deestroy/snn_parkour_fgpa/experiments/figures/fig_crossover_heatmap.png

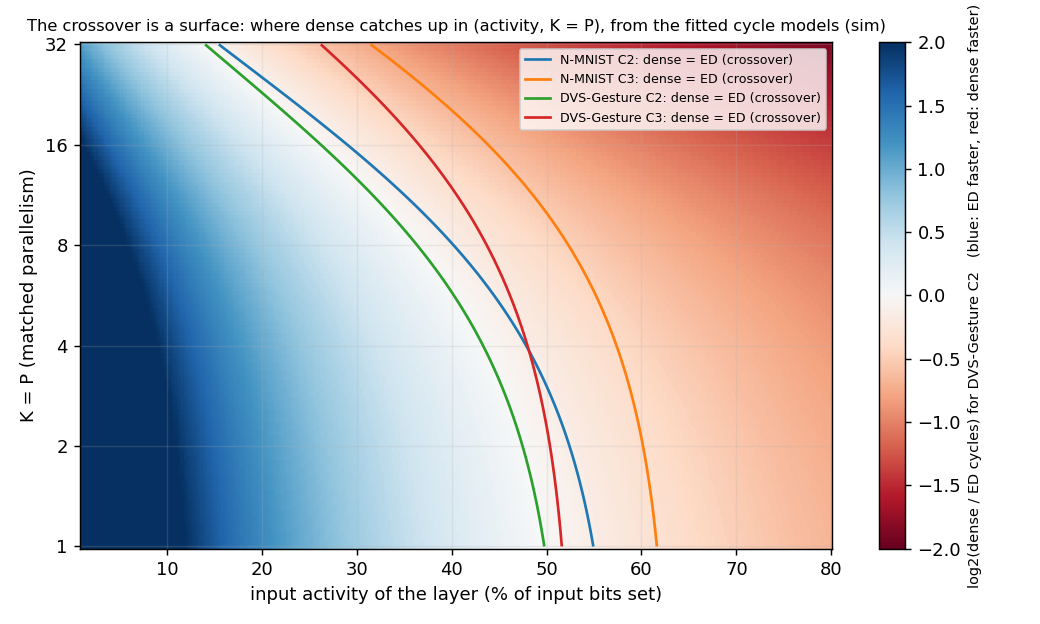
experiments/figures/fig_crossover_heatmap.png
