deestroy/snn_parkour_fgpa/docs/thesis_tables/deadline.md

# Deadline reading: per-sample latency distributions against perception periods

Generated by make_tables.py from the per-sample cycle/board files. 'Max sustainable rate' is the perception rate at which the WORST sample still meets its period (1 / worst latency). The board rows are what host/board/conv_server.c calls engine-only ticks: the ARM global timer bracketing one_pass, i.e. cache flush, both DMA transfers, the busy-poll and the cache invalidate. It excludes UART framing and CRC only, NOT the DMA -- see the +8.3 / +10.9 / +20.0 / +29.4 us decomposition in docs/decisions.md; miss rate at a given rate is the fraction of samples whose latency exceeds that period. The robot's control period is 100 ms (10 Hz), so the budget fraction column is worst latency / 100 ms. Both engines meet every period up to 200 Hz on every set; the difference between them appears only above that, and in the spread.

| sample set | engine | mean (us) | worst (us) | spread max/min | worst as % of 100 ms budget | max sustainable rate | miss rate % at 10 / 20 / 50 / 100 / 200 Hz |
|---|---|---|---|---|---|---|---|
| robot event frames (64, sim) | ED | 1725 | 2748 | 2.01x | 2.7 % | 364 Hz | 0 / 0 / 0 / 0 / 0 |
| robot event frames (64, sim) | dense | 3604 | 3604 | 1.00x | 3.6 % | 277 Hz | 0 / 0 / 0 / 0 / 0 |
| N-MNIST C1 (16 samples, board, K = P = 4) | ED | 688 | 816 | 1.47x | 0.8 % | 1226 Hz | 0 / 0 / 0 / 0 / 0 |
| N-MNIST C1 (16 samples, board, K = P = 4) | dense | 1049 | 1049 | 1.00x | 1.0 % | 953 Hz | 0 / 0 / 0 / 0 / 0 |
| N-MNIST C1 (16 samples, board, K = P = 8) | ED | 576 | 653 | 1.32x | 0.7 % | 1531 Hz | 0 / 0 / 0 / 0 / 0 |
| N-MNIST C1 (16 samples, board, K = P = 8) | dense | 540 | 540 | 1.00x | 0.5 % | 1851 Hz | 0 / 0 / 0 / 0 / 0 |
| DVS-Gesture C1 (8 clips, board, K = P = 4) | ED | 2971 | 4664 | 2.24x | 4.7 % | 214 Hz | 0 / 0 / 0 / 0 / 0 |
| DVS-Gesture C1 (8 clips, board, K = P = 4) | dense | 3706 | 3706 | 1.00x | 3.7 % | 270 Hz | 0 / 0 / 0 / 0 / 0 |
