deestroy/snn_parkour_fgpa/docs/thesis_tables/crossover.md

# Crossover table: every axis, layer and dataset

Generated by make_tables.py (the parallelism rows are recomputed from the cycle files at every run -- C0049: the N-MNIST value was quoted as ~6.6 from an arithmetic slip until 2026-09-20) from experiments/latency_sim, experiments/dvsgesture/latency_sim and the rate-sweep bench files. 'Basis' says whether the number is a simulation fit or a silicon observation; the silicon column states what the board showed at the bracketing points. The operating point is the unregularised (baseline) network's input activity on the check set.

| axis | layer | dataset | at | crossover | basis | operating point / silicon | fit |
|---|---|---|---|---|---|---|---|
| parallelism (K = P) | C1 | N-MNIST | -- | K = P = 7.4 | sim (cycle-model fits: ED over K = 1..16, dense over the P points in the files) | silicon: ED wins at 4, dense at 8 (N-MNIST) | ED = 45172 + 90347/K; dense = 406912/P + 2331 |
| parallelism (K = P) | C1 | DVS-Gesture | -- | K = P = 5.8 | sim (cycle-model fits: ED over K = 1..16, dense over the P points in the files) | silicon: ED wins 6/8 clips at K = P = 4 | ED = 165259 + 490120/K; dense = 1441792/P + -4 |
| activity (per sample) | C1 | DVS-Gesture | K = P = 4 | < ~10,000 input spikes per inference (~30.5 % density) | sim, pre-registered | silicon: ED wins 6/8 clips, loses clips 1 and 5 (36 %, 44 %) | clip densities 9-44 % |
| activity (trained) | C2 | N-MNIST | K = P = 4 | 48 % input activity | sim (6 networks, 16 samples each, fit ED = a + b s) | baseline network at 6.9 %: ED wins | a = 20803, b = 41.0 cycles/spike |
| activity (trained) | C2 | N-MNIST | K = P = 8 | 40 % input activity | sim (6 networks, 16 samples each, fit ED = a + b s) | baseline network at 6.9 %: ED wins | a = 20778, b = 23.0 cycles/spike |
| activity (trained) | C2 | N-MNIST | K = P = 16 | 29 % input activity | sim (6 networks, 16 samples each, fit ED = a + b s) | baseline network at 6.9 %: ED wins | a = 20765, b = 14.0 cycles/spike |
| activity (trained) | C3 | N-MNIST | K = P = 4 | 57 % input activity | sim (6 networks, 16 samples each, fit ED = a + b s) | baseline network at 8.2 %: ED wins | a = 13105, b = 76.4 cycles/spike |
| activity (trained) | C3 | N-MNIST | K = P = 8 | 52 % input activity | sim (6 networks, 16 samples each, fit ED = a + b s) | baseline network at 8.2 %: ED wins | a = 12960, b = 40.7 cycles/spike |
| activity (trained) | C3 | N-MNIST | K = P = 16 | 44 % input activity | sim (6 networks, 16 samples each, fit ED = a + b s) | baseline network at 8.2 %: ED wins | a = 12888, b = 22.8 cycles/spike |
| activity (trained) | C2 | DVS-Gesture | K = P = 4 | 43 % input activity | sim (6 networks, 16 samples each, fit ED = a + b s) | baseline network at 6.8 %: ED wins | a = 64464, b = 40.4 cycles/spike |
| activity (trained) | C2 | DVS-Gesture | K = P = 8 | 36 % input activity | sim (6 networks, 16 samples each, fit ED = a + b s) | baseline network at 6.8 %: ED wins | a = 65008, b = 22.7 cycles/spike |
| activity (trained) | C2 | DVS-Gesture | K = P = 16 | 26 % input activity | sim (6 networks, 16 samples each, fit ED = a + b s) | baseline network at 6.8 %: ED wins | a = 65280, b = 13.9 cycles/spike |
| activity (trained) | C3 | DVS-Gesture | K = P = 4 | 48 % input activity | sim (6 networks, 16 samples each, fit ED = a + b s) | baseline network at 13.4 %: ED wins | a = 32222, b = 74.0 cycles/spike |
| activity (trained) | C3 | DVS-Gesture | K = P = 8 | 44 % input activity | sim (6 networks, 16 samples each, fit ED = a + b s) | baseline network at 13.4 %: ED wins | a = 32503, b = 39.5 cycles/spike |
| activity (trained) | C3 | DVS-Gesture | K = P = 16 | 37 % input activity | sim (6 networks, 16 samples each, fit ED = a + b s) | baseline network at 13.4 %: ED wins | a = 32643, b = 22.2 cycles/spike |
