deestroy/snn_parkour_fgpa/docs/thesis_tables/passes.md

# Silicon passes 3-14 with pre-registration outcome

Generated by make_tables.py from experiments/silicon_ledger.md (which is maintained by the board session). Passes 1-2 (2026-08) were the loopback and first functional engine, superseded. Predicted latencies and their errors per sample are in each record file's own table (board vs sim columns); the 'prereg' column is the pre-registration verdict.

| pass | date (2026) | build | engine | dataset | N_ENGINES | WNS (ns) | bit-identical | engine latency | prereg | record |
|---|---|---|---|---|---|---|---|---|---|---|
| 3 | 09-05 | (GUI, m4_conv) | ED K=4 | N-MNIST | 1 | +0.508 | 16/16 | 688.5 us mean, 554.8-815.8 (1.47x) | none | board_ed_k4_20260905.md |
| 4 | 09-06 | (GUI, m4_conv) | dense P=4 | N-MNIST | 1 | +0.299 | 16/16 | 1,048.9 us flat | held 5/5 | board_dense_p4_20260906.md |
| 5 | 09-17 | ed_k8_20260917_2106 | ED K=8 | N-MNIST | 1 | +0.332 | 16/16 | 575.5 us mean, 494.1-653.1 (1.32x) | held, BRAM pred. failed | board_ed_k8_20260917.md |
| 6 | 09-17 | dense_p8_20260917_2221 | dense P=8 | N-MNIST | 1 | +0.101 | 16/16 | 540.3 us flat | held 6/6 | board_dense_p8_20260917.md |
| 7 | 09-17 | ed_k4_x8_20260917_2251 | ED K=4 | N-MNIST | 8 | +0.430 | 16/16 | = pass 3 to 0.1 us | held | board_ed_k4_x8_20260917.md |
| 8 | 09-17 | dense_p4_x8_20260917_2312 | dense P=4 | N-MNIST | 8 | +0.041 | 16/16 | 1,048.9 us flat | held (resources off) | board_dense_p4_x8_20260917.md |
| 9 | 09-18 | ed_k4_20260918_1300 | ED K=4 (C0044) | N-MNIST | 1 | +0.475 | 16/16 | = pass 3 to 0.1 us | held | board_ed_k4_c0044_20260918.md |
| 10 | 09-19 | ed_k4_dvsg_20260919_1324 | ED K=4 | DVS-Gesture | 1 | +0.190 | 8/8 | 2,970.8 us mean, 2,084.6-4,663.9 (2.24x) | held; offset basis corrected | dvsgesture/board_ed_k4_20260919.md |
| 11 | 09-19 | dense_p4_dvsg_20260919_1447 | dense P=4 (rev 3) | DVS-Gesture | 1 | +1.091 | 8/8 | 3,706.5 us flat | held 5/5 | dvsgesture/board_dense_p4_20260919.md |
| 12 | 09-19 | dense_p4_20260919_2323 | dense P=4 (rev 3) | N-MNIST | 1 | +0.768 | 16/16 | 1,048.9 us flat | (validation) | board_dense_p4_rev3_20260919.md |
| 13 | 09-20 | ed_k4_dvsg_x4_20260920_0010 | ED K=4 | DVS-Gesture | 4 | +0.119 | 8/8 | = pass 10 to 0.1 us | (replication) | dvsgesture/board_ed_k4_x4_20260920.md |
| 14 | 09-20 | dense_p4_dvsg_x2_20260920_1127 | dense P=4 (rev 3) | DVS-Gesture | 2 | +0.842 | 8/8 | 3,706.5 us flat (= pass 11) | (replication; N=4 does not place) | dvsgesture/board_dense_p4_x2_20260920.md |
