deestroy/snn_parkour_fgpa/docs/thesis_tables/utilisation.md

# Utilisation, timing and Vivado power estimate per silicon build

Generated by make_tables.py from experiments/power_estimates/*_power.rpt (post-route, whole design incl. wrapper and DMA; LUTs = logic + LUTRAM + SRL), *_summary.txt (WNS/WHS, parameters) and the README's estimate columns; pass numbers from experiments/silicon_ledger.md. Builds without a pass number were synthesised for the meter (C0019 strategy variants) but not run on the board.

| pass | build tag | configuration | N_ENGINES | WNS (ns) | WHS (ns) | LUTs (of 53,200) | FFs (of 106,400) | BRAM tiles (of 140) | DSP | Vivado est. total (W) | est. fabric (mW) |
|---|---|---|---|---|---|---|---|---|---|---|---|
| 5 | ed_k8_20260917_2106 | ED K=8 N-MNIST (pass 5) | 1 | 0.332 | 0.0249 | 3963 (7.4 %) | 4100 (3.9 %) | 13.5 (9.6 %) | 0 | 1.731 | 54 |
| 6 | dense_p8_20260917_2221 | dense P=8 N-MNIST (pass 6) | 1 | 0.101 | 0.0197 | 5362 (10.1 %) | 8809 (8.3 %) | 8.5 (6.1 %) | 0 | 1.761 | 83 |
| 7 | ed_k4_x8_20260917_2251 | ED K=4 x8 N-MNIST (pass 7) | 8 | 0.430 | 0.0342 | 11733 (22.1 %) | 7539 (7.1 %) | 86.0 (61.4 %) | 0 | 1.933 | 241 |
| 8 | dense_p4_x8_20260917_2312 | dense P=4 x8 N-MNIST (pass 8) | 8 | 0.041 | 0.0335 | 27829 (52.3 %) | 45023 (42.3 %) | 46.0 (32.9 %) | 0 | 2.196 | 501 |
| 9 | ed_k4_20260918_1300 | ED K=4 N-MNIST, C0044, m4_conv2 (pass 9) | 1 | 0.475 | 0.0323 | 3687 (6.9 %) | 3974 (3.7 %) | 12.5 (8.9 %) | 0 | 1.724 | 48 |
| 10 | ed_k4_dvsg_20260919_1324 | ED K=4 DVS-Gesture (pass 10) | 1 | 0.190 | 0.0203 | 4417 (8.3 %) | 3997 (3.8 %) | 23.0 (16.4 %) | 0 | 1.750 | 72 |
| 11 | dense_p4_dvsg_20260919_1447 | dense P=4 DVS-Gesture, rev 3 (pass 11) | 1 | 1.091 | 0.0450 | 9785 (18.4 %) | 20552 (19.3 %) | 11.5 (8.2 %) | 0 | 1.814 | 135 |
| 12 | dense_p4_20260919_2323 | dense P=4 N-MNIST, rev 3, m4_conv2 (pass 12) | 1 | 0.768 | 0.0147 | 5684 (10.7 %) | 8676 (8.2 %) | 7.5 (5.4 %) | 0 | 1.750 | 73 |
| 13 | ed_k4_dvsg_x4_20260920_0010 | ED K=4 DVS-Gesture x4 (pass 13) | 4 | 0.119 | 0.0202 | 10115 (19.0 %) | 5587 (5.3 %) | 86.0 (61.4 %) | 0 | 1.926 | 236 |
| 14 | dense_p4_dvsg_x2_20260920_1127 | dense P=4 DVS-Gesture x2 (pass 14) | 2 | 0.842 | 0.0281 | 17066 (32.1 %) | 37633 (35.4 %) | 21.0 (15.0 %) | 0 | 1.956 | 270 |
| -- | dense_p4_congestion_spreadlogic_high_20260920_0026 | dense P=4 N-MNIST, strategy Congestion_SpreadLogic_high (C0019, not on board) | 1 | 0.354 | 0.0249 | 5686 (10.7 %) | 8676 (8.2 %) | 7.5 (5.4 %) | 0 | 1.753 | 76 |
| -- | dense_p4_performance_explore_20260920_0023 | dense P=4 N-MNIST, strategy Performance_Explore (C0019, not on board) | 1 | 0.388 | 0.0218 | 5684 (10.7 %) | 8676 (8.2 %) | 7.5 (5.4 %) | 0 | 1.750 | 73 |
| -- | ed_k4_congestion_spreadlogic_high_20260920_0021 | ED K=4 N-MNIST, strategy Congestion_SpreadLogic_high (C0019, not on board) | 1 | 0.499 | 0.0108 | 3695 (6.9 %) | 3970 (3.7 %) | 12.5 (8.9 %) | 0 | 1.727 | 50 |
| -- | ed_k4_performance_explore_20260920_0018 | ED K=4 N-MNIST, strategy Performance_Explore (C0019, not on board) | 1 | 0.346 | 0.0222 | 3682 (6.9 %) | 3970 (3.7 %) | 12.5 (8.9 %) | 0 | 1.733 | 57 |
