deestroy/snn_parkour_fgpa/docs/thesis_tables/vector_sets.md

# Test-vector sets and their corner exposure

Generated by make_tables.py from sim/run_ed_tb.sh (geometry, sample counts), sim/vectors/*_thresh.txt and *_exposure.txt (as last exported; the ladder regenerates them). Corner exposure = frames with at least one input spike in the receptive field of each corner output neuron (sim/corner_exposure.py, C0044): a set that is BLIND at a corner cannot catch a neuron-0-class bug there.

| set | layer | geometry (C x H x W in -> out) | samples | weights | inputs | threshold 2^k | corner exposure | coverage |
|---|---|---|---|---|---|---|---|---|
| c1 | N-MNIST C1 | 2x34x34 -> 16x17x17 | 16 | golden/m1_weights_int8.npz | check set, seeded (C0039) | 64 | TL 0 / TR 0 / BL 0 / BR 0 of 64 frames | BLIND at TL,TR,BL,BR |
| c2 | N-MNIST C2 | 16x17x17 -> 32x9x9 | 16 | golden/m1_weights_int8.npz | golden traces of C1 output | 64 | TL 0 / TR 0 / BL 0 / BR 1 of 64 frames | BLIND at TL,TR,BL |
| c3 | N-MNIST C3 | 32x9x9 -> 64x5x5 | 16 | golden/m1_weights_int8.npz | golden traces of C2 output | 64 | TL 0 / TR 10 / BL 6 / BR 1 of 64 frames | BLIND at TL |
| g1 | DVS-Gesture C1 | 2x64x64 -> 16x32x32 | 8 | golden/dvsgesture_weights_int8.npz | 8 test clips | 128 | TL 3 / TR 0 / BL 1 / BR 0 of 32 frames | BLIND at TR,BR |
| g2 | DVS-Gesture C2 | 16x32x32 -> 32x16x16 | 16 | golden/dvsgesture_weights_int8.npz | golden traces of C1 output | 256 | TL 8 / TR 1 / BL 25 / BR 13 of 64 frames | all four corners exercised |
| g3 | DVS-Gesture C3 | 32x16x16 -> 64x8x8 | 16 | golden/dvsgesture_weights_int8.npz | golden traces of C2 output | 256 | TL 22 / TR 3 / BL 57 / BR 57 of 64 frames | all four corners exercised |
| r1 | robot C1 (recreation student) | 2x64x64 -> 16x32x32 | 8 | golden/r1_student_weights_int8.npz | synthetic corner-activity frames (C0044 guard) or real frames with R1_REAL=1 | 16 | TL 13 / TR 13 / BL 22 / BR 25 of 32 frames | all four corners exercised |
| i1 | robot C1 (IsaacGym frames) | 2x64x64 -> 16x32x32 | 8 | robot/artifacts/fpga_student.pt | 64 teacher-driven event frames, repeated over T (direct coding) | 16 | TL 0 / TR 0 / BL 180 / BR 200 of 256 frames | BLIND at TL,TR |
