deestroy/snn_parkour_fgpa/docs/literature_review.md

# Literature review

One row per paper in `~/OneDrive - Carleton University/Research Papers/Similar Papers/`.
Every row was produced by reading the paper, not the abstract. Numbers are the
paper's own; where a paper does not state something the cell says so rather than
estimating. "Future Works" is taken from the paper's own future-work or
conclusion section, and reads NOT STATED when the paper offers none.

**Tags.** `robot`, `snn`, `fpga`, applied only where they genuinely fit. Papers
fitting none carry `other` with a short reason; forcing a tag would make the
column useless. Loihi is neuromorphic silicon, not reconfigurable logic, so
Loihi papers take `snn` and not `fpga`.

Assembled 2026-09-20. See the notes below the table for duplicates, scope
flags, and the energy-provenance summary that matters most to this thesis.

| Paper | Tag | Summary | Key Findings | Future Works | Date of Publish |
|---|---|---|---|---|---|
| M. I. Al Hafiz, N. Ravichandran, A. Lansner, P. Herman, et al., "Embedded FPGA Acceleration of Brain-Like Neural Networks: Online Learning to Scalable Inference," arXiv:2506.18530 (preprint). (`2506.18530v1.pdf`) | snn, fpga | Addresses the lack of edge-deployable BCPNN accelerators, which previously ran only on GPUs or datacentre FPGAs. Builds HLS-synthesised online-learning and inference-only kernels on a Zynq UltraScale+ ZCU104 with variable and mixed precision, evaluated on MNIST, Pneumonia and Breast Cancer against an ARM A53 on the same SoC. | • Inference-only speed-up over ARM A53 rises with model size: 11.12x (MNIST), 16.45x (Pneumonia), 17.56x (Breast); the full online-learning kernel only 2.06-2.63x.<br>• Energy saving up to 94.1 % board / 87.8 % execution; full kernel up to 60.9 %.<br>• **Power MEASURED** with the board's onboard INA226 at 10 ms intervals, >1000 samples each for idle and active, board and execution power reported separately (10.803 W / 0.564 W).<br>• Accuracy preserved vs ARM: 94.6 % MNIST, 86.2 % Pneumonia, 84.0 % Breast.<br>• Full kernel is BRAM-bound at 76.28 % BRAM, 31.37 % DSP. | • Broader application exploration for the FP16 inference-only kernel (stated only in general terms). | June 2025 (arXiv v1, 23 Jun 2025; preprint) |
| I. Chun, S. Lee, M. S. Albergo, S. Xie, et al., "DASIP: Dynamic Test-Time Compute Scaling for Robot Control with Stochastic Interpolant Policies," arXiv:2511.20906 (NeurIPS 2025 camera-ready footer). (`2511.20906v2.pdf`) | robot | Diffusion and flow robot policies spend a fixed inference budget every control step regardless of subtask difficulty. DASIP adds a difficulty classifier choosing solver, step count and ODE/SDE mode per control cycle. Evaluated in simulation on six manipulation tasks. | • 2.6-4.4x reduction in total computation time versus a fixed maximum-compute baseline; up to 4.43x on Transport.<br>• Average success-rate difference from maximum compute only 1.3 % (CNN classifier).<br>• Lightweight CNN classifier accuracy 81.3-94.6 %; best few-shot vision-language model only 45.3 %.<br>• Step budgets by difficulty: 1 step at trajectory ends, 5 near, 10 grasping, 50 with SDE, 100 with Heun for continuous pushing.<br>• Worst regression: the few-shot model loses 18 % success on Transport. | • Apply the adaptive-inference framework to larger robotics foundation models.<br>• Couple it with safety monitors for contact-rich tasks.<br>• Extend from simulation to physical robot deployment. | arXiv v2 June 2026 (first submission Nov 2025) |
| D. Hoeller, N. Rudin, D. Sako, M. Hutter, "ANYmal Parkour: Learning Agile Navigation for Quadrupedal Robots," arXiv:2306.14874 (under review at the time of this copy). (`ANYmal_Parkour.pdf`) | robot | Agile quadruped navigation over parkour obstacles is hard because of dynamic contacts, state-estimation drift and limited field of view. Proposes a three-module learned pipeline: neural terrain reconstruction, five RL locomotion skills, and a high-level navigation policy selecting among them. Trained in simulation, deployed on a real ANYmal D. | • Real-world traversal up to 2 m/s; walking handles 40 degree slopes and 0.25 m steps.<br>• Skill limits: jumps gaps to 1 m, climbs boxes to 1 m, crouches under 0.4 m; all skills succeed up to 90 % of trained difficulty.<br>• Navigation policy beats a hand-coded expert: 98.2 vs 95.3 %, 96.3 vs 60.9 %, 97.6 vs 75.3 % over 1000 roll-outs per terrain.<br>• Navigation at 5 Hz, locomotion at 50 Hz, perception asynchronous on a Jetson Orin.<br>• Eight neural networks in total; **no energy or power figure anywhere**. | • Scale to unstructured scenarios such as collapsed buildings and real parkour courses.<br>• Train the interdependent modules simultaneously rather than separately.<br>• Pre-train navigation from expert demonstrations instead of a hand-built curriculum. | June 2023 (arXiv v1, 26 Jun 2023) |
| E. I. Guerra-Hernandez, A. Espinal, P. Batres-Mendoza, C. H. Garcia-Capulin, et al., "A FPGA-Based Neuromorphic Locomotion System for Multi-Legged Robots," IEEE Access, vol. 5, pp. 8301-8312. DOI 10.1109/ACCESS.2017.2696985. (`A_FPGA-Based_Neuromorphic_Locomotion_System_for_Multi-Legged_Robots.pdf`) | robot, snn, fpga | Builds a reconfigurable FPGA architecture for a spiking central pattern generator producing gaits for legged robots, with parameters found offline by grammatical evolution. Implemented on a Spartan-6 XC6SLX45 and validated on real biped, quadruped and hexapod robots, one neuron per servo. | • Whole system uses about 3 % of the device: 626-988 LUTs of 27,288, 383-496 FFs, and 0 of 58 DSP slices across seven gaits.<br>• Tool-reported power is 1 mW dynamic plus 38 mW quiescent per gait.<br>• **Measured current draw** gives the FPGA 115 mA / 828 mW, the servo controller 180 mW, and the servos 7,200-21,600 mW: actuators dominate by roughly 26x.<br>• Six neurons for the hexapod CPG, one per degree of freedom; three topologies demonstrate reconfigurability.<br>• Grammatical evolution yields CPGs with fewer connections than prior results for the same robots. | • Implement smooth gait transitions rather than resetting the network.<br>• Add cameras and infrared so external stimuli modulate the CPG.<br>• Test the system on platforms other than FPGAs.<br>• Scale to more biologically plausible models using the spare 97 % of the device. | April 2017 |
| S. Li, Z. Zhang, R. Mao, J. Xiao, et al., "A Fast and Energy-Efficient SNN Processor With Adaptive Clock/Event-Driven Computation Scheme and Online Learning," IEEE TCAS-I, vol. 68, no. 4, pp. 1543-1552. DOI 10.1109/TCSI.2021.3052885. (`A_Fast_and_Energy-Efficient_SNN_Processor...pdf`) | snn, fpga | Proposes four techniques for SNN processors: an adaptive clock/event-driven computing scheme, neighbouring processing-element borrowing, compressed spike routing, and a PE reconfigurable between inference and STDP learning. Implemented on a Virtex-7 VC707 at 100 MHz, evaluated on MNIST with a four-layer fully connected network. | • Inference 3.15 ms/image, 5.04 mJ/image, 92.93 % accuracy; the quoted 0.028 uJ/synapse divides by STATIC synapses, not operations.<br>• Online learning 16.30 ms/image, 26.32 mJ/image, 85.28 %.<br>• The adaptive scheme plus PE borrowing cut inference time 40.53 % and energy 39.42 %.<br>• Online learning recovers 63.69 % to 82.52 % in one epoch after noise injection.<br>• **Energy is a Vivado estimate** from post-layout SAIF switching activity, not instrumented. | NOT STATED | April 2021 |
| M. Karamimanesh, E. Abiri, M. Shahsavari, K. Hassanli, et al., "Spiking neural networks on FPGA: A survey of methodologies and recent advancements," Neural Networks, vol. 186, art. 107256. DOI 10.1016/j.neunet.2025.107256. (`A_survey_of_methodologies_and_recent_advancements.pdf`) | snn, fpga | A review of why FPGAs suit SNN acceleration and what the field has built: neuron models, learning rules, encoding, implementation methods and applications, plus a meta-review of ten prior surveys. | • Application split of reviewed FPGA SNN work: robotics 27.3 %, other 27.2 %, healthcare 18.3 %, space 18.1 %, auditory 9.1 %.<br>• Identifies on-chip memory as the primary bottleneck: BRAM limits network scale while off-chip DDR costs power and bandwidth.<br>• Reports application results such as 99.46 % structural-damage classification and 98.22 % on MIT-BIH ECG.<br>• Notes SNN hardware is not fault-immune and that triple-modular redundancy and ECC are generally ineffective for these accelerators.<br>• Flags the tooling gap: mainstream frameworks do not target FPGAs and HLS lacks HDL-level control. | • Brain-inspired multilayer supervised rules with spatial locality for on-chip training.<br>• Better hardware availability and reconfigurable access.<br>• Solve the memory bottleneck through simplification and better off-chip buffering.<br>• Address side-channel security and error tolerance.<br>• Build FPGA compiler frameworks so non-hardware engineers can deploy SNNs.<br>• Exploit adaptive compute acceleration platforms and high-bandwidth memory. | February 2025 |
| A. Lele, Y. Fang, J. Ting, A. Raychowdhury, "An End-to-End Spiking Neural Network Platform for Edge Robotics: From Event-Cameras to Central Pattern Generation," IEEE TCDS, vol. 14, no. 3, pp. 1092-1103. DOI 10.1109/TCDS.2021.3097675. (`An_End-to-End_Spiking_Neural_Network_Platform...pdf`) | robot, snn | Proposes a stochastic supervised weight-update rule programming multiple gaits onto a single six-neuron spiking CPG, coupled to an event-camera SNN vision pipeline for a hexapod prey-tracking task. | • The CPG has six fully connected neurons; programming n gaits requires tuning 15 + 6n weights.<br>• Convergence exceeds 80 % for up to two gaits but falls to about 20 % when three are programmed together.<br>• **Energy is estimated, not measured**, by assuming a Loihi implementation at 1.7 nJ/spike: filtering costs about 2.55 mJ per forward step, gait generation only 11.9 nJ.<br>• Vision processing dominates energy by roughly five orders of magnitude over gait generation.<br>• No FPGA implementation and no measured power at all. | • Extend beyond cuboidal prey to cluttered scenes.<br>• Adopt richer training methods for advanced image processing.<br>• Build the actual low-power hardware, exploiting asynchronous processing and crossbar memory.<br>• Extend to odometry and SLAM. | September 2022 |
| X. Cheng, S. Cao, S. Wang, M. Wang, et al., "An FPGA-Based Event-Driven SNN Accelerator for DVS Applications With Structured Sparsity and Early-Stop," IEEE TCAS-I, vol. 72, no. 7, pp. 3298-3310. DOI 10.1109/TCSI.2025.3560666. (`An_FPGA-Based_Event-Driven_SNN_Accelerator...pdf`) | snn, fpga | An algorithm-hardware co-design classifying event-camera streams directly without frame accumulation, with configurable structured sparsity to balance processing-element workload, event-driven LIF updates, and early-stop inference. Three-layer fully connected network on a ZCU104 at 250 MHz, tested on N-MNIST and DVS128-Gesture. | • 96.0 % on N-MNIST and 79.2 % on DVS128-Gesture at 50 % sparsity with 8-bit weights.<br>• 3.22 GSOP/s measured and 3.99 GSOP/W at 50 % sparsity; throughput 6.59 Meps.<br>• Event-driven multiplication cuts operations 98.8 % on N-MNIST and 91.7 % on DVS128-Gesture versus frame-based.<br>• Early-stop speeds inference 3.87x and cuts operations 60 % for 0.8 % accuracy.<br>• 81,299 LUT, 47,768 FF, 258.5 BRAM; **power 0.808 W from Vivado SAIF estimation**, not measured. No per-inference latency is stated anywhere. | • Design an event-driven convolutional SNN accelerator to escape the fan-in-proportional weight-storage limit.<br>• Solve event-driven dataflow scheduling and feature-map storage for that design.<br>• Add on-chip incremental and transfer learning. | July 2025 |
| M. Horowitz, "1.1 Computing's energy problem (and what we can do about it)," IEEE ISSCC Digest of Technical Papers, pp. 10-14. DOI 10.1109/ISSCC.2014.6757323. (`1.1_Computings_energy_problem...pdf`) | other (general computing energy) | Plenary keynote arguing that power, not transistor count, now limits computing, since supply-voltage scaling stopped and parallelism gives diminishing returns. Quantifies where energy goes in a 45 nm processor and argues that specialisation plus extreme data locality is the only large remaining lever. | • Gate speed improved about 100x since the mid-1980s while uniprocessor performance rose over 3000x, so the gains did not come from technology.<br>• Programmability overhead is about 70 pJ per instruction against a few pJ for the arithmetic itself.<br>• A 45 nm cache fetch costs about 20 pJ; a DRAM access 1-2 nJ, two orders of magnitude above an on-chip operation.<br>• Over 50 % of the die energy of a 40 nm 8-core CPU goes to caches and register files.<br>• Specialised hardware is two to three orders more efficient than a processor. **This is the source of the per-operation pJ constants that several SNN papers use to ESTIMATE energy instead of measuring it.** | • Build specialised compute engines rather than relying on scaling or parallelism.<br>• Create tools so application experts can design their own accelerators.<br>• Revisit cache design to minimise average memory access energy. | February 2014 |
| A. Parashar, M. Rhu, A. Mukkara, A. Puglielli, et al., "SCNN: An Accelerator for Compressed-sparse Convolutional Neural Networks," ISCA-44. arXiv:1708.04485. (`1708.04485v1.pdf`) | other (ASIC dataflow) | Addresses wasted work in dense CNN accelerators where pruned zero weights and ReLU-zeroed activations still consume cycles. Builds a 64-PE ASIC keeping weights and activations compressed, evaluated by cycle-level simulation plus 16 nm synthesis on AlexNet, GoogLeNet and VGGNet. | • 2.7x average speedup and 2.3x energy reduction over an equally provisioned dense accelerator.<br>• **Crossover points, which are the direct analogue of this thesis's question:** beats dense on performance below 85 % weight/activation density, on energy below about 83 %, and below 60 % against a zero-gated dense variant. At 100 % density it reaches only 79 % of dense performance.<br>• At 10 % density the speedup reaches 24x.<br>• Area 7.9 mm2 against 5.9 for the dense design at equal multiplier count; memories are 57 % of PE area, multipliers only 6 %.<br>• Assumes 20-80 % of weights prunable and 50-70 % of activations zeroed. | NOT STATED | June 2017 |
| P. Lopez-Osorio, A. Patino-Saucedo, J. P. Dominguez-Morales, H. Rostro-Gonzalez, et al., "Neuromorphic adaptive spiking CPG towards bio-inspired locomotion of legged robots," arXiv:2101.09709 (preprint). (`2101.09709v1.pdf`) | robot, snn | Closes a sensory feedback loop around a spiking central pattern generator so gait rhythm adapts to terrain, with oscillation frequency driven by the spike rate of a force sensor. Validated in the Brian 2 simulator then deployed on SpiNNaker; no physical robot. | • 40 neurons per population give rate standard deviation below 1.5 Hz; 100 per population is most stable.<br>• Brian 2 and SpiNNaker agree with a Pearson correlation of 0.905 across a 0-180 Hz input sweep.<br>• Operating frequency 9.5-14.9 Hz in simulation and 11.62-26.66 Hz on SpiNNaker for the same sweep.<br>• Under heavy input noise the oscillation saturates at 15 Hz, showing bounded robustness.<br>• Power improvement is claimed but **not stated numerically**. | • Embed the SpiNNaker system in real biped, quadruped and hexapod robots.<br>• Incorporate an event-based sensor so the generator processes spatiotemporal patterns directly. | January 2021 |
| J. Siekmann, K. Green, J. Warila, A. Fern, et al., "Blind Bipedal Stair Traversal via Sim-to-Real Reinforcement Learning," arXiv:2105.08328 (preprint). (`2105.08328v1.pdf`) | robot | Asks whether a human-scale biped can climb stairs on proprioception alone, avoiding fragile vision-based terrain estimation. Trains recurrent and feedforward policies in simulation with only stair-like terrain randomisation and no stair-specific rewards, then transfers to the Cassie robot. | • Outdoor staircase: 80 % success ascending and 100 % descending over ten trials each.<br>• Memory matters: feedforward policies never reach high success while the recurrent one does.<br>• Cost of transport at 1 m/s: 0.38 flat-ground policy against 0.46 stair policy, so robustness costs about 20 % efficiency.<br>• Policy runs at 40 Hz over a 2 kHz control loop; 300 M timesteps per policy.<br>• **Cost of transport is simulated motor energy only and explicitly excludes computation and electronics.** | • Investigate how vision can most effectively be added to an otherwise blind biped.<br>• Explore where the limits of blind locomotion lie. | May 2021 |
| A. D. Hines, M. Milford, T. Fischer, "A compact neuromorphic system for ultra-energy-efficient, on-device robot localization," Science Robotics, 18 June 2025. DOI 10.1126/scirobotics.ads3968. arXiv:2408.16754. (`2408.16754v2.pdf`) | robot, snn | Builds LENS, a fully neuromorphic visual place recognition stack combining a small spiking network, an event sensor and a neuromorphic processor on one SynSense Speck chip, deployed on a hexapod. Evaluated on-robot and on an 8 km event-camera driving dataset against a sum-of-absolute-differences baseline. | • Models under 180 KB with at most 44,000 parameters, about 2.6x smaller than the baseline's stored images.<br>• **Measured** 2.7 mW average, which is 8.8 % of a Jetson Nano and 0.5 % of a desktop CPU running the baseline.<br>• Total energy 327 mJ against 2,968 mJ (Jetson) and 61,427 mJ (CPU) for the same task.<br>• Recall@1 of 0.88 against the baseline's 0.81 on the driving dataset; indoors 0.64 against 0.36.<br>• Neurocore memory caps at 64 KB per core, limiting model size. | • Detect and handle turning motions, including dynamic sensor bias adjustment.<br>• Train directly on event streams rather than binned static representations, enabling online learning.<br>• Add convolutional layers and self-supervised learning.<br>• Integrate with path integration and neuromorphic SLAM. | June 2025 |
| D. Kang, W. Shin, C.-H. Hong, M. Koo, et al., "Real-Time Scheduling Framework for Multi-Object Detection via Spiking Neural Networks," arXiv:2501.18412 (preprint). (`2501.18412v1.pdf`) | snn, robot | Addresses the conflict between timing guarantees and accuracy when spiking object detection runs on energy-constrained mobile agents, since accuracy grows with timestep count and so does execution time. Proposes timestep-level and frame-level execution options with a confidence measure, offline schedulability analysis and a runtime scheduler. | • Confidence-guided scheduling beats fixed-minimum-timestep baselines on detection accuracy across all task sets, 38.4 % against 35.1 % at one deadline setting.<br>• At matched accuracy the baseline needs up to 1.32x the energy; at matched energy it loses large accuracy.<br>• Membrane reuse has an optimum: reusing more or less lowers accuracy.<br>• **Energy is computed analytically from Horowitz's per-operation constants, not measured.**<br>• Directly relevant to this thesis's deadline framing: it treats timestep count as a schedulable resource. | NOT STATED | January 2025 |
| A. Nagy, R. Szabo, L. Toka, "Analyzing Energy Consumption of Loihi 2 Neuromorphic Chip in a Self-driving Use-case," SpliTech 2025. DOI 10.23919/SpliTech65624.2025.11091800. (`Analyzing_Energy_Consumption_of_Loihi_2...pdf`) | snn | Compares a sigma-delta spiking steering-angle regressor on Intel Loihi 2 against three GPUs, on a 327,901-parameter network trained on NVIDIA's PilotNet dataset. Energy on Loihi comes from its own telemetry, GPU metrics from the vendor tool. | • Loihi 2 accuracy R2 0.8912 against the GPUs' 0.9401.<br>• Loihi 2 uses 277 mJ per inference at 3.51 W mean power.<br>• **Loihi is over an order of magnitude slower**: 710 s for 9,000 frames against 26.59 s on an RTX 4090 at batch 1.<br>• At batch 1 Loihi beats two of three GPUs on energy but loses to the RTX 4090.<br>• **Batching destroys the advantage entirely**: the 4090 at batch 32 needs 186 J against Loihi's 2,527 J. This is the paper the thesis cites for power-versus-energy confusion. | NOT STATED | 2025 |
| Q. Chen, C. Gao, Y. Fu, "Cerebron: A Reconfigurable Architecture for Spatiotemporal Sparse Spiking Neural Networks," IEEE TVLSI, vol. 30, no. 10, pp. 1425-1437. DOI 10.1109/TVLSI.2022.3196839. (`Cerebron_A_Reconfigurable_Architecture...pdf`) | snn, fpga | Addresses unpredictable, unbalanced workloads when hardware exploits spiking spatiotemporal sparsity, and the difficulty of mapping standard, depthwise and pointwise spiking convolutions onto one engine. Reconfigurable compute engine with two-step sparsity exploitation and channelwise scheduling, on a Zynq XC7Z100 at 200 MHz. | • At least 17.5x prediction-energy reduction and 20x speedup over prior FPGA SNN accelerators.<br>• Spiking ConvNet on MNIST: 0.026 ms/image, 0.04 mJ/image, 99.40 % accuracy.<br>• Effective throughput 40.1-45.0 GSOP/s against a 50 GOP/s theoretical peak, the **highest per-cycle throughput of any design in this review**.<br>• 85,926 LUT, 70,544 FF, 0 DSP, 283 BRAM; buffers are 43.1 % of on-chip power and static 10.2 %.<br>• **Timestep count is never stated**, which prevents any per-timestep normalisation; absolute watts not given either. | NOT STATED | October 2022 |
| Q. Zhang, J. Cao, J. Sun, Y. Shao, et al., "ES-Parkour: Advanced Robot Parkour with Bio-inspired Event Camera and Spiking Neural Network," IEEE ICME 2025. DOI 10.1109/ICME59968.2025.11209556. (`ES-Parkour...pdf`) | robot, snn | **The workload source for this thesis.** Replaces the depth camera and conventional network of a quadruped parkour policy with a simulated event camera and a spiking network, distilling a privileged teacher into a spiking student entirely in simulation. No physical robot. | • Success rates: hurdle 71 %, step 60 %, gap 45 %, parkour 29 %.<br>• Architecture: spiking ResNet-18 on simulated event frames, a GRU fusing proprioceptive and event latents, a three-layer spiking actor [512, 256, 128], IF neurons, T = 4, events at 10 Hz.<br>• Claims spiking energy is 11.7 % of the conventional network's, an 88.3 % saving on the encoder.<br>• **That energy is theoretical operation counts only**, multiplying operations by Horowitz's 45 nm constants. Nothing was measured and nothing was synthesised.<br>• Joint motor energy is essentially unchanged, so the saving is in compute alone, roughly 0.1 % of the robot's total. | • "Due to the difficulty in obtaining SNN chips, our work has not been tested on actual robots."<br>• Continue refining the system and advance integration of spiking chips with real robots. | 2025 |
| H. Gao, Y. Song, C. Wen, "Event-triggered adaptive neural network controller for uncertain nonlinear system," Information Sciences, vol. 506, pp. 148-160. DOI 10.1016/j.ins.2019.08.015. (`Event_triggered_NN_adaptive_control.pdf`) | other (control theory) | Pure control theory. Designs an event-triggered adaptive controller for uncertain nonlinear systems using a radial-basis network, removing the input-state-stability assumption most prior work requires. Verified only by numerical simulation of a rigid robot arm. | • Proposes static and dynamic event-triggered mechanisms without the usual stability assumption.<br>• Proves closed-loop stability and a positive lower bound on inter-event time, so no Zeno behaviour.<br>• Simulation over 3 s: 136 events (static) and 113 (dynamic) against 3000 for continuous transmission.<br>• **"Event-triggered" here means when to transmit a control signal over a network, not event-driven spiking hardware.** The only link to this thesis is the shared word.<br>• No energy, power, latency or hardware numbers; none are applicable. | NOT STATED | January 2020 |
| I. Aliyev, J. Lopez, T. Adegbija, "Exploring the Sparsity-Quantization Interplay on a Novel Hybrid SNN Event-Driven Architecture," DATE 2025. DOI 10.23919/DATE64628.2025.10992893; arXiv:2411.15409. (`Exploring_the_Sparsity-Quantization_Interplay...pdf`, `2411.15409v1.pdf`) | snn, fpga | **The closest architectural relative to this thesis.** Direct-coded spiking networks mix a dense input layer with sparse later layers, which neither purely event-driven nor systolic designs handle well. Proposes a hybrid: a dense core for the input layer plus event-driven sparse cores for the rest, on a Virtex UltraScale+ at 100 MHz. | • 4-bit quantisation raises spike sparsity by up to 15.2 % with minimal accuracy loss, giving 3.4x energy improvement and 4x latency reduction.<br>• Direct coding at 2 timesteps beats rate coding at 25: 87.01 % against 77.37 % accuracy and 26.4x less energy.<br>• 51x throughput and half the power of prior work on one dataset, at 218 FPS and 2.35 W.<br>• **It never compares the two cores on the same layer.** The dense/sparse assignment comes from a workload model whose goal is "to partition resources to minimize the execution latency difference between the most and least workload-intensive layers" - resource balancing, not a crossover.<br>• Power is a Vivado estimate. **So the field is already making this architectural choice with no measured threshold to justify it.** | • Extend to larger models and datasets exceeding on-chip memory.<br>• Study the impact of external memory access and optimise the memory hierarchy. | November 2024 preprint; DATE, 2025 |
| Y.-H. Chen, J. Emer, V. Sze, "Eyeriss: A Spatial Architecture for Energy-Efficient Dataflow for Convolutional Neural Networks," ISCA 2016, pp. 367-379. DOI 10.1109/ISCA.2016.40. (`Eyeriss_A_Spatial_Architecture...pdf`) | other (ASIC dataflow) | Non-spiking CNN ASIC work. Argues data movement rather than arithmetic dominates energy, and that published accelerators cannot be compared because they differ in technology and resources. Builds an analysis framework pricing data movement per storage level at fixed area, then proposes the row-stationary dataflow. Fabricated in 65 nm. | • Row-stationary is 1.4x to 2.5x more energy efficient than output-stationary, weight-stationary and no-local-reuse dataflows in convolutional layers.<br>• DRAM bandwidth alone does not predict energy efficiency.<br>• **Supplies the standard vocabulary for this thesis's two engines**: its output-stationary dataflow, keeping an output's accumulation stationary while operands stream, is exactly the dense engine here.<br>• Its taxonomy has no input-stationary category, the dual that describes the event-driven engine, because for dense networks that dataflow buys nothing.<br>• Fabricated chip: 168 PEs, 0.5 kB per PE, 108 kB global buffer, 200 MHz, 16-bit fixed point. | NOT STATED | June 2016 |
| T. Li, J. Li, G. Shen, D. Zhao, et al., "FireFly-S: Exploiting Dual-Side Sparsity for Spiking Neural Networks Acceleration With Reconfigurable Spatial Architecture," IEEE TCAS-I, vol. 72, no. 8, pp. 4007-4020. DOI 10.1109/TCSI.2024.3496554. (`FireFly-S...pdf`) | snn, fpga | Most spiking accelerators exploit only spike sparsity; this exploits weight sparsity too, via gradient-rewiring pruning plus quantisation on the software side and a bitmap dual-side sparsity detector on the hardware side. Spiking CNNs on MNIST, DVS-Gesture and CIFAR-10, deployed on a KV260, T = 4. | • 4-bit quantisation with 85-95 % weight sparsity at negligible accuracy cost; measured 93.82 %, 93.26 % and 86.12 % across the three networks.<br>• 10,047 / 3,683 / 2,327 frames per second on the three benchmarks. **Its abstract labels these FPS/W; dividing by its own reported power returns its efficiency column, so the abstract's unit label is wrong. Cite the table, not the abstract.**<br>• DVS-Gesture accuracy rises from 87.12 % to 92.05 % after quantisation and pruning.<br>• Zero DSP slices: inference runs on lookup tables alone.<br>• Compression fits a 9.5 Mb weight set into 53 % of a 5.1 Mb device, fully on-chip. Power is a Vivado estimate; **per-inference latency is never stated**. | • Push toward ultra-high compression rates and address efficiency decline at extreme sparsity in the bitmap representation. | August 2025 |
| T. Li, J. Li, G. Shen, D. Zhao, et al., "FireFly-P: FPGA-Accelerated Spiking Neural Network Plasticity for Robust Adaptive Control," arXiv:2601.21222 (preprint). (`Firefly-P...pdf` and `2601.21222v1.pdf`, byte-identical duplicates) | robot, snn, fpga | Targets robot controllers that cannot adapt after deployment. A four-term parametric plasticity rule tuned offline by an evolutionary strategy, then applied on-chip, with a dual-engine accelerator pipelining inference against weight updates on an Artix-7 at 200 MHz. Validated on simulated continuous-control tasks and MNIST. | • 8 us end-to-end latency covering inference and plasticity update - **this belongs to the 128-hidden-neuron control network, not the MNIST one.**<br>• The MNIST result is 32 frames per second including learning, on a 784-1024-10 network at 97.5 % accuracy.<br>• 0.713 W, 10.9k LUTs (52.8 %), 47 DSPs, all post-implementation Vivado estimates.<br>• Generalises to 72 unseen directions and velocities where directly weight-trained baselines converge to trivial behaviours.<br>• **Internal inconsistency:** the text says 32 FPS while its Table II lists 321 in the same row; the paper does not reconcile them. | NOT STATED | January 2026 |
| F. Paredes-Valles, J. J. Hagenaars, J. D. Dupeyroux, S. Stroobants, et al., "Fully neuromorphic vision and control for autonomous drone flight," Science Robotics; arXiv:2303.08778. (`Fully_neuromorphic_drone.pdf` and `fully_neuro_drone.pdf`, byte-identical duplicates) | robot, snn | An end-to-end event-camera-to-motor spiking pipeline for a freely flying drone: a five-layer, 28.8k-neuron vision network trained self-supervised on real event data, plus an evolved single-layer controller, running on Intel Loihi on board. | • **27 uJ per inference at 200 Hz, from a MEASURED idle-versus-running delta** - the same protocol as this thesis's metering, on neuromorphic silicon rather than an FPGA.<br>• Measured delta power is only 7-12 mW; an empty allocation draws 4 mW, so the baseline subtraction is essential.<br>• A Jetson Nano running the same network needs roughly 3,000x more energy per inference and is far slower.<br>• **Execution frequency rises as event sparsity rises**, 274 to 1637 inferences per second, the event-driven signature this thesis measures in cycles.<br>• 6-bit weight quantisation costs accuracy: the chosen network is 50 % worse on endpoint error than the best conventional one. | • Make the whole drone neuromorphic, from sensors to motors; such hardware does not yet exist.<br>• Improve processor input/output bandwidth and interfacing; spike limits forced a single linear control layer.<br>• Move from digital to analog neuromorphic hardware.<br>• Embed the pipeline on sub-30 g drones. | March 2023 |
| D. Neil, S.-C. Liu, "Minitaur, an Event-Driven FPGA-Based Spiking Network Accelerator," IEEE TVLSI, vol. 22, no. 12, pp. 2621-2628. DOI 10.1109/TVLSI.2013.2294916. (`Minitaur_an_Event-Driven...pdf`) | snn, fpga | The closest architectural relative to this thesis's event-driven engine. Implements a spiking deep belief network of LIF neurons on a Spartan-6 LX150, event-driven throughout, benchmarked on MNIST and a text dataset. | • 18.73 M postsynaptic currents per second at peak, but only **4.88 M sustained on MNIST - 26 % of peak**, because a fan-out of 32 cannot fill 32 cores.<br>• **That underutilisation is exactly this thesis's mechanism**: event-driven efficiency depends on the ratio of fan-out to parallel units.<br>• 1.5 W total, of which 400 mW is off-chip; on-chip is 73.8 % clock, IO and leakage. Method not stated.<br>• 92 % MNIST on a 784-500-500-10 network with 647k synapses at 1000 spikes per image.<br>• 22k logic slices (23 %) and 200 of 268 BRAMs; USB-to-USB latency 236 us. | • Better event-based training for spiking deep belief networks, the main limitation.<br>• Reduced-precision-aware training rather than truncating offline weights.<br>• Exploit progressive refinement and early abort in closed-loop robotics. | December 2014 |
| A. Carpegna, A. Savino, S. Di Carlo, "Spiker+: A Framework for the Generation of Efficient Spiking Neural Networks FPGA Accelerators for Inference at the Edge," IEEE TETC, vol. 13, no. 3, pp. 784-797. DOI 10.1109/TETC.2024.3511676. (`Spiker_A_Framework...pdf`) | snn, fpga | **Runs on the same XC7Z020 fabric at the same 100 MHz as this thesis**, so it is the one like-for-like row. A Python-configurable generator producing multi-layer spiking accelerators with six neuron variants. | • MNIST 784-128-10 over 100 timesteps: 93.85 % accuracy, 780 us per image, 180 mW, 7,612 logic cells (4.8 %) and 18 BRAMs.<br>• **Retires up to 130 synaptic accumulates per cycle against this thesis's 3.6**, because its 128 neurons fit in flip-flops and update together while inputs stream one per cycle.<br>• BRAM, not logic, caps network size: at most 1,220 neurons on this part.<br>• **Its survey finds the most power-efficient accelerators are clock-driven, not event-driven** - a direct challenge to the spiking premise, made on tool estimates.<br>• **Its own power RISES as activity falls**, toward 200 mW at near-zero activity against 180 mW at full activity.<br>• Abstract reports 97 / 75 / 95 % accuracy where the body reports 93.85 / 72.99 / 89.82; quote the body. | • Enlarge the library of neuron models, encoders and architectures.<br>• Accuracy improvements through better training and multi-objective optimisation of the encoding. | December 2024 (issue July-September 2025) |
| P. Harmeling, F. De Geeter, G. Drion, "Energy-efficient implementation of spiking recurrent cells on FPGA," Neuromorphic Computing and Engineering, vol. 6, no. 2, art. 024022. DOI 10.1088/2634-4386/ae759c. (`energy-efficient-implementation.pdf`) | snn, fpga | **The paper that names this thesis's question as open future work.** Argues LIF is too simple and conductance-based models too costly, and implements the intermediate spiking recurrent cell in VHDL on an Artix-7, with piecewise approximations removing transcendental functions and floating point. | • 96.31 % MNIST on FPGA, bit-matching its software reference - the same bit-identity discipline this thesis uses.<br>• 1.7424 ms per digit, 174,240 cycles at 100 MHz, 784 cycles per image per neuron.<br>• **Energy is a Vivado post-implementation estimate**: 1.13 W including an attached display, 0.492 mJ per digit.<br>• One threshold parameter cuts spiking activity about 3x at acceptable accuracy; below 4-bit weights accuracy degrades sharply.<br>• Concludes event-driven execution "could become advantageous when activity is sufficiently sparse" - **it states the crossover question and does not answer it**. | • **"Investigate adaptive event-driven scheduling, and a hybrid design switching between synchronous and event-driven execution based on observed spike density"** - this thesis's question, listed as future work in a 2026 paper.<br>• Complete the joint exploration of trace length and weight quantisation.<br>• Hardware-aware or on-chip training.<br>• Report energy per spike alongside energy per digit so designs of different size can be compared. | June 2026 |
| N. Russo, T. Madsen, K. Nikolic, "An Implementation of Communication, Computing and Control Tasks for Neuromorphic Robotics on Conventional Low-Power CPU Hardware," Electronics, vol. 13, no. 17, art. 3448. DOI 10.3390/electronics13173448. (`electronics-13-03448.pdf`) | robot, snn | Addresses the poor accessibility of neuromorphic hardware by emulating it on a conventional low-power CPU, running spiking models on a Raspberry Pi 5 driving a robotic goalkeeper with an event camera and servo. | • 84 % overall accuracy, against 75 % for the authors' earlier dedicated neuromorphic board.<br>• **Whole-system power about 20 W**, with the spiking model alone about 4.6 W - two orders above the dedicated neuromorphic parts in this review.<br>• Computation latency about 3 ms, but total delay 100-154 ms **dominated by 75 ms of servo positioning**.<br>• Small networks: 8 or 128 input neurons to 8 outputs.<br>• Useful as the counter-example: a CPU emulation is accessible but pays heavily in power. | • Test more complex models with additional layers and learning rules.<br>• A self-learning network using infrared feedback.<br>• Replace the servo, which is the latency bottleneck.<br>• Further reduce power and resource consumption. | August 2024 |
| X. Cheng, K. Shi, A. Agarwal, D. Pathak, "Extreme Parkour with Legged Robots," ICRA 2024; arXiv:2309.14341. (`parkour.pdf`) | robot | **The recipe this thesis's workload is rebuilt on.** Asks whether a low-cost quadruped with a single jittery depth camera can do precise parkour without mapping or planning. Trains one end-to-end policy in simulation with a unified reward, distils it with predicted yaw, deploys on a Unitree A1. | • 20-80 % higher real-world success than baselines on the hardest instance of each terrain.<br>• Jumps obstacles twice robot height and gaps twice robot length; steps to 0.50 m, hurdles to 0.40 m, gaps to 0.8 m, ramps to 37 degrees.<br>• Distillation with predicted yaw nearly matches the privileged oracle, while two ablations collapse - the teacher-student structure this thesis reuses.<br>• Learns handstand walking without exteroception.<br>• Removing the feet-clearance reward makes the robot step near edges to save energy, which destabilises it. | • Extend the approach to mobile manipulators so the robot can manipulate as well as move. | September 2023 preprint; ICRA 2024 |
| Z. Zhuang, Z. Fu, J. Wang, C. Atkeson, et al., "Robot Parkour Learning," CoRL 2023; arXiv:2309.05665. (`robot_parkour learning.pdf`) | robot | A concurrent and distinct work from Extreme Parkour. Proposes two-stage reinforcement learning with soft then hard dynamics constraints to learn climbing, leaping, crawling and squeezing without reference motions, then distils them into one vision-based policy on Unitree A1 and Go1. | • Climbs obstacles 1.53x robot height at 80 % success, leaps gaps 1.5x robot length at 80 %, crawls under barriers at 90 %.<br>• **The blind proprioception-only policy completes zero climbing, leaping or tilting trials**, which is the quantitative case for vision in this task.<br>• The two-stage constraint method reaches about 95 % in simulation where a curiosity baseline fails to learn.<br>• Beats both the stock and teleoperated model-predictive controllers across all skills.<br>• No energy, power or compute-cost figures. | • Build diverse simulation environments automatically from real-world data rather than by hand.<br>• Train agile locomotion directly from colour images, which carry semantic information, rather than depth. | September 2023 |
| L. Hu, D. Wang, G. Wang, J. Qiao, "Self-triggered neural tracking control for discrete-time nonlinear systems via adaptive critic learning," Neural Networks, vol. 186, art. 107280. DOI 10.1016/j.neunet.2025.107280. (`Self_triggered_NN_adaptive_control.pdf`) | other (control theory) | Control theory. Recasts tracking as regulation via an augmented plant, then designs a self-sampling function depending only on the sampled error to predict the next triggering instant, avoiding the continuous condition evaluation event-triggered schemes need. Simulation only. | • Control input updates only 39 times over 200 steps.<br>• Removes the need for continuous evaluation of a triggering condition.<br>• Proves convergence and uniform ultimate boundedness under the stated assumptions.<br>• **The neural networks are function approximators in an adaptive-critic loop, not spiking networks**, and no hardware is involved.<br>• Relevant only to the deadline and computation-budget framing. | NOT STATED | 2025 |
| S. van Leeuwen, I. Kolmanovsky, "Suboptimal Model Predictive Control with a Computation Governor," arXiv:2411.07919 (preprint). (`Suboptimal_MPC_with_computation_governor.pdf`) | other (control theory) | Control theory. Addresses model-predictive control when there is not enough time to solve the optimal control problem exactly, combining a computation governor that modifies the reference with constraint tightening, and proving feasibility and stability. Simulation only. | • Average solver iterations at termination 311 against 550 and 1380 for exact-solve baselines.<br>• Wall times 6.10 s against 7.64 and 19.14 s.<br>• Suboptimal solving costs little closed-loop performance.<br>• Strict guarantees require built-in conservatism.<br>• **Relevant to this thesis only as precedent for treating compute time as a first-class constrained resource**, which is the deadline argument. | • Develop less conservative versions, since strict guarantees currently require conservatism. | November 2024 preprint, v2 September 2025 |

---

## Notes on the corpus

**Duplicates (34 unique papers in 36 files).**
- `Firefly-P_FPGA-Accelerated_Spiking_Neural_Network.pdf` and `2601.21222v1.pdf` are byte-identical.
- `Fully_neuromorphic_drone.pdf` and `fully_neuro_drone.pdf` are byte-identical.
- `parkour.pdf` and `robot_parkour learning.pdf` are **different papers** despite similar names: Extreme Parkour (Cheng et al., ICRA 2024) and Robot Parkour Learning (Zhuang et al., CoRL 2023), concurrent works that cite each other.

**Filename traps.** `Spiker_A_Framework...pdf` is **Spiker+**, not the earlier Spiker paper; the filename drops the plus. `energy-efficient-implementation.pdf` gives no hint of its subject and is Harmeling et al. on spiking recurrent cells. `parkour.pdf` extracts as scrambled text because of a subset font and had to be read as rendered pages; its identifier is not printed in the file.

**How each paper obtains its energy number** - the distinction this thesis exists to make.

| provenance | papers |
|---|---|
| **Measured on real rails or a meter** | Lindqvist (board and fabric rails, 9-21 nJ per synaptic event), the neuromorphic drone (idle-versus-running delta on Loihi, 27 uJ per inference), LENS (2.7 mW with baseline subtracted), Al Hafiz (onboard current monitor, board and execution power separated), Guerra-Hernandez (bench current, 828 mW) |
| **Tool estimate** | Cerebron, Cheng 2025, FireFly-S, FireFly-P, the DATE hybrid, Spiker+, Harmeling, Li 2021, SCNN |
| **Theoretical operation counts** | **ES-Parkour**, RT-SNN, the end-to-end edge robotics platform - all multiplying operation counts by Horowitz's 45 nm constants |

**Three findings that bear directly on the thesis.**

1. **ES-Parkour's 88.3 % energy saving, the number motivating this whole project, was never measured or synthesised.** It comes from multiplying operation counts by published per-operation constants. The paper states it was never run on a robot or on neuromorphic hardware. That is precisely the claim this thesis tests.
2. **Harmeling et al. (2026) list this thesis's question as their future work**: "adaptive event-driven scheduling, and a hybrid design switching between synchronous and event-driven execution based on observed spike density". They also state that event-driven execution "could become advantageous when activity is sufficiently sparse" without determining where.
3. **Two papers argue against the event-driven premise on tool estimates.** Spiker+ finds the most power-efficient accelerators in its survey are clock-driven, and reports its own power *rising* as activity falls. The neuron-level comparative study (Marostica et al., outside this folder) finds the same and attributes it to control-circuit overhead. Both conclusions rest on Vivado, which is the strongest available argument for measuring.

**Scope.** Four papers carry `other`: two control-theory papers whose "event-triggered" and "self-triggered" refer to when to transmit a control signal rather than to spiking hardware, and two non-spiking accelerator papers (SCNN, Eyeriss) that nonetheless supply this thesis's crossover framing and its dataflow vocabulary respectively.

---

## Coverage against `readingList.bib`

The reading list holds 50 entries, 46 unique titles (Extreme Parkour appears
three times, and two other papers twice). **Seven already have a PDF and are
rows in the table above**; 39 do not. Almost all of the missing ones are
neuromorphic robotics, central-pattern-generator and survey papers, which
matter for Chapter 3 (related work on neuromorphic robots) but not for the
datapath comparison in Chapters 2 and 4.

**The nine worth obtaining first, because they touch the architecture
argument rather than the robotics framing:**

| # | paper | why it matters here | link |
|---|---|---|---|
| 1 | Characterization of a Spiking Convolutional Processor for FPGA (2026) | a spiking *convolutional* processor on FPGA, the same layer type as ours | https://doi.org/10.3390/S26061801 |
| 2 | Neuromorphic computing for robotic vision: algorithms to hardware advances (2025) | recent survey; check whether it names the dense-vs-event-driven question | https://doi.org/10.1038/S44172-025-00492-5 |
| 3 | Neuromorphic electronics for robotic perception, navigation and control: A survey (2023) | the other survey that would already cover our gap if anyone had | https://doi.org/10.1016/J.ENGAPPAI.2023.106838 |
| 4 | Advancements in Algorithms and Neuromorphic Hardware for Spiking Neural Networks (2022) | hardware-side survey, useful for the novelty check | https://doi.org/10.1162/NECO_A_01499 |
| 5 | Adaptive Robotic Arm Control with a Spiking Recurrent Neural Network on a Digital Accelerator (2024) | a spiking accelerator driving a real robot; check its power method | https://doi.org/10.1109/ICECS61496.2024.10849226 |
| 6 | Towards neuromorphic FPGA-based infrastructures for a robotic arm (2023) | FPGA spiking hardware in a closed robot loop, i.e. our deadline argument | https://doi.org/10.1007/S10514-023-10111-X |
| 7 | A Configurable CPG Controller using Connectome based SNN on FPGA for Robot Locomotion (2024) | FPGA spiking locomotion controller, closest to the workload | https://doi.org/10.1109/ICRC64395.2024.10937017 |
| 8 | Neuromorphic Robot Controller on FPGA for Supporting SNN-Based Smooth Trajectories (2026) | as above, and recent enough to have measured power | https://doi.org/10.1007/978-3-032-29365-7_21 |
| 9 | ED-Scorbot: A robotic test-bed framework for FPGA-based neuromorphic systems (2016) | an event-driven FPGA robot test-bed; check how it reports energy | https://doi.org/10.1109/BIOROB.2016.7523630 |

The remaining 30 are quadruped-learning papers (Neural Volumetric Memory,
OPT-Mimic, Safe RL for Legged Locomotion, Agile But Safe, the animal-imitation
line, LOVON), neuromorphic robotics platforms and central-pattern-generator
work, plus Attention Spiking Neural Networks. They belong in Chapter 3's
robotics and neuromorphic-robot sections. Full list with links is in the
session notes; ask and I will paste it.
