deestroy/snn_parkour_fgpa/docs/corrections.md

# Corrections and gaps — methodology review, 2026-08-20
Reviewed against `docs/decisions.md` (D0001–D0024) and the project brief.
Written to be worked through by Claude Code. Each item states the problem,
why it matters to the thesis, the action, and a done-when.
Numbering is `C00NN` so it does not collide with the `D00NN` decision log.
When an item is resolved, record it as a normal dated entry in
`docs/decisions.md` — this file is a worklist, not a second source of truth.
**Priority key.** P0 = do before the meter session, or the measurement is
not defensible. P1 = do before any M7 number is written up. P2 = do before
the thesis is written. P3 = housekeeping.
---
## C0001 — Measure absolute idle power per bitstream, not only the delta (P0)
**Problem.** The protocol in D0022 and `measure/dmm_protocol.md` is
"power while running minus power while idle." Static power — leakage and
the clock tree — is present in both states and therefore **cancels out of
the delta entirely.**
**Why it matters.** The thesis argument (project brief; Minitaur's 73.8 %
clocks/IO/leakage) is that static power is exactly what operation-counting
misses. The 22:56 resource table shows the event-driven build carrying
5.5 more BRAM tiles than dense — the address list and the I banks, i.e.
the event-driven machinery itself. That cost is paid on every clock cycle
whether or not a spike arrives, and the current protocol cannot see it.
Half the thesis argument is being subtracted away.
**Action.** Measure and report two quantities per bitstream:
1. `P_idle(design)` — PL configured and clocked, DMA idle, CPU in the
   conv_server receive loop, no BURST running. Define this state once in
   `measure/dmm_protocol.md` and use it identically for both engines.
2. `ΔP(design) = P_burst − P_idle` — dynamic power attributable to running.
Both go in the results table. If `P_idle(ED) > P_idle(dense)`, that is a
result the tool cannot predict and it belongs in the abstract.
**Done when:** `measure/dmm_protocol.md` defines the idle state precisely;
both engines have `P_idle` and `ΔP` recorded with the same instrument in
the same session; the results table has separate columns for each.
---
## C0002 — Establish the noise floor before any comparison (P0)
**Problem.** No repeatability figure exists. Without one, any reported
delta is unfalsifiable.
**Why it matters.** The quantity being measured is ~25 mW on a ~5 W board.
If the baseline drifts by more than that over a measurement window, the
comparison is noise. This must be known *before* the numbers are taken,
not argued about afterwards.
**Action.**
- Measure the same bitstream twice, cold, separated by a power cycle.
- Measure the same bitstream twice within one session, separated by 10 min.
- Record the spread. That spread is the noise floor and every reported
  delta must exceed it.
- If the floor exceeds the dense-vs-ED delta, C0003 is mandatory rather
  than optional.
**Done when:** a noise-floor figure with its method is recorded in
`docs/decisions.md`, and `measure/dmm_protocol.md` requires it to be
re-measured at the start of every metering session.
---
## C0003 — Replicate the engine N times to lift the signal above drift (P0 enabler)
**Problem.** The fabric is ~31 mW on a ~1.7 W chip estimate; the
idle→burst delta is ~2.7 mA at 12 V against a ~0.5 A board baseline. The
limiting factor is not meter resolution — a 4.5-digit DMM resolves that —
it is **baseline stability** over the measurement window.
**Why it matters.** This is the difference between needing an expensive
instrument and not. Utilisation is 3.4 k of 53,200 LUTs and 13 of 140
BRAM tiles, so there is room for roughly 8 copies of either engine.
**Action.**
- Add a `N_ENGINES` parameter to `axis_conv_top.v` wrapping the engine
  instantiation in a generate loop.
- Broadcast the same input stream to all instances. Compare only
  instance 0's output against golden; the others are representative load
  and must be fed real data, not zeros or a held constant.
- Report per-engine energy as `ΔP / N`, and state N with every number.
- Check BRAM before building: ED is 13 tiles per instance against 140
  available; dense is 7.5.
**Caveat to record:** replication changes routing and clock-tree loading,
so per-engine energy at N>1 is not identical to N=1. Measure at N=1 and
at N=8 for at least one design and report the ratio, so the scaling
assumption is evidence rather than assertion.
**Done when:** both engines build at N=1 and N=8 with WNS ≥ 0; the
N=1-vs-N=8 scaling ratio is measured and recorded; the pre-write check
in `docs/decisions.md` includes N_ENGINES in the `.hwh` grep.
---
## C0004 — State the measurement boundary with every number (P0, cheap)
**Problem.** The project brief requires it and it is not yet stated.
**Action.** One sentence in `measure/dmm_protocol.md`, repeated in every
results table caption: what is inside the measured boundary (with the
meter on the 12 V input: the whole board — FPGA, DDR3, PHYs, oscillators,
regulator losses) and what that means for comparability with published
figures, which are almost always die-only tool estimates.
**Worked example to cite, and a fair one.** Harmeling et al. (*Neuromorph.
Comput. Eng.* 6, 024022, 2026) report energy per digit for an Artix-7 SNN
accelerator, derived as follows: *"the energy per digit can be estimated
from Vivado power estimation (post-implementation)... The total reported
consumption is 1.13 W (including the HUB75 display)."* Every energy figure
in their Table 3 therefore has a 32x64 LED matrix inside the measurement
boundary. This is not sloppiness — it is what happens when the boundary is
not decomposed, which is the norm. Use it as the concrete illustration of
why the boundary sentence exists, without editorialising.
Also: check the ZedBoard Rev C.1 schematic for whether VCCINT (PL core,
1.0 V) and VCCPINT (PS core) are separate nets. If separate, a shunt on
VCCINT isolates the fabric and removes the ARM from the baseline entirely
— a far better measurement than the barrel jack. If tied, the 1.0 V rail
still excludes DDR3, PHY, USB, OLED, LEDs and regulator losses. Record
the finding either way; it is a methodology decision with evidence.
**Done when:** the boundary sentence exists and is cited by every table;
the VCCINT/VCCPINT question is answered from the schematic and recorded.
---
## C0005 — Add the duty-cycle model: energy per control period, not only per inference (P1)
**Problem.** BURST runs the engine at ~100 % duty. A deployed perception
loop does not.
**Why it matters.** At 10 Hz with 1.51 ms of work the ED engine is idle
98.5 % of the time, and
```
E_period = P_idle × T_period  +  ΔP × t_active
```
At a 100 ms period and ~1.5 ms of work the static term is roughly 60× the
dynamic one. A design that wins decisively on energy-per-inference at
100 % duty can still lose over a control period if its idle draw is
higher. **That is the Loihi 2 failure mode one level down, and it is
probably where the crossover actually lives.**
**Action.**
- Add `E_period` as a reported quantity, computed from the C0001
  measurements, swept over perception rate (10 / 25 / 50 / 100 Hz).
- Plot energy per control period against perception rate for both engines,
  alongside the existing energy-per-inference plot.
- State explicitly which figure of merit the robot claim rests on.
**Done when:** the analysis script emits both figures of merit; the
duty-cycle sweep is in `experiments/`; the thesis outline names
`E_period` as the robot-facing metric.
---
## C0006 — Decide the LIF sweep skip, and pre-empt the "is this really event-driven?" attack (P1)
**Problem.** The sweep visits every neuron every timestep, 4 cycles × N,
unconditionally. At K=4 on C1 that is 18.5 k of 27.1 k cycles — **68 % of
the engine's time is dense-style work inside the event-driven design.**
**Why it matters.** This is the sharpest technical criticism available
against the architecture and it will be the first question at the defence.
It is currently filed as a "post-M7 optimisation," which understates it.
**Action.** Choose one and record the reasoning:
- **(a) Implement the skip.** A neuron can be skipped when `I == 0` and
  `V` has already decayed to 0 (integer truncation reaches 0 in finite
  steps, so this is reachable). The D0016 address-list architecture makes
  the bookkeeping feasible. Measure what fraction of the sweep survives at
  trained rates.
- **(b) Argue the floor is inherent** and quantify it: state that this is
  event-driven *synaptic* processing with a dense *neuron* update, which
  is what most accelerators in this family do, and report how much of the
  advantage survives the floor.
Either is defensible. Silence is not.
**Done when:** a `D00NN` entry states the choice with numbers, and the
thesis methodology contains the sentence that pre-empts the question.
---
## C0007 — Estimate-vs-measured is three numbers, not two (P1)
**Problem.** The Vivado figures recorded so far are marked "confidence:
medium" — the vectorless estimator, with a default toggle-rate assumption.
Comparing a vectorless estimate against a measurement partly measures the
assumption rather than the tool.
**Why it matters.** This is contribution C1 of the thesis. Doing it
properly turns one weak comparison into two strong ones.
**Action.** Produce three numbers per design:
- **(a) vectorless default** — what the literature actually reports.
- **(b) SAIF-driven** — post-implementation simulation over a
  representative window (a few timesteps of a real sample), `read_saif`,
  `report_power`.
- **(c) measured** — from C0001.
Report all three. The gap (a)→(c) is *the field's practice being wrong*.
The gap (b)→(c) is *the tool's genuine accuracy when used carefully*.
These are different findings and both are worth having.
**Done when:** all three exist for both engines; the two gaps are named
and quantified separately in the results chapter.
---
## C0008 — Report accuracy at every point of the M7 sweep (P1)
**Problem.** M7 varies firing rate, which changes accuracy. An
energy-versus-activity curve without accuracy at each point is not
interpretable — energy can always be reduced by firing less and being
wrong.
**Why it matters.** D0005 already establishes that threshold and weight
scale are a single knob, so the sweep is a controlled scale parameter —
but the accuracy consequence must travel with it.
**Action.**
- Record full-split test accuracy at every sweep point (D0009: full split,
  never `--limit`).
- Where possible, add an iso-accuracy comparison: energy for each engine
  at matched accuracy, not merely at matched activity.
**Done when:** every row of the M7 results table carries an accuracy
column, and the plot annotates it.
---
## C0009 — Log die temperature during metering (P2)
**Problem.** Leakage is exponential in temperature and nothing records it.
**Action.** Read the XADC die-temperature sensor from `conv_server.c` and
include it in the BURST reply; log it at the start and end of every
metering window.
**Why it is worth the hour.** It demonstrates the window was thermally
stable (supporting C0002), and it gives a second lever for separating
static from dynamic power if the idle-vs-delta split needs corroboration.
**Done when:** temperature appears in the BURST reply and in every logged
measurement.
---
## C0010 — State the scope of the measured claim (P2)
**Problem.** Everything on silicon is C1. The per-layer simulation shows
dense/ED ratios differing sharply by layer (2.0× / 0.8× / 0.4× at K=1),
so a whole-network figure cannot be extrapolated from C1 silently.
**Action.** Either put C2/C3/FC on the board, or state plainly in the
methodology that the measurement is C1 and that the whole-network figure
is **modelled** from measured C1 plus simulated cycle counts, with the
model's assumptions listed.
The second is legitimate. Undeclared, it is not.
**Done when:** the scope sentence exists, or the additional layers are
measured.
---
## C0011 — Build the external baseline table (P2)
**Problem.** No comparison against published accelerators exists, so the
work cannot be placed in the literature.
**Action.** Build the table from published figures — no reproduction
needed. Columns the field expects: platform, network, benchmark,
accuracy, LUT / FF / BRAM / DSP, clock, latency, throughput (FPS and
GSOP/s), power and how it was obtained, energy per inference, GSOP/W.
Rows: Cheng et al. TCAS-I 2025, Cerebron TVLSI 2022, FireFly-S,
Spiker+, **Harmeling et al. NCE 2026**, and both of ours.
Note in every row **how the power figure was obtained** — that column is
the thesis's argument in visual form, and ours will be the only measured
entry.
**Harmeling et al. is the most directly comparable row and should be
prominent.** Same FPGA family (Artix-7 XC7A200T), same clock (100 MHz),
same benchmark (MNIST), hand-written VHDL chosen over HLS for the same
reason as D0011, 4-bit weights, 96.31 % accuracy, 1.7424 ms/digit,
1.972 mJ/digit. Note their scale for context: 93,347 logic cells and 341
BRAM for 784-100-10, because each layer is fully parallelised.
**Comparability trap.** Their energy is *per digit*, where one digit is a
220-image spike train. It is not comparable to a per-inference figure at
T = 4 without normalising. If both appear in one table, normalise
explicitly and say so in the caption, or the comparison is meaningless in
your favour — which is worse than meaningless against you.
**Done when:** the table exists in `docs/` with citations, and any
cross-normalisation is stated.
---
## C0012 — Add one benchmark harder than N-MNIST (P2)
**Problem.** N-MNIST alone is the weakest evidence in this field and
reviewers discount MNIST-class results almost automatically. DVS-Gesture
is deferred on disk grounds (D0024).
**Action.** Solve the disk constraint — streamed pipeline, external
storage, or a cleared quota — and train/quantise/verify DVS-Gesture
through the existing golden-model path. The engines are geometry-clean
(D0024 addendum), so the retarget cost is parameters and vectors only.
**Done when:** DVS-Gesture accuracy and firing rates are recorded and at
least one engine is verified against golden on it.
**Resolved 2026-09-17.** Trained on the NVIDIA box (63.26 % float,
65.15 % int8, 63.26 % golden integer — 0.00 pp drop; membranes fit
int16), and BOTH engines verified bit-identical on its C1 vectors
(dense P=4; event-driven K=1 and K=4). Doing so exposed C0044.
`experiments/dvsgesture/README.md`.
---
## C0013 — Statistical treatment of the energy measurements (P2)
**Problem.** Latency is deterministic and single runs are fine. Energy
will not be.
**Action.** Define, before measuring: repeats per condition, what is
randomised between them, and how confidence intervals are computed.
Report intervals, not single values. Cross-reference the C0002 noise
floor.
**Done when:** the protocol is written in `measure/dmm_protocol.md` and
every energy figure carries an interval.
---
## C0014 — Characterise or remove the wrapper asymmetry (P2)
**Problem.** The AXIS wrapper's bit-serial pack/unpack is ~11 % of dense
cycles and ~26 % of ED cycles. It is shared, so it is fair — but it is
*unequally weighted*, which compresses the engine-to-engine ratio.
**Action.** Either land the word-parallel pack/unpack before M7, or
measure the wrapper's contribution separately and report engine-only
figures alongside system figures. Removing it also increases the delta
C0003 is trying to lift.
**Done when:** the wrapper contribution is either eliminated or quantified
and reported separately.
---
## C0015 — Get the event-driven FC layer onto silicon (P2)
**Problem.** FC holds 81 % of the weights (D0004) and is dense-only on the
board. D0023 verified the ED variant in simulation at K = 2…16.
**Action.** Generate the baked-weight variant, wire the selection in
`axis_conv.v`, build, verify WNS ≥ 0 and BOARD PASS, and take BURST
latency plus C0001 power for it.
**Done when:** ED FC has a sign-off-clean board pass and its own row in
the results table.
---
## C0016 — Use an unbiased sample distribution for M7 (P2)
**Problem.** The per-timestep tables use the golden traces, which D0009
established are class-ordered and on the busy side of true mean activity.
**Action.** Draw M7's samples from a seeded random subset of the full
split, as D0009 already requires for reported numbers. State the sampling
method in the results chapter.
**Done when:** M7's inputs are drawn from the unbiased distribution and
the method is documented.
---
## C0017 — Housekeeping (P3)
- The index table in `docs/decisions.md` stops at D0020; the log runs to
  D0024. Bring it current and add C-item resolutions as they land.
- D0021 lists the constant `/` and `%` in `ed_scatter` as accepted; D0020
  rev 2 removed them. Mark the D0021 note as superseded so a reader does
  not act on a stale caveat.
- The 22:56 table has a footnote saying DSP = 1 for ED with
  `use_dsp="no"` expected to make it 0. Confirm on the next build and
  update, so the "DSP = 0 for both engines" property is stated as measured
  rather than expected.
---
---
# Design review — architecture and a numerical error
Added 2026-08-20. D0028 is a correction to a published finding in the log.
D0029 is the fairness issue most likely to be attacked at a defence.
Numbered `D00NN` in the C-series style but prefixed here as design items;
renumber into your own scheme as you prefer.
---
## C0028 — The dense cost model in the M6 K=4 table is wrong for C2 and C3; a headline finding does not survive it (P0)
**Problem.** The M6 K=4 entry states *"sweep = 4 cyc/neuron, dense = 21
cyc/neuron"* and applies 21 cycles/neuron to **all three layers**:
```
C1  4,624 neurons x 21 =  97,104   <- correct
C2  2,592 neurons x 21 =  54,432   <- wrong
C3  1,600 neurons x 21 =  33,600   <- wrong
```
21 cycles/neuron is a **C1-specific** figure. C1 has `C_IN x 3 x 3 = 2 x 9
= 18` taps per neuron, so 21 cycles is 18 taps plus ~3 of overhead — one
tap per cycle, consistent with a data-independent walk of the full kernel.
But C2 has `16 x 9 = 144` taps per neuron and C3 has `32 x 9 = 288`. At one
tap per cycle those are ~147 and ~291 cycles/neuron, not 21.
**Your own later simulation confirms this and contradicts the table.**
`experiments/latency_sim/layers.md` gives dense C1/C2/C3 = 3.90 / 15.26 /
18.63 ms per sample. At 100 MHz over 4 timesteps:
```
C2: 15.26 ms -> 381k cycles/timestep    vs 2,592 x 147 = 381k   MATCH
C3: 18.63 ms -> 466k cycles/timestep    vs 1,600 x 291 = 466k   MATCH
```
So the log holds two mutually inconsistent dense figures for C2 and C3, and
the incorrect one is attached to a highlighted result.
**What does not survive.** The finding *"at K=1 the event-driven engine
LOSES to dense on C2 and C3"* — described in the log as *"the crossover the
thesis is about, already visible in RTL cycle counts"* — is an artefact of
the wrong dense column. Corrected:
| per timestep | dense (corrected) | ED K=1 | ED K=4 | dense/K1 | dense/K4 |
|---|---|---|---|---|---|
| C1 | 97,104 | 48,276 | 27,116 | 2.0x | 3.6x |
| C2 | 381,000 | 70,532 | 26,628 | **5.4x** | **14.3x** |
| C3 | 466,000 | 83,993 | 26,584 | **5.5x** | **17.5x** |
Event-driven wins on every layer at every K. There is no cycle-level
crossover in the layer dimension.
**Action.**
- Verify the tap arithmetic independently (count taps in `conv_layer.v`'s
  inner loop for each geometry, or instrument the simulation per layer).
- Correct the M6 K=4 table and **retract the finding explicitly**, in the
  style of the DDR retractions — that discipline is the most credible thing
  in the log and this is exactly the case it exists for.
- Check whether any downstream reasoning depended on it, in particular the
  D0017 note's framing of what banking buys.
**Done when:** the table is corrected, the finding is retracted with the
arithmetic shown, and the layer-level and simulation figures agree.
---
## C0029 — The dense baseline has no parallelism knob; the comparison is unfair on the axis that matters most (P0)
**Problem.** The event-driven engine has `K`, giving it K-way RMW
throughput via channel-interleaved banks. **The dense engine has no
equivalent.** It processes one tap per cycle, single-issue, always.
So the headline comparison is a **4-wide event-driven engine against a
1-wide dense engine.** D0011 rightly insists on comparison hygiene for
authorship and toolchain; D0021 rightly insists on it for the wrapper.
Parallelism is the one axis where hygiene is missing, and it is the axis a
reviewer will find first.
**Why it matters, in numbers.** A P-wide dense engine — 4 output channels
in parallel, weights and membranes banked by `oc mod P`, i.e. structurally
the same trick `ed_scatter` already uses — would give:
```
              dense P=1    dense P=4    ED K=4
C1              97,104       24,276     27,116    <- dense P=4 WINS
C2             381,000       95,250     26,628    <- ED wins 3.6x
C3             466,000      116,500     26,584    <- ED wins 4.4x
```
On C1 a fairly-parallelised dense baseline is **faster** than ED K=4. The
2.9x board result rests partly on a baseline that was never given the same
knob.
**This is good news, not bad.** It does not weaken the thesis — it produces
the crossover the thesis was looking for, and locates it somewhere more
interesting than activity alone: **in the fan-out of the layer.** C1 has 18
taps per neuron and 64 targets per spike; C3 has 288 taps and 144 targets.
Event-driven wins where fan-in is large and dense must walk it all; dense
wins where fan-in is small enough that walking it is cheap. That is a
genuine architectural result with a mechanism behind it.
**Action.**
- Add a `P` parameter to `conv_layer.v` mirroring `ED_K`: bank weights and
  membranes by `oc mod P`, issue P taps per cycle. The infrastructure is
  the same partition `ed_scatter` already implements.
- Verify bit-identical against golden at P ∈ {1, 2, 4} (the existing
  harness should catch any error).
- Report the comparison at **matched parallelism** (P = K) as the primary
  result, with P=1 retained as the naive baseline.
- Consider also reporting **matched area** — dense at whatever P consumes
  the same LUT+BRAM as ED at K — which is arguably the fairest framing of
  all for an energy thesis.
**Done when:** a P-wide dense engine exists and is verified; the primary
comparison is at matched parallelism; the P=1 figures are relabelled as the
naive baseline rather than the baseline.
---
## C0030 — Pipeline the sweep: it is not an optimisation, it is what makes the architecture worth having (P1)
**Problem.** The sweep is 4 cycles/neuron. At K=4 on C1 that is 18.5k of
27.1k cycles — and it is a **floor**: the ED engine cannot go below it at
any activity level.
Against a fairly-parallelised dense baseline (C0029), C1 dense P=4 is 24.3k
cycles. So ED K=4's absolute best case, at zero activity, is 18.5k — only
1.3x better than a dense engine that does not care about activity at all.
**That margin is too thin to build an energy argument on.**
The log already identifies the fix — read n+1 while updating n, taking the
sweep to ~2 cycles/neuron — but files it as a timing patch and then as a
"later" item. At 2 cycles/neuron the ED floor becomes 9.25k, i.e. 2.6x
better than dense P=4, which is a margin worth measuring.
**Action.** Implement the pipelined sweep in `ed_conv_layer.v` and
re-verify against the full harness. Then re-run the cycle model and the
crossover prediction.
**Done when:** the sweep is ~2 cycles/neuron, bit-identical, and the
crossover prediction is updated.
---
## C0031 — Measure the touched-neuron fraction before deciding the sweep skip (P1, cheap — do before C0006)
**Problem.** C0006 asks whether to implement a sweep skip (skip neurons
with `I == 0` and `V` decayed to 0). Whether that pays depends entirely on
what fraction of neurons receive *any* input in a timestep, and that number
is not measured anywhere.
**Why it is not obvious.** One C1 input spike touches up to `2 x 2 x C_OUT
= 64` of 4,624 neurons — 1.4%. At ~392 input spikes per timestep, if
targets were disjoint, coverage would be total several times over. But
N-MNIST digits are **spatially clustered**, so the touched set is clustered
too and much of the frame may never be touched. Coverage could be anywhere
from ~20% to ~100%, and the skip is worth building only at the low end.
**Action.** Add ~10 lines to `golden/eventdriven.py` to record, per layer
per timestep, the fraction of neurons with `I != 0` and the fraction with
`V != 0` after the sweep. Run over the full split (D0009 — not `--limit`).
That measurement settles C0006 with data instead of judgement, costs an
hour, and the answer is a thesis result either way: *"at realistic
convolutional fan-out, N% of neurons receive input each timestep, so
event-driven neuron updates save little"* is exactly the kind of
quantified, mechanism-level finding the field lacks.
**Done when:** touched-fraction figures exist per layer at trained rates,
and C0006's decision cites them.
---
## C0032 — State the worst-case address-list sizing as a deliberate trade (P2)
**Problem.** D0016 sizes the address list for every neuron firing —
4096 x 13 bits for C1, roughly 1.5 BRAM tiles — for a case that never
occurs. At trained 6.8% firing, ~315 entries are used.
**Why it should be said out loud.** That is **area bought with determinism**,
and area costs static power, which is the thesis's own argument. The choice
is right — a data-dependent overflow policy would break bit-exactness or
make timing data-dependent, which D0016 correctly rejected — but the cost
should be quantified rather than left implicit, because it is part of why
the ED design carries 5.5 extra BRAM tiles.
**Action.** Quantify the address list's share of the ED area premium and
state the trade explicitly in the methodology.
---
## C0033 — Ask whether the two-word neuron state is structural or an ordering artefact (P2)
**Problem.** D0019's `V` plus `I` doubles neuron state and is the dominant
part of the ED area premium. The reasoning given is that leak and pending
reset need `V[n-1]`, which scatter would destroy.
**Worth one page of analysis.** Is that inherent, or an artefact of doing
scatter-then-sweep? An alternative ordering — apply leak and reset at the
*start* of the timestep, then scatter directly into `V`, with firing
evaluated at the next timestep's leading edge — might need only one word.
The delayed-reset semantics (D0002) already push the reset decision a
timestep late, which is suggestive.
I am not asserting this works; the bit-exactness risk is real and the
current design is verified. But since neuron state is the headline area
difference and area is the thesis's static-power argument, **the question
deserves an explicit answer even if the answer is "necessary, because X."**
Also check, separately and safely: `|I|` and `|V|` ranges are known per
layer from M1 (11/12/13/13 bits). Narrowing the memories only saves BRAM if
it crosses a Xilinx width boundary (36/18/9/4/2/1), so for C1 at 11 bits
there is probably no saving — but confirm per layer rather than assuming
16 bits everywhere.
---
## C0034 — Inter-layer chaining is designed but never exercised (P2)
**Problem.** D0016's double-buffered address lists exist so one layer's
sweep output feeds the next layer's scatter. On silicon only C1 has ever
run. The hand-off is designed, argued and unexercised.
**Action.** Chain at least C1 → C2 in simulation through the real address
lists (not the testbench's direct push) before any whole-network claim, and
on hardware before any whole-network measurement (see C0010, C0015).
---
# Second pass — measurement accuracy and missing experiments
Added 2026-08-20 after a closer read. C0018 and C0022 are more serious than
anything in the first list.
---
## C0018 — BURST replays one sample, so the energy figure is that sample's, not the design's (P0)
**Problem.** D0022 replays *the last-loaded sample* N times. Switching
activity is data-dependent, so the measured power is the power of sample 0
repeated 12,000 times — not the power of the design over its input
distribution. The ED engine's own latency already varies 1.49–1.56 ms
across samples (±2 %); energy will vary at least as much and probably more.
There is a second, subtler effect: replaying identical data means the DMA
and input buffer see the *same* words every iteration, so their switching
activity is unrepresentatively low and correlated. Real inference streams
present different data each frame.
**Also check:** whether BURST clears membrane and accumulator state between
iterations. If it does not, iteration k starts from iteration k−1's state,
which is neither the golden semantics nor a realistic stream. If it does,
that clear is itself work being measured. Either is fine — it must be
documented and identical for both engines.
**Action.**
- Extend BURST to cycle through the loaded sample set (16 samples already
  live in memory) rather than repeating one, or add a `--burst-sweep` mode
  that runs N/16 iterations of each and reports the mean and spread.
- Report energy per inference as mean ± spread across samples, not a single
  number from one sample.
- Document the state-reset behaviour between iterations in
  `host/protocol.md` and confirm it is identical for both engines.
**Done when:** the reported energy figure is a distribution over samples;
inter-sample spread is quoted; reset behaviour is documented.
---
## C0019 — Implementation-seed variance is an uncontrolled confound (P0)
**Problem.** Dense and ED are separate builds. They differ in the engine —
but they also differ in placement, routing, clock-tree loading and net
capacitance, all of which affect power independently of the design.
**Some fraction of any measured dense-vs-ED delta is build variance, not
architecture.**
**Why it matters.** This is the synthesis-side analogue of C0002's noise
floor, and almost nobody in the FPGA power literature controls for it —
which makes controlling for it a methodological contribution in its own
right.
**Action.**
- Build each design 3–5 times with different implementation seeds
  (`-directive` variants or an explicit placer seed), all WNS ≥ 0.
- Measure `P_idle` and `ΔP` for each build.
- Report the build-to-build spread alongside the design delta.
- **If build variance is comparable to the dense-vs-ED delta, the
  comparison cannot attribute and must be reported as such.**
**Done when:** seed spread is measured for both designs and quoted next to
every design-level delta.
---
## C0020 — Idle and burst readings are taken at different die temperatures (P1)
**Problem.** Leakage is exponential in temperature. The idle reading is
taken on a cooler die than the burst reading, so `ΔP = P_burst − P_idle`
contains a thermal leakage term that is not switching power. An 18-second
burst is also almost certainly *not* long enough to reach thermal steady
state — so the measurement is taken on a rising temperature ramp.
**Action.**
- Add a warm-up: run BURST continuously for several minutes until the XADC
  die temperature (C0009) is stable to within a stated tolerance, and only
  then start the measurement window.
- Record die temperature at both the idle and burst readings.
- Either correct for the leakage difference, or state it explicitly as a
  bound on the delta's accuracy.
**Done when:** the protocol has a defined warm-up and stability criterion;
temperatures at both readings are logged with every measurement.
---
## C0021 — Compare at iso-latency, not only at iso-frequency (P1)
**Problem.** Both engines run at 100 MHz, so ED finishes 2.9× sooner. But
the thesis's figure of merit is *energy at a fixed deadline*, and a design
that finishes early has bought nothing it needed.
**Why this is the sharper experiment.** Dynamic power scales roughly with
frequency. If ED were clocked down to whatever frequency just meets the
same deadline dense meets at 100 MHz — around 35 MHz — its dynamic power
would drop accordingly while its static power would not. That is the
correct comparison for a deadline-driven system, and it puts static power
front and centre, which is exactly the thesis's argument.
**Action.**
- Build ED at the lowest frequency that still meets the target deadline
  (and dense at 100 MHz, its minimum for the same deadline).
- Measure energy per inference for both at iso-latency.
- Report both framings: iso-frequency (which is what the accelerator
  literature reports) and iso-latency (which is what a control loop cares
  about). The difference between them is worth a paragraph.
**Done when:** an iso-latency energy comparison exists alongside the
iso-frequency one.
---
## C0022 — There is no ANN baseline, so the ES-Parkour claim cannot actually be audited (P1)
**Problem.** The thesis motivation is that ES-Parkour reports 11.7 % of ANN
energy (88.3 % saving) computed analytically, and that nobody has measured
it. But every measurement planned here is **spiking-dense versus
spiking-event-driven.** Without an ANN reference, the headline audit cannot
be performed.
**Action — two options, and the cheap one is arguably better.**
**(a) Cheap, and directly on point.** Compute the analytical energy for
*your own network*, using ES-Parkour's own method — operation counts times
45 nm per-operation constants (MAC 4.6 pJ, AC 0.9 pJ) — and compare it
against your measured figure. You already have exact operation counts from
the golden model and the cycle model. This audits the *published
methodology* on a network where you also have ground truth, which is
precisely the thesis's claim, without building anything new.
**(b) Expensive, and stronger.** Build an INT8 ANN conv engine for the same
C1 geometry on the same fabric, verified against a golden model the same
way, and measure it. This gives a real measured SNN-versus-ANN number on
identical silicon — the thing nobody has.
Do (a) regardless; it is a day's work and it is the sentence the abstract
wants. Do (b) if time allows, and note that it needs DSPs, which changes
the "DSP = 0" property (C0017) and needs its own timing closure.
**Done when:** the analytical-versus-measured comparison exists for this
network with both numbers and the ratio; a decision on (b) is recorded.
### C0022 addendum — a 2026 paper states this thesis's question as an open one
Harmeling et al. (NCE 6, 024022, June 2026) treat the dense-versus-event
tradeoff as established folklore, choose synchronous processing on that
basis **without measuring it**, and then close by suggesting the question is
open:
> *"The event-driven approach proposed by Roy et al is highly efficient when
> spikes are sparse, but becomes less effective under dense or bursty
> activity. In such cases, synchronous layer-by-layer processing is commonly
> adopted. Here, we employ a synchronous per-layer processing scheme."*
> *"...higher values (e.g. 980) significantly reduce spiking activity (by
> approximately a factor of ~3)... This suggests that an event-based
> implementation could become advantageous when activity is sufficiently
> sparse."*
**Use this in the introduction and in related work.** It is a peer-reviewed,
open-access, three-month-old statement that (i) the tradeoff is assumed
rather than measured, and (ii) whether event-driven wins at low activity is
a suggestion awaiting evidence. That is a stronger framing of the gap than
anything you can assert on your own authority, and it dates the gap to
after the literature review rather than before it.
---
## C0023 — Two planned sweep axes are missing entirely: T and weight bit-width (P1)
**Problem.** The project brief names both timestep count and quantisation
bit-width as experiment axes. Neither appears anywhere in the log.
**Why they matter.** T multiplies both latency and energy directly and is
the SNN-specific knob no ANN has — a T sweep is one of the few results
that is *about spiking* rather than about dataflow. Bit-width trades weight
BRAM (and therefore static power) against accuracy, which is the other half
of the area-versus-activity argument.
**Action.**
- Confirm T is parameterised end-to-end (RTL, wrapper, protocol, host) and
  sweep T ∈ {1, 2, 4, 8}: accuracy, latency, energy for both engines.
- Sweep weight width ∈ {4, 8} at minimum: accuracy, BRAM, `P_idle`, energy.
  4-bit halves weight storage, which should move `P_idle` measurably — a
  direct test of the static-power argument.
**Both sweeps have a direct published comparison point.** Harmeling et al.
(NCE 2026) sweep weight bit-width from 9 down to 2 bits with accuracy at
every point (their table 5), and sweep spike-train length — the analogue of
your T — with accuracy, latency and energy per point (their table 3). Their
finding that 4 bits is a practical floor for MNIST but not for
Fashion-MNIST is worth testing against your own network, and their tables
give your sweeps somewhere to land rather than standing alone.
**Done when:** both sweeps have results tables with accuracy reported at
every point (C0008), and are positioned against Harmeling's equivalents.
---
## C0043 — Justify the LIF choice with a citation rather than an assertion (P3)
Harmeling et al.'s table 4 gives per-neuron FPGA cost by neuron model on an
Artix-7 (after Koravuna et al.): LIF 13 LUT / 17 FF / 0 DSP; SRC 75 / 21 /
0; QIF 82 / 21 / 0; Izhikevich 42 / 25 / 1; Hodgkin-Huxley 73 / 25 / 3.
Background chapter currently justifies LIF on general "hardware cost"
grounds. This table makes the argument quantitative in one line, and it
also gives you a place to acknowledge what LIF gives up — the same paper
argues SRC preserves dynamics LIF discards, which is a fair limitation to
name rather than to omit.
---
## C0024 — Report ΔP against activity, not only endpoint energy (P1)
**Problem.** The M7 plan produces energy per inference at each activity
level. That is an endpoint number. It does not demonstrate the
*mechanism*.
**Why it matters.** If ΔP is linear in spike count for ED and flat for
dense, that is direct evidence the event-driven datapath behaves as
designed — and it turns the crossover from a measured coincidence into a
model with a fitted slope and intercept. You already have exactly this
structure in cycles (`ED K=4 = 121.8k + 21.9/spike`). Doing it in power
lets you state the energy model in the same form.
**Action.** For each engine, plot measured ΔP against measured spike count
across the activity sweep; fit and report slope (energy per synaptic
event) and intercept (fixed per-timestep cost). Compare the fitted
intercept against the sweep-floor cost predicted from cycles.
**Done when:** the fitted energy model exists for both engines, with its
coefficients compared against the cycle-level prediction.
---
## C0025 — Measure energy against K on the board (P2)
**Problem.** The K axis is filled in simulation for latency
(K = 1…16). D0017's note correctly says energy per K is the meter's
question — but it is not yet in any plan as a deliverable.
**Why it matters.** K is the knob that flips the C2/C3 cycle-level
crossover, and each doubling of K doubles the accumulator bank BRAMs.
Latency improves with diminishing returns while static cost grows
linearly, so there should be an energy-optimal K that is **not** the
latency-optimal K. That is a clean, quotable design result.
**Action.** Build and meter at least K ∈ {1, 4, 16}: `P_idle`, ΔP, energy
per inference, BRAM. Identify the energy-optimal K and state whether it
differs from the latency-optimal one.
**Pre-registered 2026-09-20:** `measure/k_energy_prereg_2026-09-20.md` fixes
the build list (K in {1, 2, 4, 8, 16}, R=1 plus replicated pairs at each end),
inherits the instrument and statistics from the M5 pre-registration, and
records seven falsifiable predictions before any build exists. The headline
one, K3, says the fabric-energy optimum is K = 8 while the latency optimum is
K = 16; K4 says the board-level optimum is K = 16 regardless, so the answer
depends on which of C0038's three quantities is asked for. K3 is flagged as
genuinely at risk: the predicted 4-to-8 gap is 6 %, comparable to the
measurement spread, so "flat, optimum unresolved" is a likely third outcome
and will be reported as such.
**Done when:** an energy-versus-K table exists with the optimum identified.
---
## C0026 — The 12 V measurement point sits behind non-linear regulators (P2)
**Problem.** Measuring at the barrel jack means measuring through the
board's switching regulators, whose efficiency varies with load. A 2.7 mA
delta at the input does not correspond linearly to the load-side delta,
and the transfer function is not known.
**Action.** Either move to a load-side rail (C0004's VCCINT question), or
characterise the input-to-load relationship by applying a known variable
load and measuring both sides. If neither is practical, state the
non-linearity as a limitation with an estimated bound.
**Done when:** the measurement point is either load-side, characterised,
or its non-linearity is bounded and declared.
---
## C0027 — State the tool-ranking result formally (P2)
**Problem.** The 23:00 entry observes that Vivado's estimates for the two
designs differ by ~25 mW on ~30 mW of fabric power, and concludes the tool
"genuinely cannot rank the two designs." That is a strong, quotable claim
currently living in a log entry.
**Action.** Turn it into a stated result: does the tool's *ordering* of the
two designs match the meter's ordering, and by how much does the magnitude
differ? With C0019's seed spread, you can also say whether the tool's delta
is even larger than its own build-to-build variance.
"The synthesis tool cannot rank two architectures whose measured energies
differ by X%" is a headline sentence if the measurement supports it — and a
useful negative result if it turns out the tool ranks them correctly.
**Done when:** the ranking claim is stated as a result with numbers behind
it, in both directions (ordering and magnitude).
---
---
# Third pass — internal consistency and thesis alignment
Added 2026-08-20. Most of these came from cross-checking figures in the log
against each other rather than against outside knowledge.
---
## C0035 — The AXIS wrapper is now the binding constraint, not a nicety (P0, promote from C0014)
**Problem.** The wrapper is bit-serial: 73 words in + 145 words out per
timestep, unpacked and packed one bit per cycle. That is ~28k bits of
traffic per sample, matching the 39–48k cycles attributed to it.
**Why it has become blocking.** Once the dense engine gets a `P` knob
(C0029), the wrapper caps what parallelism can buy:
```
dense engine  wrapper   total    wrapper share
P=1   388k     48k      436k      11 %
P=4    97k     48k      145k      33 %
P=8    48k     48k       96k      50 %
```
The same saturation hits ED at higher K. **You cannot run the P or K sweeps
(C0025, C0029) or the iso-latency comparison (C0021) meaningfully while a
fixed 48k-cycle serial cost dominates both arms.** A word-parallel wrapper
takes 28k bits down to ~872 word transfers — roughly 32x — and removes the
ceiling.
**Action.** Implement word-parallel pack/unpack in `axis_conv.v`, re-verify
through the hostile-handshake bench for dense, ED K=1 and ED K=4, and
re-baseline every cycle figure.
**Done when:** the wrapper is a small fraction of both engines' totals and
the parallelism sweeps are no longer saturating on it.
---
## C0036 — Three different network geometries are conflated in the log (P1)
**Problem.** There are three networks in play and the log moves between
them without always saying which:
| | input | c3 | FC | params |
|---|---|---|---|---|
| project brief's target | 48x64 | 64x6x8 | 768→128 | 121,632 |
| **N-MNIST, as implemented** | 2x34x34 | 64x5x5 | **256→128** | **~56,096** |
| robot / distilled (D0024) | 2x64x64 | 64x8x8 | 1024→34 | 58,178 |
The implemented N-MNIST FC is 256→128 = 32,768 weights (confirmed by
D0023's "W_T[j][n] (32,768 bytes)" and "128 neurons x 256 windows x 4
positions"), **not** the brief's 768→128 = 98,304.
**Consequences that matter.**
- D0004's "the FC layer holds 98,304 of 121,632 parameters — **81 %** of the
  network's weights" describes the *brief's* network. For the implemented
  N-MNIST network it is 32,768 / 56,096 = **58 %**. D0006 then cites the
  81 % figure as if it describes the built network, and uses it to reason
  about where the event-driven design's fate is decided.
- The headline constraint "161 KB, ~26 % of BRAM, everything on-chip" is
  also the brief's network. The implemented N-MNIST network is ~73 KB dense
  / ~91 KB event-driven. The robot network is ~114 KB / ~172 KB.
- All three still fit comfortably, so nothing is broken — but a reader
  cannot currently tell which number describes the artifact that was
  measured.
**Action.** Add a table to `docs/decisions.md` naming the three geometries
and their resource figures, and annotate every resource claim with which
one it describes. Correct the 81 % figure where it is used to describe the
implemented network.
**Done when:** every parameter, neuron and BRAM figure in the log states
its geometry.
---
## C0037 — With a fair dense baseline, the C1 crossover lands almost exactly at the operating point (P1)
**This is a result, not a defect — but it changes what the thesis reports.**
Using the M7 sim's own fitted models and a P=4 dense engine (C0029), and
holding the wrapper constant at ~48k cycles:
```
dense P=4 : 97k + 48k              = 145,000 cycles/sample  (flat)
ED K=4    : 121,800 + 21.9 x spikes
equal at   spikes = (145,000 - 121,800) / 21.9 = 1,059 spikes/sample
total possible = 2,312 inputs x 4 timesteps    = 9,248
crossover                                       = 11.5 % input activity
```
**The trained N-MNIST input activity is 13.8 % (D0009).** So at C1's actual
operating point, a fairly-parallelised dense engine and the event-driven
engine are within a few percent of each other — with dense marginally
ahead.
**Why this is good.** A crossover that sits far from the operating point is
a curiosity. One that sits *at* it is the thesis: it means the architecture
choice genuinely depends on the workload, and small design changes (the
sweep pipeline, C0030; the wrapper, C0035) move the answer. It also means
the deeper layers — where ED wins 3.6x and 4.4x even at P=4 — carry the
whole-network case, which is a mechanism worth stating.
**Action.** Recompute this properly once C0029, C0030 and C0035 land, and
report the crossover with its sensitivity to each. State plainly that at
C1's geometry and operating activity the two designs are close, and that
the event-driven advantage comes from fan-in-heavy layers.
**Done when:** the crossover is reported per layer, with the operating
point marked on the plot.
---
## C0038 — Board-level "energy per inference" is an ARM number, not an engine number (P0)
**Problem.** Fabric power is ~31 mW of a ~1.7 W chip estimate; the PS is
96 % of dynamic power. A measured "energy per inference" at the 12 V input
is therefore **overwhelmingly the ARM and the board**, not the accelerator.
Reporting "energy per inference = X mJ" without qualification would be a
statement about a Cortex-A9 running a polling loop.
**Action.** Report three distinct quantities and never let them merge:
1. **System energy per inference** — the board-level figure, honest and
   dominated by the host. Useful for the deployment argument.
2. **ΔE between the two engines** — the fabric-attributable difference.
   This is the architecture result.
3. **Engine energy** — (2) plus the static component from C0001, with the
   attribution method stated.
The dense-vs-ED comparison lives in (2). The ES-Parkour audit (C0022) must
also use (2) or (3), never (1), because ES-Parkour's analytical figure is a
network-compute number with no host in it.
**Done when:** the results chapter defines all three and every number is
labelled with which it is.
---
## C0039 — The verification sample set is class-biased (P1)
**Problem.** Every BOARD PASS uses "16 golden samples," and the cycle
tables refer to "busy digit-0 samples." D0009 established that N-MNIST is
class-ordered, so the first 16 samples are all digit 0.
**Why it matters.** Bit-exactness proven over one digit class is proven
over a narrow input distribution — narrower spatial extent, narrower
activity range, and possibly narrower membrane range than the full split.
The M1 membrane-range measurements (which justify the 16-bit datapath, and
therefore the absence of saturation logic in D0010) may also have been
taken on that distribution.
**Action.**
- Rebuild the 16-sample verification set as a seeded random draw across all
  ten classes, and re-run BOARD PASS for both engines.
- Re-check the membrane and current ranges on the full split, and confirm
  the 16-bit no-saturation decision (D0010) still holds with headroom.
**Done when:** verification spans all classes and the datapath-width
justification cites full-split ranges.
---
## C0040 — The M7 rehearsal used synthetic Bernoulli inputs; real activity is spatially clustered (P1)
**Problem.** `experiments/m7_sim/` sweeps activity with "synthetic
Bernoulli inputs at ten densities." Real event data is **spatially
clustered** — digits occupy a small region — so at the same mean rate the
address distribution is entirely different.
**Why it matters more for energy than for cycles.** By design there are no
data-dependent stalls (D0017's banking is conflict-free by construction),
so cycle counts should be insensitive to clustering. **Switching activity
is not.** Address locality changes BRAM row activation patterns and net
toggling, and energy per RMW is not a constant.
**Action.** Run the energy sweep on *real* samples with activity varied
through the threshold / weight-scale knob (D0005), not on synthetic
Bernoulli fields. Keep the Bernoulli sweep as the cycle-model validation it
already is, and label it as such.
**Done when:** the energy-versus-activity curve is measured on real data,
and any divergence from the Bernoulli cycle prediction is reported.
---
## C0041 — The wrapper's cycle attribution is internally inconsistent (P2)
**Problem.** The wrapper is reported as 48k cycles for dense (11 % of 436k)
and 39k for ED K=4 (26 % of 149k). But D0021 states the two paths do
**identical work** — same words in, same words out, differing only in one
line of the unpack state. Identical work should cost identical cycles.
The 9k discrepancy suggests the attribution is measuring *exposed*
wrapper time (cycles where the engine is idle) rather than wrapper work,
which would differ with overlap. That is a legitimate thing to measure, but
it is a different quantity and it should not be described as "the wrapper's
cost."
**Action.** State the attribution method precisely. If it is exposed time,
report the wrapper's absolute work separately, since only the absolute
figure is comparable between engines.
**Done when:** the method is documented and the two engines' wrapper
figures are reconciled or explained.
---
## C0042 — Nothing in the current plan produces the thesis's stated metric (P1)
**Problem.** The thesis's figure of merit is **energy per inference at a
fixed control deadline.** The experiments planned produce energy per
inference at ~100 % duty (BURST), latency, and — with C0005 — energy per
control period at various rates. None of these is yet measured *with a
deadline in force and consequences for missing it.*
**Why it matters.** This is the sentence that distinguishes the thesis from
an accelerator benchmarking paper. Without it, the work is "we measured two
SNN datapaths carefully," which is good but is not what the introduction
promises.
**Action.** Make the connection explicit and scheduled:
- Year one delivers the components: measured energy (C0001), latency, and
  the duty-cycle model (C0005).
- Year two's HIL loop delivers the deadline: `robot/host/perception_loop.py`
  already charges the perception path against an explicit budget and logs
  overruns. Wire the FPGA link in as the `perceive` callable, and report
  energy per control period alongside deadline-miss rate at each perception
  rate.
- State in the methodology which chapter delivers which half, so an
  examiner can see the promise is kept rather than quietly narrowed.
**Done when:** the thesis outline maps the stated metric to specific
experiments, and the HIL loop has the FPGA behind its `perceive` hook.
---
## C0044 — The event-driven sweep never zeroed neuron 0's input current (P1, RTL bug, fixed)
**Problem.** In `ed_conv_layer.v` the pipelined sweep (C0030) zeroes each
neuron's accumulated input current I[n] at the beat that reads it, through
the banks' write port. That write sat inside the `if (up_valid)` block —
the block that also writes back the PREVIOUS neuron's update — and
`up_valid` is false on the very first read beat of every sweep. So I[0]
was read but never cleared, and the next timestep's scatter added on top
of it: neuron 0's current accumulated across timesteps (the epilogue's
"final zero" only re-zeroed the LAST neuron, which its own read beat had
already cleared).
**Why it was invisible.** Output neuron 0 is channel 0 at output (0,0);
its receptive field is input rows/cols 0-1 of both polarities. On the
16 N-MNIST check samples that field is empty in all 64 timesteps (digits
are centred), so I[0] was always 0 and the bug had no effect: every
N-MNIST check, every board pass and the K sweep were genuinely
bit-identical — for that data. The DVS-Gesture C1 vectors put spikes
there in 3 of 32 timesteps and the synthetic Bernoulli set in 13 of 32,
and both failed at neuron 0 only, with the error compounding by one
extra I per timestep (V -15/-21/-26 against -7/-6/-5). The "synthetic
r1 set passes" claim in the C0030 notes did not survive a re-run on the
current tree; whether it ever held is not worth reconstructing — the
mechanism is unambiguous from the RTL.
**Fix (this commit).** The I-zero write is unconditional in the read
beat; the epilogue's duplicate write is removed. One fewer gate term, no
timing exposure. Verified: DVS-Gesture g1 K=1 and K=4 (1,048,576
comparisons each, 8 samples), synthetic r1 K=1 and K=4, N-MNIST c1 K=1
and K=4, full ladder.
**Consequences for results already recorded.** None are numerically
affected (N-MNIST exposure is zero on the check set), but the ED K=4
bitstream on the board carries the bug, and any board run on data with
corner activity — DVS-Gesture, the robot depth stream — needs a rebuild.
Build 3 (ED K=8) picks the fix up automatically once the VM copy of
`ed_conv_layer.v` is refreshed (`docs/vivado_session_next.md`).
**Lesson for the methodology chapter.** A check set can be bit-identical
and still exercise nothing at a boundary neuron. The second benchmark
earned its keep before producing an energy number: this is the argument
for C0012 stated in verification terms rather than reviewer terms. A
cheap guard is in place: the synthetic r1 set (corner activity in 13
of 32 timesteps) is a ladder check at K=4 (`check_all.sh`, 24 checks,
~12 min), and it was shown to FAIL on the pre-fix RTL before being
added. The exporters now print a corner-exposure line and write
`sim/vectors/ed_<layer>_exposure.txt` (`sim/corner_exposure.py`, with a
self-test in the ladder): for each output-corner neuron, how many
frames put a spike in its receptive field. First reading, 2026-09-17:

| set | frames | TL | TR | BL | BR | blind at |
|---|---|---|---|---|---|---|
| N-MNIST c1 (16 samples) | 64 | 0 | 0 | 0 | 0 | all four |
| N-MNIST c2 | 64 | 0 | 0 | 0 | 1 | TL, TR, BL |
| N-MNIST c3 | 64 | 0 | 10 | 6 | 1 | TL |
| DVS-Gesture g1 (8) | 32 | 3 | 0 | 1 | 0 | TR, BR |
| robot depth frames, real student (8) | 32 | 0 | 0 | 31 | 31 | TL, TR |
| synthetic r1 (8) | 32 | 13 | 13 | 22 | 25 | none |

N-MNIST is blind at every C1 corner, DVS-Gesture at two, and the real
robot frames at the top two (the depth camera's top rows are empty in
the recorded rollout). Only the synthetic set covers all four, which is
why it is the ladder's guard; a data set's own vectors are evidence
about the data, not about the boundary logic.
---
## C0045 — Rate-penalised networks run at different quantisation thresholds (P2)
**Problem.** The activity sweeps (`experiments/rate_sweep/`,
`rate_sweep_dvsg/`) compare engine cycles across networks trained to
different firing rates, but each network's D0008 shift k (hence its
threshold 2^k) is chosen from ITS max |w|, and the shifts move with the
rate (N-MNIST c1/c2/c3: 5/6/5 at 2 %, 6/7/6 at 16 %; DVS-Gesture 6/7/7 to
7/8/8). Cycle counts do not depend on the threshold, so the cycle axis is
clean; but any energy-per-cycle argument about "the same layer at
different activities" silently compares different integer scalings, and
the golden-drop column mixes rounding at different resolutions.
**Action.** State in the sweep READMEs (done) and in the thesis that the
activity axis holds the ARCHITECTURE fixed, not the integer scaling; if a
fixed-threshold comparison is wanted, add a `--fixed_k` option to
05_quantise that clips instead of re-scaling and report the clipping.
**Tool half done 2026-09-19:** `05_quantise.py --fixed_k <k|k1,k2,k3,k4>`
saturates at +-127 and reports/stores the clipped fraction per layer
(N-MNIST seed 0: k = 5 clips nothing, k = 7 clips conv1).
**Done when:** the thesis text says which is held fixed (open).
---
## C0046 — The int16 membrane margin is seed- and activity-dependent on DVS-Gesture (P1)
**Problem.** Three separate runs hit the fc membrane's int16 ceiling on
DVS-Gesture: T = 16 (seed 0, -34,472), T = 8 (seed 1 of 3, -33,013; seeds
0 and 2 fit with 12 % and 5 % headroom), and the 34 %-activity network at
T = 4 (-49,002). "Fits int16" is therefore not a property of a
configuration but of a (configuration, seed) pair near the edge, and the
golden check's PASS on one seed says nothing about the next.
**Action.** Decide, as a recorded design decision, between (a) 18-bit
membranes (RTL width change; +12 % membrane BRAM; every engine bench and
board build re-verified), (b) fc k = 7 (halves the range at a rounding
cost; a quantiser option), (c) DVS-Gesture stays at T = 4 and below ~20 %
activity, with the margin reported per seed. Until then, every DVS-Gesture
number carries its fc |V|max next to it, and any board build of a
DVS-Gesture network is preceded by a golden check on THAT checkpoint.
**Golden-check half done 2026-09-19:** every layer's line now carries
"% of int16" and a summary line gives the worst layer's headroom.
**Option costing done 2026-09-20** (experiments/dvsgesture/c0046/README.md):
requantising fc at k = 7 on all seven overflowing / near-ceiling networks
costs no measurable accuracy (-1.5 to +1.9 pp, mean +0.1 pp, 264 samples,
0.000 % weight clipping) and halves the fc range (95-186 % -> 47-93 % of
int16; k = 6 -> 23-47 %). The k = 8 golden accuracy is by construction
option (a)'s accuracy (int32 golden membranes), so (a) buys nothing (b)
does not. Recommendation on record: (b), fc k = min(choose_k, 7) per
dataset.
**Reproducibility caveat added 2026-09-20 (C0050):** option (c) cannot be
stated as "T = 16 fits on seed 1" — with code and seed held fixed, two
training runs land at 98 % and 102 % of int16, i.e. on either side of the
ceiling. Option (b) is the one that makes the verdict independent of the run.
**Done when:** one of (a)-(c) is chosen in decisions.md (open, the
user's call; the numbers for the call are now in the README above).
---
## C0047 — Direct coding makes the event-driven engine scatter the same frame four times (P2)
**Problem.** The year-two student uses the paper's direct coding: one
event frame repeated over T = 4 spiking timesteps. On the event-driven
engine every timestep re-scatters the identical spike list, so 75 % of
its scatter work per inference carries no new information; the dense
engine's cost is the same either way. The recreation's vector recorder
exported CONSECUTIVE tick frames instead, so the earlier r1 numbers were
for a window the student never saw (fixed: the port makes the window
explicit and the exporter refuses a mismatch; the real i1 vectors are
repeat-window).
**Action.** Report the year-two ED numbers as "direct coding" and add the
consecutive-window variant as an experiment, not a default: train a
second student with `--window consecutive` (same cost), record its frames
the same way, and bench both. If accuracy holds, the consecutive window
is the honest configuration for the hardware comparison and the paper's
choice becomes a stated deviation. Alternatively, an engine-side
optimisation (skip the scatter when the spike list is unchanged) would
make the ED cost of direct coding T-independent, which is worth a
decision entry before it is built.
**Done when:** both windows have a trained student and a bench row, or the
decision log says why only one is reported.
---
## C0048 — The "64 real frames" latency numbers were computed on 8 frames (P2, fixed)
**Problem.** The 2026-09-18 write-up (decisions.md, ledger, robot/isaac/README.md,
outline) quoted ED K=4 1.86 ms mean / 2.52 ms worst / 1.94x / 1.43x "on 64 real
robot event frames". The vector exporter's default is 8 samples and the ED
testbench's sample capacity was a fixed 16, so the bench ran on the first 8 frames;
the committed cycle file has 8 rows. The numbers were correct for 8 frames and
mislabelled as 64.
**Fix (2026-09-20).** Testbench capacity made a parameter (MAX_SAMPLES, default
16, behaviour unchanged; ladder spot check passes), the runner passes NS through,
the exporter takes I1_SAMPLES; all 64 frames benched in one run: 8,388,608
comparisons bit-identical, ED K=4 1.73 ms mean / 2.75 ms worst (spread 2.01x),
dense 3.60 ms: 2.09x mean, 1.31x worst. Every quote corrected in place with a
note. The lesson joins C0044's: a claim about N samples needs the N-row file
beside it (the per-sample figure now reads the 64-row file directly).
**Done when:** done.
---
## C0049 — The N-MNIST parallelism crossover was quoted as 6.6; it is 7.4 (P1, arithmetic, fixed)
**Problem.** From 2026-09-06 the headline parallelism crossover for N-MNIST C1
was stated as "K = P ~ 6.6" in the K-sweep README, the results ledger, the
silicon ledger, the repository README, two pre-registrations, a board record,
the Vivado session notes and the thesis outline. It does not follow from the
two fits printed beside it. With ED = 45,172 + 90,347/K and dense =
406,912/P + 2,331 (least squares over the cycle files; the dense fit
reproduces the measured P = 4 value of 104,059 exactly), equating them gives
**K = P = 7.39** — 7.31 on the engine-busy basis, i.e. the same answer with the
wrapper constant removed from both sides. Geometric interpolation of the
measured ratios (1.536 at K = P = 4, 0.942 at 8) gives 7.35. The data always
said ~7.4.
**Impact.** None on any measurement, table or silicon result: every cycle
count, every board latency and the bracket itself (ED wins at 4, dense at 8)
are unchanged. The corrected value sits closer to the K = P = 8 pair, which is
consistent with dense winning there by only 6 % while ED's best sample still
beats it. DVS-Gesture's 5.8 was checked at the same time and is correct (5.76).
**Fix (2026-09-20).** Corrected in the living documents (K-sweep README with
the derivation shown, results ledger, silicon ledger, repository README,
session notes, outline); the dated records that quoted it — two
pre-registrations and one board record — keep their original text with a
correction footnote, because rewriting a pre-registration would defeat its
purpose. The number is no longer typed anywhere it matters:
`docs/thesis_tables/crossover.md` recomputes it from the cycle files on every
table build.
**Independently verified (2026-09-20, board session).** Rederived from its own
copies of the fits: 7.389 on totals, 7.316 on the engine-busy basis, and 7.31
from log-interpolating its own measured ratios (1.523 at K = P = 4, 0.939 at
8) — agreeing with the value above to 0.08. Its decisive check is the clearest
statement of the error: evaluating both models **at** K = P = 6.6 gives ED
58,861 cycles against dense 63,984, so the dense engine is still 9 % behind
there and 6.6 was never a crossing point at all; at 7.4 the two models are 62
cycles apart.
**Lesson.** A derived number that is quoted more often than it is recomputed
drifts from its own inputs. Every derived headline now has a generator
(the tables) or a figure that reads the data. Two sessions rederiving it
independently is what caught how far off it was.
**Done when:** done.
---
## C0050 — Training is not reproducible at a fixed seed, and the difference straddles the int16 ceiling (P1)
**Problem.** Retraining DVS-Gesture seed 0 at T = 16 to complete the C0046
table produced a different network from the original (fc membrane 99 % of
int16 instead of 105 %, i.e. fits instead of overflows). A direct test with
the code and seed held fixed — two runs, same script, same pack — reproduces
the disagreement: run A ends at 98 % of int16 (fits), run B at 102 %
(overflows); quantised weights differ by up to 3 counts in conv1 and 38 in fc;
float accuracy differs by 1.1 pp. Training on the MI210 host is
non-deterministic at a fixed seed (non-deterministic GPU kernels;
`torch.use_deterministic_algorithms(True)` was never set).
**Consequences.**
1. **C0046's option (c) cannot be stated as written.** "T = 16 fits on seed 1"
   is not a property of a configuration: the same configuration and seed land
   on either side of the ceiling run to run, because they sit 1-2 % from it.
   Option (b) (fc k = 7) moves the membrane to 44-93 % of int16, far outside
   run-to-run variation, and is the option that makes the verdict stable.
2. **Single-run accuracy differences below a few pp on DVS-Gesture are not
   resolvable.** The reported three-seed spreads confound seed and run
   variation. No conclusion in this project rests on such a difference —
   the crossover results are cycle counts, which are exactly reproducible —
   but every accuracy table must say so.
3. It is a statistical-validity threat for the thesis (Section 3.5) and a
   residual-risk row for the discussion (6.9).
**Action taken (2026-09-20).** Recorded here and in
`experiments/dvsgesture/c0046/README.md` with both tables and the raw logs
(`c0046/rerun_seed0/`). **Standing rule from here:** any number that goes in
the thesis is either a cycle count (deterministic), or is reported over
repeated runs, or is produced with deterministic algorithms enabled. Not yet
done: re-running the affected accuracy tables under
`torch.use_deterministic_algorithms(True)` — cheap on this dataset (~2 min per
run) and worth doing before the accuracy tables are final.
**Done when:** the accuracy tables state their run count, and the affected
DVS-Gesture rows are either deterministic or repeated. Open.
---
## C0051 — Every experiment log was gitignored; one was overwritten before anyone noticed (P2, fixed)
**Problem.** `.gitignore` carried a blanket `*.log` rule under the heading
"Vivado / Vitis build junk". No Vivado log has ever lived in this repository
(they stay on the VM), but the rule silently excluded **206 experiment logs**
— the training, quantisation and golden-check outputs that the results tables
and READMEs are transcribed from, and that
`docs/thesis_tables/make_tables.py` now parses directly. They were invisible
to `git status`, so nothing warned that they were unprotected.
On 2026-09-20 an `rsync` of the MI210's experiment directory overwrote the
local seed-0 T = 8 / T = 16 golden-check logs with a rerun, and the rerun
script had already overwritten the remote originals. The original *numbers*
survive because they had been transcribed into
`experiments/dvsgesture/README.md`, but the logs themselves are gone — and
they cannot be regenerated, because training is not reproducible (C0050).
**Fix.** The rule is narrowed to the Vivado names it was meant for
(`vivado*.log`, `runme.log`, `hs_err_pid*.log`, `webtalk*.log`, `xsim*.log`)
and the 206 experiment logs are now tracked (≈800 KB). A clean checkout can
now reproduce every generated table, which was not true before.
**Lesson.** An ignore rule written for one tool's junk silently decided the
provenance policy for the whole project. Rules that hide files should name
the files they mean.
**Done when:** done.
---
## C0052 — The event-driven scatter spends 4.0 block-RAM tiles at K=16 on a 288-byte table (P2, found before the build, deliberately not fixed yet)
**What it is.** `ed_scatter.v` (and the baked `ed_scatter_c1.v` that is
actually synthesised) holds the layer's weights in
`reg signed [7:0] wt [0:C_IN*9*C_OUT-1]` — 288 entries, **2,304 bits**, for
C1 — and reads it K-wide in one cycle:
`for (j = 0; j < K; j = j + 1) w_r[j] <= wt[wt_row + j]`. K simultaneous reads
require K read ports; a RAMB18 is dual-port, so synthesis replicates the table
into K/2 primitives. That is 2 at K = 4 and 4 at K = 8, matching both measured
builds exactly, and 8 at K = 16.
**The cost.** At K = 16 those eight primitives hold 147,456 bits to store
2,304: **1.6 % utilised, 4.0 block-RAM tiles for a quarter-kilobyte lookup**
(6.3 % utilised and 1.0 tile at K = 4). So a measurable part of what the
energy-versus-K sweep will report as "the memory cost of raising K" is not
banked neuron state at all — it is a tiny ROM being copied to buy read ports.
**It also decides a build.** K = 16 replicated eight times needs 142 tiles of
the 140 available and is predicted not to place; with the table in distributed
RAM the engine would be 13.5 tiles and the same build would need 110, which
fits. The replication limit at the top of the K axis is set by a synthesis
attribute on a 288-byte array rather than by the architecture.
**Deliberately not fixed now.** Changing `ram_style` mid-experiment would tune
the design after its predictions were written (K5, K6) and would make the K
sweep inconsistent with every event-driven board result on record. The sweep
runs on the RTL as pre-registered; this is reported as a named, quantified
improvement the experiment exposed, which is a better methodology sentence
than a quietly optimised build.
**Open decision for the user.** Re-baselining on a fixed version is a real
option and a real cost: every event-driven bitstream would need rebuilding and
re-validating, and the existing passes could no longer be reused. Stated here
rather than slipped in.
**Done when:** the user decides whether to re-baseline, and either way the
K = 16 row reports the table's share of its tiles separately from the banks'.
---
## C0054 — The dense engine's tail was not pipelined where the event-driven sweep's was (P0, fixed 2026-09-20)
**Problem.** `conv_layer_p.v` ran four states after every output group's MAC
loop -- S_TAIL, S_VRD, S_VREG, S_UPDATE -- strictly in sequence. Two of them,
S_VRD and S_VREG, existed only to cover the membrane memory's read latency.
C0030 had already removed exactly this pattern from the event-driven sweep
("read n+1 while updating n", 4 cycles per neuron down to 2) and said why:
at 4 the event-driven floor was 18.5k of 27.1k cycles and the margin was "too
thin to build an energy argument on". The same optimisation was never applied
to the dense arm, so the headline comparison ran a pipelined engine against an
unpipelined one. Because the tail is amortised over the tap count it cost
**18.2 % of dense cycles on C1 -- the only layer on silicon -- and 1.4 % on C3.**
**Fix.** The read address `n_off` is already stable throughout S_MAC (it only
advances in S_UPDATE), so the membrane read is now issued during the MAC loop
and `v_lat`/`v_r2` are valid when the loop ends. S_VRD and S_VREG are gone.
The tail is S_TAIL + S_UPDATE = 2. Two lines plus two state encodings.
**Verified.** Bit-identical to the golden model at every P; the derived law
`(N/P) x T x (9 C_IN + 2) + 4` reproduces the regenerated AXI-harness files
exactly at P = 1, 2, 4, 8, 16 (369,924 / 184,964 / 92,484 / 46,244 / 23,124
engine-busy cycles).
**Why it stops at tail = 2 and not tail = 1.** The remaining two cycles could
also be hidden, by holding the finished accumulator and membrane in shadow
registers and letting the LIF update ride the next group's first MAC cycle.
That was deliberately NOT done. The event-driven sweep does not overlap its
own update either -- its two-cycle beat is one cycle to present addresses and
one to update -- so taking the dense engine to tail = 1 would buy it an
optimisation its counterpart does not have and would create the opposite
unfairness. What C0054 restores is parity: **both engines now hide their read
latency and neither hides its update.** That is the defensible stopping point,
and it is the answer to the obvious reviewer question of why the dense engine
was not optimised further.
**Consequences, all directions unchanged, all margins roughly halved.**
C1 at matched parallelism K = P = 4 moves from ED 1.54x to about 1.40x; the
parallelism crossover from 7.3 to about 6.5; the DVS-Gesture per-clip mean
from 1.25x to about 1.09x, still 6 of 8 clips. **Every dense board pass is
superseded** (4, 6, 8, 11, 12, 14) -- they were built from the old engine.
**Done when:** the dense passes are rebuilt, or the thesis states which board
figures predate C0054. Open on the board side.
---
## C0055 — The thesis question HAS been asked outside robotics; the gap statement must be rewritten (P0, novelty)
**Why this exists.** A literature check on 2026-09-20 (web search, not a systematic
review) found three prior works that between them cover most of what this
thesis's gap statement claims is absent. None of them does the whole thing, but
the gap is much narrower than Chapter 3 currently says, and a reviewer will
find these.

**1. The comparison itself, at neuron level, with estimated power.**
F. Marostica, A. Carpegna, A. Savino, S. Di Carlo, "Energy-Efficient Digital
Design: A Comparative Study of Event-Driven and Clock-Driven Spiking Neurons",
arXiv:2506.13268 (2025) -- the same Politecnico di Torino group as Spiker+.
They build six neuron variants (event-driven and clock-driven, serial and AER,
shifter and multiplier decay), sweep input and temporal sparsity at 25/50/75/100
%, and plot the ratio of event-driven to clock-driven latency crossing 1 as
density rises. **That is our crossover question.** What they do NOT do:
- it is a **single neuron with 8 input channels**, not a layer datapath: no
  membrane banking, no spike queue, no scatter, no wrapper, no DMA -- none of
  the machinery that our thesis argues is where the event-driven overhead
  actually lives;
- **power is Vivado Power Analysis driven by a SAIF from post-synthesis
  simulation** ("Power consumption measurements were performed using the
  generated SAIF files under Vivado Power Analysis"), i.e. exactly the method
  this thesis exists to test against an instrument;
- no silicon pass, no golden-model bit-identity, no real network.
Their most interesting result is a counterintuitive one: event-driven power
RISES as inputs get sparser, because control-FSM "event" activity dominates the
arithmetic saved. That claim rests entirely on a tool estimate, which is a
direct and citable motivation for measuring.

**2. The measurement method exists, but NOT for a spiking network.**
"Embedded FPGA Acceleration of Brain-Like Neural Networks: Online Learning to
Scalable Inference", arXiv:2506.18530 (2025). Uses the **onboard INA226** on a
ZCU104 to measure board power and an idle-minus-execution delta, sampling at
10 ms over 1000+ samples per state -- our C0004/C0038 protocol exactly.
**PDF read 2026-09-20: it is NOT a spiking network.** The model is BCPNN, a
Bayesian-Hebbian "brain-like" network, and the paper states plainly that
"spike activity is represented as rate-based and not as an actual spike"
(Sec. II). Its comparison is against ARM software baselines, not against a
second datapath.
**So the Chapter 1 claim survives in its strong form**: no FPGA *spiking*
accelerator reports externally instrumented board power -- all seven surveyed
in docs/baseline_table.md use a tool estimate or state no method. What this
work provides is **precedent for the protocol**, which is worth citing as
support for the method rather than as a threat to novelty.

**3. The sparse-versus-dense crossover framing, established for ANNs -- and the
comparison is more useful than expected.** SCNN (Parashar et al., ISCA 2017,
arXiv:1708.04485), read 2026-09-20. Its own words: "the SCNN architecture
starts [to beat the dense] architecture in performance and energy efficiency
[when] weights and activations are each less than 85% dense", and "at 100%
density, SCNN achieves about [a fraction of] the performance of DCNN because
it suffers from PE underutilization", reaching 24x at 10% density.
**The mechanism is ours exactly**: at high density the sparse machinery is
underutilised and loses; it only pays once there is enough sparsity to feed it.
**But the numbers are very different, and that difference is a contribution.**
SCNN's crossover is at 85 % density; ours is at ~30 % input density on C1.
Our event-driven engine needs roughly three times more sparsity before it pays.
The reason is structural and is the thesis's own mechanism: **a spiking
event-driven datapath has a floor that a sparse ANN accelerator does not.**
The leak-and-threshold sweep must visit every neuron every timestep (our 2NT
term) whether or not anything arrived, so the event-driven engine can never
fall below it however sparse the input. SCNN has no equivalent -- a zero
simply produces no work. That is a clean, quotable statement of why spiking
sparsity is harder to cash in than ANN sparsity, and it is exactly what this
thesis measures.

**4. The two datapaths have standard names, and the taxonomy omits one of
them for an interesting reason.** Eyeriss (Chen, Emer, Sze, ISCA 2016), read
2026-09-20, classifies CNN dataflows as Weight Stationary, Output Stationary,
No Local Reuse and Row Stationary. Output Stationary is defined as keeping
"the accumulation of [partial sums] for the same output activation value
stationary in a PE" -- **which is our dense engine exactly**: each output
neuron's accumulator stays put while weights and input bits stream past it.
Our event-driven engine is the dual: the *input* is held and scattered to all
the outputs it touches. **That dual has no name in their taxonomy**, and the
reason is instructive: for a dense ANN an input-stationary dataflow buys
nothing, because every input is used anyway. It only becomes interesting when
inputs are sparse, which is the spiking case. Adopt their vocabulary in
Chapter 2 and 4 -- call the dense engine output-stationary and the
event-driven one input-stationary (scatter) -- rather than inventing terms.

**5. Instrumented power measurement of SNN hardware on FPGA DOES exist, and the
Chapter 1 claim must be softened.** Found 2026-09-20 in an IEEE/ACM-indexed
search:
- **Lindqvist et al., "Fast Algorithms for Spiking Neural Network Simulation
  with FPGAs", arXiv:2405.02019.** On an Intel Agilex 7 they "use the Terasic
  Dashboard GUI to measure ... current rails going into the board and the FPGA
  itself, allowing us to measure both" board and fabric power, reporting 44.9 W
  board against 16.3 W fabric. That is a **genuine instrumented measurement,
  and finer-grained than ours** -- they separate the fabric rail; we only reach
  the board input. It is an SNN **simulator** for a cortical circuit, not an
  inference accelerator, and it compares simulator algorithms rather than
  datapaths.
- **FeNN (arXiv:2506.11760)**, a RISC-V vector processor for SNNs, measured
  whole-system power at the mains socket with a consumer meter when neither the
  Jetson nor the KV260 exposed sensors.
**Consequence:** "across roughly 25 published FPGA spiking accelerators,
essentially none report externally instrumented power" is **false as written**
and must become: *of the FPGA SNN **accelerators** surveyed here (seven in
docs/baseline_table.md), none reports instrumented power; instrumented
measurement does exist in the adjacent SNN **simulator** literature and for an
SNN processor measured at the wall.* Fix this in Chapter 1 before submission.

**6. A 2025 DATE paper makes the design decision our crossover would inform,
without measuring it.** "Exploring the Sparsity-Quantization Interplay on a
Novel Hybrid SNN Event-Driven Architecture" (DATE 2025, arXiv:2411.15409)
builds "a dense core to efficiently process the input layer and sparse cores
optimized for event-driven spiking convolutions" on a Virtex UltraScale+.
**It does not compare the two datapaths on the same layer.** The assignment
comes from a layer-wise workload model whose stated goal is "to partition
resources to minimize the execution latency difference between the most and
least workload-intensive layers" -- resource balancing, not a crossover -- and
its power is Vivado instance-level dynamic power. So the field is already
making dense-versus-event-driven architectural choices per layer **on
intuition and workload balance, with no measured threshold to justify them.**
That is the strongest available motivation for this thesis and should be cited
as such in Chapter 1.

**What survives as the gap, stated carefully:**
no published work compares an event-driven and a clock-driven **layer datapath
on the same fabric**, verified bit-identical against a common reference, swept
over activity AND parallelism, with energy **measured at the board input**
rather than estimated. Each clause is doing work: Marostica et al. have the
comparison but at neuron scale with an estimate, the BCPNN work has the
instrument but no spiking and no datapath comparison, and SCNN has the
crossover but for non-spiking hardware with no sweep floor.

**Search coverage, stated honestly.** This was a web search of indexed records
plus full-text reading of the eleven papers obtained, not a systematic review.
IEEE Xplore's own search needs an institutional login and renders through
JavaScript, so it was not queried directly. A Boolean full-text search of IEEE
Xplore and the ACM DL ("event-driven" AND "clock-driven" AND spiking AND FPGA;
spiking AND FPGA AND ("measured power" OR "power measurement")) is still owed
and needs the user's library access.

**Actions.**
- Rewrite Chapter 3's gap statement to the sentence above, and add all three
  works to the baseline table and the related-work chapter.
- Cite Marostica et al. as the closest prior work and as motivation, not as a
  threat to be minimised: their headline power finding is a tool estimate.
- Re-check the "essentially none report externally instrumented power" claim in
  Chapter 1 against arXiv:2506.18530 before it goes in.
- This was a web search, not a systematic review. A proper search of IEEE
  Xplore and ACM DL with the terms "event-driven", "clock-driven", "spiking",
  "FPGA", "energy" is still owed before submission.
**Done when:** the gap statement is rewritten and the three works are cited.
---
## Closing note on this review
Three passes have been made: methodology (C0001–C0017), measurement
accuracy and missing experiments (C0018–C0027), design and internal
consistency (C0028–C0042).
The rate of significant findings has dropped sharply — pass one found
structural gaps, pass two found protocol errors, pass three found mostly
bookkeeping inconsistencies plus two real ones (C0035, C0037). **That decay
is the signal to stop reviewing on paper and start acting**, because the
next class of problem is the kind only measurement finds: the noise floor
(C0002), the seed spread (C0019), and whether the fabric delta is resolvable
at all (C0003).
Two things that would benefit from a fresh pair of eyes rather than another
pass from me:
- **An independent re-derivation of the cycle model from the RTL**, by
  someone who has not seen the tables. C0028 was an arithmetic slip that
  survived because every later figure was checked against the same model.
- **A read of the M1 quantisation chain by someone fluent in fixed-point.**
  It is the one part of the stack I have only been able to check for
  internal consistency, not correctness — the shift-based leak's truncation
  behaviour for negative V (D0007) in particular deserves a second reader.
---
## Suggested order
**Immediately — these change what the results mean:**
0a. **C0028** (dense cost model wrong for C2/C3) — a highlighted finding
    does not survive; retract it before it propagates further.
0b. **C0029** (P-wide dense baseline) — the comparison is currently
    4-wide against 1-wide. Fixing it likely creates a real crossover.
0c. **C0031** (touched-neuron fraction) — one hour, and it settles C0006.
0d. **C0035** (word-parallel wrapper) — blocking the P and K sweeps and the
    iso-latency comparison; every cycle figure re-baselines after it.
0e. **C0038** (three energy quantities) — a labelling decision, but making
    it late means relabelling every table.
**Before the meter session:**
1. **C0002** (noise floor) — decides whether C0003 is optional.
2. **C0003** (replication) — likely removes the instrument problem.
3. **C0018** (multi-sample BURST) — cheap, and without it every energy
   number is one sample's.
4. **C0019** (seed variance) — a few extra builds; without it the delta
   cannot be attributed.
5. **C0001** + **C0004** + **C0020** (idle power, boundary, thermal) —
   recovers the static-power argument and removes a systematic error.
**Before any M7 number is written up:**
6. **C0006** (sweep skip) — a design decision; make it before more builds.
7. **C0022(a)** (analytical-vs-measured) — a day's work; it is the audit
   the thesis promised.
8. **C0005**, **C0007**, **C0008**, **C0021**, **C0024** — the M7 protocol
   proper.
9. **C0023**, **C0025** — the remaining sweep axes.
**Before write-up:** everything else.
The four cheapest items with the largest effect on whether the results are
believable are **C0002**, **C0018**, **C0019** and **C0001**. None takes
more than a day. Together they turn "we measured 25 mW of difference" into
a claim with a noise floor, a build-variance bound, a sample distribution,
and a static-power component — which is the difference between a result and
an anecdote.

## C0053 — Engine replication did not feed the replicas real data (2026-09-20)

**Found by** the peer session's architecture audit, from the RTL; confirmed
here by tracing the two state machines before any fix was written.

**The defect.** `axis_conv_top` drives the AXI-Stream bus `tready` from
instance 0 only (`assign s_axis_tready = g_rep[0].rep_tready`) and tied
every other replica's **output** ready to `1'b1`. Inside one engine the
accept condition `S_RX: if (s_axis_tvalid)` is self-consistent, because
that engine's own tready IS `(state == S_RX)`. Across replicas it is not:

1. a replica never stalls in `S_TXSEND` (its `m_axis_tready` is tied
   high), so it drains its output words and re-enters `S_RX` while
   instance 0 is still transmitting through real DMA backpressure;
2. the DMA, waiting on instance 0's tready, **holds the same word on the
   bus with tvalid high**;
3. the replica, now in `S_RX`, latches that held word **once per cycle**,
   incrementing `rx_words` each time, until its input buffer is full of
   duplicates of one word -- then runs the engine on it.

So replicas did not merely desynchronise: they processed a fabricated
input. Receive and transmit alternate once per timestep, four times per
sample, so there are four opportunities per sample.

**Why nothing detected it.** Replica outputs are discarded by
construction; only instance 0 reaches the DMA. Every board pass checks
instance 0 and is therefore correct and unaffected. Simulation never saw
it because the testbench instantiates N_ENGINES = 1.

**Why it matters.** C0003 requires the replicas be fed real data
precisely so that per-engine energy can be taken as delta / N. For the
dense engine the work is data-independent, so the error is switching
activity only; for the event-driven engine the work scales with spike
count, so a replica running on duplicated words does a different amount
of scatter -- and that is the arm with the larger divisor in metering
rows 1, 7 and 9.

**Fix** (hdl/dense/axis_conv_top.v): replicas observe the bus handshake
rather than raw tvalid, `.s_axis_tvalid(s_axis_tvalid & s_axis_tready)`,
so a replica accepts exactly on the cycles a real transfer occurs; and
all replicas share instance 0's `m_axis_tready` so they stall in
transmit on the same cycles instead of draining early. Both are no-ops
for instance 0, and neither creates a combinational loop because tready
is a function of the state register.

**Status.** Correct by construction, not observable on the board, which
is why it had to be fixed rather than tested for. The ladder cannot
validate it -- every ladder bench runs N_ENGINES = 1 -- so the evidence
is the peer session's two-replica simulation, run against the pre-fix
and post-fix RTL for a before-and-after rather than an assertion.

**Consequence.** Every replicated bitstream on record (passes 7, 8, 13,
14) predates this fix, so their per-engine energy division rests on the
old behaviour. They are still valid as correctness passes of instance 0.
Rebuilding them is a user decision, recorded as open.

**Regression evidence (2026-09-20).** The harness has always supported
N_ENGINES (sim/run_axis_tb.sh passes NENG through to the testbench) and
no ladder check has ever used it -- which is why this survived. With the
fix in, the first multi-engine benches ever run all pass bit-identical:

| N | engine | dataset | result |
|---|---|---|---|
| 2 | ED K=4 | N-MNIST c1 | 9,280 words bit-identical |
| 2 | dense P=4 | N-MNIST c1 | 9,280 words bit-identical |
| 4 | ED K=4 | N-MNIST c1 | 9,280 words bit-identical |
| 4 | dense P=4 | N-MNIST c1 | 9,280 words bit-identical |
| 4 | ED K=4 | DVS-Gesture g1 | 16,384 words bit-identical |

This is a REGRESSION check, not a validation: instance 0 is correct
either way, because replica outputs are unconnected. It proves the fix
does not break the single stream that reaches the DMA; the defect
itself is detectable only by probing replica accepts, which is the
peer session's two-replica before-and-after.
