deestroy/snn_parkour_fgpa/docs/status_2026-08-19.md

# Project status — 19 August 2026

One page for the supervisor. Detail in `docs/decisions.md` (indexed at the
top) and the per-day logs. Supersedes `status_2026-08-18.md`, whose DDR
paragraph turned out to be wrong (the board's DDR was fine; the block
design had the wrong DDR part — D0015 log).

## Where the project is

| milestone | state |
|---|---|
| M0 train the SNN, measure firing rates | **done** — 97 % on N-MNIST; conv layers fire at 6–11 %, FC 30 % |
| M1 fixed-point golden model | **done** — all-integer, 96.75 % vs 96.60 % float |
| M2 one neuron in HDL | **done** — bit-identical |
| M3 dense conv engine + FC in HDL | **done** — all layers bit-identical (1.15 M checks) |
| M4 on the board | **done** — ZedBoard, bare metal, SD boot; dense C1 engine returns 9,280 words bit-identical to golden over UART/DMA |
| M5 power measurement | rig software desk-tested; **BURST mode built and verified on the board** (engine at ~100 % duty for the meter); **no meter yet** — professor suggests a bench DMM first; procedure written (`measure/dmm_protocol.md`) |
| M6 event-driven design | **done on silicon, timing-clean** — K=4 banked scatter engine, WNS +0.735 ns at 100 MHz, 9,280 words bit-identical, deterministic over 15,000 back-to-back inferences |
| M7 crossover | not started on hardware; **simulated latency-vs-firing-rate curve** for both engines produced overnight (`experiments/m7_sim/`), model verified against the board to 3 % |

## Numbers so far (C1 layer, XC7Z020, 100 MHz)

| | dense | event-driven K=4 |
|---|---|---|
| latency / inference, board (BURST) | — (predicted 4.4 ms) | **1.51 ms** measured, sample-dependent 1.49–1.56 |
| latency / inference, simulation | 4.36 ms, data-independent | 1.49 ms mean |
| LUT / FF / BRAM / DSP (whole design incl. DMA) | ~1,860 / ~2,510 / 3 / 0 (provisional) | 3,383 / 4,036 / 13 / 2 |
| Vivado on-chip power estimate | — | 1.73 W total (mostly ARM PS) |
| energy / inference, **measured** | **not yet — needs the meter** | **not yet** |

At the trained C1 activity the event-driven engine is ~2.9x faster and
uses ~4x the block RAM and ~1.7x the logic. Energy is the open question and
is exactly what the meter answers.

## What it took to get the event-driven engine sign-off clean (thesis material)

Between "bit-identical in simulation" and "timing-clean on the fabric" five
things had to change, none of which the dense engine needed: BRAM port
discipline (a 62k-LUT overrun), no multipliers on address paths, no
dividers on address paths (addresses carried as fields, D0020 rev 2),
re-registered BRAM reads before the LIF arithmetic, and a Vivado refresh
that silently dropped the DMA address map. All logged with the timing
reports. This asymmetry is part of the "event-driven machinery costs
something" argument, with numbers.

## What is needed from outside the project

1. **A current measurement on the 12 V input.** Bench DMM with >= 1 mA
   (ideally 0.1 mA) resolution, or the INA226 breakout (~$15,
   `docs/m5_power_meter_shopping.md`). Everything else for the first
   measured energy number exists and is rehearsed.
2. Nothing else.

## Next steps (also in README)

1. Meter session: idle / BURST / idle, both engines -> uJ per inference
   next to Vivado's estimate (first thesis result).
2. Dense engine rebuilt (ENGINE=0) for its board latency and exact
   utilisation.
Then M7 on hardware.
