deestroy/snn_parkour_fgpa/docs/overnight_2026-08-18.md

# Overnight report — night of 2026-08-17 → 18

Read this first. It covers everything that changed while you slept, every
retraction, and the one architectural consequence. Details and register
evidence are in `docs/decisions.md` (D0015 board-day log, parts 1–5 + DDR
note); this is the digest.

---

## The headline

**`LOOPBACK PASS: 12288 words round-tripped bit-identical`**

Your ZedBoard ran the loopback program, streamed 48 KB out through the
FPGA fabric via DMA and back, and every word matched. Programmed and
observed entirely from the Mac — no Vitis or Windows at run time.
**M4 Stage A's done-when is met.** The full console output:

```
=== snn_parkour_fpga : M4 stage A loopback (bare metal) ===
DMA at 0x40400000  SG=0 mm2s=1 s2mm=1
MM2S_DMASR=0x00000001 S2MM_DMASR=0x00000001
DMA init ok
LOOPBACK PASS: 12288 words round-tripped bit-identical
```

## What was actually wrong (one thing, five disguises)

`reset halt` asserts SRST. On Zynq, SRST leaves the PL's **PROGRAM_B line
held low** (`devcfg.CTRL[PCFG_PROG_B] = 0`) — the fabric is held cleared.
My loader then ran `pld load`, which streamed the bitstream into a fabric
that silently discarded it. Every symptom of the night followed from that:

| what we saw | what it actually was |
|---|---|
| CPU and debugger "see different DMA registers" | both reading an unconfigured PL; stable garbage differing by path |
| first PL write hangs the bus / wedges the DAP | no slave to return the write response |
| console lost every 2nd character | my own "disable the L2 filter" fix, which misrouted peripherals |
| "no UART enabled" → Vivado rebuild | reads through the running program's MMU; all zeros, all junk |
| "BSP outbyte drops bytes" | same L2-filter mistake in a different disguise |

The very first load of the evening had lit the DONE LED because it followed
a plain `halt`, not an SRST. I never registered the difference.

**Fix (in `host/mac/zynq_load.tcl`):** pulse `PCFG_PROG_B` low→high after
`ps7_init`, then `pld load`, then `ps7_post_config` — the xsct/FSBL order.
Verified with a DMA register write completing and reading back changed,
then the program running to PASS. Reproducible from a clean reset.

## Retractions (all recorded in decisions.md)

- **The L2 address filter was innocent.** UG585 confirms its reset value
  (start 0x40000000 enabled, end 0xFFF00000) is correct: DDR → M0,
  everything else → M1. Neither `boot.S`, the FSBL, nor `ps7_init` touch it.
  My "disable it" change broke peripheral routing; reverted.
- **UART was enabled all along.** The Vivado UART1 round trip was
  unnecessary (harmless — the design is certainly correct now).
- **The BSP's `xil_printf` was not dropping bytes.** My paced UART writer
  in `loopback.c` is kept anyway: it gives the program a
  library-independent diagnostics path and is simple.
- **The `bsp.yaml` stdout → `ps7_uart_1` change WAS real and necessary** —
  the ELF really did reference UART0 before it. Keep it.

## Everything that changed in the repo (all committed, nothing pushed)

| file | change |
|---|---|
| `host/mac/zynq_load.tcl` | PROG_B release; Xilinx ordering (init → PROG_B → bitstream → post_config → ELF); L2-filter write removed; `mrd` shim shape fixed |
| `host/board/loopback.c` | own paced UART writer replacing `xil_printf`; prints DMA config + raw status before init; `N_WORDS = 12288` (OCM, see below) |
| `host/mac/uart_capture.py` | new: capture the board's UART to a file for N seconds |
| `host/mac/program.sh` | unchanged in substance |
| `docs/decisions.md` | D0015 board-day log parts 1–5, DDR note; every retraction |
| `docs/m4_vivado_walkthrough.md` | UART-1 verification step in §3 (still worth having) |
| **`golden/eventdriven.py`** | **new — M6 step 1: the event-driven engine in Python (see below)** |
| `sim/export_ed_vectors.py` | new: transposed weights + spike address lists for the future Verilog TB |
| **`host/protocol.md`, `host/snn_link.py`, `host/board/conv_server.c`, `host/uart_client.py`, `host/mock_server.py`** | **new — the whole Stage B host side (see below)** |
| `host/mac/run_fsbl.sh` | new: one-command FSBL test for the DDR question |
| `docs/m4_stage_b_vivado.md` | rewritten for the bare-metal flow |
| `docs/decisions.md` | + D0019, DDR DLL finding |

`git log` shows ~15 commits since you slept.

## Second half of the night (after LOOPBACK PASS)

### M6 step 1 — the event-driven engine in Python: **bit-identical to golden**

`golden/eventdriven.py` is D0016–D0018 written as code: per-layer address
lists, transposed weights, computed targets, channel-interleaved banks,
the shared LIF rule in the sweep. Replaying the golden traces through it:
**c1/c2/c3, K=1 and K=4, 1.13M checks, 0 mismatches.** The bank mapping is
proven bijective and conflict-free for K = 1, 2, 4, 8. The "same arithmetic
in a different order ⇒ same traces" claim is now a measurement.

First hard M6 sizing numbers, at trained rates, per timestep:

| layer | dense mem ops | event-driven RMWs | ratio |
|---|---|---|---|
| C1 | 83k | 14.1k | 5.9× fewer |
| C2 | 373k | 29.3k | 12.7× |
| C3 | 461k | 38.3k | 12.0× |

**Architectural decision made — D0019, flagged for you:** writing the
engine exposed that the leak and pending-reset are functions of V[n-1]
alone, so scatter cannot accumulate into V. **Each neuron needs two words:
membrane V and an input accumulator I.** Cost: membrane BRAM doubles
(42.2 → 84.4 KB on the target network; on-chip total 161 → 203 KB, 33% of
BRAM). It's the honest price of the event-driven design and must appear in
the resource comparison. Nothing else in D0016–D0018 changed. If you'd
rather revisit it, nothing downstream depends on it yet.

### M6 harness — the testbench exists before the RTL (D0020)

The event-driven engine's port contract is fixed (address pushes + start
instead of a bit buffer — the one difference from the dense engine).
`sim/tb_ed_conv.v` drives the golden address lists and compares every
neuron; a shim adapts the verified dense engine to that interface so the
harness could be proven tonight: c1/c2/c3 clean, spike counts matching the
Python engine, one dropped address fails 124 checks. The real RTL will
slot in as `bash sim/run_ed_tb.sh c1 ed_conv_layer` with no harness change.
The M6 RTL itself is deliberately NOT written — that's a session with you.

### Stage B host side — done, verified against a golden-model mock

`host/protocol.md` defines a framed UART protocol (magic, cmd, length,
payload, CRC-32) so a dropped byte can never masquerade as an engine bug.
`snn_link.py` is the single codec both ends use; `uart_client.py` streams
the 16 golden samples and compares every word; `conv_server.c` is the
bare-metal side (untested until the Stage B bitstream exists);
`mock_server.py` speaks the protocol with the golden model as the engine.
`python3 host/mock_server.py --selftest` → **MOCK PASS, 9,280 words
bit-identical.** Fault injection: corrupted byte rejected with the right
error code, short frame rejected, link recovers. The mock caught two real
bugs before any silicon (stale announce frames desyncing the client; the
mock dying on CRC error instead of replying like the C does).

## DDR — not resolved, and it matters (this is the architectural item)

With everything else correct, DDR **still does not retain data**: CPU
writes wedge the core, debugger writes bus-fault, reads return 0 — while
every controller-side status reports healthy (PLLs locked, DDRC in normal
mode with init done, DCI calibrated, PHY trained). That's the signature of
a PHY that cannot talk to the DRAM chips.

Evidence points at **rev-1.0 (2012 engineering-sample-era) XC7Z020
silicon**: DDRC register `0xF8006078` bus-faults on a plain read on fresh
silicon — it exists on rev 2.0/3.0 (whose init tables write it) and not
here — and MCTRL/IDCODE report rev 0. Rev-1.0 has known DDR limitations.
Consistent with a Rev-C ZedBoard from 2012–13.

**Consequence: the design lives in the 192 KB OCM until proven otherwise.**
This is a real architectural constraint, so stating it plainly:
- **Stage B is not blocked.** The C1 conv test needs ~4.6 KB/sample plus
  code — fits comfortably. FC traffic is smaller still.
- **M5/M7 sweeps** must stream samples one at a time from the host —
  which UART throughput forces anyway. No design change.
- **The 100,000-word buffer revert stays deferred**; `N_WORDS = 12288`
  and `loopback.c` says why. Revert instructions unchanged (D0015 note).
- If DDR is ever confirmed dead, the thesis methodology should say the
  board's DRAM was unavailable and all on-chip claims were, if anything,
  *stricter* than planned. Not a weakness — arguably cleaner.

**Two things only you can do to settle it (both in Vitis):**
1. **Build the FSBL** — `File > New Component > Application` → on
   `zed_platform` → template **Zynq FSBL** → Finish → Build (its own
   linker script already targets OCM; don't touch it). Copy
   `zynq_fsbl.elf` to `host/mac/build/fsbl.elf`. Then on the Mac:
   ```bash
   bash host/mac/run_fsbl.sh host/mac/build/fsbl.elf
   ```
   It skips our ps7_init (the FSBL runs its own C version, which carries
   silicon-rev workarounds the .tcl lacks), runs the FSBL, and prints its
   UART output. The FSBL says "DDR init …" and, if it fails, why. If it
   brings DDR up, the FSBL becomes our loader stage. ~10 minutes.
   *(Later finding, 03:30: the DDR PHY's DLLs are locked and trained —
   see decisions.md — so this test is genuinely the last discriminator.)*
2. If the FSBL fails too: DDR is hardware-dead on this board; we proceed
   on OCM with a clear conscience.

## Debugging rules that came out of tonight (in decisions.md)

1. Never trust CPU-side memory reads of a halted target that has run a
   program — its MMU is on. Read peripherals through the AHB-AP `mem_ap`.
2. When a program hangs on I/O, drive the peripheral by hand from the
   debugger first. If that works, the bug is in software addressing.
3. `devcfg.STATUS[PCFG_DONE]` and `MCTRL` read 0 over the debug port on
   this part regardless of truth; don't gate on them.
4. A wedged FTDI JTAG adapter (MPSSE assertion) recovers with a pyusb
   device reset — no replug needed.
5. Vitis 2024.1 BSP stdin/stdout live in the domain's `bsp.yaml`; the GUI
   is unreliable for it.

## What I did NOT do

- No Vivado or Vitis changes (couldn't, and wouldn't unasked).
- No push to GitHub — that's still yours.
- No Verilog for M6 — the Python engine and vector exporter are the
  scaffolding it will be checked against; the RTL waits for a session
  with you, per the one-component-at-a-time rule.

## Also written, late in the night

- `docs/status_2026-08-18.md` — a one-page status for your supervisor,
  honest about the ZedBoard consequence (their call) and clear that the
  power meter is now the critical path.
- `docs/decisions.md` now has an index table at the top; two stale OPEN
  statuses (D0003, D0015) corrected to DECIDED.
- RTL is verilator-lint-clean under `-Wall` (explicit sign-extension of the
  int8 weights, redundant FSM initialisers removed); full regression still
  bit-identical everywhere. README layout/environment/checks refreshed.

## One command to trust the whole repo

```bash
bash check_all.sh
```
Runs all eleven suites (M0 through M6, host mock, M5 mock, RTL lint) in
about three minutes, no board needed. Last run: **11 passed, 0 failed.**

## Suggested first hour today

1. Read this. Skim decisions.md D0015 parts 4–5 and D0019 if you want the
   register trail and the one architectural call.
2. Vitis: build the FSBL (steps above), copy the `.elf`,
   `bash host/mac/run_fsbl.sh host/mac/build/fsbl.elf`. We learn DDR's fate.
3. Stage B: swap the FIFO for the C1 engine in Vivado
   (`docs/m4_stage_b_vivado.md`, rewritten), build `conv_server` in Vitis,
   copy `.bit` + `.xsa` + `conv_server.elf`. Then
   `bash host/mac/program.sh …conv_server.elf` and
   `python3 host/uart_client.py`. That run is M4's done-when.

### M5 software — written and desk-tested against a mock meter

`measure/`: `ina226.py` (real chip over smbus2, calibrated for the 0.02 Ω
shunt on 12 V; plus `MockINA226`), `protocol.py` (idle → run → idle with
both baselines, SEM propagation, drift flag), `report.py` (every the project brief
metric together, measured beside the Vivado estimate). Mock check: a
synthetic 0.85 W load recovered as 0.849 W ± 0.4%; a drifting supply trips
the flag. Waiting only on the INA226 order and a Stage B engine to drive.
`python3 measure/protocol.py --mock` shows the whole thing.

## Final state (~01:30 local — the "0x:xx" timestamps in decisions.md ran ~2h fast; sequence is right, hours are not)

Full regression, every suite in the repo, all green: M2 neuron (4,060),
M3 dense c1/c2/c3 (1.13M), FC (16,384), AXIS wrapper (9,280 words), M6
harness (591,872), M6 Python K=4 (591,872), host mock (9,280 words),
golden model. `conv_server.c` and `loopback.c` syntax-check clean against
stubbed BSP headers, and the C server's CRC matches Python's on a real
frame — the classes of bug that cost round trips yesterday are ruled out.

Board is powered, JTAG-reachable, sitting in a clean halted state.

Not a bad night: from "does any of this work" to a passing loopback with a
root cause; the event-driven design proven in software and its testbench
proven in simulation; the whole Stage B host side verified against a mock;
and one precise, 10-minute question (the FSBL) left over instead of a fog.
