deestroy/snn_parkour_fgpa/docs/status_2026-08-18.md

# Project status — 18 August 2026

One page for the supervisor. Detail lives in `docs/decisions.md` (indexed
at the top) and the per-day logs.

## Where the project is

| milestone | state |
|---|---|
| M0 train the SNN, measure firing rates | **done** — 97% on N-MNIST; conv layers fire at 6–11%, FC at 30% |
| M1 fixed-point golden model | **done** — all-integer network, 96.75% vs 96.60% float; membranes fit 16 bits |
| M2 one neuron in HDL | **done** — bit-identical to the golden model in simulation |
| M3 dense conv engine in HDL | **done** — all three conv layers + FC, bit-identical (1.15M checks) |
| M4 on the board | **Stage A done** (DMA loopback passes on the ZedBoard); Stage B (conv engine on silicon) is today's run — everything for it is built and desk-verified |
| M5 power measurement | software written and desk-tested against a mock meter; **INA226 not yet ordered** — this is the item that gates the first thesis result |
| M6 event-driven design | architecture decided (three recorded decisions); engine written and verified **in Python** — same traces as the dense design; RTL testbench built and proven; **RTL itself not started** (next joint session) |
| M7 crossover experiment | not started; the software sizing already says event-driven does 6–13× less memory work than dense at trained rates, so the crossover will sit at rates above the trained network's — the interesting question is where |

## The ZedBoard decision, honestly

Using the ZedBoard instead of the planned PYNQ-Z2 has worked, at a cost:

- **No PYNQ/Linux image exists for it**, so the board runs bare-metal C and
  is programmed over JTAG from the Mac with open-source tools. That flow now
  works end-to-end and is scripted, but it took one long night to get there.
- **The board's DDR memory does not work** so far — every controller status
  says healthy but data does not retain. The evidence points at this being
  a 2012-era rev-1.0 Zynq (engineering-sample silicon on a Rev-C board),
  which had known DDR limitations. One test remains (running Xilinx's own
  boot loader, ~10 minutes); if it also fails, DDR is unusable on this board.
- **Consequence if DDR stays dead:** the design runs from the chip's 192 KB
  on-chip memory. This does not block M4–M7 — the network's whole state
  budget was always on-chip by design (that constraint is *stricter* than
  planned, not looser) — but it does mean samples stream one at a time from
  the host, which the UART link forces anyway. The methodology chapter would
  say so plainly.

If a PYNQ-Z2 becomes available later, everything built transfers unchanged;
the ZedBoard would become the secondary/portability board the proposal
already envisaged.

## What is needed from outside the project

1. **Order the power meter** (INA226 breakout + 0.02 Ω shunt, ~$15; list in
   `docs/m5_power_meter_shopping.md`). Nothing else gates M5.
2. Nothing else. Vivado/Vitis access is in place; the board is on the desk.

## Confidence

Every hardware module is bit-identical to a Python reference model that is
itself checked against snnTorch — the project's central engineering rule —
and every claim in the table above is backed by a runnable check listed in
the README. The one number that matters most, measured energy per
inference, does not exist yet because the meter does not: that is the
critical path.
