deestroy/snn_parkour_fgpa/docs/thesis_tables/tsweep.md

# Timesteps T vs accuracy and the int16 membrane ceiling

Generated by make_tables.py from the golden-check logs per (dataset, T, seed). Accuracy mean +- sd over seeds (sample sd); fc membrane use = peak |V| as a fraction of int16 over the golden run; a network 'overflows' when that exceeds 100 %% (the hardware membrane is int16, the golden model's is int32 -- see C0046). N-MNIST T=4 has no golden log with a membrane line in the repository; its float accuracy comes from the M0 CSV.

| dataset | T | seeds | float acc (%) | golden integer acc (%) | fc membrane (% of int16, min-max) | overflowing seeds |
|---|---|---|---|---|---|---|
| N-MNIST | 4 | 1 | 96.81 | -- | -- | -- |
| N-MNIST | 8 | 3 | 97.60 +- 0.09 | 97.66 +- 0.16 | 11-12 % | 0 of 3 |
| N-MNIST | 16 | 3 | 98.02 +- 0.16 | 98.02 +- 0.14 | 11-25 % | 0 of 3 |
| DVS-Gesture | 4 | 3 | 65.03 +- 3.06 | 65.28 +- 1.79 | 60-65 % | 0 of 3 |
| DVS-Gesture | 8 | 2 | 65.91 +- 1.07 | 64.58 +- 0.27 | 95-101 % | 1 of 2 |
| DVS-Gesture | 16 | 2 | 69.51 +- 0.81 | 69.88 +- 0.80 | 98-121 % | 1 of 2 |

**Why DVS-Gesture at T = 8 and T = 16 shows two seeds and not three.** Three
seeds were run for each. Seed 0's original golden-check logs were overwritten
on 2026-09-20 before anyone could see that they were not tracked (C0051), so
this generator can no longer read them. Their numbers survive, transcribed at
the time, in `experiments/dvsgesture/README.md`: T = 8 seed 0 fc -28,768 ..
22,533 (88 % of int16, fits); T = 16 seed 0 fc -34,472 .. 28,983 (105 %,
overflows), float 68.94 %, golden 70.83 %. Including them, T = 16 overflows on
two seeds of three and T = 8 on one of three, which is what the READMEs and the
ledger state. A retrain of seed 0 is in `experiments/dvsgesture/c0046/
rerun_seed0/` but is deliberately NOT counted here: it is a different network,
because training does not reproduce at a fixed seed (C0050).
