deestroy/snn_parkour_fgpa/docs/thesis_tables/ladder.md

# The verification ladder (check_all.sh)

Generated by make_tables.py from check_all.sh. Every check prints PASS or fails; the ladder is one command with one verdict (last full run: 33/33). Comparison counts per check are printed by the checks themselves (e.g. 591,872 comparisons for ED c1 K=4; 1,048,576 for DVS-Gesture g1 through the AXIS wrapper) and belong in the caption, not here.

| # | check | class | command |
|---|---|---|---|
| 1 | M0 LIF demo (golden vs snnTorch) | model check | `python3 train/00_lif_demo.py` |
| 2 | M0 model check (shapes/budget/reset) | model check | `python3 train/02_model_check.py` |
| 3 | M2 LIF neuron HDL | golden-model bit-identity | `bash sim/run_lif_tb.sh` |
| 4 | M3 dense conv c1/c2/c3 | golden-model bit-identity | `bash sim/run_conv_tb.sh c1 c2 c3` |
| 5 | M3 dense FC | golden-model bit-identity | `bash sim/run_fc_tb.sh` |
| 6 | M4 AXIS wrapper, dense P=1 (hostile handshake) | golden-model bit-identity | `bash sim/run_axis_tb.sh c1` |
| 7 | C0029/C0035 AXIS dense P=4 (BAKED, synth path) | golden-model bit-identity | `env BW=1 DP=4 bash sim/run_axis_tb.sh c1` |
| 8 | C0029 P-wide dense engine, P=4 (fair baseline) | golden-model bit-identity | `env P=4 bash sim/run_conv_p_tb.sh c1` |
| 9 | M6 AXIS wrapper, ED K=4 (BAKED, synth path) | golden-model bit-identity | `env BW=1 ENGINE=1 K=4 bash sim/run_axis_tb.sh c1` |
| 10 | C0012 AXIS DVS-Gesture, ED K=4 (BAKED, DATASET=1) | golden-model bit-identity | `env BW=1 ENGINE=1 K=4 bash sim/run_axis_tb.sh g1` |
| 11 | C0012 AXIS DVS-Gesture, dense P=4 (BAKED, DATASET=1) | golden-model bit-identity | `env BW=1 DP=4 bash sim/run_axis_tb.sh g1` |
| 12 | C0012 ED engine, DVS-Gesture C2 (g2) vs golden, K=4 | golden-model bit-identity | `env K=4 bash sim/run_ed_tb.sh g2 ed_conv_layer` |
| 13 | C0012 ED engine, DVS-Gesture C3 (g3) vs golden, K=4 | golden-model bit-identity | `env K=4 bash sim/run_ed_tb.sh g3 ed_conv_layer` |
| 14 | M6 event-driven engine vs golden, K=1 | golden-model bit-identity | `bash sim/run_ed_tb.sh c1 ed_conv_layer` |
| 15 | M6 event-driven engine vs golden, K=4 | golden-model bit-identity | `env K=4 bash sim/run_ed_tb.sh c1 ed_conv_layer` |
| 16 | C0044 ED engine, r1 corner-activity set, K=4 | golden-model bit-identity | `env K=4 bash sim/run_ed_tb.sh r1 ed_conv_layer` |
| 17 | M6 event-driven FC vs golden (D0023) | golden-model bit-identity | `bash sim/run_ed_fc_tb.sh` |
| 18 | M6 scatter unit vs Python I-dump, K=1 | golden-model bit-identity | `bash sim/run_ed_scatter_tb.sh c1` |
| 19 | M6 scatter unit vs Python I-dump, K=4 | golden-model bit-identity | `env K=4 bash sim/run_ed_scatter_tb.sh c1` |
| 20 | M6 python engine K=1/K=4 | golden-model bit-identity | `python3 -c (inline; see check_all.sh)` |
| 21 | Stage B host side vs golden mock | golden-model bit-identity | `python3 host/mock_server.py --selftest` |
| 22 | M5 protocol vs mock meter | self-test (host, protocol, meter, robot loop) | `python3 measure/protocol.py --mock` |
| 23 | M5 DMM manual-entry arithmetic | model check | `python3 measure/manual_meter.py --selftest` |
| 24 | Y2 per-cycle log (ring, flush, stats) | self-test (host, protocol, meter, robot loop) | `python3 robot/host/test_cycle_log.py` |
| 25 | Y2 perception loop (stale latent, misses) | self-test (host, protocol, meter, robot loop) | `python3 robot/host/test_perception_loop.py` |
| 26 | Y2 IsaacGym port (event sim == numpy, encoder verbatim, backbone) | self-test (host, protocol, meter, robot loop) | `python3 robot/isaac/test_port.py` |
| 27 | Baked weight tables == tracked golden npz | model check | `python3 sim/check_baked_weights.py` |
| 28 | Synth-safety lint (no two-stage init) | lint / synthesis safety | `bash sim/lint_synth_safety.sh` |
| 29 | C0044 corner-exposure helper selftest | golden-model bit-identity | `python3 sim/corner_exposure.py --selftest` |
| 30 | RTL lint, dense top (verilator -Wall) | lint / synthesis safety | `verilator --lint-only (see check_all.sh)` |
| 31 | RTL lint, event-driven top (ENGINE=1 K=4) | lint / synthesis safety | `verilator --lint-only (see check_all.sh)` |
| 32 | RTL lint, DVS-Gesture top, ED (DATASET=1 K=4) | lint / synthesis safety | `verilator --lint-only (see check_all.sh)` |
| 33 | RTL lint, DVS-Gesture top, dense (DATASET=1 P=4) | lint / synthesis safety | `verilator --lint-only (see check_all.sh)` |
