deestroy/snn_parkour_fgpa/docs/baseline_table.md

# External baseline table (C0011) — FPGA SNN accelerators, published figures

Skeleton with the rows the review names. RULE: numbers are transcribed
from the papers, never recalled from memory — rows marked [fill] await
transcription with the paper in hand. The "power obtained by" column is
the thesis's argument in visual form; ours will be the only measured
entries.

| work | platform | network | benchmark | acc | LUT/FF/BRAM/DSP | clk | latency | power obtained by | energy/inference |
|---|---|---|---|---|---|---|---|---|---|
| Harmeling et al., NCE 6 024022 (2026) | Artix-7 XC7A200T | 784-100-10, fully parallel per layer, 4-bit weights | MNIST | 96.31 % | 93,347 logic cells / — / 341 BRAM / — | 100 MHz | 1.7424 ms/digit | Vivado post-impl estimate, 1.13 W incl. HUB75 LED matrix | 1.972 mJ/digit (see note) |
| Cheng et al., TCAS-I 72(7) 2025 (Fudan) | Xilinx ZCU104 | 3-layer FC 1024-960-10 (N-MNIST) / 1024-512-11 (DVS128-Gesture), event-driven LIF, 8-bit fixed, up to 1M synapses, structured sparsity 50 % | N-MNIST (32x32 crop); DVS128-Gesture | 96.0 % N-MNIST; 79.2 % DVS128-Gesture (Sec. IV-C; abstract says 79.0 %) | 81,299 / 47,768 / 258.5 / — (Table III has no DSP column) | 250 MHz | per-inference time not given; early-stop cuts mean inference time 74 % (Fig. 16); 6.59 Meps throughput | **tool estimate**: Vivado 2020.2 with a SAIF from ~1 ms of post-implementation simulation (Sec. IV-E) | not per inference; 0.808 W dynamic at 16 PEs, 3.99 GSOP/W (Table V) |
| Cerebron (Chen, Gao, Fu), TVLSI 30(10) 2022 | Xilinx XC7Z100 | reconfigurable CE 8x8x4, IF neurons, reset-by-subtraction; spiking ConvNet / MobileNet / SegNet | MNIST / CIFAR-10 / MLND-Capstone | 99.40 / 91.90 / 97.30 % | 85,926 / 70,544 / 283 / 0 (Table III) | 200 MHz | 0.026 / 10.63 / 0.80 ms per image (Table II) | **tool estimate**: "on-chip power" 1.4 W with a breakdown incl. 10.2 % static (Fig. 15); "without considering off-chip data access" (Sec. V-D) | 0.04 / 14.88 / 1.12 mJ per frame (Table II) |
| Li et al., TCAS-I 68(4) 2021 (UESTC) | Xilinx VC707 (Virtex-7) | 784-200-100-10 FC, LIF, 16-bit floating, adaptive clock / event-driven, STDP online learning | MNIST (Poisson-coded) | 92.93 % (inference); 85.28 % online learning | [fill: Sec. IV, not on the pages transcribed] | 100 MHz | 3.15 ms per image (Fig. 10, Table II) | **tool estimate**: Vivado power estimation tool fed a SAIF from post-P&R simulation (Sec. IV-A) | 5.04 mJ per image; 0.028 uJ per synapse per image (Table II) |
| Minitaur (Neil & Liu), TVLSI 22(12) 2014 | [fill: FPGA part in Sec. IV; Li 2021's Table II lists it as Spartan-6] | event-driven spiking DBN, LIF, 16-bit fixed (5.11), up to 65,536 neurons / 16.78 M synapses, 32 cores | MNIST; 20 Newsgroups | 92.00 % MNIST; 71.07 % newsgroups | [fill: Sec. IV] | 75 MHz | 236 us USB-to-USB (10,000 trials); 18.73 M PSC/s peak, 4.88 M PSC/s on MNIST | "1.1 W (idle) - 1.5 W (peak)" (Table II); idle/peak wording reads as a **system measurement** but the method is not stated on the pages transcribed (pp. 2, 6-7) -- verify Sec. V before citing it as measured | not given per inference |
| FireFly-P (Li et al., arXiv 2601.21222, 2026) | Xilinx Cmod A7-35T (Artix-7) | 784-1024-10 FC with on-chip plasticity (dual engine, FP16, 16 PEs); control tasks + MNIST | ant / half-cheetah / ur5e (Brax); MNIST | 97.5 % MNIST (Table II) | 10.9k LUT (52.8 %) / 16.6k reg / 20.5 BRAM / 47 DSP (Table I) | 200 MHz | 8 us inference + learning; 32 FPS end-to-end | **tool estimate**: "all power and resource utilization metrics were derived from the post-implementation reports generated by the Vivado Design Suite" (Sec. IV-A) | not given; 0.713 W |
| FireFly-S (Tang et al.), TCAS-I 72(8) 2025, 10.1109/TCSI.2024.3496554 | Xilinx KV260 (XCZU5EV) | sparse spiking CNNs, dual-side sparsity | MNIST / DVS-Gesture / CIFAR-10 | 98.03 / 92.05 / 87.00 % | [fill from Table] | 333 MHz | [fill] | **tool estimate**: power 'derived from the reports generated by the Vivado Design Suite' | 1.301 / 1.821 / 3.799 W reported as power; energy [fill] |
| Spiker+ (Carpegna et al.), TETC 13(3) 2025, 10.1109/TETC.2024.3511676 | Xilinx XC7Z020 (the ZedBoard's fabric) | generated FC SNN accelerators (framework), LIF | MNIST / SHD | 93.85 / 72.99 % | 7,612 logic cells / 18 BRAM (MNIST) | 100 MHz | 780 us (MNIST), 540 us (SHD) | table headed 'Synthesis' -- tool-derived, method not stated in the pages read [confirm in the TETC version] | 180 mW x 780 us = ~140 uJ (MNIST); 430 mW x 540 us = ~232 uJ (SHD) -- power figures as reported |
| **ours, dense P=1 (naive)** [SUPERSEDED, see note] | Zynq XC7Z020 (PL) | conv 2-16-32-64 + FC 256-128, int8 pow2 | N-MNIST | 96.75 % (quantised) | 3,167 / 4,059 / 7.5 / 0 | 100 MHz | 4.409 ms/inference (measured) | **board-rail meter (pending session)** | [meter] |
| **ours, event-driven K=4** [SUPERSEDED, see note] | Zynq XC7Z020 (PL) | same network | N-MNIST | 96.75 % | 3,383 / 4,036 / 13 / 0* | 100 MHz | 1.51 ms/inference (measured) | **board-rail meter (pending session)** | [meter] |

\* ED DSP=0 by construction (use_dsp), to be confirmed measured on the
next build. Matched-parallelism rows (dense P=4) join after the C0035
re-baseline.

Transcribed 2026-09-19 from the PDFs in OneDrive "Research Papers/Similar
Papers" (page references per cell). Of the five accelerator rows now
filled, **seven of the eight state a synthesis-tool power estimate as their
method** (the eighth, Minitaur, gives idle/peak watts without stating one)

> **Our own two rows above are SUPERSEDED and must not be cited.** Their
> latencies (1.51 ms event-driven, 4.409 ms dense P=1) come from board passes
> 1-2 of 2026-08, before C0030 pipelined the event-driven sweep and C0035
> rebuilt the wrapper. The current measured figures are **688.5 us** for
> ED K=4 and **1,048.9 us** for dense P=4 at matched parallelism
> (docs/results_ledger.md section 1, fourteen board passes). Replace both
> rows with the matched-parallelism pair before this table goes in the
> thesis. Flagged 2026-09-20.

Old tally, retained for the record: (with FireFly-S and Spiker+ added 2026-09-20 from docs/references_verified.md: six of seven, the seventh unstated)
(Vivado report, with or without a simulation SAIF); the fifth (Minitaur)
gives idle/peak watts without stating the method on the pages read.
None reports energy measured at a board input. That is the column the
thesis's rows fill.

**The measured counterexample, not an FPGA row:** Nagy, Szabo, Toka,
"Analyzing Energy Consumption of Loihi 2 Neuromorphic Chip in a
Self-driving Use-case": Loihi 2 vs RTX 2080 Ti / 4090 / V100 on a
steering-prediction CNN-as-SNN via Lava; Loihi 2 reaches R^2 0.89 vs the
GPU's 0.94 at 3-3.5 W vs > 50 W (abstract). Power, not energy per
inference, and no FPGA -- cite for "measured on hardware" framing only.

## Comparability note (the trap, stated)

Harmeling's energy is **per digit**, where one digit is a 220-image spike
train — not comparable to a per-inference figure at T=4 without explicit
normalisation. Any cross-row comparison in a results chapter states its
normalisation in the caption or does not happen. Boundaries also differ
per row (die-only estimates vs whole-board measurement, C0004); the
"power obtained by" column is the honest axis.

## The gap, in the field's own words (C0022 addendum)

Harmeling et al. adopt synchronous processing on the strength of the
assumed tradeoff and close by leaving it open: "The event-driven approach
... is highly efficient when spikes are sparse, but becomes less
effective under dense or bursty activity. In such cases, synchronous
layer-by-layer processing is commonly adopted." and "...this suggests
that an event-based implementation could become advantageous when
activity is sufficiently sparse." A 2026 peer-reviewed statement that the
tradeoff this thesis measures is assumed, not measured — use it in the
introduction and related work.

## Neuron-model cost anchor (C0043)

Harmeling et al. Table 4 (after Koravuna et al.), per-neuron Artix-7
cost: LIF 13 LUT / 17 FF / 0 DSP; SRC 75/21/0; QIF 82/21/0; Izhikevich
42/25/1; Hodgkin-Huxley 73/25/3. Quantitative justification for the LIF
choice — and the balancing acknowledgement that SRC preserves dynamics
LIF discards.

---

## Throughput per synapse: how our engines compare with the published designs

Added 2026-09-20. **Why this section exists:** every latency in the table above
belongs to a different network on a different fabric at a different clock, so
the raw milliseconds cannot be compared. The fabric-independent measure is the
**synaptic operation** -- one weight accumulated into one neuron -- and the
question is how many of those a design retires per clock cycle. That number
says how much parallelism the design extracts, independently of how big its
chip is or how fast its clock runs.

### Ours, computed exactly

C1 on N-MNIST: 4,624 output neurons, 18 taps each (a 3x3 kernel over 2 input
channels), T = 4 timesteps. The dense engine evaluates **332,928** accumulates
per inference, whether or not the input spiked. The event-driven engine
evaluates only what fired: 1,256 spikes x a 2x2 output block x 16 channels =
**80,384**, which is 24 % of the dense work for the same output.

| engine | cycles per inference | synaptic ops per cycle | at 100 MHz |
|---|---|---|---|
| dense P = 1 | 369,924 | 0.90 | 0.09 GSOP/s |
| dense P = 4 | 92,484 | **3.60** | 0.36 GSOP/s |
| dense P = 16 | 23,124 | 14.40 | 1.44 GSOP/s |
| event-driven K = 4 | 67,756 | 1.19 useful (4.91 dense-equivalent) | 0.12 GSOP/s useful |
| event-driven K = 16 | 50,822 | 1.58 useful (6.55 dense-equivalent) | 0.16 GSOP/s useful |

Dense cycle counts are post-C0054 (`(N/P) x T x (9 C_IN + 2) + 4`, derived and
verified exact at every P). "Dense-equivalent" counts the accumulates the
event-driven engine *avoided*: it is the fair number when comparing against a
design that evaluates everything, and the reason the two columns differ by 4x
is the 24 % activity of this data.

### The published designs, read from the papers (2026-09-20)

All seven papers were read. "SOP/cycle" is synaptic operations per clock cycle,
computed from each paper's own reported figure where one exists.

| work | fabric / clock | SOP per cycle | how obtained |
|---|---|---|---|
| **Cerebron** (TVLSI 2022) | XC7Z100, 200 MHz | **200.5** | its own 40.1 GSOP/s (Sec. V-D). **Caveat: the paper never states T**, so this cannot be normalised per timestep |
| **Spiker+** (TETC 2025) | **XC7Z020, 100 MHz -- our fabric and clock** | **130** dense-equivalent | derived: 784-128-10 = 101,632 synapses x 100 timesteps / 78,000 cycles (Table I p.9, Sec. VI-A) |
| **Cheng et al.** (TCAS-I 2025) | ZCU104, 250 MHz | **12.9** | its own 3.22 GSOP/s measured (Table IV). No per-inference latency is stated anywhere in the paper |
| **ours, dense P = 16** | XC7Z020, 100 MHz | 14.4 | derived and verified |
| **ours, event-driven K = 4** | XC7Z020, 100 MHz | **4.91** dense-equivalent (1.19 useful) | derived and verified |
| **ours, dense P = 4** | XC7Z020, 100 MHz | **3.60** | derived and verified |
| **Minitaur** (TVLSI 2014) | Spartan-6 LX150, 75 MHz | **0.065** sustained, 0.25 peak | its own 4.88 M and 18.73 M post-synaptic updates/s (Table II). Sustained is 26 % of peak: fan-out of 32 cannot fill 32 cores |
| FireFly-S (TCAS-I 2025) | KV260, 333 MHz | not stated | throughput only (10,047 FPS MNIST); inter-layer pipelined, so 1/FPS is an issue interval, not a latency |
| FireFly-P (arXiv 2026) | Cmod A7-35T, 200 MHz | not stated | frames per second only |
| Li et al. (TCAS-I 2021) | VC707, 100 MHz | not computable | no spike-train length, no spike count, no SOP figure |

### Three things the papers corrected in our own table

1. **Our FireFly-P row conflated two separate experiments.** The 8 us
   end-to-end latency belongs to a *continuous-control* network of 128 hidden
   neurons on Brax tasks (Sec. IV-A/B); the 784-1024-10 MNIST network is a
   different experiment whose result is **32 FPS = 31.25 ms per image,
   including learning** (Table II). The impossible 508 accumulates per cycle
   that this section previously flagged was our error, not the paper's.
2. **FireFly-S's abstract misstates its own units.** It reports "10,047 FPS/W
   on MNIST, 3,683 FPS/W on DVS-Gesture, 2,327 FPS/W on CIFAR-10". Dividing
   each by the power in its Table VI gives 7,722.5, 2,022.5 and 612.5, which
   are the table's FPS/W column -- so the abstract's numbers are FPS and the
   label is wrong. Cite the table, not the abstract.
3. **Li et al.'s "0.028 uJ/synapse/image" is energy per *static* synapse**,
   5.04 mJ over the 177,800 weights of 784-200-100-10, not energy per synaptic
   operation. It cannot be inverted to recover a throughput.

### The reporting finding, now with all seven papers read

Of the seven published designs, **three report enough to compute throughput
per synapse** (Cerebron, Cheng, Minitaur) and a fourth is derivable because it
states its topology and timestep count (Spiker+). Three do not: FireFly-P and
FireFly-S give frames per second for pipelined architectures where that is an
issue interval rather than a latency, and Li et al. omit the spike-train
length entirely.

And **every one of the seven power figures is a tool estimate or has no stated
provenance**: FireFly-P, FireFly-S, Cheng and Li name Vivado (the last two
with a SAIF from post-layout simulation); Cerebron and Minitaur state a
wattage with no method given anywhere in the paper. Not one is externally
instrumented. That is the same gap in the throughput column as in the power
column, and it is the gap this thesis exists to close.

### What this comparison does and does not say

- Our dense engine at P = 4 retires 3.6 accumulates per cycle, against 130 for
  Spiker+ on **the same XC7Z020 at the same 100 MHz**. That is a factor of 36,
  and it is not a claim of competitive throughput -- it is a measurement of a
  deliberate design choice.
  The engine does one tap per cycle per lane with no multipliers at all (DSP =
  0 by construction, because a spike is one bit and a synapse is an add), on
  the smallest Zynq part, at 100 MHz.
- The thesis claim is a controlled comparison between two datapaths on one
  fabric, not a fast accelerator. The right reading of the table above is that
  both of our engines sit in the same order of magnitude as Minitaur, the one
  comparable event-driven FPGA design, and one to two orders below the
  large-fabric accelerators -- which is what a 53k-LUT part at 100 MHz with no
  DSPs should do.
- **Why Spiker+ extracts 36x more per cycle, from its own architecture
  section.** It states that it "exploits only one dimension to obtain
  parallelism, concurrently updating all neurons within a layer while
  sequentially providing inputs to each neuron", and that it "expects all
  neurons to access their respective weights in parallel ... therefore it
  strongly relies on the high parallelism provided by on-board BRAMs". Three
  things follow, and only the first is a free choice:
  1. **Its neuron state fits in flip-flops.** 128 hidden neurons; the design
     reports 3,298 registers, and 138 neurons x 16 bits is about 2,200 of
     them. Registers are all writable in the same cycle. Our C1 has 4,624
     neurons = 74 kbit of membrane state, which must live in block RAM, and a
     block RAM has one write port. **Our entire K/P banking scheme exists to
     buy write ports**: each bank is one more port. Their parallelism is free;
     ours is purchased a bank at a time.
  2. **Fully connected versus convolutional.** In an FC layer every input
     reaches every neuron, so "one input per cycle, all neurons in parallel"
     leaves nothing idle. In a stride-2 3x3 convolution an input reaches a 2x2
     block across the output channels -- 64 of our 4,624 neurons -- so that
     schedule does not transfer. Their strategy is the right one for their
     layer and is not available for ours.
  3. **Our P = 4 is a comparison choice, not a hardware limit.** It matches
     the event-driven bank count K so that the two engines get the same
     parallel hardware. At P = 16 we retire 14.4 per cycle. A more parallel
     dense engine would move the crossover further left, in the same direction
     the C0054 tail fix already moved it.
- Both designs avoid multipliers for the same reason: a binary spike times a
  weight is a select, which Spiker+ describes as "a bitwise AND between the
  weight and the spike". Both report DSP = 0.
- Their reported accuracy needs care: the hardware figure is 93.85 % against a
  96.83 % software model (Table I, p. 9), a 3 pp implementation drop the
  headline does not foreground.
- Comparing across rows is unsound for a second reason beyond throughput:
  precision differs (1-bit activations here, 4- to 16-bit elsewhere), the
  networks differ (one conv layer here, fully-connected elsewhere), and
  event-driven designs' work is data-dependent while clock-driven work is not.

On method: analytical cycle models of this kind are standard practice for
FPGA neural-network accelerators rather than something invented here; the
canonical reference is Zhang et al., FPGA 2015,
https://doi.org/10.1145/2684746.2689060, which introduced the roofline-based
analytical model for this purpose. Our model is far simpler because our engine
is far simpler.
