deestroy/snn_parkour_fgpa/docs/thesis_tables/rtl_inventory.md

# RTL inventory

Generated by make_tables.py (line counts from hdl/; roles hand-maintained in the script). Generated baked variants come from sim/gen_weight_vh.py and are checked against the tracked npz by sim/check_baked_weights.py.

| file | lines | group | role | on silicon |
|---|---|---|---|---|
| hdl/common/lif_neuron.v | 50 | common | M2 single-neuron wrapper around lif_update for the neuron testbench | no (sim only) |
| hdl/common/lif_update.v | 39 | common | the shared combinational LIF core (leak shift, pending subtract, compare) | yes (in every engine) |
| hdl/dense/axis_conv.v | 286 | wrapper | AXI-Stream wrapper: framing, ENGINE select, tick counter, replication | yes |
| hdl/dense/axis_conv_top.v | 99 | wrapper | top: DATASET -> geometry/threshold localparams, engine instance | yes |
| hdl/dense/conv_layer.v | 236 | dense | M3 dense layer, P = 1 (superseded by conv_layer_p for silicon) | pass 1-2 only |
| hdl/dense/conv_layer_c1.v | 529 | dense | P = 1 baked variant (historical) | no |
| hdl/dense/conv_layer_p.v | 304 | dense | dense engine, P lanes, weight ROM, membrane and output-word banks | yes |
| hdl/dense/conv_layer_p_c1.v | 594 | dense | conv_layer_p with the N-MNIST C1 weights baked in (generated) | yes |
| hdl/dense/conv_layer_p_g1.v | 594 | dense | conv_layer_p with the DVS-Gesture C1 weights baked in (generated) | yes |
| hdl/dense/conv_layer_p_r1.v | 594 | dense | conv_layer_p with the robot C1 weights baked in (generated) | no (sim) |
| hdl/dense/conv_layer_r1.v | 526 | dense | P = 1 baked variant, robot (historical) | no |
| hdl/dense/fc_layer.v | 164 | dense | dense FC layer (simulation, C0015) | no (sim) |
| hdl/eventdriven/ed_conv_layer.v | 268 | event-driven | ED engine: address list, scatter control, two-beat sweep pipeline, output words | yes |
| hdl/eventdriven/ed_fc_layer.v | 212 | event-driven | event-driven FC layer (D0023; simulation, C0015) | no (sim) |
| hdl/eventdriven/ed_iface_shim.v | 119 | event-driven | testbench shim presenting the scatter unit as a layer | no (sim only) |
| hdl/eventdriven/ed_scatter.v | 243 | event-driven | scatter unit: spike decode, weight-column fetch, K bank adders | yes |
| hdl/eventdriven/ed_scatter_c1.v | 539 | event-driven | ed_scatter with the N-MNIST C1 weights baked in (generated) | yes |
| hdl/eventdriven/ed_scatter_g1.v | 533 | event-driven | ed_scatter with the DVS-Gesture C1 weights baked in (generated) | yes |
| hdl/eventdriven/ed_scatter_r1.v | 533 | event-driven | ed_scatter with the robot C1 weights baked in (generated) | no (sim) |

Total: 6462 lines.
