deestroy/snn_parkour_fgpa/experiments/figures/diagrams/README.md

# Block diagrams

Schematics for Chapters 1, 2, 4 and 5, generated by
`python3 experiments/figures/make_diagrams.py`. Each one is written as
`.svg` (edit this, in Inkscape or Illustrator) and `.png` (for quick
viewing and for pasting into notes).

These carry **no measured data**, unlike `../make_figures.py`: nothing here
needs regenerating when a result changes. Numbers that do appear are labels,
and each says where it comes from. To change a drawing, edit the code, not
the file.

| file | what it shows | outline section |
|---|---|---|
| fig_system.svg | host, framed UART link, PS with the bare-metal server, DMA, AXIS wrapper, and the one engine the build selects | 4.1, 4.7 |
| fig_toolflow.svg | train to quantise to golden model to vectors to testbench to baked RTL to synthesis to board, with the check on every arrow | 4.1, 4.8, 5.6 |
| fig_paradigms.svg | clock-driven vs event-driven side by side, with where each one's cost comes from | 2.2 |
| fig_dense_datapath.svg | P lanes, weight ROM, shared LIF core, per-lane membrane and output banks | 4.4 |
| fig_ed_datapath.svg | address list, scatter unit, K banks, two-beat sweep, word-parallel output, and the three cost terms | 4.5 |
| fig_bank_interleave.svg | why channel interleaving is conflict-free for a stride-2 3x3 fan-out | 4.6 |
| fig_lif_core.svg | the shared LIF core and the three details that are load-bearing for bit-exactness | 4.2, 5.2 |
| fig_measurement_boundary.svg | the 12 V input, the shunt, the regulators, and the gap between what the meter sees and what the tool estimates | 1.1, 4.9, 6.5 |
| fig_verification_flow.svg | one golden reference, four consumers, and the baked-weight provenance check | 4.8, 5.6 |
| fig_perception_loop.svg | the 10 Hz control period, the encoder's share of it, and what a missed deadline does | 4.10, 6.8 |

Still to draw (in the outline's figure plan): the Zynq-7020 block diagram
from the vendor reference, the network diagram with per-layer shapes, the
wrapper's internals, the link frame format and command sequence, the
event-simulation pipeline on one real frame, and the event-driven timeline
at two activities (which needs per-phase counters the testbench does not
emit yet). The metering section also wants a photograph of the bench and a
timing diagram of the idle / BURST / idle windows.
