deestroy/snn_parkour_fgpa/measure/metering_prereg_2026-09-19.md

# Pre-registration: the M5 metering session (written 2026-09-19, before any instrument is connected)

Written so the energy result cannot be shaped after the fact (CLAUDE.md
M7: "Do not tune the experiment to produce a preferred answer"; C0001-
C0004, C0013, C0018, C0038). Everything below is fixed now; deviations
during the session are recorded as deviations. Procedure details live in
`measure/dmm_protocol.md`; arithmetic and flags in `measure/manual_meter.py`
(`--selftest`), `measure/protocol.py` (`--mock`).

## 1. Instrument and wiring (decided)

- **Primary:** 0.1 ohm shunt in the +12 V lead via a barrel-jack breakout,
  meter in DC-mV mode across the shunt (200 mV range). At ~0.6 A the
  drop is ~60 mV; a 4.5-digit meter resolves 0.01 mV = 0.1 mA. Nothing
  in the supply path depends on the meter's range switch.
- **Fallback:** meter in series on its fused 10 A jack, only if it is a
  bench unit with <= 0.1 mA resolution on that range; handheld 10 mA
  resolution CANNOT resolve a single engine (see 4) and is recorded as
  such, which is the case for the INA226 (C0002).
- Supply voltage read at the barrel with the meter in V mode, once per
  session, before wiring the shunt; P = V_barrel x I; shunt loss
  (I^2 x 0.1 ohm, ~36 mW at 0.6 A) noted, not subtracted from the delta
  (it cancels in idle-minus-run to first order).
- Board thermal settling: 60 s after boot before the first idle reading;
  die temperature from the server's PING/BURST reply logged with every run.

## 2. Bitstreams and samples (the experiment matrix, in this order)

| # | bitstream | archive tag | why |
|---|---|---|---|
| 1 | ED K=4, N_ENGINES=8, N-MNIST | ed_k4_x8_20260917_2251 | the resolvable delta (C0003) |
| 2 | dense P=4, N_ENGINES=8, N-MNIST | dense_p4_x8_20260917_2312 | its dense pair |
| 3 | ED K=4, N=1, N-MNIST (C0044 build) | ed_k4 (2026-09-18) | the per-engine number, if resolvable |
| 4 | dense P=4, N=1, N-MNIST | dense_p4_20260906 | its pair |
| 5 | ED K=4, DATASET=1 (DVS-Gesture) | ed_k4_dvsg_20260919_1324 | the per-clip activity crossover in ENERGY |
| 6 | dense P=4, DATASET=1 | (rebuilding 2026-09-19) | its pair |
| 7-8 | ED K=8 / dense P=8, N-MNIST | ed_k8_20260917_2106 / dense_p8_20260917_2221 | the parallelism crossover in energy, if time |
| 9 | ED K=4, DATASET=1, **N_ENGINES=4** (x8 does not fit: g1 ED engine 21 BRAM tiles) | ed_k4_dvsg_x4_20260920_0010 (pass 13, 8/8) | resolvable DVS-Gesture ED delta; per-engine = delta / 4 |
| 10 | dense P=4, DATASET=1, **N_ENGINES=2** (N=4 does not place: 65k decoded-enable output flops, addendum 7c) | dense_p4_dvsg_x2_20260920_1127 (pass 14, 8/8, per-clip latency = N=1) | its pair; per-engine = delta / 2 |

Samples: the 16 N-MNIST check samples (BURST sweep over all 16 = the
mean over the set) and the 8 DVS-Gesture clips. For #5-6 each clip is
ALSO metered alone (single-sample BURST, C0018), so energy per inference
is a per-clip number and the ~30 % crossover can be tested in energy.
BURST length N sized to 15-30 s per window (N-MNIST ED K=4 ~12,000 x 688.5
us = 8.3 s -> use N = 24,000; dense P=4 N = 16,000; DVS-Gesture ED N =
6,000, dense N = 5,000; x8 builds same per-engine latency, same N).

## 3. Repeats and statistics (C0013)

- Per (bitstream, sample set): **3 runs**, each idle-before (5 readings, 5 s
  apart) -> BURST window (5 readings spread over it) -> idle-after (5).
- Energy per inference = V x (I_run - I_idle) x elapsed / N with the SEM
  from the readings; a run is flagged if |idle_after - idle_before| exceeds
  the delta (drift) or if the delta is < 3 SEM (unresolvable). Flagged runs
  are reported, not dropped.
- Report mean +- SEM over the 3 runs; intervals on every energy figure.
- Order randomised within the session (coin flip per pair which engine
  goes first) so thermal history is not confounded with the engine.

## 4. Predictions (from the cycle model x the tool's power estimate)

Tool estimate for ED K=4 (design_1_wrapper_power_routed.rpt, 2026-09-06):
fabric dynamic ~49 mW (clocks 16 / logic 7 / signals 10 / BRAM 16),
static 144 mW, PS7 1.533 W, total 1.727 W. Dense P=4 has no saved
report yet (requested from the board session 2026-09-19); its fabric
estimate is expected in the same tens-of-mW band.

- **P1 (resolvability).** Single engine: 49 mW fabric = 49 mW x 688.5 us
  = **34 uJ/inference** predicted from the tool; at 12 V and ~85 %
  regulator efficiency that is a **~4.8 mA** input delta -- resolvable
  with the shunt + mV method (0.1 mA), NOT with a handheld ammeter.
  x8 builds: ~390 mW, ~38 mA -- resolvable either way.
- **P2 (the sign of the crossover in energy at K=P=4, N-MNIST).** If
  energy per cycle is the same for both engines, ED wins by the latency
  ratio 1.52x. The event-driven engine has more state switching per
  cycle (K banks, FIFO, word file), so I predict the measured energy
  ratio is BELOW 1.52x: **ED wins, but by 1.1-1.4x**, not 1.52x. A ratio
  above 1.52x or below 1.0x falsifies this.
- **P3 (the estimate-measurement gap).** The tool's fabric number will
  be within a factor of 2 of the measured delta per engine
  (0.5x-2x). Outside that band is itself the C0001 result.
- **P4 (DVS-Gesture per clip).** The energy crossover sits at the same
  clips as the latency one (clips 1 and 5 lose to dense) if P2's
  energy-per-cycle penalty is under ~25 %; if the penalty is larger, one
  more clip (4, at 20.8 % density, 1.25x latency) flips to dense.
- **P5 (x8 vs x1).** Per-engine energy from the x8 build equals the x1
  number within the x1 interval (replication does not change the
  engine's cost; C0003's premise). If x8 per-engine is > 20 % below x1,
  the x1 delta was dominated by something other than the engine.
- **P6 (idle).** Idle board current 0.4-0.6 A at 12 V (PS7 + DDR +
  regulators), the same to within 2 % across bitstreams; if idle differs
  between ED and dense bitstreams by more than the engine delta, static/
  clock-tree differences are real and must be reported separately (C0038
  quantity 2 vs 3).

## 5. What is reported (C0038: never merge the three quantities)

1. System energy per inference (12 V input delta x time / N) -- the
   deployment number.
2. Engine (fabric) delta: the same measurement minus nothing else --
   stated as the delta it is; per-engine = x8 delta / 8.
3. The tool's estimate beside each, and measured/estimate as its own
   column.
Plus, per the brief's metrics rule on every table: latency, mean power,
LUT/FF/BRAM/DSP, firing rate per layer, accuracy, sim-or-board.

## 6. Session log template

Date/time, meter make/model/range, shunt value, V_barrel, room and die
temperature, bitstream tag and PING build/dataset, N, elapsed, the 15
readings per run, flags. One `measure/runs/<timestamp>_<label>.json` per
run from `manual_meter.py`; the session summary table goes in
`experiments/metering_<date>.md` next to this pre-registration.

## 7. Revision 2026-09-19 15:00 -- the tool estimates arrived (before any measurement)

The board session committed routed power reports for seven builds
(experiments/power_estimates/README.md, commit 732905e; report_power,
default vectorless, same setting for all). Fabric = clocks + logic +
signals + BRAM (DSP 0); PS7 1.533 W in every build:

| build | fabric mW | total W | tool energy per inference (fabric x engine latency) |
|---|---|---|---|
| ED K=4 N=1 (C0044) | 48 | 1.724 | 33.0 uJ |
| ED K=4 x8 | 241 (30.1 per engine) | 1.933 | 20.7 uJ per engine |
| dense P=4 x8 | 501 (62.6 per engine) | 2.196 | 65.7 uJ per engine |
| ED K=8 | 54 | 1.731 | 31.1 uJ |
| dense P=8 | 83 | 1.761 | 44.8 uJ |
| ED K=4 DVS-Gesture | 72 | 1.750 | 214 uJ |
| dense P=4 DVS-Gesture | 135 | 1.814 | ~499 uJ (latency predicted 3,697 us) |
| dense P=4 N=1 N-MNIST (rev 3, 2026-09-19 23:23, commit 48b2d62) | 73 (clocks 21 / logic 13 / signals 26 / BRAM 13) | 1.750 | 76.6 uJ |

What this changes and what it does not:
- **P1 revised numerically, not in kind:** single ED engine ~48 mW ->
  ~4.7 mA at 12 V / 0.85; ED x8 ~24 mA; dense x8 ~49 mA. Shunt + mV
  still required for N=1; both x8 builds resolvable by any bench meter.
- **P2 stands as MY prediction, and the tool disagrees with it.** The
  tool says the dense engine burns ~2.1x the ED engine's fabric power
  (62.6 vs 30.1 mW per engine) on top of being 1.52x slower, i.e. a
  tool-predicted energy ratio of **3.2x** in ED's favour at K=P=4. My
  P2 (1.1-1.4x) assumed the opposite sign of the per-cycle difference.
  Both are now on record before the meter; the meter adjudicates. If
  the measured ratio is >= 2x, the tool's ranking is right and my
  physical intuition about the ED engine's state switching was wrong;
  if it is 1.0-1.5x, the tool over-estimates dense switching (its
  vectorless activity cannot see that the dense datapath's inputs are
  mostly zeros).
- **New P7 (parallelism crossover in energy):** the tool predicts ED
  STILL wins energy at K=P=8 (31.1 vs 44.8 uJ, 1.44x) although it loses
  latency there (0.939x). So the tool places the energy crossover
  beyond K=P=8, the latency crossover between 4 and 8. Measuring
  builds 7-8 tests this directly; if the measured K=P=8 energy ratio is
  below 1.0x, the crossovers coincide.
- **New P8 (DVS-Gesture):** tool ratio 2.3x in ED's favour on the mean;
  per clip, the two densest clips lose to dense in latency by 1.27x /
  1.11x, so under the tool's 2.1x per-cycle advantage ED would still
  win ENERGY on every clip. My P4 (energy crossover at the same clips
  as latency) therefore contradicts the tool as well; recorded as such.
- P3, P5, P6 unchanged. The x8 fabric numbers also give the fixed
  wrapper/DMA share: 48 - 30 = ~18 mW of the N=1 ED estimate is not the
  engine; this is why per-engine energy is quoted from the x8 delta.

### 7a. Addendum 2026-09-19 23:30 -- the single-engine dense estimate

dense P=4 N=1: fabric 73 mW -> 73 x 1,048.9 us = **76.6 uJ**; against ED
K=4 N=1's 33.0 uJ the tool's single-engine ratio is **2.3x** (the x8-derived
per-engine ratio is 3.2x; the difference is the fixed wrapper/DMA share,
~10 mW on the dense build and ~18 mW on the ED build, which dilutes the
N=1 ratio). P1 for the dense single engine: ~7.2 mA at 12 V / 0.85.
Nothing else in section 7 changes: the tool still predicts ED wins energy
at K=P=4 by 2.3x (N=1) to 3.2x (per engine from x8); my P2 (1.1-1.4x)
stands as the contrary prediction.

### 7b. Addendum 2026-09-20 00:05 -- offsets decomposed; DVS-Gesture replication at N = 4

- The board-minus-sim "offsets" quoted in sections 4 and 7 (92.9 us ED,
  102.0 us dense on DVS-Gesture) were a comparison-basis artefact: the
  per-engine sim column excluded 6.3k-8.2k wrapper cycles. Against the
  wrapper-inclusive harness totals (experiments/dvsgesture/latency_sim/
  axis_total/, b85ec60) the board sits at ED +29.4 us and dense +20.0 us,
  constant. From now on board latencies are compared to wrapper-inclusive
  totals; the energy predictions above used measured board latencies, so
  they are unaffected.
- The DVS-Gesture replicated builds are N_ENGINES = 4, not 8 (matrix rows
  9-10 added); per-engine energy from them is delta / 4. Predicted input
  delta at 12 V / 0.85: ED ~4 x 72 mW -> ~28 mA (upper bound; the N=1
  figure includes the fixed wrapper share), dense ~4 x 135 mW -> ~53 mA.

### 7c. Addendum 2026-09-20 11:40 -- row 9 on silicon; row 10 drops to N = 2

- Row 9 (ED K=4 DVS-Gesture, N_ENGINES = 4) is on silicon: pass 13, 8/8
  clips, every per-clip latency equal to the N = 1 pass to 0.1 us, 86 BRAM
  tiles, WNS +0.119 ns, Vivado estimate 1.926 W total (record:
  experiments/dvsgesture/board_ed_k4_x4_20260920.md). The equal per-clip
  latency is what the matrix assumed (same BURST N as row 5).
- Dense P=4 DVS-Gesture at N = 4 does NOT place ("Placer could not place
  all instances": ~65k decoded-enable output flops), so row 10 is built at
  **N_ENGINES = 2**. Consequences, fixed before the meter:
  - per-engine dense energy = delta / 2, and the predicted input delta
    halves: ~2 x 135 mW -> ~26 mA at 12 V / 0.85, i.e. about the same size
    as the ED x4 delta (~28 mA). Both sit well above the 0.1 mA resolution,
    so the DVS-Gesture pair is still resolvable; what is lost is the
    4x-vs-4x symmetry, not the measurement.
  - P8 (DVS-Gesture tool ratio 2.3x in ED's favour) is unchanged: it is a
    per-engine ratio, and the fixed wrapper share is removed by the
    N = 1 subtraction in both cases (section 7a).
  - The dense engine's inability to replicate is itself a resource fact
    for the thesis (the dense g1 layer at 7.3k LUT / 17k FF per engine does
    not fit four times on the XC7Z020 beside the ED engine's memory need),
    to be quoted next to the fabric-fit rows of docs/results_ledger.md.
- Not yet on silicon: row 10 (N = 2 build in progress on the VM). Its
  numbers will be added here when the peer session reports them.

### 7d. Addendum 2026-09-20 12:10 -- row 10 built; DVS-Gesture per-engine tool numbers; strategy spread

Row 10 (6e55859, experiments/power_estimates/): dense_p4_dvsg_x2_20260920_1127,
N_ENGINES = 2, WNS +0.842 / WHS +0.028, 21 BRAM tiles, estimate 1.956 W
total, fabric 270 mW. On silicon 2026-09-20 (pass 14, 37ecf79): 8/8 bit-identical,
3,706.4-3,706.5 us on every clip and the sweep, equal to N = 1. All ten
matrix rows now have a bitstream on silicon.

**Per-engine tool estimates by replication subtraction (section 7a
method, fabric mW), written down before the meter:**

| build | N=1 fabric | replicated fabric | per engine | x board latency (mean) | tool energy per inference |
|---|---|---|---|---|---|
| ED K=4 DVS-Gesture | 72 | 236 (x4) | (236-72)/3 = 54.7 mW | 2,970.8 us | 162 uJ |
| dense P=4 DVS-Gesture | 135 | 270 (x2) | (270-135)/1 = 135.0 mW | 3,706.5 us | 500 uJ |

- The dense x2 subtraction says the whole 135 mW N=1 figure is engine, i.e.
  the tool assigns the wrapper ~0 mW on the dense build, while the ED x4
  subtraction assigns the wrapper 72 - 54.7 = 17.3 mW. That
  asymmetry is a tool artefact (vectorless activity on a two-point fit),
  and one of the things the meter tests directly: the measured wrapper
  share should be the same number for both.
- **P8 restated per engine:** tool ratio dense/ED = 3.08x in
  ED's favour at the mean clip (was 2.3x on the N=1 figures). My contrary
  prediction P2 (1.1-1.4x measured) is unchanged.
- **Strategy spread (C0019 variants, same RTL, N-MNIST N=1):** ED K=4
  fabric 48 / 57 / 50 mW (default / Performance_Explore /
  Congestion_SpreadLogic_high), dense P=4 73 / 73 / 76 mW. The estimate
  moves ~9 mW (19 %) on ED and ~3 mW (4 %) on dense from placement alone.
  **P9 (new, pre-registered):** the measured fabric delta across the three
  ED bitstreams differs by less than the measured-vs-estimated gap of any
  one of them; if it does not, the "tool gap" is partly a placement effect
  and the thesis must say so. Optional rows 11-13 (the three ED variants,
  x8 not needed if the N=1 delta resolves) -- run only after rows 1-10.

### 7e. Notation note added 2026-09-20 (no change to anything pre-registered)

This file uses `N` for two different things, both of which the thesis renames
so that `N` can mean the cycle model's output-neuron count and nothing else:

| here | thesis | meaning |
|---|---|---|
| `N_ENGINES`, and "N = 4 / 8" in prose | **R** | engine copies per bitstream (the Verilog parameter keeps the name `N_ENGINES`) |
| "BURST length N", e.g. N = 24,000 | **B** | how many times one sample is replayed inside a measurement window |

Nothing in sections 1-7d changes; this is a reading key. See docs/notation.md.
