deestroy/snn_parkour_fgpa/docs/references_verified.md

# Verified references for thesis Chapters 2-3

Generated 2026-09-20 by checking every work named informally in the
Chapter 2, Chapter 3 and "References" entries of `docs/thesis_outline_build.py`
against publisher pages, Crossref/DataCite records, arXiv and the papers
themselves. Rules used:

- **VERIFIED** — a real work exists and the informal name (author / venue / year) matches it.
- **CORRECTED** — a real work exists but the informal name has a wrong author, venue or year; the correction is given.
- **NOT FOUND** — no matching work could be located (none in this pass).
- DOIs are given only where a Crossref/DataCite record or the publisher page confirmed them. Blank means unconfirmed, not absent.
- Author lists are truncated to the first author plus up to three more, then "et al.".
- Nothing here was recalled from memory alone: every row was checked against at least one online record during this session.

Companion file: `docs/references.bib` (one BibTeX entry per VERIFIED or CORRECTED row, key = firstauthorYEARkeyword).

## Table 1 — works named in the outline (Chapters 2, 3 and References)

| informal name as used in the outline | status | full citation | DOI / URL | note |
|---|---|---|---|---|
| Roy, Jaiswal and Raghunathan, Nature 2019 | CORRECTED | K. Roy, A. Jaiswal, P. Panda, "Towards spike-based machine intelligence with neuromorphic computing," *Nature*, vol. 575, no. 7784, pp. 607-617, 2019. | 10.1038/s41586-019-1677-2 | Third author is **Panda**, not Raghunathan. |
| Tavanaei et al. 2019 | VERIFIED | A. Tavanaei, M. Ghodrati, S. R. Kheradpisheh, T. Masquelier, A. Maida, "Deep learning in spiking neural networks," *Neural Networks*, vol. 111, pp. 47-63, 2019. | 10.1016/j.neunet.2018.12.002 | |
| Eshraghian et al., Proc. IEEE 2023 (also "snnTorch") | VERIFIED | J. K. Eshraghian, M. Ward, E. O. Neftci, X. Wang, et al., "Training spiking neural networks using lessons from deep learning," *Proc. IEEE*, vol. 111, no. 9, pp. 1016-1054, 2023. | 10.1109/JPROC.2023.3308088 | This is the snnTorch paper; cite it for both. |
| Rueckauer et al. 2017 | VERIFIED | B. Rueckauer, I.-A. Lungu, Y. Hu, M. Pfeiffer, S.-C. Liu, "Conversion of continuous-valued deep networks to efficient event-driven networks for image classification," *Front. Neurosci.*, vol. 11, art. 682, 2017. | 10.3389/fnins.2017.00682 | |
| Han et al. 2020 'RMP-SNN' | VERIFIED | B. Han, G. Srinivasan, K. Roy, "RMP-SNN: Residual membrane potential neuron for enabling deeper high-accuracy and low-latency spiking neural network," in *Proc. IEEE/CVF CVPR*, 2020, pp. 13555-13564. | 10.1109/CVPR42600.2020.01357 | |
| Norse | VERIFIED | C. Pehle, J. E. Pedersen, "Norse - A deep learning library for spiking neural networks," Zenodo, Jan. 2021. | 10.5281/zenodo.4422025 | Software citation (Zenodo), no paper. |
| SpikingJelly | VERIFIED | W. Fang, Y. Chen, J. Ding, Z. Yu, et al., "SpikingJelly: An open-source machine learning infrastructure platform for spike-based intelligence," *Science Advances*, vol. 9, no. 40, eadi1480, 2023. | 10.1126/sciadv.adi1480 | |
| Mahowald 1992 (AER) | VERIFIED | M. Mahowald, "VLSI analogs of neuronal visual processing: a synthesis of form and function," Ph.D. dissertation, California Institute of Technology, 1992. | 10.7907/4bdw-fg34 | DOI confirmed via DataCite. Thesis (chapter on the address-event "silicon optic nerve"). |
| Boahen 2000 | VERIFIED | K. A. Boahen, "Point-to-point connectivity between neuromorphic chips using address events," *IEEE Trans. Circuits Syst. II*, vol. 47, no. 5, pp. 416-434, 2000. | 10.1109/82.842110 | |
| TrueNorth, Merolla et al. Science 2014 | VERIFIED | P. A. Merolla, J. V. Arthur, R. Alvarez-Icaza, A. S. Cassidy, et al., "A million spiking-neuron integrated circuit with a scalable communication network and interface," *Science*, vol. 345, no. 6197, pp. 668-673, 2014. | 10.1126/science.1254642 | |
| Loihi, Davies et al. IEEE Micro 2018 | VERIFIED | M. Davies, N. Srinivasa, T.-H. Lin, G. Chinya, et al., "Loihi: A neuromorphic manycore processor with on-chip learning," *IEEE Micro*, vol. 38, no. 1, pp. 82-99, 2018. | 10.1109/MM.2018.112130359 | |
| SpiNNaker, Furber et al. 2014 | VERIFIED | S. B. Furber, F. Galluppi, S. Temple, L. A. Plana, "The SpiNNaker project," *Proc. IEEE*, vol. 102, no. 5, pp. 652-665, 2014. | 10.1109/JPROC.2014.2304638 | |
| Cerebron TVLSI 2022 | VERIFIED | Q. Chen, C. Gao, Y. Fu, "Cerebron: A reconfigurable architecture for spatiotemporal sparse spiking neural networks," *IEEE Trans. VLSI Syst.*, vol. 30, no. 10, pp. 1425-1437, 2022. | 10.1109/TVLSI.2022.3196839 | |
| FireFly (in 2.2 list) | VERIFIED | J. Li, G. Shen, D. Zhao, Q. Zhang, Y. Zeng, "FireFly: A high-throughput hardware accelerator for spiking neural networks with efficient DSP and memory optimization," *IEEE Trans. VLSI Syst.*, vol. 31, no. 8, pp. 1178-1191, 2023. | 10.1109/TVLSI.2023.3279349 | |
| Li TCAS-I 2021 (UESTC) | VERIFIED | S. Li, Z. Zhang, R. Mao, J. Xiao, L. Chang, J. Zhou, "A fast and energy-efficient SNN processor with adaptive clock/event-driven computation scheme and online learning," *IEEE Trans. Circuits Syst. I*, vol. 68, no. 4, pp. 1543-1552, 2021. | 10.1109/TCSI.2021.3052885 | |
| Sorbaro et al. 2020 | VERIFIED | M. Sorbaro, Q. Liu, M. Bortone, S. Sheik, "Optimizing the energy consumption of spiking neural networks for neuromorphic applications," *Front. Neurosci.*, vol. 14, art. 662, 2020. | 10.3389/fnins.2020.00662 | Also the "rate regularisation" cite in 2.6. |
| Davidson and Furber, Frontiers 2021 | VERIFIED | S. Davidson, S. B. Furber, "Comparison of artificial and spiking neural networks on digital hardware," *Front. Neurosci.*, vol. 15, art. 651141, 2021. | 10.3389/fnins.2021.651141 | |
| Yik et al. 2025 NeuroBench | VERIFIED | J. Yik, K. Van den Berghe, D. den Blanken, Y. Bouhadjar, et al., "The neurobench framework for benchmarking neuromorphic computing algorithms and systems," *Nature Communications*, vol. 16, art. 1545, 2025. | 10.1038/s41467-025-56739-4 | Title is lower-case "neurobench" in the journal. |
| Minitaur, Neil and Liu TVLSI 2014 | VERIFIED | D. Neil, S.-C. Liu, "Minitaur, an event-driven FPGA-based spiking network accelerator," *IEEE Trans. VLSI Syst.*, vol. 22, no. 12, pp. 2621-2628, 2014. | 10.1109/TVLSI.2013.2294916 | |
| Cheng TCAS-I 2025 (Fudan) | VERIFIED | X. Cheng, S. Cao, S. Wang, M. Wang, W. Li, X. Zeng, "An FPGA-based event-driven SNN accelerator for DVS applications with structured sparsity and early-stop," *IEEE Trans. Circuits Syst. I*, vol. 72, no. 7, pp. 3298-3310, 2025. | 10.1109/TCSI.2025.3560666 | Conference precursor: ISCAS 2024, 10.1109/ISCAS58744.2024.10558416. |
| Lichtsteiner, Posch and Delbruck 2008 | VERIFIED | P. Lichtsteiner, C. Posch, T. Delbruck, "A 128x128 120 dB 15 us latency asynchronous temporal contrast vision sensor," *IEEE J. Solid-State Circuits*, vol. 43, no. 2, pp. 566-576, 2008. | 10.1109/JSSC.2007.914337 | |
| Gallego et al. (TPAMI 2022) | VERIFIED | G. Gallego, T. Delbruck, G. Orchard, C. Bartolozzi, et al., "Event-based vision: A survey," *IEEE Trans. Pattern Anal. Mach. Intell.*, vol. 44, no. 1, pp. 154-180, 2022. | 10.1109/TPAMI.2020.3008413 | Online 2020, print issue Jan 2022; either year is defensible, print is 2022. |
| Lagorce et al. 2017 HOTS | VERIFIED | X. Lagorce, G. Orchard, F. Galluppi, B. E. Shi, R. Benosman, "HOTS: A hierarchy of event-based time-surfaces for pattern recognition," *IEEE Trans. Pattern Anal. Mach. Intell.*, vol. 39, no. 7, pp. 1346-1359, 2017. | 10.1109/TPAMI.2016.2574707 | |
| Zhu et al. 2019 (voxel grids) | VERIFIED | A. Z. Zhu, L. Yuan, K. Chaney, K. Daniilidis, "Unsupervised event-based learning of optical flow, depth, and egomotion," in *Proc. IEEE/CVF CVPR*, 2019, pp. 989-997. | 10.1109/CVPR.2019.00108 | The event voxel-grid representation is introduced here. |
| Guo et al. 2021 on coding schemes | VERIFIED | W. Guo, M. E. Fouda, A. M. Eltawil, K. N. Salama, "Neural coding in spiking neural networks: A comparative study for robust neuromorphic systems," *Front. Neurosci.*, vol. 15, art. 638474, 2021. | 10.3389/fnins.2021.638474 | Compares rate, TTFS, phase and burst coding; direct coding is in Kim 2022, not here. |
| Kim et al. 2022 rate vs direct coding | VERIFIED | Y. Kim, H. Park, A. Moitra, A. Bhattacharjee, Y. Venkatesha, P. Panda, "Rate coding or direct coding: Which one is better for accurate, robust, and energy-efficient spiking neural networks?," in *Proc. IEEE ICASSP*, 2022, pp. 71-75. | 10.1109/ICASSP43922.2022.9747906 | |
| Rebecq et al. 2018 ESIM | VERIFIED | H. Rebecq, D. Gehrig, D. Scaramuzza, "ESIM: an open event camera simulator," in *Proc. 2nd Conf. Robot Learning (CoRL)*, PMLR vol. 87, 2018, pp. 969-982. | https://proceedings.mlr.press/v87/rebecq18a.html | PMLR gives no DOI. |
| Hu et al. 2021 v2e | VERIFIED | Y. Hu, S.-C. Liu, T. Delbruck, "v2e: From video frames to realistic DVS events," in *Proc. IEEE/CVF CVPR Workshops*, 2021, pp. 1312-1321. | 10.1109/CVPRW53098.2021.00144 | |
| Orchard et al. 2015 (N-MNIST) | VERIFIED | G. Orchard, A. Jayawant, G. K. Cohen, N. Thakor, "Converting static image datasets to spiking neuromorphic datasets using saccades," *Front. Neurosci.*, vol. 9, art. 437, 2015. | 10.3389/fnins.2015.00437 | |
| Amir et al. CVPR 2017 (DVS-Gesture) | VERIFIED | A. Amir, B. Taba, D. Berg, T. Melano, et al., "A low power, fully event-based gesture recognition system," in *Proc. IEEE CVPR*, 2017, pp. 7243-7252. | 10.1109/CVPR.2017.781 | |
| Xilinx UG474 | VERIFIED | Xilinx, "7 Series FPGAs Configurable Logic Block User Guide (UG474)," v1.8, Sep. 2016. | https://docs.amd.com/v/u/en-US/ug474_7Series_CLB | Vendor document. |
| Xilinx UG473 | VERIFIED | Xilinx, "7 Series FPGAs Memory Resources User Guide (UG473)," v1.14, Jul. 2019. | https://docs.amd.com/v/u/en-US/ug473_7Series_Memory_Resources | Vendor document. |
| Xilinx UG907 | VERIFIED | Xilinx/AMD, "Vivado Design Suite User Guide: Power Analysis and Optimization (UG907)," (cite the version matching the Vivado release used, e.g. 2020.2, Nov. 2020). | https://docs.amd.com/r/en-US/ug907-vivado-power-analysis-optimization | Vendor document; state the version in the thesis. |
| Horowitz ISSCC 2014 | VERIFIED | M. Horowitz, "1.1 Computing's energy problem (and what we can do about it)," in *IEEE ISSCC Dig. Tech. Papers*, 2014, pp. 10-14. | 10.1109/ISSCC.2014.6757323 | Source of the DRAM-vs-MAC energy ratio. |
| Lee et al. Science Robotics 2020 | VERIFIED | J. Lee, J. Hwangbo, L. Wellhausen, V. Koltun, M. Hutter, "Learning quadrupedal locomotion over challenging terrain," *Science Robotics*, vol. 5, no. 47, eabc5986, 2020. | 10.1126/scirobotics.abc5986 | |
| Rudin et al. CoRL 2022 | CORRECTED | N. Rudin, D. Hoeller, P. Reist, M. Hutter, "Learning to walk in minutes using massively parallel deep reinforcement learning," in *Proc. 5th Conf. Robot Learning (CoRL 2021)*, PMLR vol. 164, 2022, pp. 91-100. | https://proceedings.mlr.press/v164/rudin22a.html | The conference is **CoRL 2021** (5th CoRL, London, Nov. 2021); the PMLR proceedings volume carries year 2022. Cite as CoRL 2021 / PMLR 164 (2022). |
| Cheng et al. 2023 (extreme parkour) | CORRECTED | X. Cheng, K. Shi, A. Agarwal, D. Pathak, "Extreme parkour with legged robots," in *Proc. IEEE ICRA*, 2024, pp. 11443-11450. | 10.1109/ICRA57147.2024.10610200 | Peer-reviewed venue is **ICRA 2024**; 2023 is the arXiv preprint (2309.14341). Cite the ICRA version. |
| Zhuang et al. 2023 (robot parkour learning) | VERIFIED | Z. Zhuang, Z. Fu, J. Wang, C. Atkeson, et al., "Robot parkour learning," in *Proc. 7th Conf. Robot Learning (CoRL)*, PMLR vol. 229, 2023, pp. 73-92. | https://proceedings.mlr.press/v229/zhuang23a.html | |
| ES-Parkour (Zhang et al., ICME 2025) | VERIFIED | Q. Zhang, J. Cao, J. Sun, Y. Shao, et al., "ES-Parkour: Advanced robot parkour with bio-inspired event camera and spiking neural network," in *Proc. IEEE Int. Conf. Multimedia and Expo (ICME)*, 2025, pp. 1-6. | 10.1109/ICME59968.2025.11209556 | DOI in the outline resolves in Crossref to this paper. arXiv 2503.09985. |
| Guerra-Hernandez et al. 2017 | VERIFIED | E. I. Guerra-Hernandez, A. Espinal, P. Batres-Mendoza, C. H. Garcia-Capulin, et al., "A FPGA-based neuromorphic locomotion system for multi-legged robots," *IEEE Access*, vol. 5, pp. 8301-8312, 2017. | 10.1109/ACCESS.2017.2696985 | Spartan-6; biped, quadruped and hexapod CPGs. |
| Sengupta 2019 | VERIFIED | A. Sengupta, Y. Ye, R. Wang, C. Liu, K. Roy, "Going deeper in spiking neural networks: VGG and residual architectures," *Front. Neurosci.*, vol. 13, art. 95, 2019. | 10.3389/fnins.2019.00095 | |
| Neftci, Mostafa and Zenke 2019 | VERIFIED | E. O. Neftci, H. Mostafa, F. Zenke, "Surrogate gradient learning in spiking neural networks: Bringing the power of gradient-based optimization to spiking neural networks," *IEEE Signal Process. Mag.*, vol. 36, no. 6, pp. 51-63, 2019. | 10.1109/MSP.2019.2932551 | |
| Wu et al. 2018 STBP | VERIFIED | Y. Wu, L. Deng, G. Li, J. Zhu, L. Shi, "Spatio-temporal backpropagation for training high-performance spiking neural networks," *Front. Neurosci.*, vol. 12, art. 331, 2018. | 10.3389/fnins.2018.00331 | |
| Jacob et al. 2018 | VERIFIED | B. Jacob, S. Kligys, B. Chen, M. Zhu, et al., "Quantization and training of neural networks for efficient integer-arithmetic-only inference," in *Proc. IEEE/CVF CVPR*, 2018, pp. 2704-2713. | 10.1109/CVPR.2018.00286 | |
| Putra and Shafique 2021 'Q-SpiNN' | VERIFIED | R. V. W. Putra, M. Shafique, "Q-SpiNN: A framework for quantizing spiking neural networks," in *Proc. Int. Joint Conf. Neural Networks (IJCNN)*, 2021. | 10.1109/IJCNN52387.2021.9534087 | |
| Brevitas | VERIFIED | A. Pappalardo, G. Franco, N. J. Fraser, et al., "Xilinx/brevitas," Zenodo. | 10.5281/zenodo.3333552 | Software citation (Zenodo concept DOI); cite the version used. |
| Pellegrini et al. 2021 (low-activity SNNs) | VERIFIED | T. Pellegrini, R. Zimmer, T. Masquelier, "Low-activity supervised convolutional spiking neural networks applied to speech commands recognition," in *Proc. IEEE Spoken Language Technology Workshop (SLT)*, 2021, pp. 97-103. | 10.1109/SLT48900.2021.9383587 | |
| Harmeling NCE 2026 | VERIFIED | P. Harmeling, F. De Geeter, G. Drion, "Energy-efficient implementation of spiking recurrent cells on FPGA," *Neuromorphic Computing and Engineering*, vol. 6, no. 2, art. 024022, 2026. | 10.1088/2634-4386/ae759c | Artix-7 XC7A200T, 100 MHz, MNIST 96.31 %, Vivado post-implementation power 1.13 W incl. HUB75 display -- matches the baseline-table row. |
| FireFly-P 2026 | VERIFIED | T. Li, J. Li, G. Shen, D. Zhao, Q. Zhang, Y. Zeng, "FireFly-P: FPGA-accelerated spiking neural network plasticity for robust adaptive control," arXiv:2601.21222, Jan. 2026 (accepted, IEEE ISCAS 2026). | https://arxiv.org/abs/2601.21222 | No DOI yet; update to the ISCAS record when it appears. |
| Nagy et al. (Loihi 2 vs GPU) | VERIFIED | A. Nagy, R. Szabo, L. Toka, "Analyzing energy consumption of Loihi 2 neuromorphic chip in a self-driving use-case," in *Proc. 10th Int. Conf. Smart and Sustainable Technologies (SpliTech)*, 2025, pp. 1-6. | 10.23919/SpliTech65624.2025.11091800 | Also Zenodo record 16737401. |
| IsaacGym | VERIFIED | V. Makoviychuk, L. Wawrzyniak, Y. Guo, M. Lu, et al., "Isaac Gym: High performance GPU-based physics simulation for robot learning," in *NeurIPS Datasets and Benchmarks Track*, 2021. arXiv:2108.10470. | https://arxiv.org/abs/2108.10470 | |
| Koravuna et al. (source of Harmeling's Table 4 neuron-cost figures) | CORRECTED | Sanaullah, S. Koravuna, U. Rueckert, T. Jungeblut, "Exploring spiking neural networks: a comprehensive analysis of mathematical models and applications," *Front. Comput. Neurosci.*, vol. 17, art. 1215824, 2023. | 10.3389/fncom.2023.1215824 | First author is **Sanaullah** (single name); Koravuna is second. Confirm against Harmeling's reference list that this is the work Table 4 credits before citing it as the neuron-cost source. |

Counts: 53 rows; 49 VERIFIED, 4 CORRECTED, 0 NOT FOUND.

Unnamed items in the outline that still need a citation and were **not** searched here: "works on action/observation delay in RL locomotion" (2.5) and "papers that rarely state which reset they built" (2.1, a claim rather than a cite).

## Table 2 — the three TODO searches, plus the FireFly-S and Spiker+ rows

All rows are proposals; status says how far each was checked. "Verified" = bibliographic record confirmed (Crossref/publisher/arXiv) and the method claim read in the paper or its abstract.

### TODO (1) — assessments of Vivado / XPE power-estimate accuracy against board measurement (2.4)

| proposed work | status | full citation | DOI / URL | what it gives the thesis |
|---|---|---|---|---|
| Lin et al., PowerGear, DATE 2022 | verified (paper read) | Z. Lin, Z. Yuan, J. Zhao, W. Zhang, H. Wang, Y. Tian, "PowerGear: Early-stage power estimation in FPGA HLS via heterogeneous edge-centric GNNs," in *Proc. DATE*, 2022, pp. 1341-1346. | 10.23919/DATE54114.2022.9774682 (arXiv 2201.10114) | Table I: Vivado power estimator (post-implementation netlist + SAIF from vector-based simulation) vs on-board measurement on a **ZCU102** via the Zynq UltraScale+ Power Advantage Tool, nine PolyBench HLS designs at 100 MHz: **average total-power error 21.82 %** (range 11.0-28.3 %), always over-estimating relative to measurement; states Vivado "neglects the impact of power gating on unused hard blocks." The sign-and-magnitude figure 2.4 asks for. |
| Lin et al., HL-Pow, ASP-DAC 2020 | verified (abstract) | Z. Lin, J. Zhao, S. Sinha, W. Zhang, "HL-Pow: A learning-based power modeling framework for high-level synthesis," in *Proc. ASP-DAC*, 2020. | 10.1109/ASP-DAC47756.2020.9045442 (arXiv 2009.00871) | Ground truth is on-board measurement; the learned model is "only 4.67 % (24.02 mW) away from onboard power measurement." Board not named in the abstract; same group as PowerGear. Cite as the precursor. |
| Lin, Sinha, Zhang, TCAD 2018 | verified (abstract) -- weaker fit | Z. Lin, S. Sinha, W. Zhang, "An ensemble learning approach for in-situ monitoring of FPGA dynamic power," *IEEE Trans. CAD*, 2018. | 10.1109/TCAD.2018.2859248 (arXiv 2009.01432) | Compares against a commercial gate-level power tool, **not** a meter; useful only for the point that even model-vs-tool error is several percent. Do not cite as meter evidence. |
| (not suitable) Tripathi and Rajawat 2018; FPEV_Tool 2018 | checked, rejected | A. N. Tripathi, A. Rajawat, *Microprocessors and Microsystems*, vol. 59, pp. 37-45, 2018; "FPEV_Tool," *Wireless Personal Communications*, 2018. | 10.1007/s11277-018-5938-4 (FPEV) | Both validate against Vivado / XPower, not against measurement. Listed so the search is not repeated. |

### TODO (2) — event-camera perception on legged robots or drones, 2022-2026 (2.5, 3.3)

| proposed work | status | full citation | DOI / URL | what it gives the thesis |
|---|---|---|---|---|
| Paredes-Valles et al., Science Robotics 2024 | verified (record + abstract) | F. Paredes-Valles, J. J. Hagenaars, J. Dupeyroux, S. Stroobants, Y. Xu, G. C. H. E. de Croon, "Fully neuromorphic vision and control for autonomous drone flight," *Science Robotics*, vol. 9, no. 90, eadi0591, 2024. | 10.1126/scirobotics.adi0591 | Event camera + SNN on Loihi on board a quadrotor; abstract reports Loihi at 200 Hz, 0.94 W idle plus 7-12 mW for the network -- one of the few robot works that reports a chip-level power number (check the methods for how it was obtained before calling it measured). Erratum: 10.1126/scirobotics.adr0223. |
| Zhu, Xiong, Kim, RA-L 2024 (CEAR) | verified (record + abstract) | S. Zhu, Z. Xiong, D. Kim, "CEAR: Comprehensive event camera dataset for rapid perception of agile quadruped robots," *IEEE Robot. Autom. Lett.*, 2024. | 10.1109/LRA.2024.3426373 (arXiv 2404.04698) | Mini Cheetah quadruped with event cameras, RGB-D, IMU, LiDAR; 100+ sequences. Evidence of the trend toward event vision on legged robots; no energy claim. |
| Bhattacharya et al., CoRL 2024 | verified (arXiv) | A. Bhattacharya, M. Cannici, N. Rao, Y. Tao, V. Kumar, N. Matni, D. Scaramuzza, "Monocular event-based vision for obstacle avoidance with a quadrotor," in *Proc. Conf. Robot Learning (CoRL)*, 2024. arXiv:2411.03303. | https://arxiv.org/abs/2411.03303 | Learned event-based avoidance on a quadrotor, sim-to-real; no power reported -- supports "energy is not measured" pattern. PMLR volume/pages not confirmed. |
| Jiang et al. 2024 (Loihi dodging) | verified (arXiv) | J. Jiang, D. Kong, C. Hu, Z. Fang, "Fully asynchronous neuromorphic perception for mobile robot dodging with Loihi chips," arXiv:2410.10601, 2024. | https://arxiv.org/abs/2410.10601 | Event camera + Loihi on a mobile (wheeled) robot; reports energy relative to a Jetson Orin NX. Wheeled, not legged -- use only if a third robot example is needed. |
| Lopez-Osorio et al., Adv. Intell. Syst. 2024 | verified (record) | P. Lopez-Osorio, J. P. Dominguez-Morales, F. Perez-Pena, "A neuromorphic vision and feedback sensor fusion based on spiking neural networks for real-time robot adaption," *Advanced Intelligent Systems*, vol. 6, no. 5, 2024. | 10.1002/aisy.202300646 | Hexapod robot, neuromorphic retina inputs, SNN on SpiNNaker adapting gait speed/orientation. Legged + event sensor. Full text not read (paywall); confirm the power statement before citing it for energy. |
| Bian et al. 2023 (ColibriUAV) | verified (arXiv) | S. Bian, L. Schulthess, G. Rutishauser, A. Di Mauro, L. Benini, M. Magno, "ColibriUAV: An ultra-fast, energy-efficient neuromorphic edge processing UAV-platform with event-based and frame-based cameras," arXiv:2305.18371, 2023. | https://arxiv.org/abs/2305.18371 | Nano-drone with DVS + RISC-V "Kraken" SoC; reports measured 10.7 mW for the event interface. Venue of record not confirmed. |

### TODO (3) — FPGA accelerator papers (any domain) that report board- or rail-measured power alongside a tool estimate (2.4, 3.4)

| proposed work | status | full citation | DOI / URL | what it gives the thesis |
|---|---|---|---|---|
| Umuroglu et al., FINN, FPGA 2017 | verified (paper read) | Y. Umuroglu, N. J. Fraser, G. Gambardella, M. Blott, P. Leong, M. Jahre, K. Vissers, "FINN: A framework for fast, scalable binarized neural network inference," in *Proc. ACM/SIGDA Int. Symp. FPGA*, 2017, pp. 65-74. | 10.1145/3020078.3021744 | Sec. 5.1: two measurements per prototype on a **ZC706** -- P_chip "using the PMBus interface to monitor the FPGA power supply rails" and P_wall "using a wall power meter," averaged over 10 s; Table 3 lists both (e.g. SFC-max 7.3 W chip / 21.2 W wall); notes ~7 W board idle. **No Vivado estimate is reported** -- cite as "measurement is cheap and standard," not as an estimate-vs-meter comparison. |
| Le et al., PACOX, 2026 (arXiv) | verified (HTML read) | T. X. H. Le, T. H. Vu, V. T. D. Le, H. L. Pham, Y. Nakashima, "PACOX: A FPGA-based Pauli composer accelerator for Pauli string computation," arXiv:2601.04827, 2026 (submitted to COOL Chips 29). | https://arxiv.org/abs/2601.04827 | Reports **both**: Vivado post-implementation estimate 0.33 W (Sec. IV-A) and INA226 on-board measurement on a **ZCU102** (Sec. IV-B: system max 2.58 W, dynamic 0.24 W, effective 0.96 W). Not neural-network; not yet peer-reviewed. Closest match to the TODO's wording. |
| Al Hafiz et al. 2025 (arXiv) | verified (HTML read) | M. I. Al Hafiz, N. Ravichandran, A. Lansner, P. Herman, A. Podobas, "Embedded FPGA acceleration of brain-like neural networks: Online learning to scalable inference," arXiv:2506.18530, 2025. | https://arxiv.org/abs/2506.18530 | Neural-network accelerator on a **ZCU104** measured with the on-board INA226 at 10 ms intervals; defines "board power" vs "execution power" (active minus idle) and says the true accelerator power lies between -- the same boundary argument as C0004/C0038. No tool estimate reported. |
| Qasaimeh et al., ICESS 2019 | verified (record) -- method to confirm | M. Qasaimeh, K. Denolf, J. Lo, K. Vissers, J. Zambreno, P. H. Jones, "Comparing energy efficiency of CPU, GPU and FPGA implementations for vision kernels," in *Proc. IEEE ICESS*, 2019, pp. 1-8. | 10.1109/ICESS.2019.8782524 (arXiv 1906.11879) | ZCU102 vs ARM vs Jetson TX2 for OpenCV kernels; search summary says on-board power IC per rail. Read the paper before citing the method. |
| Lin et al., PowerGear, DATE 2022 (again) | verified (paper read) | see TODO (1) | 10.23919/DATE54114.2022.9774682 | Doubles as TODO (3) evidence: the same paper holds a Vivado estimate and a ZCU102 rail measurement side by side for nine designs. |

### Baseline-table rows: FireFly-S and Spiker+ (3.1, docs/baseline_table.md)

| work | citation | DOI | platform | network / dataset | accuracy | clock | latency / throughput | resources | power, and how obtained |
|---|---|---|---|---|---|---|---|---|---|
| FireFly-S | T. Li, J. Li, G. Shen, D. Zhao, Q. Zhang, Y. Zeng, "FireFly-S: Exploiting dual-side sparsity for spiking neural networks acceleration with reconfigurable spatial architecture," *IEEE Trans. Circuits Syst. I*, vol. 72, no. 8, pp. 4007-4020, 2025. | 10.1109/TCSI.2024.3496554 (arXiv 2408.15578) | Xilinx Zynq UltraScale+ XCZU5EV on the KV260 Vision AI Starter Kit | 4-bit weights, >= 85 % weight sparsity; SCNN5 / SCNN7 / SCNN9 on MNIST / DVS-Gesture / CIFAR-10 | 98.03 % / 92.05 % / 87.00 % (per arXiv v3 HTML) | 333 MHz | 10,047 / 3,683 / 2,327 FPS (arXiv HTML); the abstract phrases the same numbers as FPS/W -- **transcribe from the paper's results table with the PDF in hand** | [fill from Table in paper] | 1.301 / 1.821 / 3.799 W; **tool estimate**: "the power consumption estimates are derived from the reports generated by the Vivado Design Suite" (arXiv v3). |
| Spiker+ | A. Carpegna, A. Savino, S. Di Carlo, "Spiker+: A framework for the generation of efficient spiking neural networks FPGA accelerators for inference at the edge," *IEEE Trans. Emerging Topics in Computing*, vol. 13, no. 3, pp. 784-798, 2025. | 10.1109/TETC.2024.3511676 (arXiv 2401.01141) | Xilinx XC7Z020 (Zynq-7020, same fabric as the ZedBoard) | 784-128-10 FF-FC, I-order LIF, subtractive reset, 6-bit membrane / 4-bit weights, T = 100, rate coding -- MNIST; 700-200-20 FC-R, II-order LIF -- SHD | 93.85 % MNIST (hardware; 96.83 % software); 72.99 % SHD | 100 MHz (capped by BRAM access time) | 780 us/image MNIST; 540 us SHD | MNIST: 7,612 logic cells (4,314 LUT + 3,298 FF), 18 BRAM, 0 DSP; SHD: 18,268 cells, 51 BRAM | 180 mW MNIST, 430 mW SHD; **method not stated on the pages read** (arXiv v1 Sec. 6); Table 4 is headed "Synthesis of maximum size accelerator" with a power column, so the figures appear tool-derived -- confirm in the TETC version before entering "tool estimate" in the table. |

Note for 3.1/3.2: Spiker+ Sec. 6.1 makes the observation that in its own comparison table "the top power-efficient accelerators employ a clock-driven update policy," which it calls counterintuitive against the literature's preference for event-driven -- a second 2024-25 peer-reviewed statement (beside Harmeling's) that the dense-vs-event trade-off is asserted rather than measured.
