deestroy/snn_parkour_fgpa/experiments/board_ed_k4_c0044_20260918.md

# Board pass: ED K=4 N=1 with C0044, first bitstream from the fresh m4_conv2 project (2026-09-18)

Build: ENGINE=1, ED_K=4, N_ENGINES=1, DATASET=0, BAKED_WEIGHTS=1,
m4_conv2/builds/ed_k4_20260918_1300 (bitstream 2026-09-18 13:03:08,
WNS +0.475 / WHS +0.032). Project: the clean m4_conv2, HDL referenced
from the git clone in place (docs/vivado_new_project.md), global
synthesis, ZedBoard preset verified by the script before building.
BOOT.bin made by the script's bootgen. Pre-registered:
experiments/ed_k4_c0044_prereg_20260918.md (commit e4511a6).

Mac-side: .hwh parameters correct, three MEMRANGEs, full diff of 901
PS/DMA parameters against the validated archive: one cosmetic difference
(FCLK0 "100" vs "100.000000"). FSBL and app partitions byte-identical
to the Vitis-built images; bitstream partition equal to the .xsa's.

**Rejected delivery on record.** The first m4_conv2 build (11:16) had
DDR part MT41J128M8 JP-15E, 8-bit, MIO tree unassigned, bank-1 voltage
3.3 V: block automation had not applied the ZedBoard preset. The diff
caught it before the card; the script now refuses to build in that
state.

## Correctness

PING build 4. 16/16 bit-identical, 200-iteration bursts on all 16
samples (3,200 inferences) and a 1,600-inference sweep: zero CRC
mismatches. First silicon pass of the C0044 sweep-zeroing fix (invisible
on N-MNIST by construction; the DVS-Gesture pair is what exercises it).

## Latency (engine-only, build-4 words 8..9; 200 iterations/sample)

Every sample equal to the 2026-09-05 build-4 record to 0.1 us:
711.2, 762.7, 746.5, 707.5, 653.7, 554.8, 724.9, 652.2, 690.0, 674.9,
662.5, 604.2, 643.8, 652.0, 815.8, 758.5 us; mean 688.5, sweep 688.5.
Server overhead 117.5 us. So: (a) the C0044 fix changes no cycle count,
(b) the new project reproduces the old one's engine exactly,
(c) the scripted bootgen image boots and serves like the Vitis one.

**Die temperature, correcting yesterday's note.** This single-engine
pass ran at 39.1-40.7 degC — the same band as yesterday's x8 passes
(39.6-42.2) and above yesterday's single-engine passes (34-38). Board
and room thermal history dominate the XADC reading; the "x8 runs
hotter" observation in board_ed_k4_x8_20260917.md and
board_dense_p4_x8_20260917.md is withdrawn as even suggestive. The
meter is the only instrument for that question.

## What this bitstream is for

- The ED K=4 N=1 operating-point bitstream from here on (the
  2026-09-05 one predates C0044; its N-MNIST numbers stand).
- The N=1 side of the C0003 scaling measurement, paired with
  ed_k4_x8_20260917_2251.
- Archived: host/mac/build/archive/ed_k4_20260918_1300/ (Mac, local)
  and m4_conv2/builds/ed_k4_20260918_1300/ (VM).

## Raw client lines

```
[board] PING ok: build 4, cap 65535 words, dataset N-MNIST C1 (build <5)
  sample  0 (digit 0): ok
  sample  1 (digit 0): ok
  sample  2 (digit 0): ok
  sample  3 (digit 0): ok
  sample  4 (digit 0): ok
  sample  5 (digit 1): ok
  sample  6 (digit 2): ok
  sample  7 (digit 3): ok
  sample  8 (digit 3): ok
  sample  9 (digit 3): ok
  sample 10 (digit 6): ok
  sample 11 (digit 7): ok
  sample 12 (digit 7): ok
  sample 13 (digit 7): ok
  sample 14 (digit 8): ok
  sample 15 (digit 8): ok

BOARD PASS: 16 samples, 9280 words, bit-identical to the golden model (4.90 s, 306 ms/sample incl. UART)
M4's done-when is met: correct results back from real hardware.
[board] BURST sample 0: 200 iterations in 0.166 s -> 828.7 us/inference (1207 inf/s), 0 mismatches, crc 8c0547d6  [engine 711.2 us + server 117.5 us]  die 39.1->39.2 degC
[board]   wall-clock 0.172 s vs board 0.166 s (tick-rate cross-check; wall includes UART overhead)
[board] BURST sample 1: 200 iterations in 0.176 s -> 880.2 us/inference (1136 inf/s), 0 mismatches, crc 64496222  [engine 762.7 us + server 117.5 us]  die 39.5->39.8 degC
[board] BURST sample 2: 200 iterations in 0.173 s -> 864.0 us/inference (1157 inf/s), 0 mismatches, crc eb268d5e  [engine 746.5 us + server 117.5 us]  die 39.8->39.9 degC
[board] BURST sample 3: 200 iterations in 0.165 s -> 825.0 us/inference (1212 inf/s), 0 mismatches, crc 59cf14da  [engine 707.5 us + server 117.5 us]  die 39.7->39.8 degC
[board] BURST sample 4: 200 iterations in 0.154 s -> 771.3 us/inference (1297 inf/s), 0 mismatches, crc fed59c62  [engine 653.7 us + server 117.5 us]  die 39.9->39.5 degC
[board] BURST sample 5: 200 iterations in 0.134 s -> 672.4 us/inference (1487 inf/s), 0 mismatches, crc 27180e7b  [engine 554.8 us + server 117.6 us]  die 39.9->40.1 degC
[board] BURST sample 6: 200 iterations in 0.168 s -> 842.4 us/inference (1187 inf/s), 0 mismatches, crc 7d47a3f4  [engine 724.9 us + server 117.5 us]  die 39.8->40.0 degC
[board] BURST sample 7: 200 iterations in 0.154 s -> 769.8 us/inference (1299 inf/s), 0 mismatches, crc 9e652337  [engine 652.2 us + server 117.6 us]  die 40.0->40.1 degC
[board] BURST sample 8: 200 iterations in 0.162 s -> 807.6 us/inference (1238 inf/s), 0 mismatches, crc a7fa0875  [engine 690.0 us + server 117.6 us]  die 39.9->39.8 degC
[board] BURST sample 9: 200 iterations in 0.158 s -> 792.5 us/inference (1262 inf/s), 0 mismatches, crc dd2a4b20  [engine 674.9 us + server 117.6 us]  die 40.0->40.0 degC
[board] BURST sample 10: 200 iterations in 0.156 s -> 780.0 us/inference (1282 inf/s), 0 mismatches, crc 583bccab  [engine 662.5 us + server 117.5 us]  die 39.9->40.1 degC
[board] BURST sample 11: 200 iterations in 0.144 s -> 721.7 us/inference (1386 inf/s), 0 mismatches, crc a59c6c4c  [engine 604.2 us + server 117.5 us]  die 40.1->40.2 degC
[board] BURST sample 12: 200 iterations in 0.152 s -> 761.4 us/inference (1313 inf/s), 0 mismatches, crc 89f456f7  [engine 643.8 us + server 117.6 us]  die 39.9->40.2 degC
[board] BURST sample 13: 200 iterations in 0.154 s -> 769.6 us/inference (1299 inf/s), 0 mismatches, crc 04e329e3  [engine 652.0 us + server 117.5 us]  die 40.2->40.0 degC
[board] BURST sample 14: 200 iterations in 0.187 s -> 933.4 us/inference (1071 inf/s), 0 mismatches, crc 4aa3061e  [engine 815.8 us + server 117.5 us]  die 40.3->40.2 degC
[board] BURST sample 15: 200 iterations in 0.175 s -> 876.0 us/inference (1142 inf/s), 0 mismatches, crc 89e867eb  [engine 758.5 us + server 117.5 us]  die 40.3->40.3 degC
[board] BURST sample 0: 1600 iterations in 1.290 s -> 806.0 us/inference (1241 inf/s), 0 mismatches, crc 89e867eb  [engine 688.5 us + server 117.6 us]  die 40.5->40.7 degC
```
