deestroy/snn_parkour_fgpa/experiments/ed_k4_c0044_prereg_20260918.md

# Pre-registration: ED K=4 N=1 rebuilt with C0044, from the fresh m4_conv2 project (2026-09-18, 14:36, before power-on)

Purpose: (a) the first ED K=4 single-engine bitstream that carries the
C0044 fix (the 2026-09-05 one on record does not); (b) the first
bitstream from the clean Vivado project (docs/vivado_new_project.md),
which references the git clone in place — so this pass also validates
that project against the old one.

Build: ENGINE=1, ED_K=4, N_ENGINES=1, DATASET=0, BAKED_WEIGHTS=1,
builds/ed_k4_20260918_1300 (bitstream 13:03:08, WNS +0.475 / WHS
+0.032), BOOT.bin made by the script's bootgen (FSBL and app partitions
byte-identical to the Vitis-built images). Mac-side: .hwh parameters
correct, three MEMRANGEs, and a full diff of 901 PS/DMA parameters
against the validated archive with one cosmetic difference
(FCLK0 "100" vs "100.000000"). The first attempt from the new project
(11:16) FAILED this diff — DDR part MT41J128M8, MIO tree unassigned:
block automation had not applied the ZedBoard preset — and was not
written; the script now checks the preset before building.

## Predictions

1. 16/16 bit-identical (C0044 is invisible on N-MNIST by construction).
2. Per-sample engine latencies **equal to the 2026-09-05 build-4 table
   to 0.1 us** (mean 688.5, 554.8-815.8): the fix removes a gate term
   in the sweep's zeroing path and changes no cycle count.
3. Server overhead 117.5 us. PING build 4.
4. WNS +0.475 vs +0.508 on 2026-09-05: different project, global
   synthesis, same design — within normal placement variation.

## What would falsify

- Any latency difference: the C0044 change altered the sweep's timing
  (it must not), or the new project's block design differs from the old
  one in a way the .hwh diff cannot see.
- A CRC mismatch: same.

## Outcome

(2026-09-18, 14:40; experiments/board_ed_k4_c0044_20260918.md)

1. **16/16 bit-identical**, 4,800 further inferences clean — held.
2. **Every per-sample latency equal to the 2026-09-05 table to 0.1 us** (mean 688.5) — held.
3. Server 117.5 us, PING build 4 — held.
4. WNS +0.475 — as expected.
Nothing falsified. The new project and the scripted boot image are validated against the old flow.
