deestroy/snn_parkour_fgpa/experiments/board_ed_k4_x8_20260917.md

# Board pass: ED K=4 with N_ENGINES=8 (C0003 replication) on silicon (2026-09-17)

Build: ENGINE=1, ED_K=4, N_ENGINES=8, BAKED_WEIGHTS=1, built by
host/vivado/build_engine.tcl (builds/ed_k4_x8_20260917_2251; bitstream
2026-09-17 22:55:51; WNS +0.430 / WHS +0.034). The first ED K=4
bitstream WITH the C0044 fix in the project. Server build 4.
Pre-registered: experiments/ed_k4_x8_prereg_20260917.md (commit
009dae8) — every prediction held.

## Correctness

PING build 4 (the first PING after power-on timed out once — boot not
finished — and succeeded on the immediate retry; no data was lost).
16/16 N-MNIST check samples bit-identical to the golden model, then
200-iteration bursts on every sample (3,200 inferences) and a
1,600-inference sweep: zero CRC mismatches. Instance 0 drives the DMA;
the seven replicas run the same stream in lockstep and their outputs
are consumed unconditionally (DONT_TOUCH held: eight near-identical
cores in the utilization report).

## Latency (engine-only, build-4 words 8..9; 200 iterations/sample)

| sample | digit | N=8 engine us | N=1 engine us (2026-09-05) | delta |
|---|---|---|---|---|
| 0 | 0 | 711.2 | 711.2 | +0.0 |
| 1 | 0 | 762.7 | 762.7 | +0.0 |
| 2 | 0 | 746.5 | 746.5 | +0.0 |
| 3 | 0 | 707.5 | 707.5 | +0.0 |
| 4 | 0 | 653.7 | 653.7 | +0.0 |
| 5 | 1 | 554.8 | 554.8 | +0.0 |
| 6 | 2 | 724.9 | 724.9 | +0.0 |
| 7 | 3 | 652.2 | 652.2 | +0.0 |
| 8 | 3 | 690.0 | 690.0 | +0.0 |
| 9 | 3 | 674.9 | 674.9 | +0.0 |
| 10 | 6 | 662.5 | 662.5 | +0.0 |
| 11 | 7 | 604.2 | 604.2 | +0.0 |
| 12 | 7 | 643.8 | 643.8 | +0.0 |
| 13 | 7 | 652.0 | 652.0 | +0.0 |
| 14 | 8 | 815.8 | 815.8 | +0.0 |
| 15 | 8 | 758.5 | 758.5 | +0.0 |

Mean 688.5 us (sweep: 688.5), min 554.8, max 815.8 — **identical to the
N=1 record on every sample to the timer's 0.1 us**. The replicas do not
stall instance 0; per-engine latency is unchanged by replication, as
the wiring intends. Server overhead 117.5 us.

Die temperature: 39.6 -> 41.3 degC over the pass, against 34.3-36.0
(ED K=8, N=1) and 36.5-38.0 (dense P=8, N=1) earlier tonight, each
starting seconds after power-on. Suggestive of eight engines' dynamic
power; NOT a measurement (no baseline control, thermal history
uncontrolled). The meter decides.

## Resources (utilization_hier.rpt, routed) — the deliverable

| | N=8 whole design | per engine (g_rep[i].core) | N=1 K=4 whole design (2026-09-05) |
|---|---|---|---|
| LUTs | 11,733 (8,348 logic + 3,184 LUTRAM + 201 SRL) | 1,151-1,154 (755-758 logic + 396 LUTRAM) | 3,855 |
| Registers | 7,539 | 499-511 | 4,111 |
| Block RAM tiles | 74 RAMB36 + 24 RAMB18 = **86 of 140 (61 %)** | 9 + 3/2 = 10.5 | 12.5 |
| DSP | 0 | 0 | 0 |
| WNS / WHS | +0.430 / +0.034 | | +0.508 / n.r. |

Eight copies at ~1,152 LUT / ~510 FF / 10.5 tiles each; the remaining
~2,500 LUTs and 2 tiles are the DMA and interconnect. The engine under
test is now 61 % of the chip's block RAM and ~79 % of the design's
LUTs, against ~3 % of the tool's power estimate at N=1 — the point of
C0003.

## C0003 status after this pass

- Both ED K=4 builds (N=1, N=8) close timing: done.
- Dense P=4 at N=8: not yet built (one Tcl line; ~22k LUT / ~40 tiles
  expected from the P=8 numbers).
- The N=1-vs-N=8 per-engine scaling ratio: needs the meter.
- Bitstreams kept for the meter session: host/mac/build/archive/<tag>/
  on the Mac (BOOT.bin, .bit, .hwh; local, git-ignored) and
  m4_conv/builds/<tag>/ on the VM.

## Raw client lines

```
[board] PING ok: build 4, cap 65535 words
  sample  0 (digit 0): ok
  sample  1 (digit 0): ok
  sample  2 (digit 0): ok
  sample  3 (digit 0): ok
  sample  4 (digit 0): ok
  sample  5 (digit 1): ok
  sample  6 (digit 2): ok
  sample  7 (digit 3): ok
  sample  8 (digit 3): ok
  sample  9 (digit 3): ok
  sample 10 (digit 6): ok
  sample 11 (digit 7): ok
  sample 12 (digit 7): ok
  sample 13 (digit 7): ok
  sample 14 (digit 8): ok
  sample 15 (digit 8): ok

BOARD PASS: 16 samples, 9280 words, bit-identical to the golden model (4.90 s, 306 ms/sample incl. UART)
M4's done-when is met: correct results back from real hardware.
[board] BURST sample 0: 200 iterations in 0.166 s -> 828.7 us/inference (1207 inf/s), 0 mismatches, crc 8c0547d6  [engine 711.2 us + server 117.5 us]  die 39.6->39.5 degC
[board]   wall-clock 0.172 s vs board 0.166 s (tick-rate cross-check; wall includes UART overhead)
[board] BURST sample 1: 200 iterations in 0.176 s -> 880.2 us/inference (1136 inf/s), 0 mismatches, crc 64496222  [engine 762.7 us + server 117.5 us]  die 40.0->40.3 degC
[board] BURST sample 2: 200 iterations in 0.173 s -> 864.0 us/inference (1157 inf/s), 0 mismatches, crc eb268d5e  [engine 746.5 us + server 117.5 us]  die 40.4->40.2 degC
[board] BURST sample 3: 200 iterations in 0.165 s -> 825.0 us/inference (1212 inf/s), 0 mismatches, crc 59cf14da  [engine 707.5 us + server 117.5 us]  die 40.4->40.4 degC
[board] BURST sample 4: 200 iterations in 0.154 s -> 771.2 us/inference (1297 inf/s), 0 mismatches, crc fed59c62  [engine 653.7 us + server 117.5 us]  die 40.4->40.5 degC
[board] BURST sample 5: 200 iterations in 0.134 s -> 672.4 us/inference (1487 inf/s), 0 mismatches, crc 27180e7b  [engine 554.8 us + server 117.6 us]  die 40.4->40.3 degC
[board] BURST sample 6: 200 iterations in 0.168 s -> 842.4 us/inference (1187 inf/s), 0 mismatches, crc 7d47a3f4  [engine 724.9 us + server 117.5 us]  die 40.5->40.5 degC
[board] BURST sample 7: 200 iterations in 0.154 s -> 769.8 us/inference (1299 inf/s), 0 mismatches, crc 9e652337  [engine 652.2 us + server 117.6 us]  die 40.6->40.6 degC
[board] BURST sample 8: 200 iterations in 0.162 s -> 807.6 us/inference (1238 inf/s), 0 mismatches, crc a7fa0875  [engine 690.0 us + server 117.6 us]  die 40.6->40.6 degC
[board] BURST sample 9: 200 iterations in 0.158 s -> 792.5 us/inference (1262 inf/s), 0 mismatches, crc dd2a4b20  [engine 674.9 us + server 117.6 us]  die 40.5->40.5 degC
[board] BURST sample 10: 200 iterations in 0.156 s -> 780.0 us/inference (1282 inf/s), 0 mismatches, crc 583bccab  [engine 662.5 us + server 117.5 us]  die 40.6->40.7 degC
[board] BURST sample 11: 200 iterations in 0.144 s -> 721.7 us/inference (1386 inf/s), 0 mismatches, crc a59c6c4c  [engine 604.2 us + server 117.5 us]  die 40.6->40.6 degC
[board] BURST sample 12: 200 iterations in 0.152 s -> 761.4 us/inference (1313 inf/s), 0 mismatches, crc 89f456f7  [engine 643.8 us + server 117.6 us]  die 40.7->40.6 degC
[board] BURST sample 13: 200 iterations in 0.154 s -> 769.6 us/inference (1299 inf/s), 0 mismatches, crc 04e329e3  [engine 652.0 us + server 117.5 us]  die 40.6->40.7 degC
[board] BURST sample 14: 200 iterations in 0.187 s -> 933.4 us/inference (1071 inf/s), 0 mismatches, crc 4aa3061e  [engine 815.8 us + server 117.5 us]  die 40.7->40.9 degC
[board] BURST sample 15: 200 iterations in 0.175 s -> 876.0 us/inference (1142 inf/s), 0 mismatches, crc 89e867eb  [engine 758.5 us + server 117.5 us]  die 40.7->40.8 degC
[board] BURST sample 0: 1600 iterations in 1.290 s -> 806.0 us/inference (1241 inf/s), 0 mismatches, crc 89e867eb  [engine 688.5 us + server 117.6 us]  die 40.8->41.3 degC
```
