deestroy/snn_parkour_fgpa/experiments/board_ed_k8_20260917.md

# Board pass: ED K=8 on silicon (2026-09-17) — the ED half of the K = P = 8 pair

Build: ENGINE=1, ED_K=8, BAKED_WEIGHTS=1, N_ENGINES=1, built by
host/vivado/build_engine.tcl (builds/ed_k8_20260917_2106; bitstream
2026-09-17 20:57:21; WNS +0.332 / WHS +0.025; Vivado's out-of-date flag
clear at export). Server build 4. Pre-registered:
experiments/ed_k8_prereg_20260917.md (commit 416944a, before power-on).

**C0044: this bitstream does NOT have the fix (confirmed 22:14).** The
VM project's ed_conv_layer.v (m4_loopback copy) had no `(C0044)` marker
when checked after the pass; the fix was committed on the Mac at 22:00
(573e831), after this build. So the K=8 bitstream carries the same
latent bug as the K=4 one: the sweep never zeroes neuron 0's input
current. The N-MNIST numbers below are unaffected by construction
(neuron 0's receptive field is empty on all 16 check samples,
decisions.md 2026-09-17). Do not use this bitstream for DVS-Gesture or
robot data; the next ED build (after the VM file was updated) is the
first clean one.

## Correctness

PING build 4. 16/16 N-MNIST check samples bit-identical to the golden
model (9,280 words). Then 200-iteration bursts on every sample (3,200
inferences) and a 1,600-inference sweep across all 16: zero CRC
mismatches. First silicon pass of the K=8 configuration.

## Latency (engine-only, build-4 words 8..9; 200 iterations/sample)

| sample | digit | K=8 engine us | sim us | board/sim | K=4 engine us | K=4/K=8 |
|---|---|---|---|---|---|---|
| 0 | 0 | 589.4 | 578.5 | +1.9 % | 711.2 | 1.21x |
| 1 | 0 | 620.5 | 609.7 | +1.8 % | 762.7 | 1.23x |
| 2 | 0 | 610.7 | 599.7 | +1.8 % | 746.5 | 1.22x |
| 3 | 0 | 586.9 | 576.0 | +1.9 % | 707.5 | 1.21x |
| 4 | 0 | 554.2 | 543.3 | +2.0 % | 653.7 | 1.18x |
| 5 | 1 | 494.1 | 483.2 | +2.3 % | 554.8 | 1.12x |
| 6 | 2 | 597.6 | 586.6 | +1.9 % | 724.9 | 1.21x |
| 7 | 3 | 553.5 | 542.6 | +2.0 % | 652.2 | 1.18x |
| 8 | 3 | 576.4 | 565.4 | +1.9 % | 690.0 | 1.20x |
| 9 | 3 | 567.4 | 556.6 | +1.9 % | 674.9 | 1.19x |
| 10 | 6 | 560.0 | 549.0 | +2.0 % | 662.5 | 1.18x |
| 11 | 7 | 524.5 | 513.6 | +2.1 % | 604.2 | 1.15x |
| 12 | 7 | 548.7 | 538.0 | +2.0 % | 643.8 | 1.17x |
| 13 | 7 | 553.1 | 542.3 | +2.0 % | 652.0 | 1.18x |
| 14 | 8 | 653.1 | 642.2 | +1.7 % | 815.8 | 1.25x |
| 15 | 8 | 618.4 | 607.6 | +1.8 % | 758.5 | 1.23x |

Mean **575.5 us**, min 494.1 (digit 1), max 653.1 (digit 8), spread
1.32x. Sweep across all 16: 575.6 us (mean reproduced). Server overhead
117.5 us/pass, unchanged. Die 34.3-36.0 degC.

## Against the pre-registration

| prediction | predicted | measured | held |
|---|---|---|---|
| correctness | 16/16 | 16/16 | yes |
| engine mean | ~573 us (sim 564.6 x 1.015) | 575.5 us (+0.4 %) | yes |
| range | 483-642 us, digit 1 / digit 8 | 494-653 us, digit 1 / digit 8 | yes |
| spread | ~1.33x, below K=4's 1.47x | 1.32x | yes |
| vs ED K=4 silicon | 1.20x faster | 1.196x (per sample 1.12-1.25x) | yes |
| server overhead | ~117.5 us | 117.5 us | yes |
| BRAM | ~2x K=4's 12.5 tiles | **13.5 tiles (+1)** | **no** — see below |
| mean above dense P=8 prediction (532 us) | yes, else retract | 575.5; only samples 5 and 11 below 532 | model stands |

Board-over-simulation is +1.7 to +2.3 % on every sample — an almost
constant **~10.9 us (~1,090 cycles) per inference**, the same absolute
offset K=4 showed (688.5 - 678 = 10.5 us). It is a fixed per-pass cost
(DMA setup/teardown around the fabric, not in the harness model), not a
percentage: predictions from here on add ~11 us (dense P=8: ~543 us).

## Resources (utilization_hier.rpt, Date Thu Sep 17 21:06:57 2026, routed)

| | K=8 (this build) | K=4 (2026-09-05) |
|---|---|---|
| LUT as logic, whole design | 3,349 | 3,241 |
| LUT as distributed RAM / SRL | 414 / 200 | 414 / 200 |
| Registers | 4,100 | 4,111 |
| Block RAM tiles (RAMB36 + RAMB18/2) | 7 + 13/2 = **13.5** | 12.5 |
| DSP | 0 | 0 |
| of which axis_conv_top_0 | 1,262 LUT (866 logic + 396 LUTRAM), 500 FF, 5 RAMB36 + 13 RAMB18 = 11.5 tiles | (not broken out) |
| ed_conv_layer (sweep, membranes, queues) | 657 LUT, 178 FF, 5 RAMB36 + 1 RAMB18 | |
| ed_scatter_c1 (baked weights, 8 banks) | 461 LUT, 191 FF, 12 RAMB18 | |
| lif_update | 47 LUT, 8 FF | |

The BRAM prediction was wrong, and wrong in the direction that helps
the event-driven design: doubling K from 4 to 8 cost **one** tile and
~108 logic LUTs, not a doubling. Banking splits the same bits across
more, shallower banks; each bank still rounds up to whole RAMB18s, and
at these sizes the rounding is what sets the count. (The "2x" guess
treated banks as additive instead of a partition of the same memory —
a reasoning error, now on record.) Two thirds of the fabric is the DMA
and interconnect (2,700 LUTs); the engine itself is 1,262 LUTs.

## What this settles and what it does not

- The K axis of the cycle model, 45.2k + 90.3k/K, has two silicon
  points (K=4, K=8), both within 2 % after the constant offset; the
  K-independent floor is real on hardware.
- The matched-parallelism verdict at K = P = 8 still needs Build 4
  (dense P=8, expected ~543 us flat). ED K=8 at 575.5 us would then
  lose by ~6 % at the mean and still win on its two fastest samples —
  the prediction on record.
- K=8 is nearly free in BRAM. The energy cost of 8 banks switching per
  spike is the open question (C0025, gated on the meter).

## Raw client lines

```
[board] PING ok: build 4, cap 65535 words
  sample  0 (digit 0): ok
  sample  1 (digit 0): ok
  sample  2 (digit 0): ok
  sample  3 (digit 0): ok
  sample  4 (digit 0): ok
  sample  5 (digit 1): ok
  sample  6 (digit 2): ok
  sample  7 (digit 3): ok
  sample  8 (digit 3): ok
  sample  9 (digit 3): ok
  sample 10 (digit 6): ok
  sample 11 (digit 7): ok
  sample 12 (digit 7): ok
  sample 13 (digit 7): ok
  sample 14 (digit 8): ok
  sample 15 (digit 8): ok

BOARD PASS: 16 samples, 9280 words, bit-identical to the golden model (4.89 s, 306 ms/sample incl. UART)
M4's done-when is met: correct results back from real hardware.
[board] BURST sample 0: 200 iterations in 0.141 s -> 706.9 us/inference (1415 inf/s), 0 mismatches, crc 8c0547d6  [engine 589.4 us + server 117.5 us]  die 34.6->34.3 degC
[board]   wall-clock 0.148 s vs board 0.141 s (tick-rate cross-check; wall includes UART overhead)
[board] BURST sample 1: 200 iterations in 0.148 s -> 738.0 us/inference (1355 inf/s), 0 mismatches, crc 64496222  [engine 620.5 us + server 117.5 us]  die 34.9->35.1 degC
[board] BURST sample 2: 200 iterations in 0.146 s -> 728.1 us/inference (1373 inf/s), 0 mismatches, crc eb268d5e  [engine 610.7 us + server 117.5 us]  die 35.1->35.2 degC
[board] BURST sample 3: 200 iterations in 0.141 s -> 704.4 us/inference (1420 inf/s), 0 mismatches, crc 59cf14da  [engine 586.9 us + server 117.5 us]  die 35.1->35.1 degC
[board] BURST sample 4: 200 iterations in 0.134 s -> 671.6 us/inference (1489 inf/s), 0 mismatches, crc fed59c62  [engine 554.2 us + server 117.5 us]  die 35.3->35.2 degC
[board] BURST sample 5: 200 iterations in 0.122 s -> 611.6 us/inference (1635 inf/s), 0 mismatches, crc 27180e7b  [engine 494.1 us + server 117.5 us]  die 35.1->35.1 degC
[board] BURST sample 6: 200 iterations in 0.143 s -> 715.2 us/inference (1398 inf/s), 0 mismatches, crc 7d47a3f4  [engine 597.6 us + server 117.6 us]  die 35.0->35.2 degC
[board] BURST sample 7: 200 iterations in 0.134 s -> 671.0 us/inference (1490 inf/s), 0 mismatches, crc 9e652337  [engine 553.5 us + server 117.5 us]  die 35.3->35.2 degC
[board] BURST sample 8: 200 iterations in 0.139 s -> 694.0 us/inference (1441 inf/s), 0 mismatches, crc a7fa0875  [engine 576.4 us + server 117.6 us]  die 35.3->35.3 degC
[board] BURST sample 9: 200 iterations in 0.137 s -> 685.0 us/inference (1460 inf/s), 0 mismatches, crc dd2a4b20  [engine 567.4 us + server 117.6 us]  die 35.3->35.2 degC
[board] BURST sample 10: 200 iterations in 0.136 s -> 677.5 us/inference (1476 inf/s), 0 mismatches, crc 583bccab  [engine 560.0 us + server 117.5 us]  die 35.4->35.5 degC
[board] BURST sample 11: 200 iterations in 0.128 s -> 642.0 us/inference (1558 inf/s), 0 mismatches, crc a59c6c4c  [engine 524.5 us + server 117.6 us]  die 35.5->35.0 degC
[board] BURST sample 12: 200 iterations in 0.133 s -> 666.2 us/inference (1501 inf/s), 0 mismatches, crc 89f456f7  [engine 548.7 us + server 117.5 us]  die 35.4->35.2 degC
[board] BURST sample 13: 200 iterations in 0.134 s -> 670.8 us/inference (1491 inf/s), 0 mismatches, crc 04e329e3  [engine 553.1 us + server 117.6 us]  die 35.6->35.4 degC
[board] BURST sample 14: 200 iterations in 0.154 s -> 770.6 us/inference (1298 inf/s), 0 mismatches, crc 4aa3061e  [engine 653.1 us + server 117.6 us]  die 35.4->35.3 degC
[board] BURST sample 15: 200 iterations in 0.147 s -> 736.0 us/inference (1359 inf/s), 0 mismatches, crc 89e867eb  [engine 618.4 us + server 117.5 us]  die 35.4->35.6 degC
[board] BURST sample 0: 1600 iterations in 1.109 s -> 693.1 us/inference (1443 inf/s), 0 mismatches, crc 89e867eb  [engine 575.6 us + server 117.5 us]  die 35.8->36.0 degC
```
