deestroy/snn_parkour_fgpa/experiments/board_ed_k4_20260905.md

# Board pass: ED K=4 with pipelined sweep + word-parallel wrapper (2026-09-05)

Build: ENGINE=1, ED_K=4, BAKED_WEIGHTS=1, N_ENGINES=1, WNS +0.508, 100 MHz.
Server: build 2 (build 3 ELF not yet in BOOT.bin — sweep/XADC pending).
Pre-write checks all green (.hwh params, MT41J128M16, HP0, 3 MEMRANGEs
incl. both DMA data ranges, BOOT.bin PL partition byte-equal to .xsa).

## Correctness

16/16 N-MNIST check samples bit-identical to the golden model (9,280
output words). First silicon run of the C0030 pipelined sweep, the C0035
word-parallel wrapper, and the baked ed_scatter_c1 — all validated.

## Latency (BURST, 200 iterations/sample, board global timer)

| sample | digit | us/inf | | sample | digit | us/inf |
|---|---|---|---|---|---|---|
| 0 | 0 | 746.2 | | 8  | 3 | 725.0 |
| 1 | 0 | 797.8 | | 9  | 3 | 709.9 |
| 2 | 0 | 781.5 | | 10 | 6 | 697.5 |
| 3 | 0 | 742.5 | | 11 | 7 | 639.2 |
| 4 | 0 | 688.7 | | 12 | 7 | 678.9 |
| 5 | 1 | 589.8 | | 13 | 7 | 687.0 |
| 6 | 2 | 759.9 | | 14 | 8 | 850.8 |
| 7 | 3 | 687.3 | | 15 | 8 | 793.5 |

Mean **723.5 us**, min 589.8 (digit 1), max 850.8 (digit 8) — a 1.44x
spread that is the event-driven design's data-dependent timing, visible
on silicon (the dense engine is data-independent by construction).
Zero CRC mismatches across all 3,200 burst inferences. Sample 0 at
1000 iterations reproduced 746.3 us (stable), wall-clock cross-check ok.

## Against prediction and prior baselines

- Simulation predicted ~678 us (67,756 cycles) on the seeded trace set.
  Board mean is 723.5 us on the N-MNIST check set: +6.7%, consistent
  with per-pass DMA/driver overhead plus the different sample set.
  Sample 12 happens to sit exactly at 678.9 us.
- Old ED build (bit-serial wrapper, unpipelined sweep): 1.51 ms
  -> **2.1x faster** from C0030 + C0035 combined, on silicon.
- Dense P=1 board (functional-only pass): 4.409 ms -> 6.1x vs mean.
  The matched-parallelism comparison needs Build 2 (dense P=4,
  predicted ~1.04 ms); until then 1.54x remains a simulation number.

## Build 4 (same evening): engine-only timing — the honest numbers

Build 3's per-pass CRC bookkeeping (at -O0) sat inside the timed loop and
inflated every latency above by ~80-117 us. Build 4 times one_pass (DMA +
fabric) separately. These supersede the table above as the thesis numbers:

| sample | digit | engine us | | sample | digit | engine us |
|---|---|---|---|---|---|---|
| 0 | 0 | 711.2 | | 8  | 3 | 690.0 |
| 1 | 0 | 762.7 | | 9  | 3 | 674.9 |
| 2 | 0 | 746.5 | | 10 | 6 | 662.5 |
| 3 | 0 | 707.5 | | 11 | 7 | 604.2 |
| 4 | 0 | 653.7 | | 12 | 7 | 643.8 |
| 5 | 1 | 554.8 | | 13 | 7 | 652.0 |
| 6 | 2 | 724.9 | | 14 | 8 | 815.8 |
| 7 | 3 | 652.2 | | 15 | 8 | 758.5 |

Mean **688.5 us**, range 554.8-815.8
(1.47x data-dependent spread). Server overhead constant at 117.5-117.6 us
per pass, reported separately. Internal consistency: the 16-sample sweep's
engine mean (688.5) equals the mean of the 16 single-sample runs (688.45).

- **vs sim prediction 678 us: +1.5 %** — the earlier "+6.7 % DMA overhead"
  was mostly the server's CRC loop; the true engine+DMA cost is within
  measurement noise of the cycle model.
- vs old ED build 1.51 ms: **2.2x** (engine-only).

Also verified on silicon (build 4): BURST sweep mode across all 16 loaded
samples (C0018) with per-sample determinism CRCs; XADC die temperatures in
the reply (C0009), 35.0-39.6 degC across the session; and the sweep's
ring-rotation fix (a lone extra load between invocations rotated slot
order away from load order — build 3 failed the client CRC check exactly
then; build 4 sweeps from the oldest slot and passed with the ring
deliberately offset by one).

## Still open from this session

- Build 2 (dense P=4) per docs/vivado_session_next.md — the 1.54x
  matched-parallelism verdict is still simulation-only.
- ~~Utilization/power screenshots for the ED power breakdown~~ — done,
  next section.

## Vivado routed power/utilization, ED K=4 build (2026-09-06 report)

The TOOL-ESTIMATE side of M5's measured-vs-estimated comparison
(design_1_wrapper_power_routed.rpt, same parameters as the validated
build; transcribed from the report, never recalled):

| quantity | value |
|---|---|
| Total on-chip power | 1.727 W |
| PS7 (ARM subsystem) | 1.533 W |
| Static | 0.144 W |
| Fabric dynamic (clocks+logic+signals+BRAM) | ~0.049 W |
| clocks / slice logic / signals / BRAM | 0.016 / 0.007 / 0.010 / 0.016 W |
| LUT as logic | 3,241 (6.09 %) |
| LUT as distributed RAM / SRL | 414 / 200 |
| Registers | 4,111 (3.86 %) |
| CARRY4 | 220 |
| Block RAM | 12.5 (8.93 %) |
| DSP | 0 (no DSP48 row in the report — use_dsp="no" held) |
| WNS | +0.508 |

Note the shape of the estimate: the fabric — the entire research object —
is ~3 % of the tool's total; PS7 + static are 97 %. Whether that ratio
survives the meter is precisely the M5 question.
