deestroy/snn_parkour_fgpa/experiments/dvsgesture/board_ed_k4_x4_20260920.md

# Board pass: DVS-Gesture C1, ED K=4 replicated x4 (C0003) on silicon (2026-09-20, 11:21)

Build: ENGINE=1, ED_K=4, DATASET=1, N_ENGINES=4, m4_conv2/builds/
ed_k4_dvsg_x4_20260920_0010 (bitstream 2026-09-20 00:13:11, WNS +0.119 /
WHS +0.020; built unattended by host/vivado/build_queue.tcl). N=8 does
not fit: the g1 ED engine is 21 BRAM tiles (19 RAMB36 + 4 RAMB18), so
x4 = 84 + 2 = 86 of 140 tiles (61 %). Server build 5 DATASET=1.
Vivado estimate 1.926 W total (BRAM 128 mW, PS7 1.533).

## Result

PING build 5, DVS-Gesture C1. **8/8 bit-identical**, 700 burst
inferences and an 800-inference sweep with zero mismatches. Per-clip
engine latency **equal to the N=1 pass (2026-09-19) to 0.1 us**:
2,084.6 / 4,663.9 / 2,553.1 / 2,515.8 / 2,965.9 / 4,096.2 / 2,383.4 /
2,503.4 us; sweep 2,970.8 us (= the N=1 mean). The three replicas run
in lockstep and do not stall instance 0, as on N-MNIST. Server 414.5 us.
Die 33.2-35.9 degC.

## Resources (utilization_hier.rpt)

| | whole design | per core (x4) |
|---|---|---|
| LUTs | 10,115 | 1,900-1,902 |
| Registers | 5,587 | 525-537 |
| BRAM tiles | 78 + 16/2 = 86 | 19 + 4/2 = 21 |

The DVS-Gesture ED engine is BRAM-bound at four copies where the
N-MNIST one took eight; this is the replicated ED bitstream for the
meter session on the second dataset. Its dense partner (dense P=4
DATASET=1 x4) failed inside the Vivado runs in the same queue; cause
being read (2026-09-20).

## Raw client lines

```
[board] PING ok: build 5, cap 65535 words, dataset DVS-Gesture C1
  sample  0 (digit 0): ok
  sample  1 (digit 6): ok
  sample  2 (digit 1): ok
  sample  3 (digit 7): ok
  sample  4 (digit 10): ok
  sample  5 (digit 9): ok
  sample  6 (digit 8): ok
  sample  7 (digit 2): ok

BOARD PASS: 8 samples, 16384 words, bit-identical to the golden model (8.57 s, 1072 ms/sample incl. UART)
M4's done-when is met: correct results back from real hardware.
[board] BURST sample 0: 100 iterations in 0.250 s -> 2499.2 us/inference (400 inf/s), 0 mismatches, crc 67bd453a  [engine 2084.6 us + server 414.5 us]  die 33.2->33.4 degC
[board]   wall-clock 0.257 s vs board 0.250 s (tick-rate cross-check; wall includes UART overhead)
[board] BURST sample 1: 100 iterations in 0.508 s -> 5078.4 us/inference (197 inf/s), 0 mismatches, crc e57194f7  [engine 4663.9 us + server 414.5 us]  die 34.3->34.4 degC
[board] BURST sample 2: 100 iterations in 0.297 s -> 2967.7 us/inference (337 inf/s), 0 mismatches, crc b01c1c9f  [engine 2553.1 us + server 414.5 us]  die 34.3->34.5 degC
[board] BURST sample 3: 100 iterations in 0.293 s -> 2930.3 us/inference (341 inf/s), 0 mismatches, crc de0a1f48  [engine 2515.8 us + server 414.5 us]  die 34.2->34.4 degC
[board] BURST sample 4: 100 iterations in 0.338 s -> 3380.4 us/inference (296 inf/s), 0 mismatches, crc a1c621d0  [engine 2965.9 us + server 414.5 us]  die 34.4->34.6 degC
[board] BURST sample 5: 100 iterations in 0.451 s -> 4510.7 us/inference (222 inf/s), 0 mismatches, crc 18947469  [engine 4096.2 us + server 414.5 us]  die 34.3->34.7 degC
[board] BURST sample 6: 100 iterations in 0.280 s -> 2798.0 us/inference (357 inf/s), 0 mismatches, crc 069987e3  [engine 2383.4 us + server 414.5 us]  die 34.7->34.4 degC
[board] BURST sample 7: 100 iterations in 0.292 s -> 2917.9 us/inference (343 inf/s), 0 mismatches, crc 14bf7591  [engine 2503.4 us + server 414.5 us]  die 34.6->34.8 degC
[board] BURST sample 0: 800 iterations in 2.708 s -> 3385.3 us/inference (295 inf/s), 0 mismatches, crc 14bf7591  [engine 2970.8 us + server 414.6 us]  die 35.6->35.9 degC
```
