deestroy/snn_parkour_fgpa/experiments/dvsgesture/board_ed_k4_20260919.md

# Board pass: DVS-Gesture C1, ED K=4 (DATASET=1) on silicon (2026-09-19)

Build: ENGINE=1, ED_K=4, DATASET=1, N_ENGINES=1, BAKED_WEIGHTS=1,
m4_conv2/builds/ed_k4_dvsg_20260919_1324 (bitstream 2026-09-19
13:27:27, WNS +0.190 / WHS +0.020). Server build 5, DATASET=1, from the
conv_server_g1 Vitis component (389,976 bytes). Pre-registered:
experiments/dvsgesture/silicon_prereg_20260919.md (commit dcf7ce8).

**Rejected image on record.** The first BOOT.bin for this build carried
a DATASET=0 server (a renamed copy of the N-MNIST ELF; the Vitis
Symbols setting had not reached that build). The client's PING check
refused it ("server is a DATASET=0 build ... nothing sent") -- the
failure that check was written for, one day after it was written. The
server now lives in its own component with DATASET pinned in code.

## Correctness

PING: build 5, DVS-Gesture C1. **8/8 clips bit-identical** to the
golden model (16,384 words), then 100-iteration bursts on every clip
(800 inferences) and an 800-inference sweep: zero CRC mismatches. First
silicon pass of the DATASET=1 geometry (2x64x64 -> 16x32x32, threshold
128) and of the C0044-fixed sweep on data that exercises it.

## Latency (engine-only, build-5 words 8..9; 100 iterations/clip)

| clip | gesture | board us | sim us | board - sim | faster than dense (sim 3,604 + offset) |
|---|---|---|---|---|---|
| 0 | 0 | 2084.6 | 1990.8 | +93.8 | ED |
| 1 | 6 | 4663.9 | 4571.4 | +92.5 | dense |
| 2 | 1 | 2553.1 | 2460.1 | +93.0 | ED |
| 3 | 7 | 2515.7 | 2422.9 | +92.8 | ED |
| 4 | 10 | 2965.9 | 2872.9 | +93.0 | ED |
| 5 | 9 | 4096.2 | 4003.5 | +92.7 | dense |
| 6 | 8 | 2383.4 | 2291.2 | +92.2 | ED |
| 7 | 2 | 2503.4 | 2410.4 | +93.0 | ED |

Mean **2,970.8 us** (sim 2,877.9), min 2,084.6 (clip 0), max 4,663.9
(clip 1), **spread 2.24x** (sim 2.30x). Sweep over all 8: 2,970.8 us
(mean reproduced). Server overhead 414.5 us (the -O0 CRC loop over
2,048 words; 117.5 us on 580). Die 39.5-41.0 degC.

## Against the pre-registration

| prediction | predicted | measured | held |
|---|---|---|---|
| correctness | 8/8 | 8/8 | yes |
| per-clip ordering | clip 0 fastest, clip 1 slowest | same | yes |
| spread | 2.30x | 2.24x | yes |
| board = sim + offset | offset ~38 us if DMA streaming, ~10 us if fixed | **+92.9 us, constant to +-0.8 us on every clip** | **neither** |
| ED wins | 6 of 8 | 6 of 8 (clips 1 and 5 above dense) | yes, pending dense P=4 silicon |

Fit across the 8 clips: board = 0.9998 x sim + 93.5 us, residual within
0.8 us. So the cycle model transfers to the second dataset exactly, up
to a per-pass constant -- but the constant is 92.9 us, not the 30-38 us
the streaming hypothesis gave, nor the ~10 us of a fixed cost. Two
things are known to differ from the N-MNIST comparison and must be
separated before the offset is interpreted: (a) the g1 sim column is
"first spike push -> done" per timestep, which EXCLUDES the wrapper's
input-word streaming, whereas the N-MNIST ksweep "total" column
included the wrapper (~1.9k cycles); (b) the frames are 3.5x larger
(1,024 in / 2,048 out words), so DMA streaming, the server's cache
maintenance on the buffers, and the wrapper's word unpacking all grow.
The dense P=4 pass gives a second offset on the same frames; the
harness can produce a wrapper-inclusive cycle count. Until then the
offset is recorded as measured, not explained.

## What this settles

- ED at K=4 on DVS-Gesture: bit-identical on silicon; per-clip latency
  is the simulated cycle count plus one constant.
- The activity crossover INSIDE a dataset, predicted by the sims (the
  two densest clips lose to dense P=4), is visible on the ED side:
  clips 1 and 5 sit above the dense prediction. The verdict needs the
  dense build on the same board (Build B).

## Offset resolved (2026-09-19, 23:55): the comparison basis, not the hardware

The g1 per-engine sim column ("first spike push -> done") excludes the
AXIS wrapper's word streaming. Re-run through the baked AXIS harness
with its wrapper-inclusive "total" column (NOGAP=1 CYCLES=..., the
basis the N-MNIST ksweep used; files in latency_sim/axis_total/):

| engine | wrapper cycles / inference | board - wrapper-inclusive sim |
|---|---|---|
| ED K=4 | 6,248-6,516 (per clip) | **29.4 us, constant to +-0.7 us** (28.7-30.1) |
| dense P=4 | 8,195 | **20.0 us** |

So ~63 us (ED) and ~82 us (dense) of the apparent 92.9 / 102.0 us were
wrapper streaming that the simulation column simply did not count. The
remaining per-pass offsets, with N-MNIST's on the same basis
(872 words: ED 10.7, dense 8.3), fit a fixed ~3.5 us plus ~8.5 ns/word
(ED) or ~5.3 ns/word (dense): DMA and cache maintenance scaling with
the frame, plus a fixed setup -- the streaming hypothesis in kind. The
2026-09-19 "neither hypothesis held" lines above stand as written (they
were written against the wrong basis); this section supersedes them.

## Raw client lines

```
[board] PING ok: build 5, cap 65535 words, dataset DVS-Gesture C1
  sample  0 (digit 0): ok
  sample  1 (digit 6): ok
  sample  2 (digit 1): ok
  sample  3 (digit 7): ok
  sample  4 (digit 10): ok
  sample  5 (digit 9): ok
  sample  6 (digit 8): ok
  sample  7 (digit 2): ok

BOARD PASS: 8 samples, 16384 words, bit-identical to the golden model (8.57 s, 1072 ms/sample incl. UART)
M4's done-when is met: correct results back from real hardware.
[board] BURST sample 0: 100 iterations in 0.250 s -> 2499.2 us/inference (400 inf/s), 0 mismatches, crc 67bd453a  [engine 2084.6 us + server 414.5 us]  die 39.7->39.5 degC
[board]   wall-clock 0.257 s vs board 0.250 s (tick-rate cross-check; wall includes UART overhead)
[board] BURST sample 1: 100 iterations in 0.508 s -> 5078.4 us/inference (197 inf/s), 0 mismatches, crc e57194f7  [engine 4663.9 us + server 414.5 us]  die 40.2->40.2 degC
[board] BURST sample 2: 100 iterations in 0.297 s -> 2967.7 us/inference (337 inf/s), 0 mismatches, crc b01c1c9f  [engine 2553.1 us + server 414.5 us]  die 40.3->40.2 degC
[board] BURST sample 3: 100 iterations in 0.293 s -> 2930.3 us/inference (341 inf/s), 0 mismatches, crc de0a1f48  [engine 2515.7 us + server 414.5 us]  die 40.2->40.0 degC
[board] BURST sample 4: 100 iterations in 0.338 s -> 3380.4 us/inference (296 inf/s), 0 mismatches, crc a1c621d0  [engine 2965.9 us + server 414.5 us]  die 40.4->40.5 degC
[board] BURST sample 5: 100 iterations in 0.451 s -> 4510.7 us/inference (222 inf/s), 0 mismatches, crc 18947469  [engine 4096.2 us + server 414.5 us]  die 40.5->40.3 degC
[board] BURST sample 6: 100 iterations in 0.280 s -> 2798.0 us/inference (357 inf/s), 0 mismatches, crc 069987e3  [engine 2383.4 us + server 414.5 us]  die 40.2->40.4 degC
[board] BURST sample 7: 100 iterations in 0.292 s -> 2917.9 us/inference (343 inf/s), 0 mismatches, crc 14bf7591  [engine 2503.4 us + server 414.5 us]  die 40.6->40.6 degC
[board] BURST sample 0: 800 iterations in 2.708 s -> 3385.3 us/inference (295 inf/s), 0 mismatches, crc 14bf7591  [engine 2970.8 us + server 414.6 us]  die 41.0->41.0 degC
```
