deestroy/snn_parkour_fgpa/experiments/axis_stress/README.md

# AXIS wrapper stress, 2026-09-19 23:56 to 2026-09-20 03:13 (bash experiments/axis_stress/run_stress.sh 1 60)
# 60 seeds x {c1, g1} x {ED K=4, dense P=4}, baked variants, hostile handshake: 240 PASS, 0 FAIL, zero word mismatches.
# Per-run lines are in the .log (tracked since 2026-09-20; the blanket *.log ignore rule was removed, C0051); this summary is the committed record.
# pass lines: 240
# finished Sun Sep 20 03:12:56 EDT 2026: 240 pass, 0 fail
