deestroy/snn_parkour_fgpa/experiments/ed_k8_prereg_20260917.md

# Pre-registration: ED K=8 first silicon pass (written 2026-09-17, before the measurement)

Written BEFORE the board is powered on the K=8 image, so the comparison
cannot be tuned after the fact (CLAUDE.md M7). Same discipline as
dense_p4_prereg_20260906.md, every prediction of which held.

Build under test: ENGINE=1, ED_K=8, BAKED_WEIGHTS=1, N_ENGINES=1, built
by host/vivado/build_engine.tcl (builds/ed_k8_20260917_2106, bitstream
2026-09-17 20:57:21, WNS +0.332 / WHS +0.025 from the run whose
out-of-date flag Vivado reported clear). Server build 4 (unchanged
ELF). Pre-write checks: .hwh ENGINE=1 ED_K=8 DENSE_P=4 BAKED=1
N_ENGINES=1, MT41J128M16, HP0=1, three MEMRANGEs, BOOT.bin PL partition
byte-equal to the .xsa bitstream, bitstream differs from every earlier
build. Card md5 788d422b... verified after write.

Source of the predictions: experiments/latency_sim/ksweep_c0035/ed_k8.txt,
the same 16 check samples the board runs, engine_busy cycles at 100 MHz.
K=4 on silicon came in +1.5 % above its simulation (688.5 vs 678 us),
so the "expected" column applies that same factor.

## Predictions

1. Correctness: 16/16 bit-identical (the K=8 configuration was
   bit-identical in the baked AXIS harness with the hostile handshake
   on 2026-09-06; K is a parameter of the same silicon-proven RTL).
2. Engine-only latency, mean over the 16 samples: **564.6 us** from
   the cycle model, **~573 us** expected with the K=4 silicon
   factor. Range 483.2 to 642.2 us (sample 5, digit 1, fastest;
   sample 14, digit 8, slowest -- same ordering as K=4).
3. Spread: about 1.33x (max/min), narrower than K=4's 1.47x, because the
   data-dependent scatter term shrinks with K while the 45.2k-cycle
   sweep floor does not.
4. Against ED K=4 on silicon (688.5 us): **1.2x faster** (sim 67,756 ->
   56,464 cycles = 1.20x). Against dense P=4 (1048.9 us): 1.84x.
5. Server overhead ~117.5 us per pass, unchanged (same ELF).
6. Resources: BRAM tiles roughly double K=4's 12.5 (per-bank membrane and
   weight banks, eight of each); DSP 0; LUT/FF above K=4's.

| sample | digit | sim cycles | sim us | expected us (x1.015) |
|---|---|---|---|---|
| 0 | 0 | 57849 | 578.5 | 587.2 |
| 1 | 0 | 60974 | 609.7 | 618.9 |
| 2 | 0 | 59972 | 599.7 | 608.7 |
| 3 | 0 | 57596 | 576.0 | 584.6 |
| 4 | 0 | 54330 | 543.3 | 551.4 |
| 5 | 1 | 48317 | 483.2 | 490.4 |
| 6 | 2 | 58665 | 586.6 | 595.4 |
| 7 | 3 | 54256 | 542.6 | 550.7 |
| 8 | 3 | 56538 | 565.4 | 573.9 |
| 9 | 3 | 55661 | 556.6 | 565.0 |
| 10 | 6 | 54895 | 549.0 | 557.2 |
| 11 | 7 | 51357 | 513.6 | 521.3 |
| 12 | 7 | 53798 | 538.0 | 546.0 |
| 13 | 7 | 54231 | 542.3 | 550.4 |
| 14 | 8 | 64225 | 642.2 | 651.9 |
| 15 | 8 | 60760 | 607.6 | 616.7 |

## What would falsify

- Any CRC mismatch: a K=8-specific silicon bug simulation did not see.
- Mean more than ~3 % off the expected value: the K-split of the cycle
  model (45.2k floor + 90.3k/K scatter) is wrong at K=8.
- Mean at or below the dense P=8 prediction (532 us) would mean the
  floor term is wrong and the K = P ~ 6.6 crossover analysis is
  retracted (this needs dense P=8 on silicon to settle, Build 4).
- Spread wider than K=4's: something other than scatter is data-dependent.

## Outcome

(2026-09-17, 21:56, same evening; experiments/board_ed_k8_20260917.md)

1. Correctness: **16/16 bit-identical**, 4,800 further inferences with zero CRC mismatches — held.
2. Engine mean: **575.5 us** vs ~573 expected (+0.4 %; +1.9 % over raw sim) — held.
3. Spread: **1.32x** (494.1-653.1 us, digit 1 fastest, digit 8 slowest) — held.
4. vs K=4: **1.196x** faster at the mean, faster on every sample — held.
5. Server overhead: **117.5 us** — held.
6. Resources: **NOT held** — 13.5 BRAM tiles vs 12.5 at K=4 (+1), not ~2x;
   LUT +108, FF -11, DSP 0. The doubling guess treated the banks as
   additive rather than as a partition of the same memory.
Mean is above the dense P=8 prediction; the floor term stands.
Latency predictions all held; the resource prediction was wrong (favourably).
Note: this bitstream predates the C0044 fix (confirmed absent in the VM copy, 22:14); N-MNIST results unaffected, not for other datasets.

> **Footnote added 2026-09-20 (C0049).** Where this file says the
> "K = P ~ 6.6 crossover analysis", read 7.4: the number was recomputed
> from the cycle files on 2026-09-20 and the original was an arithmetic
> slip. The pre-registered predictions and their outcomes are unchanged.
