deestroy/snn_parkour_fgpa/experiments/power_estimates/dense_p4_congestion_spreadlogic_high_20260920_0026_summary.txt

tag        dense_p4_congestion_spreadlogic_high_20260920_0026
params     ENGINE=0 ED_K=4 DENSE_P=4 BAKED=1 N_ENGINES=1
timing     WNS=0.353809 TNS=0.000000 WHS=0.024940
bitstream  C:/Users/dhritiaravind/m4_conv2/m4_conv2.runs/impl_1/design_1_wrapper.bit
xsa        C:/Users/dhritiaravind/m4_conv2/builds/dense_p4_congestion_spreadlogic_high_20260920_0026/design_1_wrapper.xsa
built      Sun Sep 20 00:29:58 -0400 2026
