deestroy/snn_parkour_fgpa/experiments/power_estimates/dense_p4_dvsg_x2_20260920_1127_summary.txt

tag        dense_p4_dvsg_x2_20260920_1127
params     ENGINE=0 ED_K=4 DENSE_P=4 BAKED=1 N_ENGINES=2
timing     WNS=0.842248 TNS=0.000000 WHS=0.028128
bitstream  C:/Users/dhritiaravind/m4_conv2/m4_conv2.runs/impl_1/design_1_wrapper.bit
xsa        C:/Users/dhritiaravind/m4_conv2/builds/dense_p4_dvsg_x2_20260920_1127/design_1_wrapper.xsa
built      Sun Sep 20 11:33:41 -0400 2026
