deestroy/snn_parkour_fgpa/experiments/dvsgesture/seed1_m0_firing_rates_binarised.csv

epoch | split | loss | accuracy | c1 | c2 | c3 | fc
1 | train | 1.9739 | 0.3213 | 0.12412 | 0.07903 | 0.09041 | 0.13837
1 | test | 1.3413 | 0.5303 | 0.15927 | 0.10692 | 0.13100 | 0.23494
2 | train | 1.1913 | 0.5693 | 0.12538 | 0.08906 | 0.11981 | 0.26007
2 | test | 1.0214 | 0.5985 | 0.16040 | 0.11616 | 0.16394 | 0.34653
3 | train | 0.9431 | 0.6123 | 0.12666 | 0.09366 | 0.13721 | 0.32906
3 | test | 0.9134 | 0.6061 | 0.16317 | 0.11660 | 0.17014 | 0.36171
4 | train | 0.7696 | 0.6719 | 0.12772 | 0.09262 | 0.14025 | 0.33845
4 | test | 0.8650 | 0.6136 | 0.16110 | 0.11165 | 0.16822 | 0.35825
5 | train | 0.6698 | 0.7158 | 0.12819 | 0.09072 | 0.13988 | 0.34083
5 | test | 0.8666 | 0.6136 | 0.16411 | 0.11139 | 0.17118 | 0.36697
6 | train | 0.5872 | 0.7568 | 0.12946 | 0.09170 | 0.14406 | 0.35745
6 | test | 0.8491 | 0.6174 | 0.16437 | 0.11527 | 0.17703 | 0.38444
7 | train | 0.5260 | 0.7715 | 0.12882 | 0.09424 | 0.14684 | 0.36369
7 | test | 0.8947 | 0.6023 | 0.16270 | 0.11850 | 0.18067 | 0.38484
8 | train | 0.4612 | 0.8174 | 0.12808 | 0.09630 | 0.14867 | 0.36284
8 | test | 0.8610 | 0.6364 | 0.16302 | 0.11897 | 0.18173 | 0.38092
9 | train | 0.4138 | 0.8428 | 0.12950 | 0.09698 | 0.15057 | 0.36447
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
