deestroy/snn_parkour_fgpa/experiments/dvsgesture/seed2_m0_firing_rates_binarised.csv

epoch | split | loss | accuracy | c1 | c2 | c3 | fc
1 | train | 2.0119 | 0.3232 | 0.06578 | 0.06817 | 0.08510 | 0.13041
1 | test | 1.5050 | 0.4508 | 0.08284 | 0.08658 | 0.12804 | 0.20793
2 | train | 1.3310 | 0.5342 | 0.06503 | 0.06899 | 0.11066 | 0.21726
2 | test | 1.1187 | 0.5530 | 0.08183 | 0.08741 | 0.15198 | 0.28949
3 | train | 1.0159 | 0.5908 | 0.06501 | 0.07009 | 0.12505 | 0.27344
3 | test | 0.9489 | 0.5795 | 0.08098 | 0.08740 | 0.15993 | 0.31455
4 | train | 0.8495 | 0.6357 | 0.06464 | 0.07100 | 0.13143 | 0.29690
4 | test | 0.9243 | 0.5833 | 0.08065 | 0.08821 | 0.16263 | 0.32544
5 | train | 0.7524 | 0.6680 | 0.06390 | 0.07144 | 0.13281 | 0.30404
5 | test | 0.8924 | 0.6023 | 0.08043 | 0.08911 | 0.16545 | 0.33108
6 | train | 0.6791 | 0.7227 | 0.06369 | 0.07233 | 0.13529 | 0.31586
6 | test | 0.8759 | 0.5947 | 0.07784 | 0.09155 | 0.16806 | 0.34402
7 | train | 0.6274 | 0.7217 | 0.06219 | 0.07217 | 0.13322 | 0.31532
7 | test | 0.9553 | 0.6061 | 0.08040 | 0.08766 | 0.16285 | 0.32983
8 | train | 0.5846 | 0.7354 | 0.06360 | 0.07128 | 0.13022 | 0.30242
8 | test | 0.8294 | 0.6288 | 0.07811 | 0.09335 | 0.16194 | 0.33237
9 | train | 0.4963 | 0.7969 | 0.06211 | 0.07583 | 0.13280 | 0.31528
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
