deestroy/snn_parkour_fgpa/experiments/dvsgesture/m0_firing_rates_binarised.csv

epoch | split | loss | accuracy | c1 | c2 | c3 | fc
1 | train | 2.1071 | 0.2490 | 0.05457 | 0.07468 | 0.07860 | 0.09505
1 | test | 1.5656 | 0.4129 | 0.06533 | 0.09622 | 0.10757 | 0.16984
2 | train | 1.3032 | 0.5371 | 0.05351 | 0.08011 | 0.10326 | 0.20954
2 | test | 1.0818 | 0.5606 | 0.06635 | 0.10918 | 0.14972 | 0.29757
3 | train | 0.9921 | 0.6270 | 0.05422 | 0.08724 | 0.12217 | 0.27451
3 | test | 0.9791 | 0.5833 | 0.06721 | 0.11122 | 0.15113 | 0.30151
4 | train | 0.8307 | 0.6572 | 0.05460 | 0.08875 | 0.12408 | 0.28742
4 | test | 0.8560 | 0.6288 | 0.06749 | 0.11404 | 0.15482 | 0.31587
5 | train | 0.7030 | 0.6846 | 0.05500 | 0.09119 | 0.12520 | 0.29465
5 | test | 0.8998 | 0.6326 | 0.06794 | 0.11804 | 0.15717 | 0.31576
6 | train | 0.6415 | 0.7109 | 0.05556 | 0.09504 | 0.12921 | 0.30626
6 | test | 0.8682 | 0.6061 | 0.06815 | 0.12142 | 0.15954 | 0.32328
7 | train | 0.5635 | 0.7461 | 0.05569 | 0.09685 | 0.13113 | 0.31120
7 | test | 0.8528 | 0.6288 | 0.06870 | 0.12404 | 0.16309 | 0.32471
8 | train | 0.5189 | 0.7744 | 0.05612 | 0.09985 | 0.13441 | 0.31131
8 | test | 0.8744 | 0.6364 | 0.06915 | 0.12772 | 0.16670 | 0.32384
9 | train | 0.4620 | 0.8066 | 0.05787 | 0.10311 | 0.13698 | 0.31135
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
