deestroy/snn_parkour_fgpa/experiments/m7_sim/sweep.csv

density | input_rate | spikes_per_sample | c1_output_rate | engine | cycles_total_mean | cycles_engine_mean | check
0.005 | 0.0044 | 41.0 | 0.0021 | dense | 436247.0 | 388420.0 | PASS
0.005 | 0.0044 | 41.0 | 0.0021 | ed_k1 | 121880.3125 | 77096.375 | PASS
0.005 | 0.0044 | 41.0 | 0.0021 | ed_k4 | 121819.0 | 74915.375 | PASS
0.01 | 0.009 | 83.0 | 0.0057 | dense | 436247.0 | 388420.0 | PASS
0.01 | 0.009 | 83.0 | 0.0057 | ed_k1 | 122057.25 | 80335.625 | PASS
0.01 | 0.009 | 83.0 | 0.0057 | ed_k4 | 121819.0 | 75883.625 | PASS
0.02 | 0.0177 | 164.0 | 0.0149 | dense | 436247.0 | 388420.0 | PASS
0.02 | 0.0177 | 164.0 | 0.0149 | ed_k1 | 125560.125 | 86654.0 | PASS
0.02 | 0.0177 | 164.0 | 0.0149 | ed_k4 | 121820.5 | 77766.5 | PASS
0.05 | 0.0442 | 409.0 | 0.0478 | dense | 436247.0 | 388420.0 | PASS
0.05 | 0.0442 | 409.0 | 0.0478 | ed_k1 | 144167.5 | 105626.8125 | PASS
0.05 | 0.0442 | 409.0 | 0.0478 | ed_k4 | 122542.8125 | 83426.8125 | PASS
0.1 | 0.0882 | 816.0 | 0.093 | dense | 436247.0 | 388420.0 | PASS
0.1 | 0.0882 | 816.0 | 0.093 | ed_k1 | 175436.75 | 136956.0 | PASS
0.1 | 0.0882 | 816.0 | 0.093 | ed_k4 | 131275.9375 | 92787.0 | PASS
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
