deestroy/snn_parkour_fgpa/experiments/dvsgesture/t16/seed1_m0_firing_rates_binarised.csv

epoch | split | loss | accuracy | c1 | c2 | c3 | fc
1 | train | 2.5689 | 0.2666 | 0.08697 | 0.05457 | 0.06098 | 0.08759
1 | test | 1.5700 | 0.4091 | 0.10307 | 0.05720 | 0.05581 | 0.07367
2 | train | 1.2761 | 0.5439 | 0.08484 | 0.04782 | 0.04853 | 0.06821
2 | test | 1.0934 | 0.5606 | 0.10252 | 0.05770 | 0.06043 | 0.09562
3 | train | 0.9236 | 0.6182 | 0.08443 | 0.04943 | 0.05606 | 0.10139
3 | test | 1.0017 | 0.6098 | 0.10298 | 0.06008 | 0.06876 | 0.12572
4 | train | 0.7205 | 0.6943 | 0.08617 | 0.05185 | 0.06122 | 0.12043
4 | test | 0.9601 | 0.6439 | 0.10388 | 0.06212 | 0.07162 | 0.13527
5 | train | 0.5997 | 0.7451 | 0.08631 | 0.05336 | 0.06357 | 0.12724
5 | test | 0.9115 | 0.6288 | 0.10445 | 0.06383 | 0.07362 | 0.13835
6 | train | 0.5091 | 0.7891 | 0.08675 | 0.05518 | 0.06635 | 0.13326
6 | test | 0.9177 | 0.6477 | 0.10491 | 0.06653 | 0.07779 | 0.14637
7 | train | 0.4273 | 0.8271 | 0.08717 | 0.05738 | 0.06933 | 0.14118
7 | test | 0.8829 | 0.6705 | 0.10517 | 0.06929 | 0.08201 | 0.15860
8 | train | 0.3429 | 0.8730 | 0.08687 | 0.05891 | 0.07336 | 0.15292
8 | test | 0.9142 | 0.6629 | 0.10521 | 0.07063 | 0.08668 | 0.16790
9 | train | 0.2850 | 0.9014 | 0.08760 | 0.06036 | 0.07715 | 0.16248
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
