deestroy/snn_parkour_fgpa/experiments/dvsgesture/t16/seed2_m0_firing_rates_binarised.csv

epoch | split | loss | accuracy | c1 | c2 | c3 | fc
1 | train | 2.6826 | 0.2793 | 0.04596 | 0.05337 | 0.06702 | 0.11299
1 | test | 1.6104 | 0.4508 | 0.05511 | 0.05894 | 0.06902 | 0.11403
2 | train | 1.2932 | 0.5195 | 0.04503 | 0.04608 | 0.05346 | 0.09181
2 | test | 1.0590 | 0.5606 | 0.05392 | 0.05505 | 0.06464 | 0.11021
3 | train | 0.9559 | 0.5977 | 0.04504 | 0.04542 | 0.05624 | 0.10694
3 | test | 0.9671 | 0.6098 | 0.05358 | 0.05516 | 0.07092 | 0.13244
4 | train | 0.7757 | 0.6777 | 0.04475 | 0.04640 | 0.06102 | 0.12481
4 | test | 0.9215 | 0.6061 | 0.05290 | 0.05677 | 0.07522 | 0.14293
5 | train | 0.6572 | 0.7178 | 0.04384 | 0.04719 | 0.06354 | 0.13292
5 | test | 0.8905 | 0.6288 | 0.05264 | 0.05799 | 0.07664 | 0.14750
6 | train | 0.5794 | 0.7510 | 0.04386 | 0.04835 | 0.06510 | 0.13629
6 | test | 0.9480 | 0.6023 | 0.05251 | 0.05918 | 0.07848 | 0.14993
7 | train | 0.5480 | 0.7568 | 0.04373 | 0.04896 | 0.06561 | 0.13716
7 | test | 1.0838 | 0.6023 | 0.05256 | 0.05894 | 0.07631 | 0.14493
8 | train | 0.5087 | 0.7578 | 0.04402 | 0.04935 | 0.06534 | 0.13516
8 | test | 0.9353 | 0.6212 | 0.05293 | 0.05986 | 0.07718 | 0.14460
9 | train | 0.4121 | 0.8232 | 0.04405 | 0.04963 | 0.06599 | 0.13622
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
