deestroy/snn_parkour_fgpa/experiments/dvsgesture/t8/seed1_m0_firing_rates_binarised.csv

epoch | split | loss | accuracy | c1 | c2 | c3 | fc
1 | train | 2.0309 | 0.2861 | 0.10743 | 0.06616 | 0.07789 | 0.11880
1 | test | 1.2706 | 0.4848 | 0.13373 | 0.08068 | 0.09827 | 0.16726
2 | train | 1.1091 | 0.5889 | 0.10655 | 0.06838 | 0.09159 | 0.18422
2 | test | 1.0122 | 0.5720 | 0.13467 | 0.08647 | 0.12135 | 0.25238
3 | train | 0.8937 | 0.6416 | 0.10652 | 0.07044 | 0.10314 | 0.23729
3 | test | 0.9020 | 0.6061 | 0.13522 | 0.08721 | 0.12572 | 0.26473
4 | train | 0.7116 | 0.6807 | 0.10840 | 0.07112 | 0.10468 | 0.24421
4 | test | 0.8455 | 0.6061 | 0.13543 | 0.08592 | 0.12363 | 0.26046
5 | train | 0.6082 | 0.7412 | 0.10820 | 0.07077 | 0.10434 | 0.24068
5 | test | 0.8421 | 0.6591 | 0.13640 | 0.08709 | 0.12590 | 0.26565
6 | train | 0.5264 | 0.7812 | 0.10878 | 0.07267 | 0.10810 | 0.25296
6 | test | 0.8771 | 0.6250 | 0.13726 | 0.09090 | 0.13292 | 0.28580
7 | train | 0.4803 | 0.7949 | 0.10975 | 0.07441 | 0.11111 | 0.26838
7 | test | 0.9334 | 0.6364 | 0.13795 | 0.09138 | 0.13260 | 0.29287
8 | train | 0.4248 | 0.8174 | 0.10922 | 0.07489 | 0.11053 | 0.26601
8 | test | 0.8603 | 0.6477 | 0.13731 | 0.09312 | 0.13396 | 0.28581
9 | train | 0.3542 | 0.8496 | 0.10974 | 0.07736 | 0.11369 | 0.26879
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
