deestroy/snn_parkour_fgpa/experiments/dvsgesture/t8/seed2_m0_firing_rates_binarised.csv

epoch | split | loss | accuracy | c1 | c2 | c3 | fc
1 | train | 2.1270 | 0.2939 | 0.05690 | 0.06130 | 0.07717 | 0.12615
1 | test | 1.4159 | 0.4621 | 0.07172 | 0.07186 | 0.09466 | 0.16326
2 | train | 1.2302 | 0.5176 | 0.05677 | 0.05620 | 0.08004 | 0.15591
2 | test | 1.0028 | 0.5492 | 0.07153 | 0.07045 | 0.10853 | 0.20489
3 | train | 0.9547 | 0.6006 | 0.05730 | 0.05679 | 0.09043 | 0.19323
3 | test | 0.9605 | 0.5795 | 0.07105 | 0.06988 | 0.11326 | 0.22275
4 | train | 0.7894 | 0.6641 | 0.05682 | 0.05700 | 0.09353 | 0.20327
4 | test | 0.8963 | 0.5947 | 0.06980 | 0.07080 | 0.11480 | 0.22168
5 | train | 0.6810 | 0.7021 | 0.05555 | 0.05780 | 0.09465 | 0.20430
5 | test | 0.8752 | 0.6061 | 0.06944 | 0.07290 | 0.11688 | 0.22476
6 | train | 0.6130 | 0.7354 | 0.05561 | 0.05968 | 0.09810 | 0.21008
6 | test | 0.9171 | 0.6174 | 0.06915 | 0.07555 | 0.12147 | 0.23123
7 | train | 0.5734 | 0.7480 | 0.05511 | 0.06092 | 0.10004 | 0.21399
7 | test | 0.9663 | 0.6250 | 0.06920 | 0.07627 | 0.12170 | 0.23300
8 | train | 0.5077 | 0.7676 | 0.05520 | 0.06187 | 0.09988 | 0.21497
8 | test | 0.8399 | 0.6288 | 0.06926 | 0.07886 | 0.12310 | 0.23381
9 | train | 0.4439 | 0.8125 | 0.05515 | 0.06361 | 0.10217 | 0.22023
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
