deestroy/snn_parkour_fgpa/experiments/dvsgesture/t16/m0_firing_rates_binarised.csv

epoch | split | loss | accuracy | c1 | c2 | c3 | fc
1 | train | 2.2291 | 0.3213 | 0.03445 | 0.05035 | 0.05855 | 0.07274
1 | test | 1.4309 | 0.4697 | 0.03773 | 0.05077 | 0.05201 | 0.05835
2 | train | 1.1941 | 0.5664 | 0.03301 | 0.04455 | 0.04805 | 0.06648
2 | test | 1.0511 | 0.5720 | 0.03797 | 0.05240 | 0.05798 | 0.09014
3 | train | 0.8621 | 0.6396 | 0.03320 | 0.04750 | 0.05538 | 0.10064
3 | test | 0.9903 | 0.6098 | 0.03856 | 0.05649 | 0.06691 | 0.12066
4 | train | 0.7066 | 0.6904 | 0.03372 | 0.05020 | 0.06033 | 0.12083
4 | test | 0.8932 | 0.6136 | 0.03918 | 0.05875 | 0.06972 | 0.13172
5 | train | 0.5960 | 0.7461 | 0.03410 | 0.05161 | 0.06141 | 0.12581
5 | test | 0.8816 | 0.6402 | 0.03928 | 0.05966 | 0.06917 | 0.12833
6 | train | 0.5170 | 0.7852 | 0.03438 | 0.05284 | 0.06173 | 0.12498
6 | test | 0.8907 | 0.6477 | 0.03972 | 0.06152 | 0.07001 | 0.13125
7 | train | 0.4349 | 0.8125 | 0.03455 | 0.05426 | 0.06387 | 0.13242
7 | test | 0.8466 | 0.6439 | 0.03982 | 0.06339 | 0.07403 | 0.14023
8 | train | 0.3936 | 0.8311 | 0.03486 | 0.05629 | 0.06757 | 0.14269
8 | test | 0.8973 | 0.6402 | 0.04027 | 0.06591 | 0.07900 | 0.15519
9 | train | 0.3460 | 0.8525 | 0.03509 | 0.05810 | 0.07079 | 0.15294
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
