deestroy/snn_parkour_fgpa/experiments/dvsgesture/t8/m0_firing_rates_binarised.csv

epoch | split | loss | accuracy | c1 | c2 | c3 | fc
1 | train | 2.0643 | 0.3125 | 0.04576 | 0.06578 | 0.07515 | 0.09697
1 | test | 1.3856 | 0.5076 | 0.05245 | 0.07495 | 0.08656 | 0.12672
2 | train | 1.1945 | 0.5674 | 0.04440 | 0.06531 | 0.08019 | 0.14451
2 | test | 1.0655 | 0.5417 | 0.05408 | 0.08292 | 0.10439 | 0.18853
3 | train | 0.9057 | 0.6211 | 0.04555 | 0.07087 | 0.09106 | 0.19019
3 | test | 0.9440 | 0.6174 | 0.05530 | 0.08917 | 0.11149 | 0.21643
4 | train | 0.7363 | 0.6836 | 0.04602 | 0.07385 | 0.09251 | 0.20413
4 | test | 0.8299 | 0.6477 | 0.05582 | 0.09070 | 0.10961 | 0.21942
5 | train | 0.6180 | 0.7217 | 0.04640 | 0.07477 | 0.09138 | 0.20577
5 | test | 0.9020 | 0.6061 | 0.05614 | 0.09179 | 0.10976 | 0.22116
6 | train | 0.5425 | 0.7822 | 0.04695 | 0.07685 | 0.09314 | 0.21137
6 | test | 0.8762 | 0.6250 | 0.05706 | 0.09584 | 0.11281 | 0.22876
7 | train | 0.4732 | 0.8047 | 0.04727 | 0.07948 | 0.09620 | 0.21835
7 | test | 0.8342 | 0.6515 | 0.05724 | 0.09908 | 0.11724 | 0.23258
8 | train | 0.4290 | 0.8311 | 0.04791 | 0.08274 | 0.10152 | 0.22689
8 | test | 0.8768 | 0.6515 | 0.05791 | 0.10207 | 0.12368 | 0.23888
9 | train | 0.3776 | 0.8438 | 0.04840 | 0.08471 | 0.10494 | 0.23114
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
