deestroy/snn_parkour_fgpa/experiments/dvsgesture/c0046/rerun_seed0/t16_seed0_firing_rates.csv

epoch | split | loss | accuracy | c1 | c2 | c3 | fc
1 | train | 2.2357 | 0.3281 | 0.03446 | 0.05039 | 0.05863 | 0.07301
1 | test | 1.4299 | 0.4659 | 0.03777 | 0.05084 | 0.05200 | 0.05844
2 | train | 1.2032 | 0.5537 | 0.03301 | 0.04448 | 0.04786 | 0.06626
2 | test | 1.0770 | 0.5455 | 0.03792 | 0.05211 | 0.05735 | 0.08899
3 | train | 0.8711 | 0.6426 | 0.03320 | 0.04734 | 0.05502 | 0.09972
3 | test | 1.0165 | 0.6136 | 0.03861 | 0.05642 | 0.06668 | 0.12046
4 | train | 0.7193 | 0.6982 | 0.03376 | 0.05010 | 0.05999 | 0.11993
4 | test | 0.8710 | 0.6174 | 0.03923 | 0.05854 | 0.06892 | 0.12962
5 | train | 0.6071 | 0.7334 | 0.03417 | 0.05141 | 0.06055 | 0.12292
5 | test | 0.8781 | 0.6439 | 0.03935 | 0.05951 | 0.06836 | 0.12513
6 | train | 0.5122 | 0.7793 | 0.03444 | 0.05279 | 0.06144 | 0.12346
6 | test | 0.8555 | 0.6477 | 0.03974 | 0.06155 | 0.07070 | 0.13175
7 | train | 0.4320 | 0.8154 | 0.03461 | 0.05439 | 0.06461 | 0.13374
7 | test | 0.8592 | 0.6515 | 0.03999 | 0.06378 | 0.07520 | 0.14145
8 | train | 0.3852 | 0.8398 | 0.03501 | 0.05671 | 0.06852 | 0.14414
8 | test | 0.9020 | 0.6515 | 0.04052 | 0.06661 | 0.08008 | 0.15636
9 | train | 0.3481 | 0.8584 | 0.03528 | 0.05852 | 0.07151 | 0.15492
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
