deestroy/snn_parkour_fgpa/experiments/dvsgesture/c0046/rerun_seed0/t8_seed0_firing_rates.csv

epoch | split | loss | accuracy | c1 | c2 | c3 | fc
1 | train | 2.0644 | 0.3125 | 0.04576 | 0.06578 | 0.07515 | 0.09698
1 | test | 1.3951 | 0.4924 | 0.05244 | 0.07493 | 0.08659 | 0.12654
2 | train | 1.2027 | 0.5566 | 0.04438 | 0.06533 | 0.08021 | 0.14480
2 | test | 1.0648 | 0.5455 | 0.05377 | 0.08293 | 0.10422 | 0.18739
3 | train | 0.8925 | 0.6328 | 0.04528 | 0.07093 | 0.09079 | 0.18982
3 | test | 0.9443 | 0.6098 | 0.05521 | 0.08915 | 0.11123 | 0.21519
4 | train | 0.7320 | 0.6758 | 0.04597 | 0.07412 | 0.09326 | 0.20546
4 | test | 0.8441 | 0.6591 | 0.05577 | 0.09138 | 0.11115 | 0.22255
5 | train | 0.6140 | 0.7373 | 0.04642 | 0.07527 | 0.09239 | 0.20791
5 | test | 0.8909 | 0.6136 | 0.05622 | 0.09237 | 0.11041 | 0.22180
6 | train | 0.5435 | 0.7715 | 0.04699 | 0.07721 | 0.09390 | 0.21272
6 | test | 0.8843 | 0.6098 | 0.05706 | 0.09606 | 0.11305 | 0.22979
7 | train | 0.4742 | 0.8076 | 0.04754 | 0.08005 | 0.09666 | 0.21912
7 | test | 0.8404 | 0.6326 | 0.05767 | 0.10059 | 0.11845 | 0.23474
8 | train | 0.4399 | 0.8115 | 0.04827 | 0.08431 | 0.10250 | 0.23122
8 | test | 0.8801 | 0.6402 | 0.05847 | 0.10412 | 0.12347 | 0.24224
9 | train | 0.3848 | 0.8330 | 0.04861 | 0.08577 | 0.10381 | 0.23246
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
