deestroy/snn_parkour_fgpa/experiments/figures/diagrams/fig_bank_interleave.png

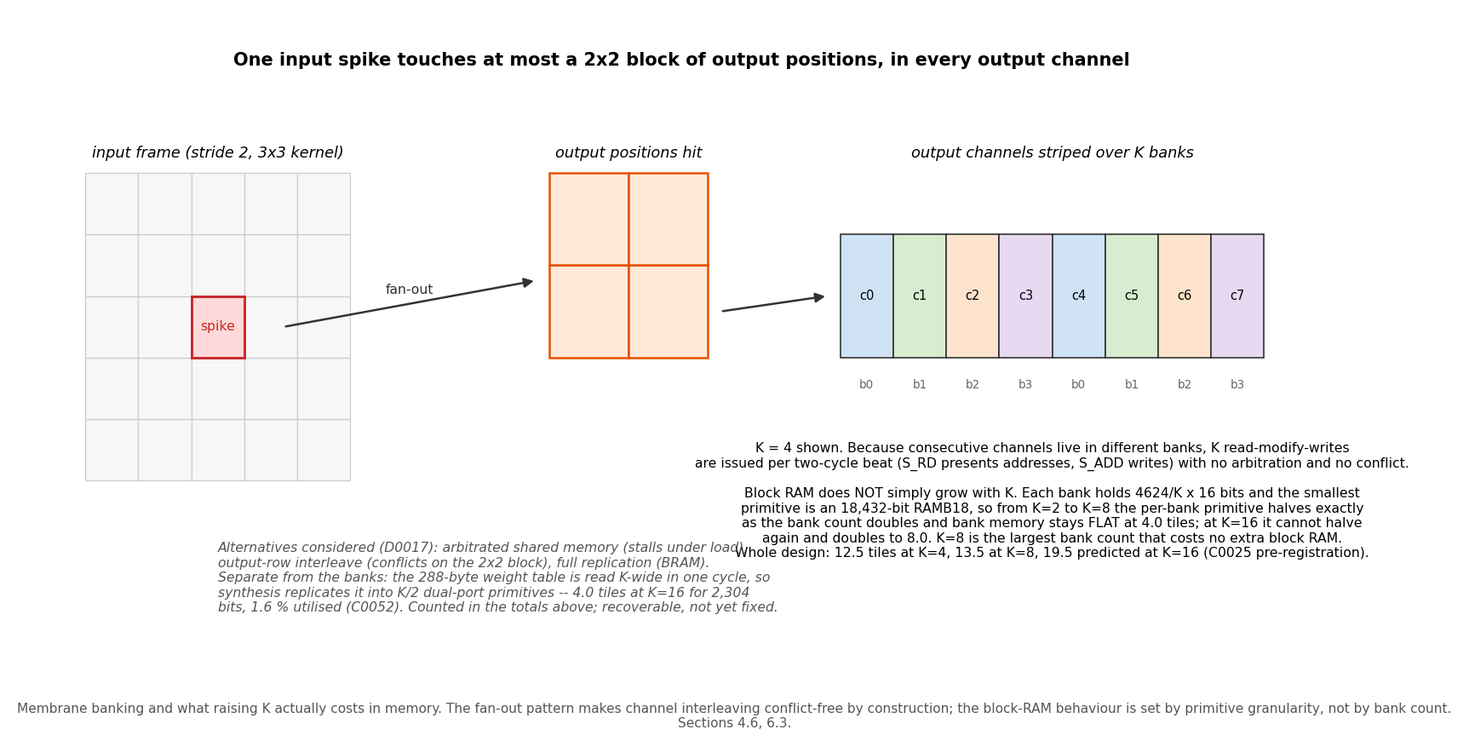
experiments/figures/diagrams/fig_bank_interleave.png
