deestroy/snn_parkour_fgpa/experiments/figures/diagrams/fig_dense_datapath.png

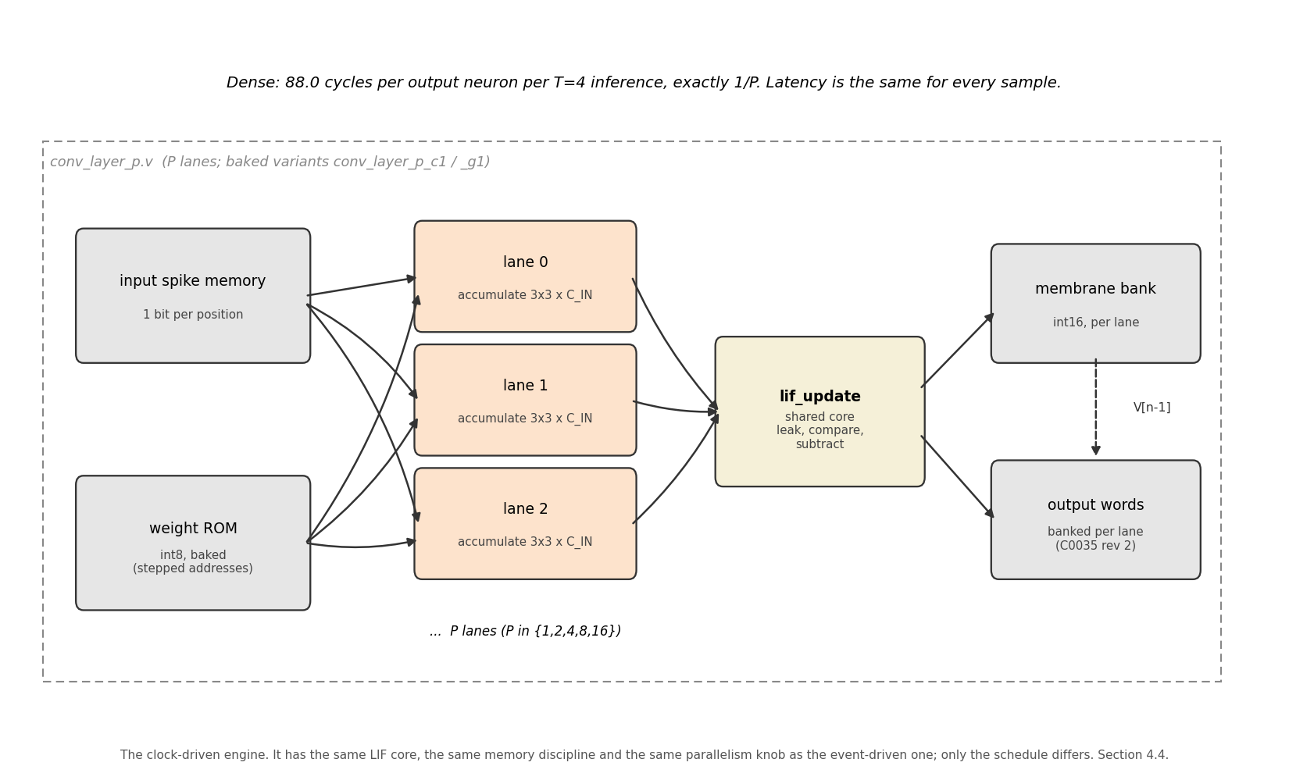
experiments/figures/diagrams/fig_dense_datapath.png
