deestroy/snn_parkour_fgpa/experiments/figures/diagrams/fig_ed_datapath.png

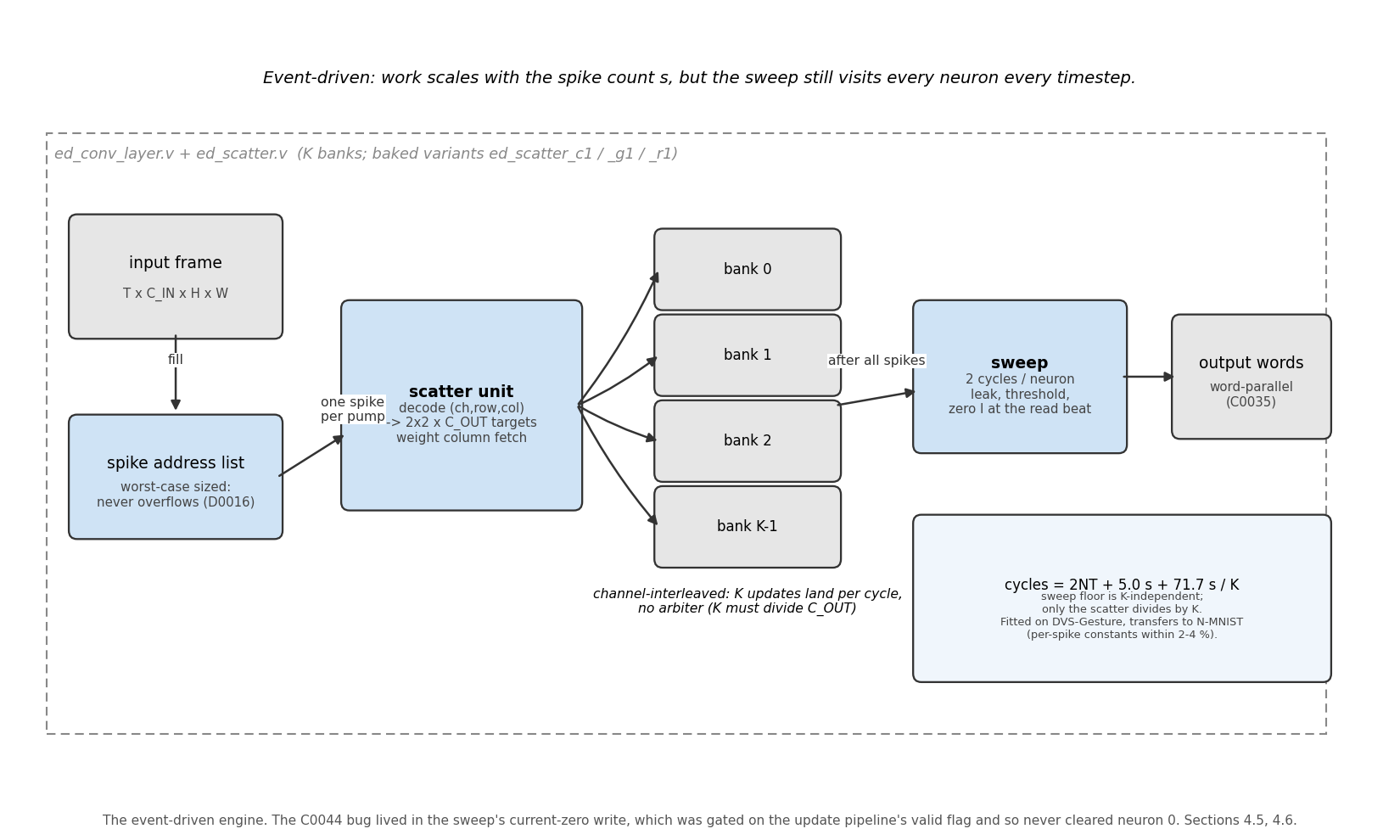
experiments/figures/diagrams/fig_ed_datapath.png
