deestroy/snn_parkour_fgpa/experiments/figures/diagrams/fig_fsm_engines.png

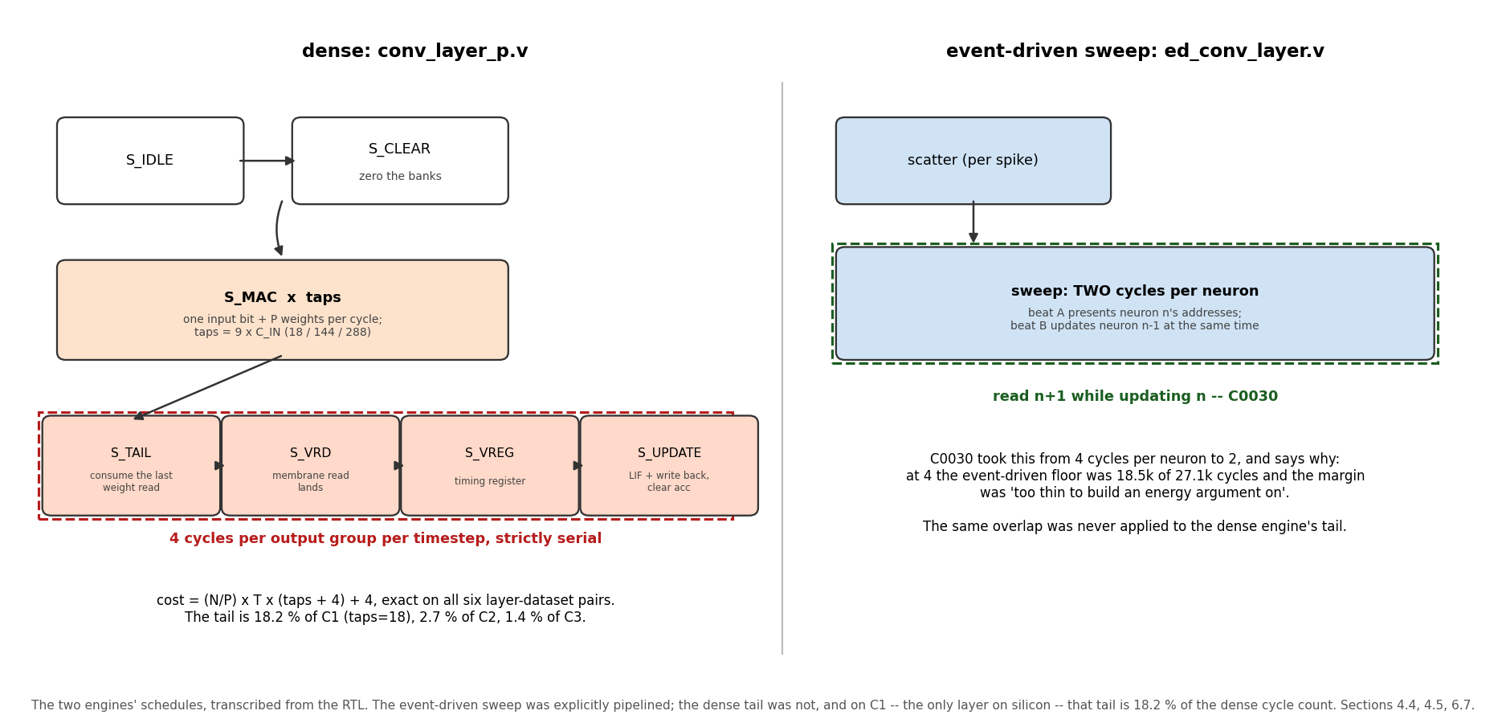
experiments/figures/diagrams/fig_fsm_engines.png
