deestroy/snn_parkour_fgpa/experiments/figures/diagrams/fig_fsm_wrapper.png

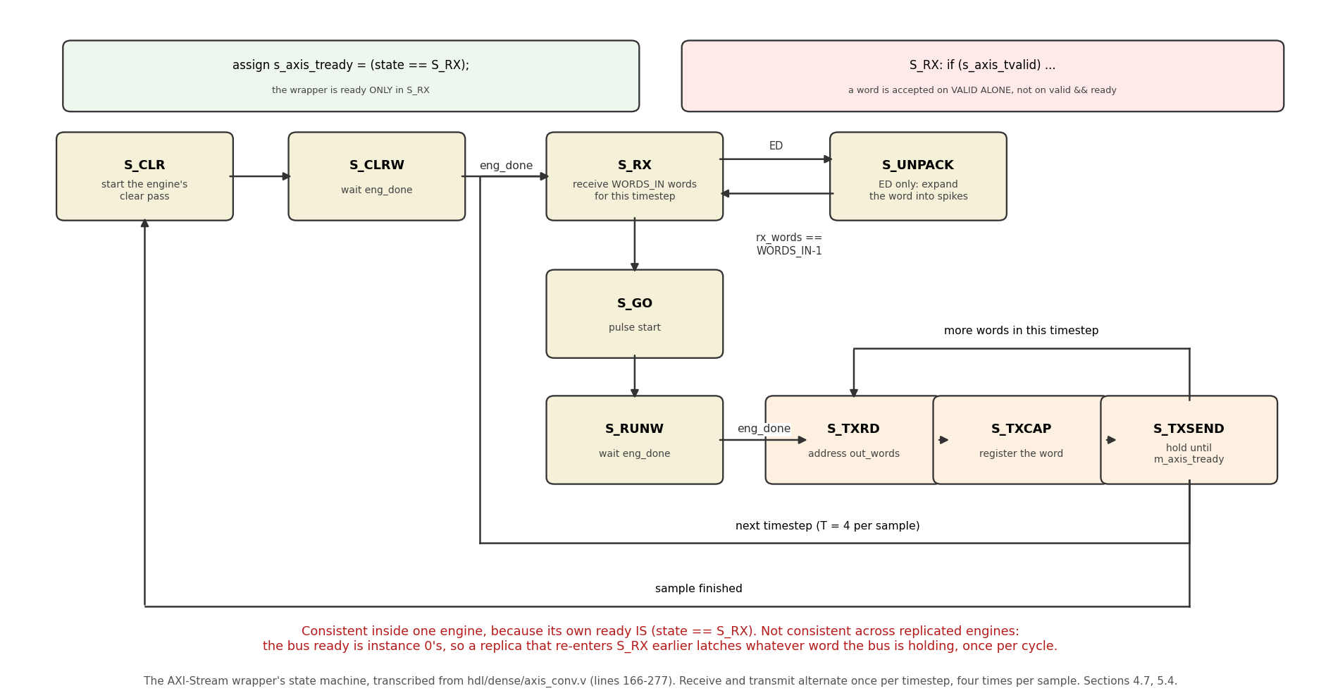
experiments/figures/diagrams/fig_fsm_wrapper.png
