deestroy/snn_parkour_fgpa/experiments/figures/diagrams/fig_lif_core.png

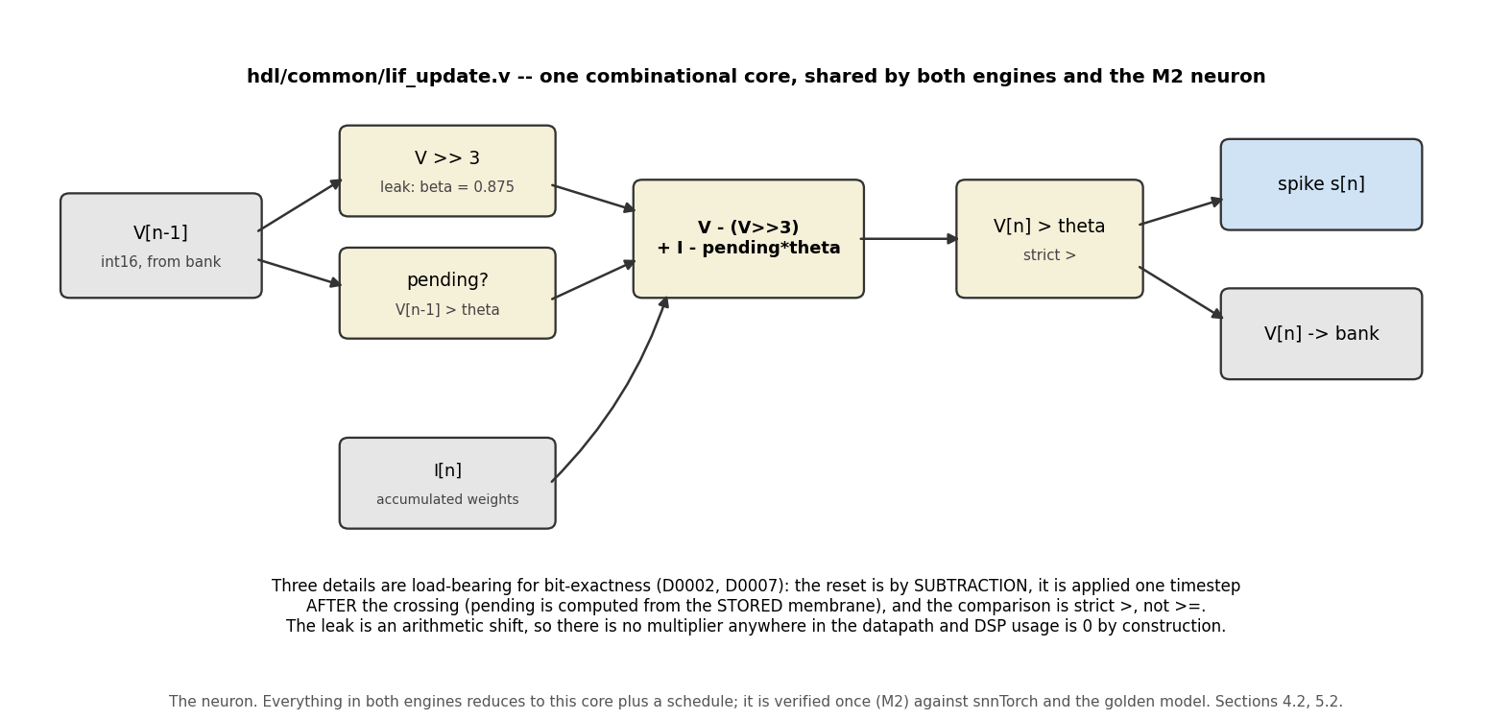
experiments/figures/diagrams/fig_lif_core.png
