deestroy/snn_parkour_fgpa/experiments/figures/diagrams/fig_measurement_boundary.png

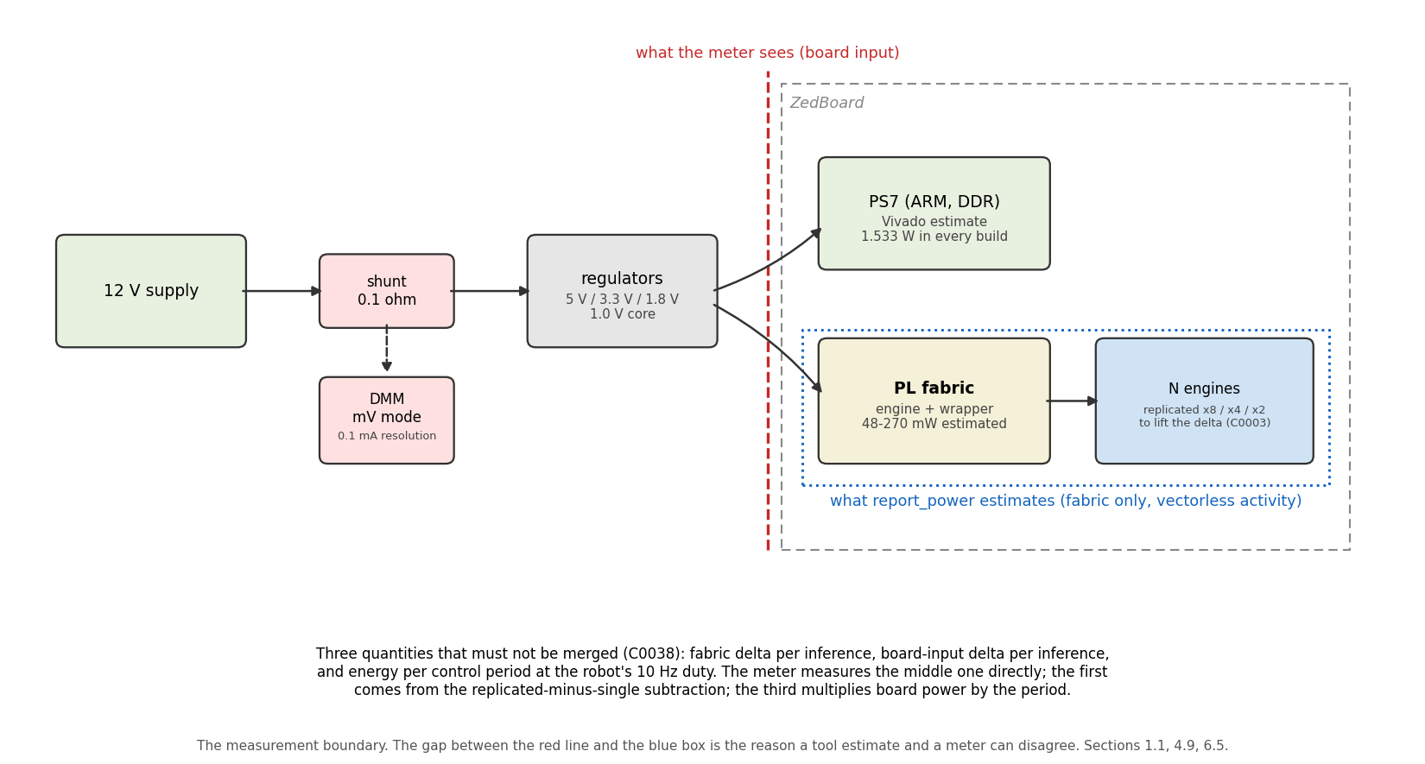
experiments/figures/diagrams/fig_measurement_boundary.png
