deestroy/snn_parkour_fgpa/experiments/figures/diagrams/fig_paradigms.png

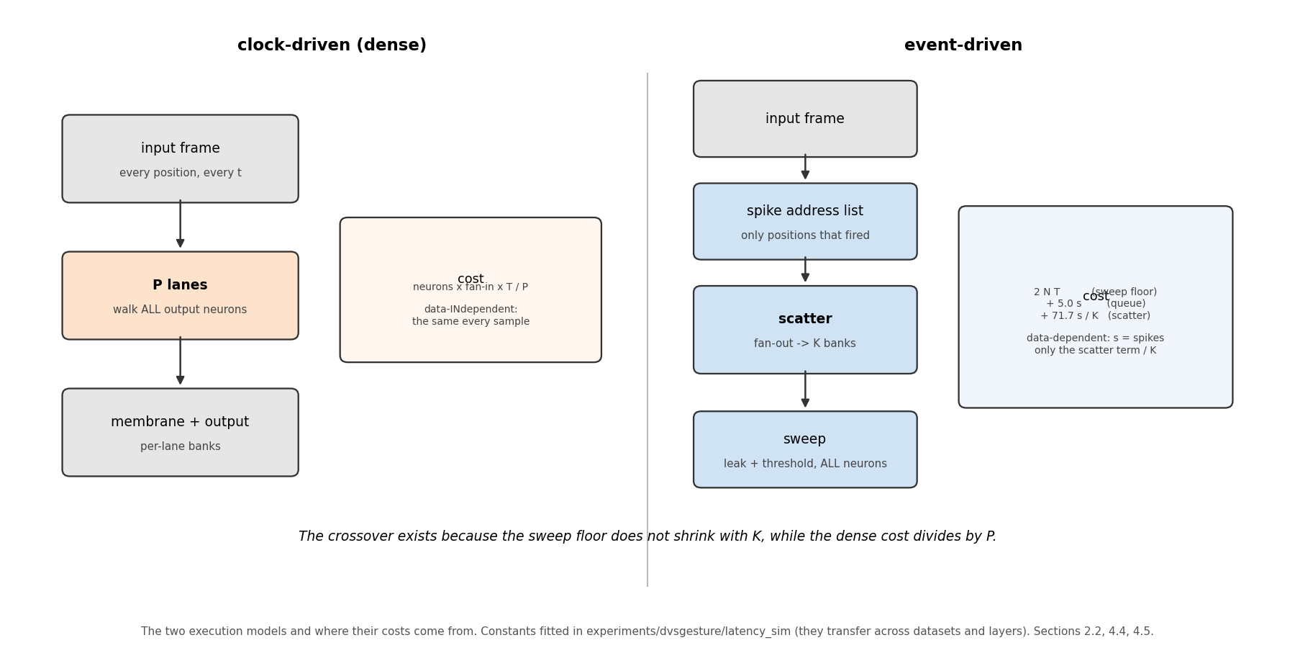
experiments/figures/diagrams/fig_paradigms.png
