deestroy/snn_parkour_fgpa/experiments/figures/diagrams/fig_perception_loop.png

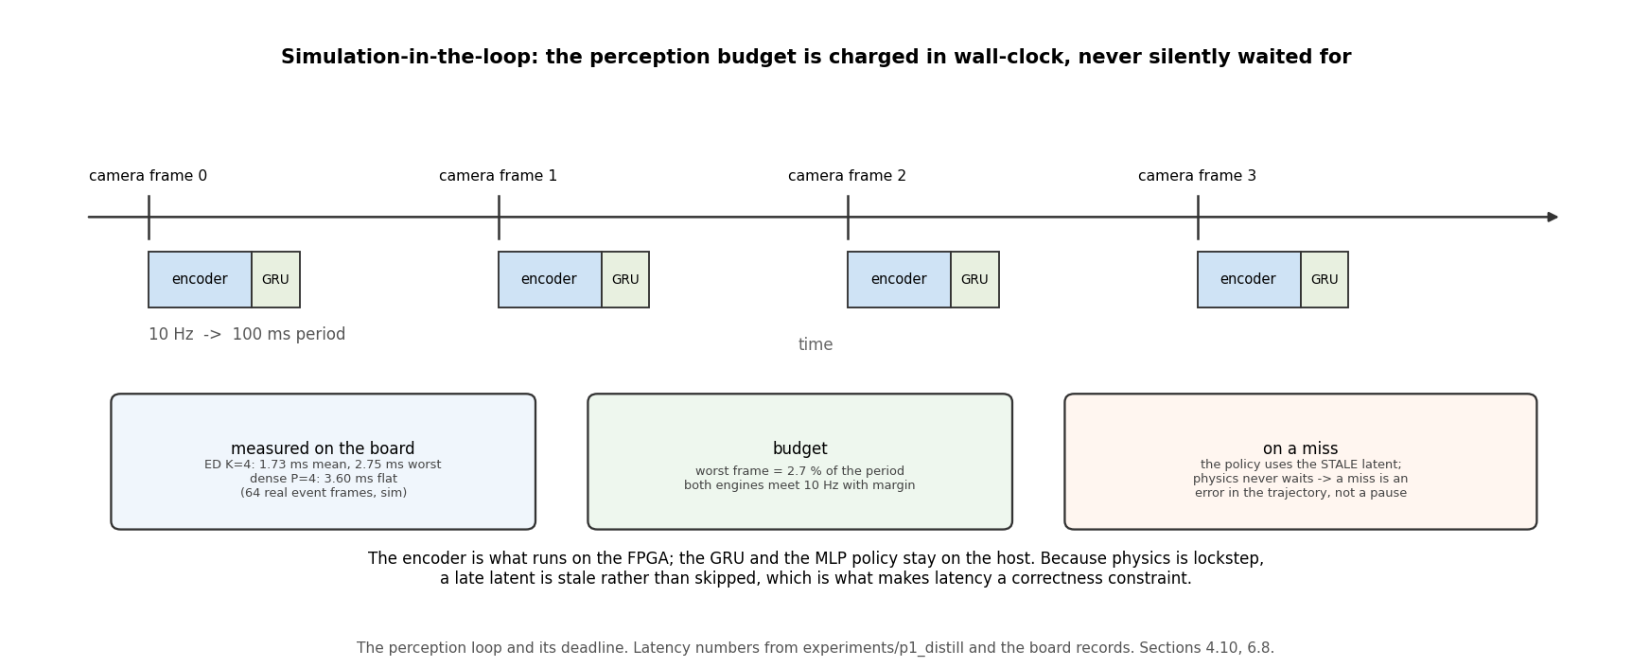
experiments/figures/diagrams/fig_perception_loop.png
