deestroy/snn_parkour_fgpa/experiments/figures/diagrams/fig_system.png

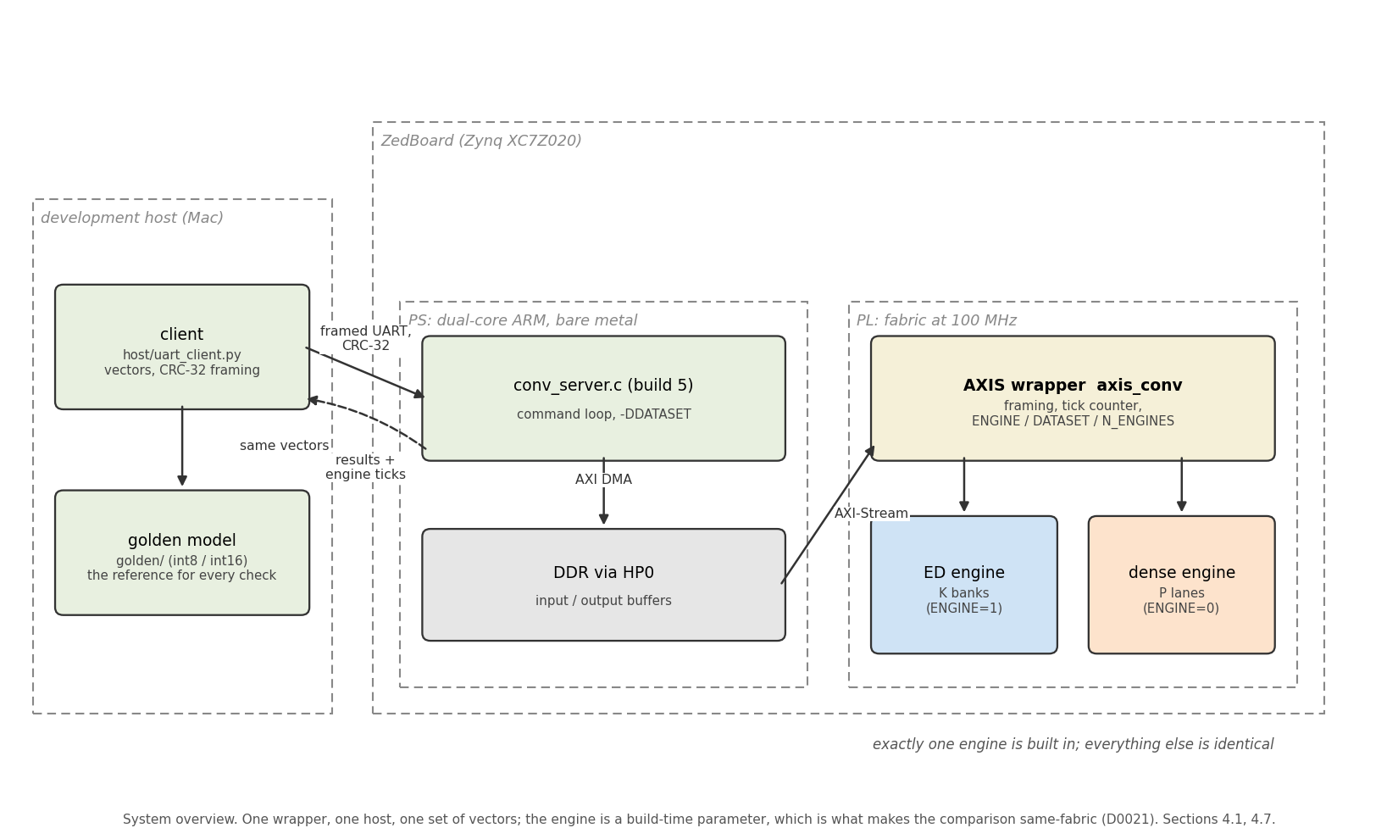
experiments/figures/diagrams/fig_system.png
