deestroy/snn_parkour_fgpa/experiments/figures/diagrams/fig_toolflow.png

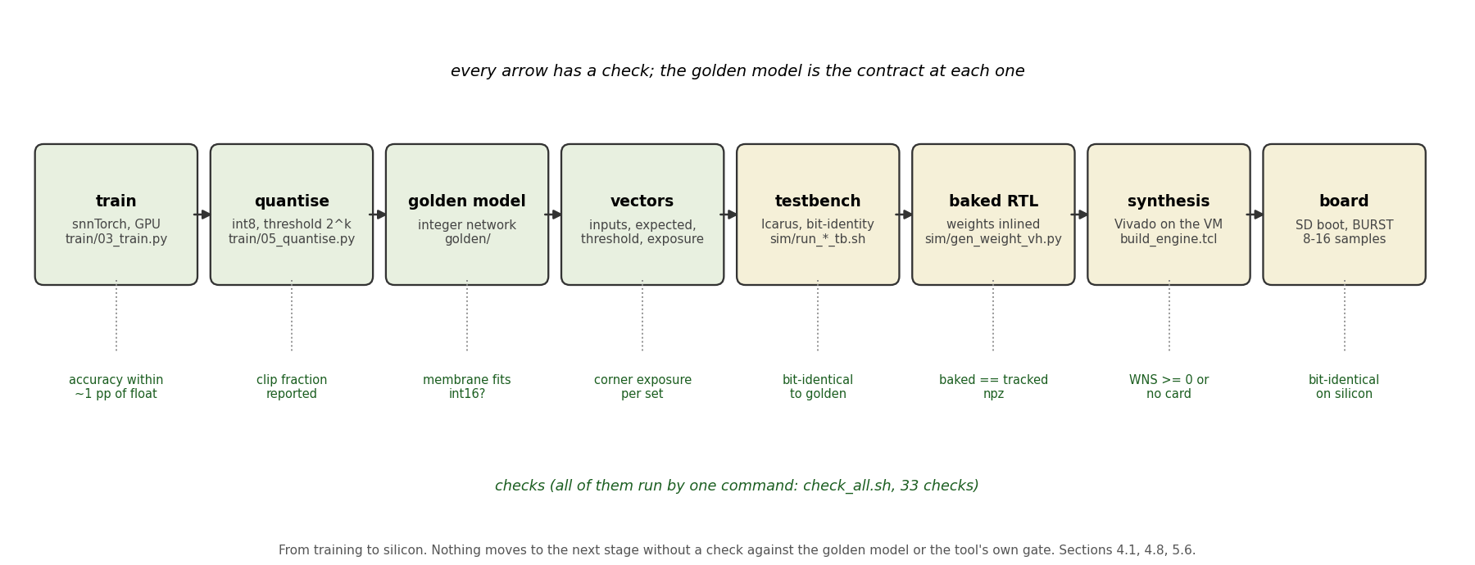
experiments/figures/diagrams/fig_toolflow.png
