deestroy/snn_parkour_fgpa/experiments/figures/diagrams/fig_verification_flow.png

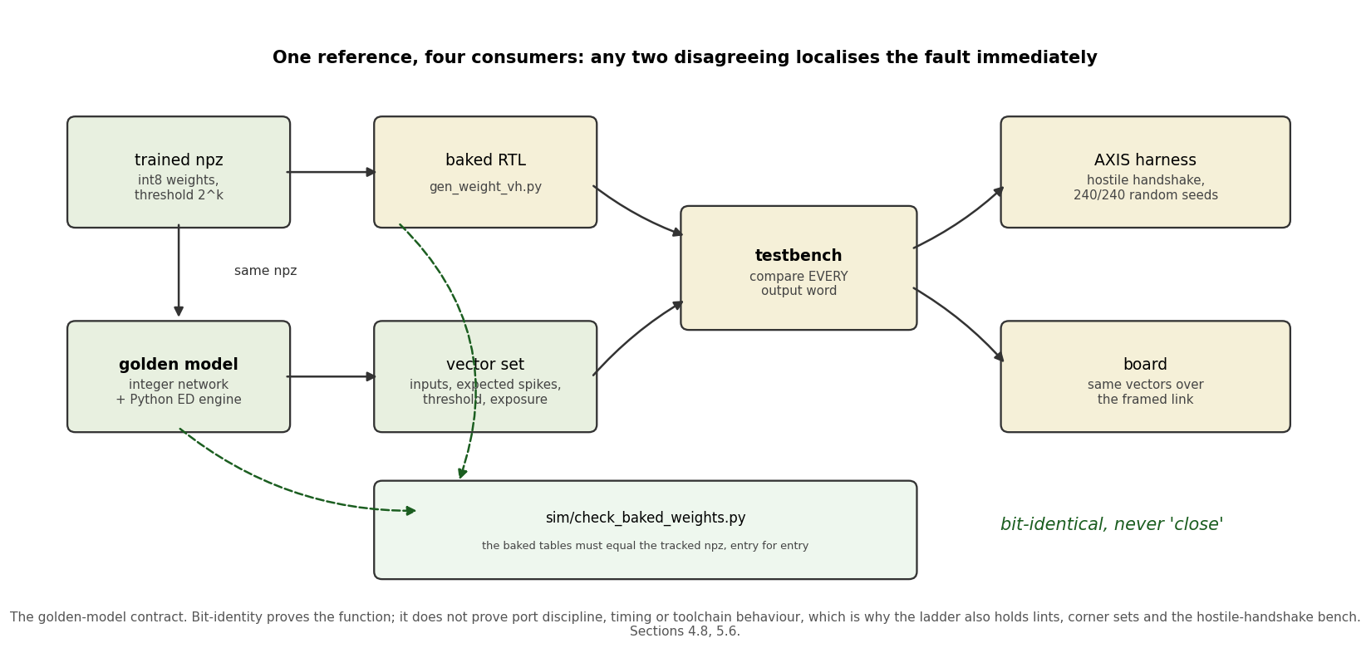
experiments/figures/diagrams/fig_verification_flow.png
