deestroy/snn_parkour_fgpa/experiments/figures/fig_accuracy_vs_activity.png

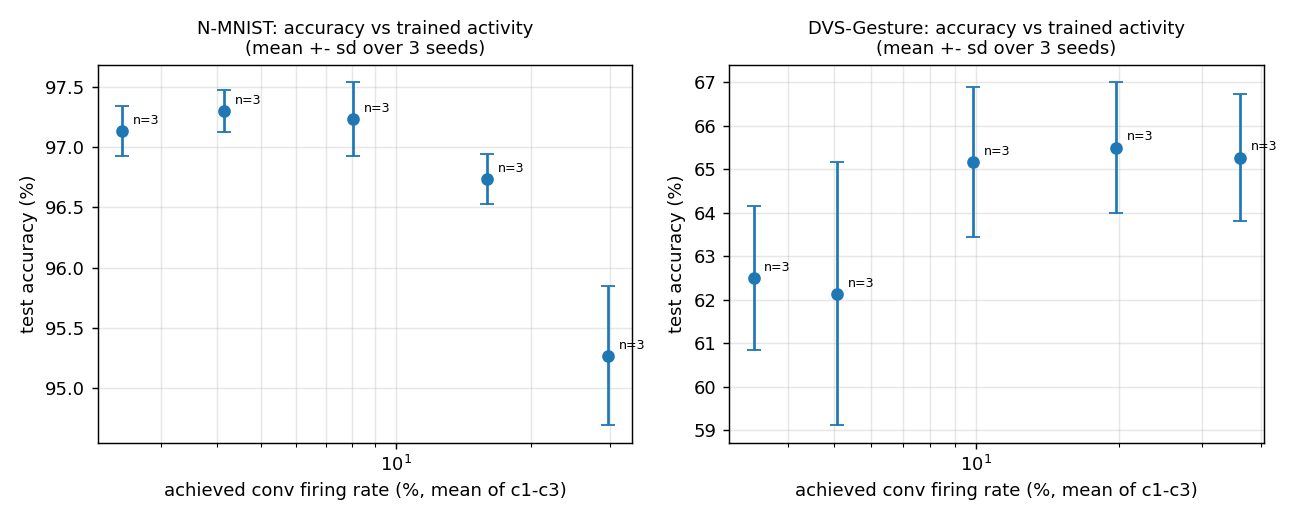
experiments/figures/fig_accuracy_vs_activity.png
