deestroy/snn_parkour_fgpa/experiments/figures/fig_activity_c2c3.png

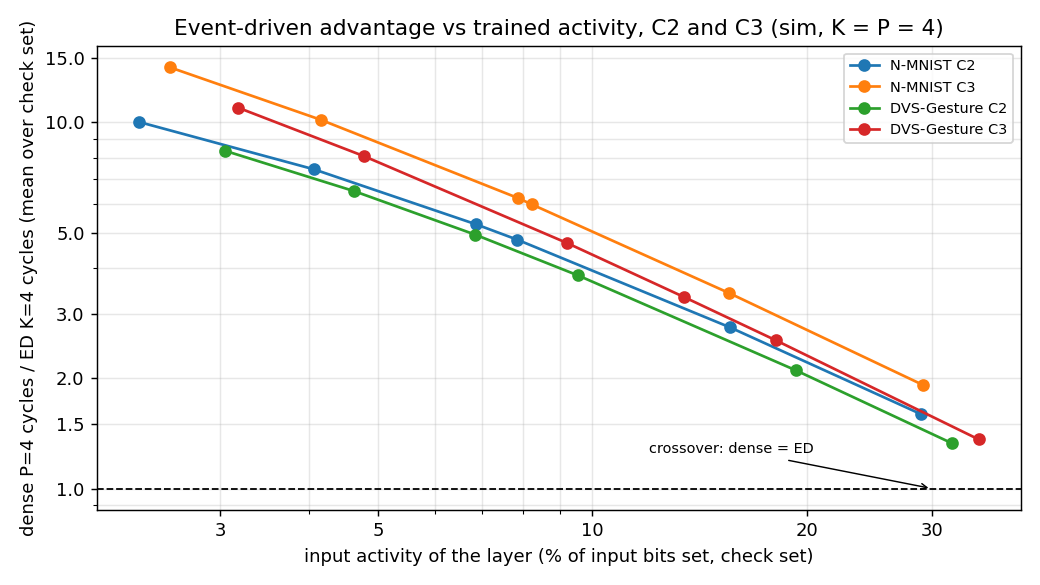
experiments/figures/fig_activity_c2c3.png
