deestroy/snn_parkour_fgpa/experiments/figures/fig_crossover_vs_kp.png

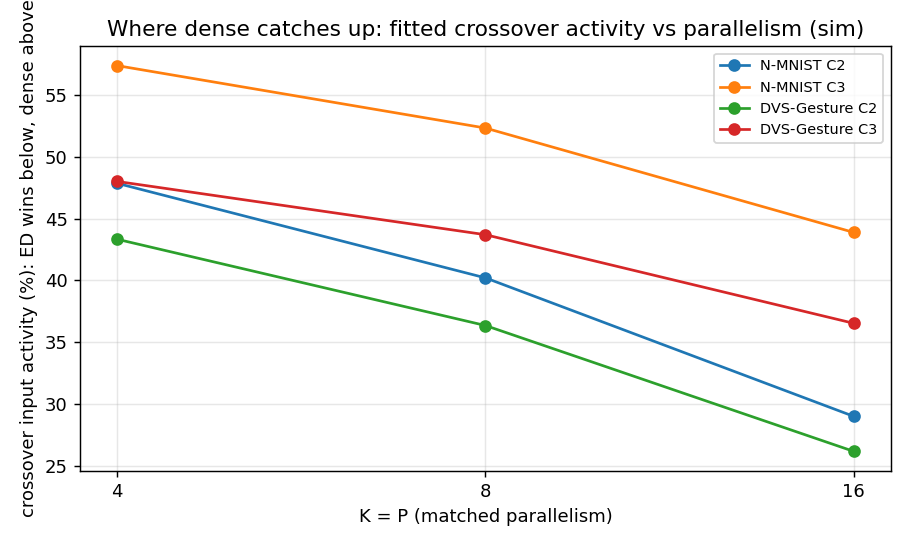
experiments/figures/fig_crossover_vs_kp.png
