deestroy/snn_parkour_fgpa/experiments/figures/fig_dvsg_perclip.png

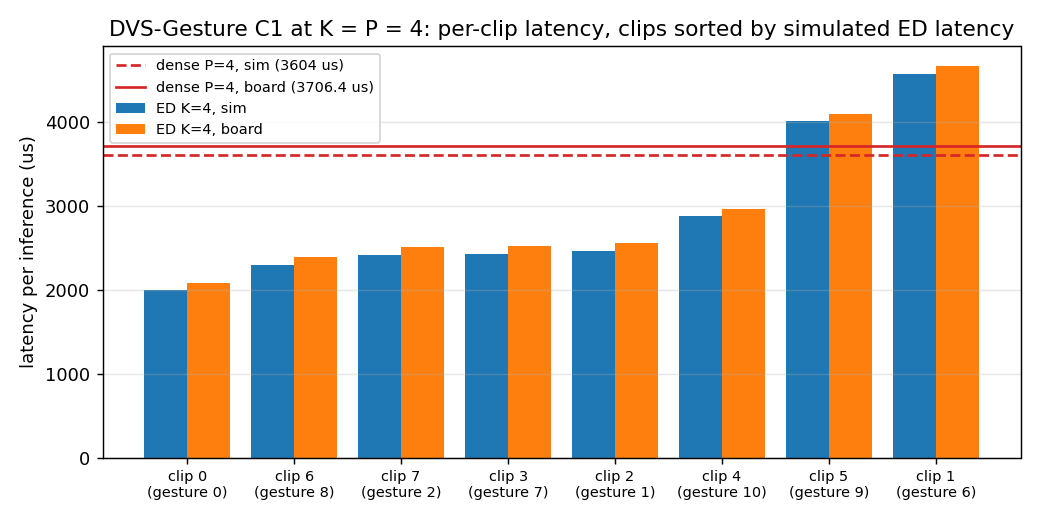
experiments/figures/fig_dvsg_perclip.png
