deestroy/snn_parkour_fgpa/experiments/figures/fig_inputs.png

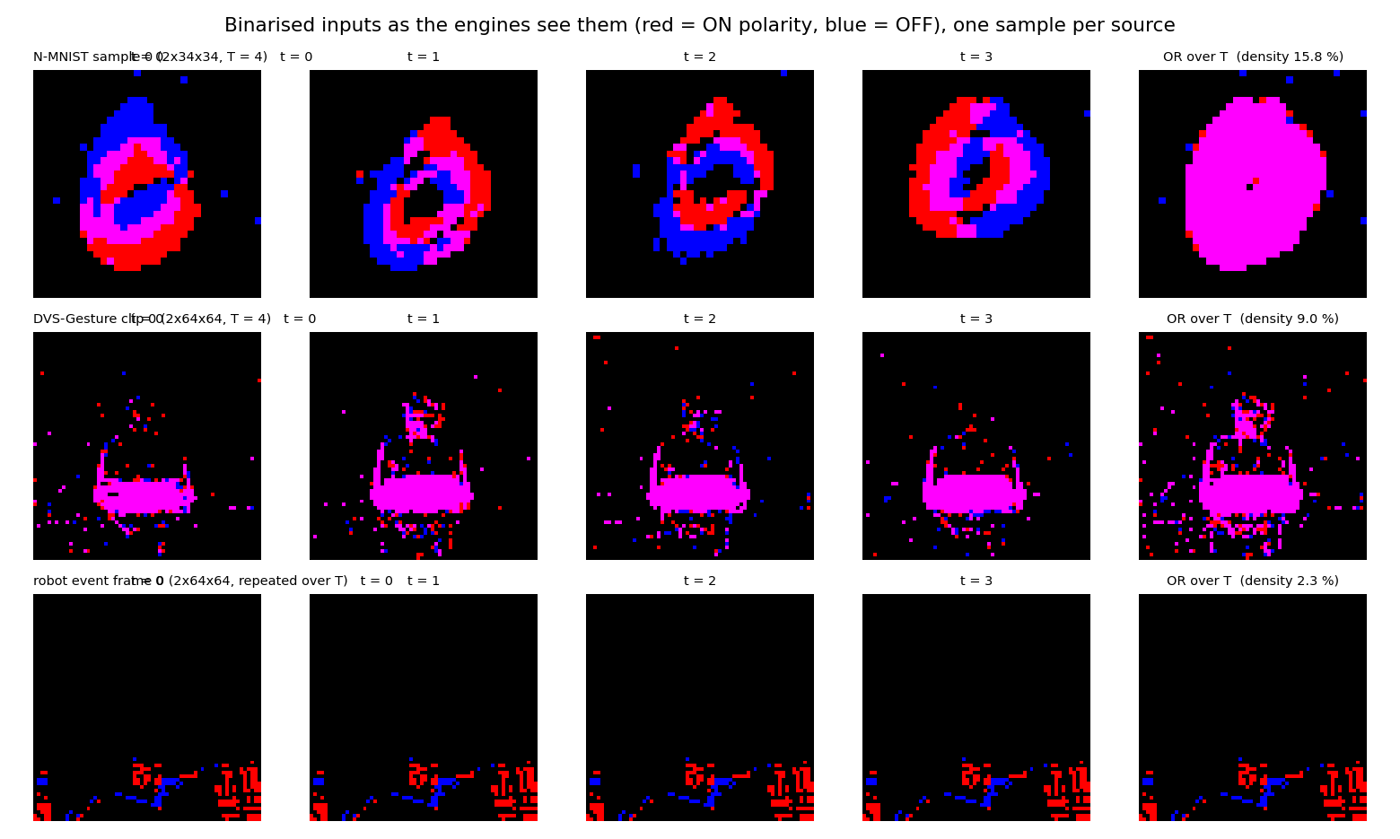
experiments/figures/fig_inputs.png
