deestroy/snn_parkour_fgpa/experiments/figures/fig_kp_sweep.png

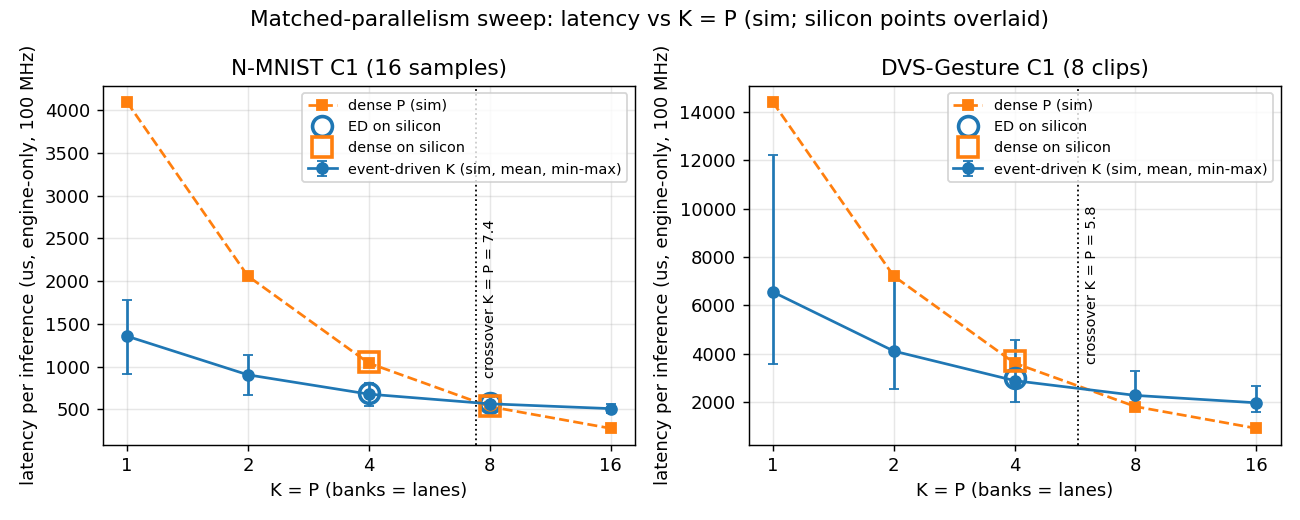
experiments/figures/fig_kp_sweep.png
