deestroy/snn_parkour_fgpa/experiments/figures/fig_per_sample.png

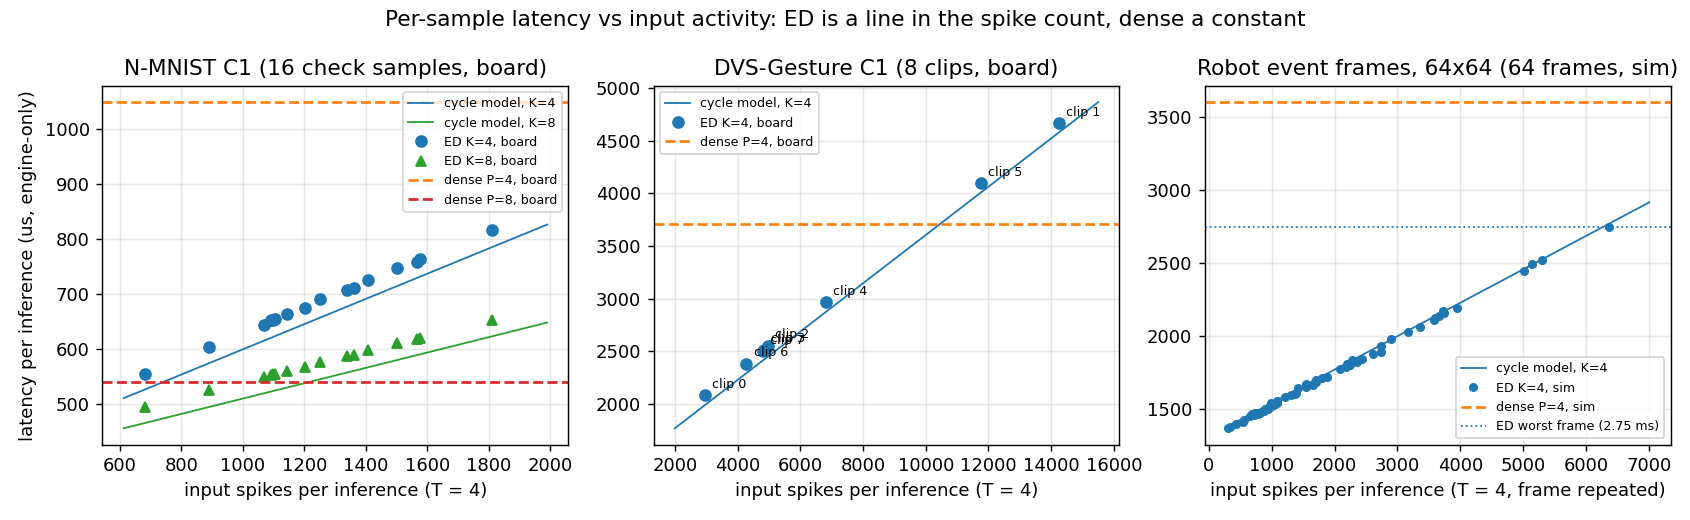
experiments/figures/fig_per_sample.png
