deestroy/snn_parkour_fgpa/experiments/figures/fig_resources.png

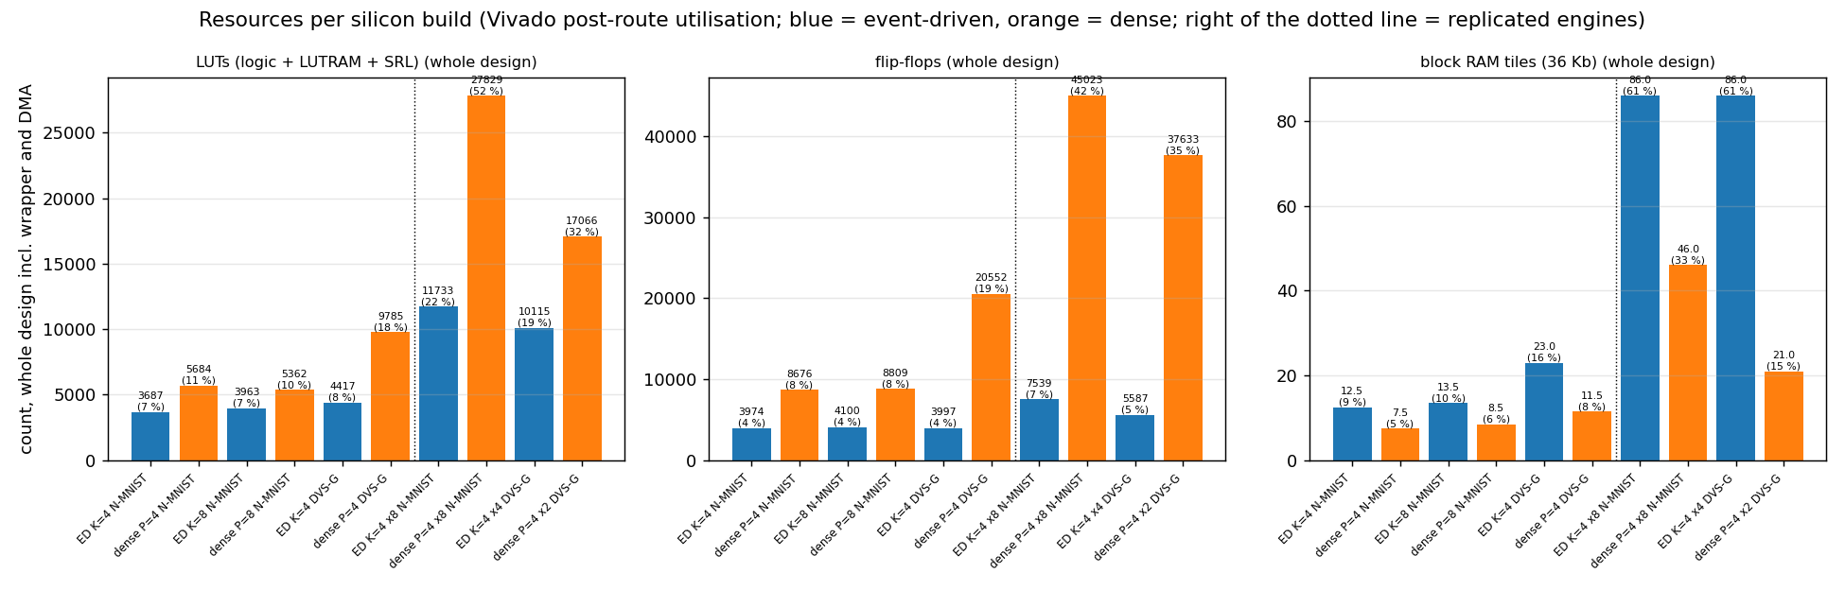
experiments/figures/fig_resources.png
