deestroy/snn_parkour_fgpa/experiments/figures/fig_tsweep_int16.png

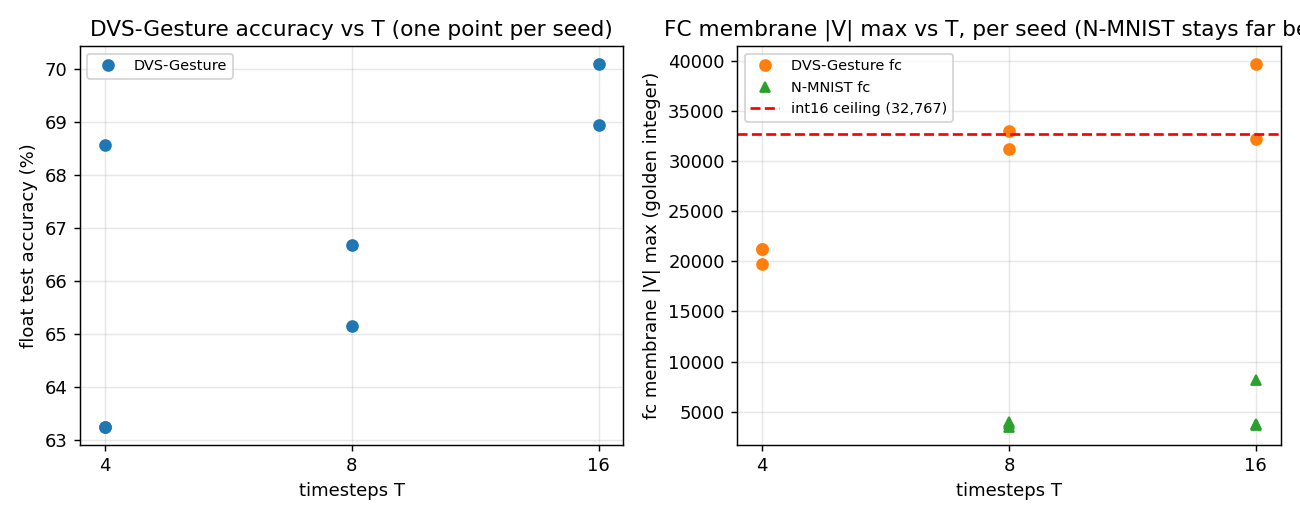
experiments/figures/fig_tsweep_int16.png
