deestroy/snn_parkour_fgpa/experiments/m0_firing_rates_binarised.png

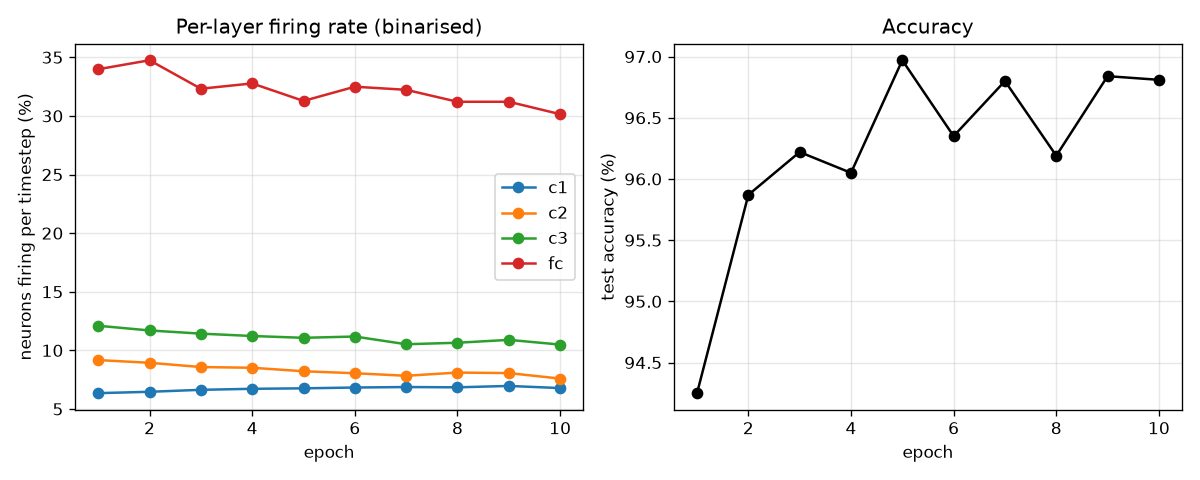
experiments/m0_firing_rates_binarised.png
