deestroy/snn_parkour_fgpa/experiments/m0_lif_demo.png

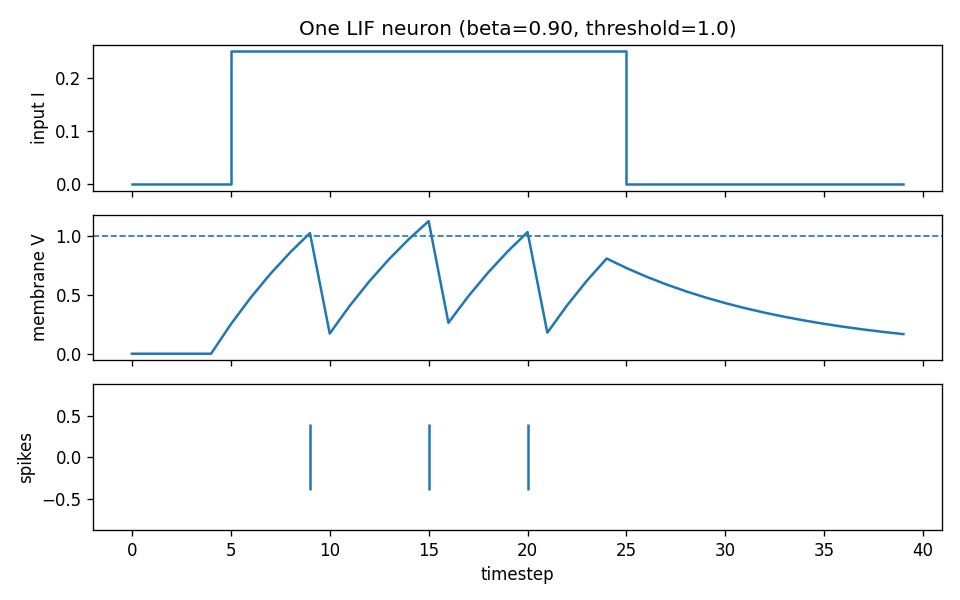
experiments/m0_lif_demo.png
