deestroy/snn_parkour_fgpa/experiments/m0_nmnist_sample.png

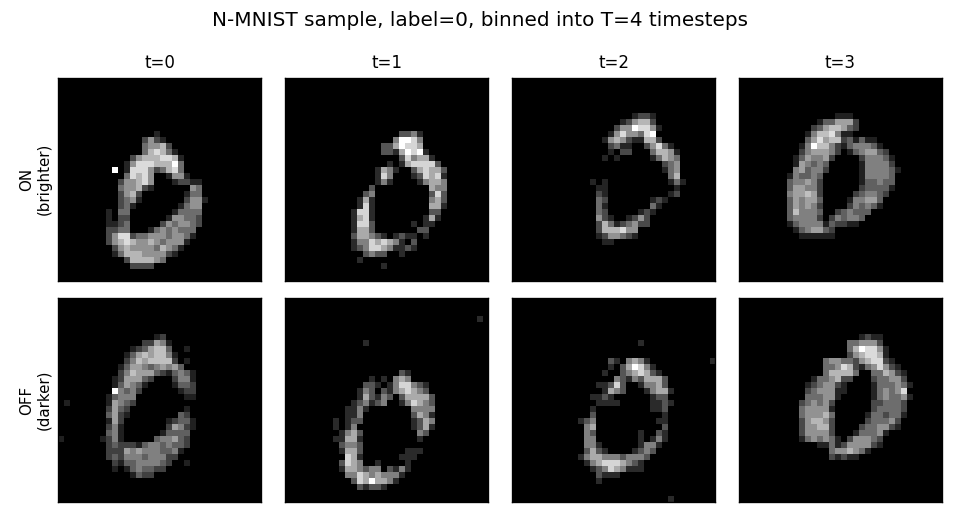
experiments/m0_nmnist_sample.png
