deestroy/snn_parkour_fgpa/experiments/m7_sim/m7_sim_crossover.png

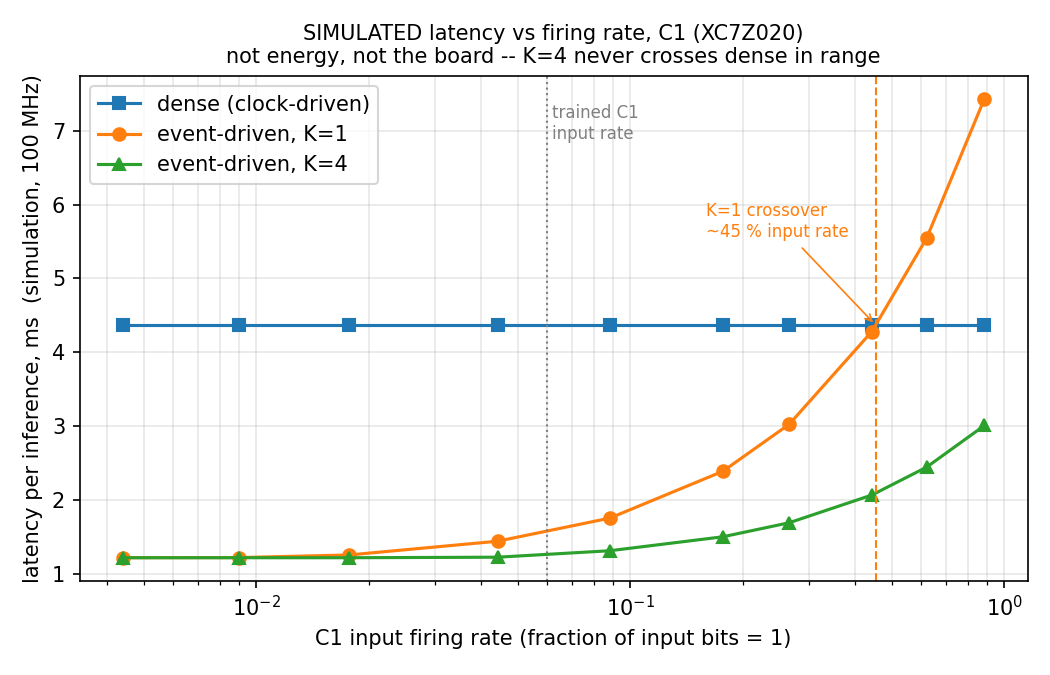
experiments/m7_sim/m7_sim_crossover.png
