deestroy/snn_parkour_fgpa/docs/thesis_tables/lessons.md

# Lessons from sign-off: what bit-identical simulation could not see (hand-maintained)

Each row: the symptom, why simulation passed anyway, the root cause, the fix, and the standing check that now catches it.

| # | symptom | where seen | why simulation passed | root cause | fix | standing guard | reference |
|---|---|---|---|---|---|---|---|
| 1 | ~62k LUTs for a 3k-LUT engine | synthesis | logic size is invisible to a functional testbench | multi-ported accumulator banks cannot map to BRAM and become distributed logic | one write + one read port per bank | sign-off rule in 5.3; utilisation gate in the build script | decisions.md 2026-08-18 |
| 2 | WNS -4.5 ns | timing | simulation has no delay | multipliers on address paths (bank offset, weight row) | stepped addresses, no multiplier on any address path | RTL lint targets in the ladder; WNS gate before any card | decisions.md 2026-08-18 |
| 3 | WNS -3.5 ns, 17 logic levels | timing | same | dividers in the spike decode | D0020 rev 2: addresses as packed fields | same | D0020 |
| 4 | WNS -0.42 ns on one endpoint | timing | same | LIF chain fed straight from BRAM output latches | re-registered BRAM outputs | same | decisions.md 2026-08-19 |
| 5 | board returns all-zero spikes on a timing-clean bitstream | silicon | $readmemh / two-stage init behaves in the simulator | two-stage weight-ROM initialisation silently zeroed by synthesis | single-stage init; weights baked into generated Verilog | sim/lint_synth_safety.sh (ladder); check_baked_weights.py | decisions.md 2026-09-05 |
| 6 | DMA unreachable from the CPU after a clean build | silicon | the PS configuration is outside the RTL | .xsa lost the DMA address map; board preset not applied | board preset + address map as load-bearing build inputs | build script parameter read-back; PING build check | D0014, D0015 |
| 7 | dense P=4 at the 64-geometry fails timing after passing at the 34-geometry | timing | geometry is a parameter; the 34-geometry closed | LIF update -> output-bit write in one cycle at the larger bank | rev 3 registered write | WNS gate; both geometries in the lint targets | decisions.md 2026-09-19 |
| 8 | ED engine bit-identical on N-MNIST for weeks, wrong on DVS-Gesture | second dataset | no N-MNIST check sample ever fires a corner output neuron (zero corner exposure) | current-zero write gated on the update pipeline's valid flag: neuron 0 never cleared (C0044) | unconditional zero at the read beat | corner-exposure report per vector set; synthetic all-corner set in the ladder (proved to fail on pre-fix RTL) | C0044 |
| 9 | a card written from the wrong bitstream (twice) | silicon | -- | stale Design Runs table / auto-incremental checkpoint | pre-card-write checklist: parameter read-back, bitstream timestamp, PING build and dataset | checklist in docs/vivado_session_next.md; PING rejects a mis-built image | decisions.md 2026-09-19 |
| 10 | baked r1 weight tables silently regenerated from synthetic hex | repo | tables compiled and simulated fine | generator sourced from an untracked hex file | generator reads tracked npz only | sim/check_baked_weights.py in the ladder | decisions.md 2026-09-19 |
| 11 | DVS-Gesture board latency 92.9 / 102.0 us above simulation | silicon vs sim | -- | comparison basis: engine-only sim column vs wrapper-inclusive board timer | compare to wrapper-inclusive harness totals (+29.4 / +20.0 us, constant) | axis_total/ harness column recorded with every latency prediction | decisions.md 2026-09-19 (late) |
| 12 | dense P=4 x4 at the 64-geometry does not place | placement | replication is a wrapper parameter simulation never exercises | ~65k decoded-enable output flops | N_ENGINES=2 for that dataset | recorded as a fabric-fit result (6.3) | decisions.md 2026-09-20 |
