deestroy/snn_parkour_fgpa/host/board/conv_server.c

/*
 * M4 Stage B: bare-metal server for the C1 conv engine on the ZedBoard.
 *
 * Loop forever: read a frame from the UART (see host/protocol.md), if it is
 * RUN_CONV push the payload through AXI DMA -> axis_conv_top -> AXI DMA and
 * return the result frame; if PING, answer with capacity. All I/O paced and
 * checksummed; a bad frame gets an error frame, never silence.
 *
 * Runs from DDR with the DEFAULT Vitis linker script (no OCM edit): DDR
 * works once the block design carries the ZedBoard preset (D0015). Linking
 * at DDR 0x100000 also keeps the FSBL's handoff happy (exec address 0 is
 * its "no app" sentinel).
 *
 * Built like loopback.c: paste over the app's source. Same #ifdef SDT DMA
 * lookup, same paced UART.
 *
 * UNTESTED on hardware until the Stage B bitstream exists. The Mac client
 * has been exercised against a Python mock of this server (see
 * host/mock_server.py) so the protocol and packing are known-good; what
 * remains untested is this C and the engine on silicon.
 */

#include <stdint.h>
#include "xparameters.h"
#include "xaxidma.h"
#include "xil_cache.h"
#include "xstatus.h"
#include "xadcps.h"                  /* PS XADC: die temperature (C0009) */

/* ---------------------------------------------------------------- config */
#define BUILD_ID       0x00000005u              /* 5: PING word 2 = DATASET; -DDATASET=1 word counts (2026-09-18) */
#define CAP_WORDS      65535u                   /* per direction; DDR-resident. 65535 = max the 16-bit n_words field can carry */
#define TIMEOUT_LOOP   (50000000u)

#ifdef SDT
#  define DMA_DEV_ID  XPAR_XAXIDMA_0_BASEADDR
#  define XADC_DEV_ID XPAR_XXADCPS_0_BASEADDR  /* SDT lookups take a base address;
                                                  double X is real: XPAR_X + driver
                                                  name "xadcps" (2024.1 SDT) */
#else
#  define DMA_DEV_ID  XPAR_AXIDMA_0_DEVICE_ID
#  define XADC_DEV_ID XPAR_XADCPS_0_DEVICE_ID
#endif

#define MAGIC          0x5A4E4E53u
#define CMD_RUN_CONV   0x01
#define CMD_PING       0x02
#define CMD_BURST      0x03                     /* run the loaded sample N times, timed (protocol.md) */
#define RSP_OK_BIT     0x80
#define RSP_ERR        0xFF
#define ERR_MAGIC 1
#define ERR_CRC   2
#define ERR_NWORDS 3
#define ERR_DMA_TIMEOUT 4
#define ERR_DMA_SETUP 5
#define ERR_NO_SAMPLE 6

/* C1 geometry -- must match axis_conv_top's parameters */
#define T_STEPS        4u
/* DATASET must match the bitstream's axis_conv_top DATASET (C0012):
 *   0 = N-MNIST C1     2x34x34 -> 16x17x17   73 / 145 words per timestep
 *   1 = DVS-Gesture C1 2x64x64 -> 16x32x32  256 / 512 words per timestep
 * Build with -DDATASET=1 for the DVS-Gesture bitstreams; PING reports it. */
#ifndef DATASET
#define DATASET 0
#endif
#if DATASET == 1
#define WORDS_IN_TS    256u                     /* 2*64*64 / 32           */
#define WORDS_OUT_TS   512u                     /* 16*32*32 / 32          */
#else
#define WORDS_IN_TS    73u                      /* ceil(2*34*34 / 32)     */
#define WORDS_OUT_TS   145u                     /* ceil(16*17*17 / 32)    */
#endif
#define REQ_WORDS      (T_STEPS * WORDS_IN_TS)  /* 292 / 1024             */
#define RSP_WORDS      (T_STEPS * WORDS_OUT_TS) /* 580 / 2048             */

/* --------------------------------------------- Cortex-A9 global timer */
/* 64-bit free-running counter at CPU_3x2x = CPU clock / 2 (ZedBoard preset:
 * 666.67 MHz CPU -> 333.33 MHz). Read directly (the SDT BSP has no
 * xtime_l.h). The client cross-checks TICKS_PER_S against wall-clock. */
#define GT_BASE      0xF8F00200u
#define GT_LO        (*(volatile uint32_t *)(GT_BASE + 0x0))
#define GT_HI        (*(volatile uint32_t *)(GT_BASE + 0x4))
#define GT_CTRL      (*(volatile uint32_t *)(GT_BASE + 0x8))
#define TICKS_PER_S  333333333u
static uint64_t gt_read(void) {
    uint32_t hi, lo, hi2;
    do { hi = GT_HI; lo = GT_LO; hi2 = GT_HI; } while (hi != hi2);
    return ((uint64_t)hi << 32) | lo;
}
static void gt_enable(void) { GT_CTRL |= 1u; }

/* ---------------------------------------------------------- paced UART */
#define UART1_BASE   0xE0001000u
#define UART_SR      (*(volatile uint32_t *)(UART1_BASE + 0x2C))
#define UART_FIFO    (*(volatile uint32_t *)(UART1_BASE + 0x30))
#define SR_TXEMPTY   (1u << 3)
#define SR_RXEMPTY   (1u << 1)

static void putc_safe(uint8_t c) {
    while (!(UART_SR & SR_TXEMPTY)) { }
    UART_FIFO = c;
    while (!(UART_SR & SR_TXEMPTY)) { }
}
static uint8_t getc_block(void) {
    while (UART_SR & SR_RXEMPTY) { }
    return (uint8_t)(UART_FIFO & 0xFF);
}
static void put_u32(uint32_t v) {
    putc_safe(v & 0xFF); putc_safe((v >> 8) & 0xFF);
    putc_safe((v >> 16) & 0xFF); putc_safe((v >> 24) & 0xFF);
}
static uint32_t get_u32(void) {
    uint32_t v = getc_block();
    v |= (uint32_t)getc_block() << 8;
    v |= (uint32_t)getc_block() << 16;
    v |= (uint32_t)getc_block() << 24;
    return v;
}

/* --------------------------------------------------------------- CRC32 */
static uint32_t crc_table[256];
static void crc_init(void) {
    for (uint32_t i = 0; i < 256; i++) {
        uint32_t c = i;
        for (int k = 0; k < 8; k++) c = (c & 1) ? 0xEDB88320u ^ (c >> 1) : c >> 1;
        crc_table[i] = c;
    }
}
static uint32_t crc_update(uint32_t crc, const uint8_t *p, uint32_t n) {
    crc = ~crc;
    while (n--) crc = crc_table[(crc ^ *p++) & 0xFF] ^ (crc >> 8);
    return ~crc;
}
static uint32_t crc_word(uint32_t crc, uint32_t w) {
    uint8_t b[4] = { w & 0xFF, (w >> 8) & 0xFF, (w >> 16) & 0xFF, (w >> 24) & 0xFF };
    return crc_update(crc, b, 4);
}

/* ---------------------------------------------------------------- frames */
static uint32_t rx_words[CAP_WORDS] __attribute__((aligned(64)));
static uint32_t tx_words[CAP_WORDS] __attribute__((aligned(64)));
/* BURST replays loaded samples. Every request's payload lands in rx_words,
 * so samples live in their own store, appended at RUN_CONV (up to 16; a
 * 17th RUN_CONV wraps to slot 0). C0018: sweep mode cycles the whole set
 * so the measured power is the input distribution's, not one sample's. */
#define MAX_SAMPLES 16u
static uint32_t sample_words[MAX_SAMPLES][REQ_WORDS] __attribute__((aligned(64)));
static uint32_t n_samples = 0;   /* how many slots hold data */
static uint32_t s_next = 0;      /* next slot to fill */
static uint32_t ref_words[RSP_WORDS];
static int      have_sample = 0;
static XAxiDma dma;
static XAdcPs xadc;
static int xadc_ok = 0;

/* die temperature in milli-degC, 0 if the XADC is unavailable */
static int32_t die_temp_mc(void) {
    if (!xadc_ok) return 0;
    u16 raw = XAdcPs_GetAdcData(&xadc, XADCPS_CH_TEMP);
    float c = XAdcPs_RawToTemperature(raw);
    return (int32_t)(c * 1000.0f);
}

static void send_frame(uint8_t cmd, const uint32_t *payload, uint32_t n) {
    uint8_t hdr[8] = { 0x53, 0x4E, 0x4E, 0x5A, cmd, 0, n & 0xFF, (n >> 8) & 0xFF };
    uint32_t crc = crc_update(0, hdr, 8);
    for (int i = 0; i < 8; i++) putc_safe(hdr[i]);
    for (uint32_t i = 0; i < n; i++) { put_u32(payload[i]); crc = crc_word(crc, payload[i]); }
    put_u32(crc);
}
static void send_error(uint32_t code) {
    send_frame(RSP_ERR, &code, 1);
}

/* Read one frame into rx_words. Returns cmd, or 0 on transport error
 * (after sending the error frame). Resyncs on magic byte by byte. */
static uint8_t recv_frame(uint32_t *n_out) {
    /* hunt for magic */
    uint32_t win = 0;
    for (;;) {
        win = (win >> 8) | ((uint32_t)getc_block() << 24);
        if (win == MAGIC) break;
    }
    uint8_t cmd = getc_block();
    uint8_t flags = getc_block();
    uint32_t n = getc_block();
    n |= (uint32_t)getc_block() << 8;
    uint8_t hdr[8] = { 0x53, 0x4E, 0x4E, 0x5A, cmd, flags, n & 0xFF, (n >> 8) & 0xFF };
    uint32_t crc = crc_update(0, hdr, 8);
    if (n > CAP_WORDS) {
        /* drain and reject */
        for (uint32_t i = 0; i < n * 4 + 4; i++) getc_block();
        send_error(ERR_NWORDS); return 0;
    }
    for (uint32_t i = 0; i < n; i++) { rx_words[i] = get_u32(); crc = crc_word(crc, rx_words[i]); }
    uint32_t got = get_u32();
    if (got != crc) { send_error(ERR_CRC); return 0; }
    *n_out = n;
    return cmd;
}

/* ------------------------------------------------------------------ DMA */
static int wait_idle(int dir) {
    uint32_t n = 0;
    while (XAxiDma_Busy(&dma, dir)) if (++n > TIMEOUT_LOOP) return XST_FAILURE;
    return XST_SUCCESS;
}

/* One DMA round trip: src (REQ_WORDS, already flushed) -> engine -> tx_words.
 * Returns 0 or an ERR_ code. Shared by RUN_CONV and BURST. */
static int one_pass(const uint32_t *src) {
    Xil_DCacheFlushRange((UINTPTR)tx_words, RSP_WORDS * 4);
    if (XAxiDma_SimpleTransfer(&dma, (UINTPTR)tx_words, RSP_WORDS * 4,
                               XAXIDMA_DEVICE_TO_DMA) != XST_SUCCESS ||
        XAxiDma_SimpleTransfer(&dma, (UINTPTR)src, REQ_WORDS * 4,
                               XAXIDMA_DMA_TO_DEVICE) != XST_SUCCESS) return ERR_DMA_SETUP;
    if (wait_idle(XAXIDMA_DMA_TO_DEVICE) != XST_SUCCESS ||
        wait_idle(XAXIDMA_DEVICE_TO_DMA) != XST_SUCCESS) return ERR_DMA_TIMEOUT;
    Xil_DCacheInvalidateRange((UINTPTR)tx_words, RSP_WORDS * 4);
    return 0;
}

static int run_conv(uint32_t n_in) {
    if (n_in != REQ_WORDS) { send_error(ERR_NWORDS); return -1; }
    uint32_t slot = s_next;
    for (uint32_t k = 0; k < REQ_WORDS; k++) sample_words[slot][k] = rx_words[k];
    Xil_DCacheFlushRange((UINTPTR)sample_words[slot], REQ_WORDS * 4);
    s_next = (s_next + 1) % MAX_SAMPLES;
    if (n_samples < MAX_SAMPLES) n_samples++;
    int e = one_pass(sample_words[slot]);
    if (e) { send_error((uint32_t)e); return -1; }
    send_frame(CMD_RUN_CONV | RSP_OK_BIT, tx_words, RSP_WORDS);
    have_sample = 1;
    return 0;
}

/* BURST: the M5/M7 measurement mode (protocol.md). Drive the engine at
 * ~100 % duty for N iterations of the loaded sample, time the loop with
 * the global timer, check every iteration reproduces iteration 1's output
 * words, and report N, ticks, tick rate, mismatches, CRC of the last output. */
static int run_burst(uint32_t n_in) {
    /* payload: [N] = classic single-sample replay of the LAST sample;
     * [N, 1] = SWEEP mode (C0018): cycle through all loaded samples,
     * i -> sample i mod n_samples. mism then counts iterations whose
     * output differed from the FIRST iteration of the SAME sample. */
    if (n_in != 1 && n_in != 2) { send_error(ERR_NWORDS); return -1; }
    if (!have_sample) { send_error(ERR_NO_SAMPLE); return -1; }
    uint32_t iters = rx_words[0];
    uint32_t sweep = (n_in == 2) ? rx_words[1] : 0;
    uint32_t nset = sweep ? n_samples : 1;
    uint32_t last = (s_next + MAX_SAMPLES - 1) % MAX_SAMPLES;
    if (iters == 0) { send_error(ERR_NWORDS); return -1; }
    static uint32_t ref_crc[MAX_SAMPLES];
    uint8_t have_ref[MAX_SAMPLES] = {0};
    uint32_t mism = 0, done = 0;
    uint64_t eng = 0;                /* ticks spent inside one_pass only */
    int32_t t_mc0 = die_temp_mc();
    uint64_t t0 = gt_read(), t1;
    for (uint32_t i = 0; i < iters; i++) {
        /* sweep indexes from the OLDEST slot so pass i is always the i-th
         * LOADED sample, whatever the ring position: a lone RUN_CONV
         * between client invocations rotates s_next, and slot order then
         * diverges from load order (bit us on silicon; the mock, which
         * keeps a load-order list, could not see it). When the store has
         * not wrapped, s_next == n_samples and this reduces to i % nset. */
        uint32_t si = sweep ? ((s_next + i) % nset) : last;
        uint64_t t_a = gt_read();
        int e = one_pass(sample_words[si]);
        eng += gt_read() - t_a;
        if (e) { send_error((uint32_t)e); return -1; }
        done++;
        uint32_t c = 0;
        for (uint32_t k = 0; k < RSP_WORDS; k++) c = crc_word(c, tx_words[k]);
        if (!have_ref[si]) { ref_crc[si] = c; have_ref[si] = 1; }
        else if (c != ref_crc[si]) mism++;
        (void)ref_words;
    }
    t1 = gt_read();
    uint64_t ticks = t1 - t0;
    uint32_t c = 0;                              /* crc_update folds init/final */
    for (uint32_t k = 0; k < RSP_WORDS; k++) c = crc_word(c, tx_words[k]);
    /* words 6..7: die temperature (milli-degC) at burst start/end (C0009/
     * C0020). words 8..9: engine-only ticks (one_pass = DMA + fabric),
     * excluding the per-pass CRC bookkeeping, which at -O0 costs ~80 us
     * a pass and was inflating the latency number. Older clients read
     * only words 0..5 and are unaffected. */
    uint32_t rep[10] = { done, (uint32_t)ticks, (uint32_t)(ticks >> 32),
                         TICKS_PER_S, mism, c,
                         (uint32_t)t_mc0, (uint32_t)die_temp_mc(),
                         (uint32_t)eng, (uint32_t)(eng >> 32) };
    send_frame(CMD_BURST | RSP_OK_BIT, rep, 10);
    return 0;
}

int main(void) {
    crc_init();
    gt_enable();
    {   /* XADC init is best-effort: metering wants it, nothing depends on it */
        XAdcPs_Config *xc = XAdcPs_LookupConfig(XADC_DEV_ID);
        if (xc && XAdcPs_CfgInitialize(&xadc, xc, xc->BaseAddress) == XST_SUCCESS)
            xadc_ok = 1;
    }
    XAxiDma_Config *cfg = XAxiDma_LookupConfig(DMA_DEV_ID);
    if (!cfg || XAxiDma_CfgInitialize(&dma, cfg) != XST_SUCCESS || XAxiDma_HasSg(&dma)) {
        for (;;) send_error(ERR_DMA_SETUP);   /* loud, forever */
    }
    XAxiDma_IntrDisable(&dma, XAXIDMA_IRQ_ALL_MASK, XAXIDMA_DEVICE_TO_DMA);
    XAxiDma_IntrDisable(&dma, XAXIDMA_IRQ_ALL_MASK, XAXIDMA_DMA_TO_DEVICE);

    /* announce: an unsolicited PING response so the host sees us come up */
    { uint32_t info[3] = { BUILD_ID, CAP_WORDS, DATASET }; send_frame(CMD_PING | RSP_OK_BIT, info, 3); }

    for (;;) {
        uint32_t n = 0;
        uint8_t cmd = recv_frame(&n);
        if (cmd == CMD_PING) {
            uint32_t info[3] = { BUILD_ID, CAP_WORDS, DATASET };   /* word 2: DATASET (C0012), build 5+ */
            send_frame(CMD_PING | RSP_OK_BIT, info, 3);
        } else if (cmd == CMD_RUN_CONV) {
            run_conv(n);
        } else if (cmd == CMD_BURST) {
            run_burst(n);
        } else if (cmd != 0) {
            send_error(ERR_MAGIC);
        }
    }
}
