deestroy/snn_parkour_fgpa/sim/export_ed_vectors.py

"""Export transposed weights and spike address lists for the event-driven
conv testbench (M6). Imports the mapping functions from golden/eventdriven.py
so exporter, Python engine and (later) Verilog testbench agree by construction.

Run:  python3 sim/export_ed_vectors.py [--layer c1] [--k 1]

Writes sim/vectors/:
    ed_<L>_wt.hex     transposed weights W_T[ic,ky,kx,oc], int8 per line,
                      address = ((ic*3+ky)*3+kx)*C_OUT + oc  (D0018 layout).
                      At K>1 the SAME file is read by K bank ROMs, each taking
                      every K-th entry (oc mod K == bank) -- the split is by
                      address, no separate files needed.
    ed_<L>_spk.txt    per (sample, timestep): one line "count" then that many
                      lines of flat input addresses -- the D0016 address list.
    ed_<L>_s.bin      expected output spikes, flat golden order, per timestep
    ed_<L>_v.hex      expected membranes, int16 hex, same order
    ed_<L>_i.hex      expected ACCUMULATOR I after scatter, before sweep, per
                      timestep, flat golden order, int16 hex -- the scatter
                      unit's own checkpoint (tighter than the golden traces,
                      which only see V and spikes after the sweep). Produced by
                      running golden/eventdriven.py's engine, so scatter RTL
                      is checked against the Python scatter directly.
"""

import argparse
import os
import sys

import numpy as np

REPO = os.path.dirname(os.path.dirname(os.path.abspath(__file__)))
sys.path.insert(0, REPO)
from golden.eventdriven import GEOM, transpose_weights, EventDrivenConv, flat_neuron  # noqa: E402
from sim.corner_exposure import report  # noqa: E402

OUT = os.path.join(REPO, "sim", "vectors")


def main() -> int:
    ap = argparse.ArgumentParser()
    ap.add_argument("--layer", default="c1", choices=sorted(GEOM))
    ap.add_argument("--k", type=int, default=1)
    ap.add_argument("--weights", default=os.path.join(REPO, "golden", "m1_weights_int8.npz"),
                    help="quantised weights npz (default: the M1 N-MNIST network)")
    ap.add_argument("--traces", default=os.path.join(REPO, "golden", "traces_m1.npz"),
                    help="golden traces npz produced from the same network")
    args = ap.parse_args()
    c_in, h_in, w_in, c_out, h_out, w_out, thr, wkey = GEOM[args.layer]
    assert c_out % args.k == 0

    zw = np.load(args.weights)
    w = zw[wkey]
    if wkey + "_k" in zw.files:                       # the layer's threshold is 2^k for THIS network
        thr = 2 ** int(zw[wkey + "_k"])
    z = np.load(args.traces)
    src = {"c1": "in", "c2": "c1_S", "c3": "c2_S", "g1": "in", "g2": "c1_S", "g3": "c2_S"}[args.layer]
    tl = {"g1": "c1", "g2": "c2", "g3": "c3"}.get(args.layer, args.layer)   # trace keys carry the network's layer names
    spikes_in = (z[src] != 0)
    exp_s = (z[tl + "_S"] != 0)
    exp_v = z[tl + "_V"]
    b, t = spikes_in.shape[:2]

    os.makedirs(OUT, exist_ok=True)
    p = lambda n: os.path.join(OUT, "ed_%s_%s" % (args.layer, n))

    wt = transpose_weights(w)  # (C_IN, 3, 3, C_OUT)
    with open(p("wt.hex"), "w") as fh:
        for v in wt.ravel():
            fh.write("%02x\n" % (int(v) & 0xFF))

    n_spk = 0
    with open(p("spk.txt"), "w") as fh:
        for s in range(b):
            for ts in range(t):
                addrs = np.flatnonzero(spikes_in[s, ts].ravel())
                fh.write("%d\n" % len(addrs))
                for a in addrs:
                    fh.write("%d\n" % a)
                n_spk += len(addrs)

    with open(p("s.bin"), "w") as fh:
        for bit in exp_s.astype(np.uint8).ravel():
            fh.write("%d\n" % bit)
    with open(p("v.hex"), "w") as fh:
        for v in exp_v.astype(np.int64).ravel():
            assert -32768 <= v <= 32767
            fh.write("%04x\n" % (int(v) & 0xFFFF))

    # I after scatter, before sweep: replay through the Python engine
    eng = EventDrivenConv(args.layer, w, k=1)
    with open(p("i.hex"), "w") as fh:
        for s_ in range(b):
            eng.clear()
            for ts in range(t):
                eng.scatter(np.flatnonzero(spikes_in[s_, ts].ravel()))
                # flatten bank-local I back to golden order
                flat_i = np.zeros(c_out * h_out * w_out, np.int64)
                for oc in range(c_out):
                    for oy in range(h_out):
                        for ox in range(w_out):
                            from golden.eventdriven import bank_of, offset_of
                            flat_i[flat_neuron(oc, oy, ox, h_out, w_out)] = \
                                eng.i[bank_of(oc, 1), offset_of(oc, oy, ox, 1, h_out, w_out)]
                for v in flat_i:
                    assert -32768 <= v <= 32767
                    fh.write("%04x\n" % (int(v) & 0xFFFF))
                eng.sweep()   # advances V, zeroes I, exactly as the RTL sweep will

    report(args.layer, spikes_in.astype(np.uint8), OUT)   # C0044 guard: corner blind spots
    with open(p("thresh.txt"), "w") as fh:
        fh.write("%d\n" % thr)                         # bench runners read this when VEC_WEIGHTS is set
    print("%s: %d samples x %d ts, %d input spikes total (%.1f/ts), W_T %s, I dump written"
          % (args.layer, b, t, n_spk, n_spk / (b * t), wt.shape))
    return 0


if __name__ == "__main__":
    raise SystemExit(main())
