deestroy/snn_parkour_fgpa/(commit log)

2026-08-16 Training loop with per-layer firing rate logging
    train/data.py handles the loaders. N-MNIST is 60k raw event files and
    decoding them costs more than the forward pass, so DiskCachedDataset
    writes the binned frames out once and later epochs read those. The cache
    stores raw counts; binarisation happens on the tensor at train time, so
    one cache serves both arms of D0003.
    train/03_train.py trains and logs per-layer firing rate to CSV every
    epoch. Accuracy is only a sanity check here - N-MNIST is easy. The
    firing rates are the actual output, since that's the independent
    variable everything downstream depends on.
    The counts arm divides by the mean non-zero count so both arms start at
    the same inp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
2026-08-16 Split tonic-facing code out so training doesn't need it
    The GPU box already has a working ROCm torch in an existing venv, and
    installing tonic there would have downgraded numpy under that project.
    So tonic now lives behind two seams:
    - train/nmnist_raw.py: the dataset + transform, importable without torch
    - train/04_pack_dataset.py: one-time conversion to flat .npy pairs
    (uint8 is lossless, counts max out at 10)
    data.py prefers the packed arrays when they exist and falls back to
    tonic otherwise, so the same training command works on both machines.
    Also gave 03_train.py a --device flag.
2026-08-16 M0 training results: both D0003 arms, 4 seeds each, on the MI210
    Trained over ssh on the borrowed AMD box - 6s/epoch, so the whole
    experiment including seed repeats took minutes. Results:
    - binarised 96.93% mean, counts 97.58% mean. The 0.65pp gap is
    consistent across all seeds, so it's real. D0003 verdict pending.
    - Trained firing rates: conv layers 6-11%, FC 30%. The FC layer is
    both the densest layer and the one holding 81% of the weights,
    which is exactly the wrong combination for the event-driven design.
    Recorded as D0006 - this needs to be on the table for M6.
    Packed .npy dataset pulled back so the Mac trains from the same bits.
    [m0_firing_rates_binarised.csv, m0_firing_rates_counts.csv]
2026-08-16 Quantise weights to int8, power-of-two scales
    All four hardware layers land on k=6 (scale 2^-6), which makes the
    integer firing threshold 64 everywhere, and 256 for FC once the pool's
    divide-by-4 folds into the shift. Accuracy with rounded weights over
    the full test set: 96.69% vs 96.60% float, so rounding is free and the
    whole M1 budget is available for the fixed-point membrane.
    The int8 arrays live in golden/m1_weights_int8.npz next to the model
    that will consume them.
2026-08-16 M2: one LIF neuron in Verilog, bit-identical to the golden model
    hdl/common/lif_neuron.v - membrane register, shift leak, delayed
    reset via a comparator on the stored V, no multiplier anywhere. The
    16-bit width comes from measuring the M1 traces (|V| <= 2245), not
    from guessing.
    sim/ has the vector exporter, testbench and runner. 4060 timestep
    checks over all four layers, zero mismatches, === comparison.
    The testbench earned some trust the hard way: fault injection via
    iverilog -P on a nested parameter silently did nothing and "passed".
    Injecting the bug in the source properly fails 537/1020 checks. Worth
    remembering that -P only reaches top-level parameters.
    Simulation only. Nothing here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
    [export_lif_vectors.py, lif_neuron.v, tb_lif_neuron.v]
2026-08-16 M3 prep: extract lif_update as a shared combinational core
    The dense engine keeps membranes in RAM, so the update rule can't own a
    register. lif_update.v is now pure combinational logic - stored V and
    current in, next V and spike out - and lif_neuron is that plus one
    register. Dense (M3) and event-driven (M6) will instantiate the same
    module, so the update rule only ever has to be proven correct once.
    M2 regression after the refactor: 4060/4060 checks still bit-identical.
    Also: dense baseline will be hand-written Verilog, not HLS as the project brief
    originally planned. Vitis HLS doesn't run on this Mac, which would
    break the local verify loop, and same-toolchain dense vs event-driven
    is a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
    [lif_neuron.v, lif_update.v]
2026-08-16 M3: dense conv engine, bit-identical on all three conv layers
    hdl/dense/conv_layer.v walks every output neuron with nested FSM
    counters, accumulates spike-gated weights (no multiplier - spikes are
    0/1), and runs the shared lif_update against a membrane word in RAM.
    One parameterised engine covers c1/c2/c3.
    Against golden traces, all neurons all timesteps compared: c1 591872,
    c2 331776, c3 204800 checks, zero mismatches. Fault-injecting one
    weight bit fails 5148 checks, so the testbench sees what it claims to.
    Memories are combinational-read for now; the registered-read pass that
    BRAM inference wants is deferred to M4 and recorded as D0012. Runner
    rewritten for macOS bash 3.2, which has no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
    [conv_layer.v, export_conv_vectors.py, tb_conv_layer.v]
2026-08-16 M4 stage A: Vivado walkthrough and board-side loopback test
    First hardware milestone, staged on purpose: before our engine goes
    anywhere near silicon, a zero-custom-RTL loopback overlay (DMA -> FIFO
    -> DMA) proves the toolchain, board files, SD image, network and DMA
    plumbing. Any failure after that is the engine's fault by elimination.
    docs/m4_vivado_walkthrough.md is the click-by-click map for the Windows
    VM and the board, with a checkpoint after every section and a table of
    the four classic first-overlay failures.
    host/loopback_test.py runs on the board's Jupyter. Written blind by
    necessity - it can only execute on real hardware - and says so in its
    docstring.
2026-08-16 D0012: registered memory reads in the dense engine
    BRAM is synchronous - address one edge, data the next - so the
    combinational reads had to go before synthesis. Kernel walk is now
    read/add state pairs, the membrane read has its own state, and the
    external readback ports are registered too, with the testbench adjusted
    to match.
    Same 1.13M golden comparisons pass on all three conv layers, M2 suite
    unaffected. Costs about 2x the cycles per timestep; a prefetch pipeline
    should reclaim that before M5 measures latency, noted in the decision
    log so it doesn't get forgotten.
    [conv_layer.v, tb_conv_layer.v]
2026-08-16 M4 stage B: AXI-Stream wrapper for the dense engine
    axis_conv.v translates between the DMA's world (32-bit words,
    tvalid/tready, tlast) and the engine's (bit writes, clear/start/done).
    Per timestep: 73 words unpacked, engine run, 145 words packed back.
    Streaming every timestep's spike map keeps hardware verification at the
    same granularity as the golden model, which will matter during board
    bring-up far more than the smaller transfer would.
    The testbench feeds golden word streams through a hostile handshake -
    random gaps and backpressure - and demands word-exact output plus
    correctly placed tlast. Three seeds, 9280 words each, all clean.
    Cost of admission: the first bench sampled handshake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
    [axis_conv.v, export_axis_vectors.py, tb_axis_conv.v]
2026-08-16 M5 shopping list for the power meter
    INA226 breakout plus a 0.02R shunt swap (the stock R100 shunt clips at
    our current), or an INA260 if soldering is unwelcome. Read over I2C
    from the board's own PMODA - self-metering is fine for idle-vs-running
    deltas and the methodology will say so. Joulescope skipped: money and
    lead time for bandwidth the steady-state measurement doesn't need.
2026-08-16 FC engine with the pool folded away
    The 2x2 sum-pool never materialises: W[n,j] * pooled[j] is just W[n,j]
    added once per spike in window j, so the FC engine walks the raw c3
    spike map with four positions sharing each weight. Datapath stays
    multiplier-free end to end, which is now a clean thesis claim.
    16384 golden comparisons pass; a single flipped weight bit fails 61.
    This also settles an M6 question early: event-driven FC scatters c3
    spike addresses straight into weight lookups, fan-out 128 per spike.
    The dense encoder is now complete in verified HDL: c1/c2/c3 + fc.
    [export_fc_vectors.py, fc_layer.v, tb_fc_layer.v]
2026-08-16 Board-day readiness kit
    Everything hardware day needs, prepared while the board ships:
    - axis_conv_top.v, the synthesis top: inverts Xilinx's active-low
    aresetn once (a naive hookup would hold the engine in permanent
    reset - miserable to debug on silicon) and carries the interface
    attributes Vivado reads. The axis testbench now instantiates this
    top, so what gets synthesised is what got tested. Still passes.
    - host/conv_test.py + conv_test_data.npz: streams 16 golden samples
    through the fabric and compares every word. The npz is generated by
    make_conv_test_data.py using the same packer as the sim exporter,
    and cross-checked word-identical against the vectors the passing
    sim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
    [axis_conv_top.v, conv_test.py, make_conv_test_data.py, tb_axis_conv.v]
2026-08-16 Pipeline the MAC loops in both dense engines
    Issue the read for position k while accumulating position k-1, one
    prologue cycle per neuron and a tail to drain the pipe. Conv drops
    from 38 to ~21 cycles per neuron, FC from 2050 to ~1027, and the
    latency the M5 measurements will record is no longer carrying an
    artificial 2x handicap.
    Full regression after: conv 1.13M checks, fc 16384, axis wrapper 9280
    words under hostile handshake, M2 neuron suite - all still
    bit-identical to the golden model.
    [conv_layer.v, fc_layer.v]
2026-08-17 The board is a ZedBoard, not a PYNQ-Z2
    Same Zynq-7020 fabric, so nothing in hdl/, golden/, sim/ or the
    resource budget changes. Board-level plumbing does: ZedBoard board
    file ships with Vivado (fresh project needed for the PS preset), the
    PYNQ image is the ZedBoard build, SD boot is JP7-JP11 = 0 0 1 1 0,
    power is the 12 V barrel, and the M5 shunt moves to that 12 V input.
    Stage A walkthrough revised with every difference marked [ZedBoard];
    Stage B and the meter shopping list updated to match. D0014 records it
    and the project brief's board table now says ZedBoard.
2026-08-17 Meter shopping list: barrel pigtail instead of a USB cable for the ZedBoard
2026-08-18 D0015 resolved: bare-metal Vitis on the ZedBoard, Mac host over UART
2026-08-18 Stage A goes bare metal: loopback.c and the Vitis walkthrough
    No PYNQ for the ZedBoard, so the board runs a C program instead of
    Jupyter. host/board/loopback.c does the DMA round trip with XAxiDma in
    polled simple mode and reports over UART; the two cache calls are the
    part most likely to bite and are commented as such.
    Walkthrough sections 5-8 rewritten: JTAG boot jumpers, two USB cables,
    Vitis platform + application from the exported .xsa, Run on Hardware,
    serial terminal, and a failure table for the bare-metal flavour of the
    same classic failures. Sections 1-4 (Vivado) unchanged apart from the
    Export Hardware step.
    loopback_test.py (PYNQ) removed. The C is written without a compiler
    to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
    [loopback.c]
2026-08-18 Program the ZedBoard from the Mac with OpenOCD
    The Windows machine is reached over Remote Desktop, so it can never see
    USB. New split: Windows builds (Vivado .bit, Vitis .elf), the Mac
    programs and listens.
    host/mac/program.sh + zynq_load.tcl drive the board's Digilent JTAG
    via OpenOCD's stock digilent_zedboard.cfg: halt, pld load bitstream,
    run ps7_init from the .xsa (xsct memory commands shimmed onto mww/mdw),
    load ELF, resume at the entry point pulled from the ELF header.
    Verified on the actual board from this Mac: both TAPs enumerate,
    cores halt on command, and mrd reads PSS_IDCODE = 0x03b27093 (a 7z020)
    off live silicon. Bitstream/ELF sequence itself waits on the first
    build - expect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
2026-08-18 loopback.c: Vitis 2024 SDT flow finds the DMA by base address
    First real compile (Vitis 2024.1 Unified, -DSDT) showed
    XPAR_AXIDMA_0_DEVICE_ID no longer exists; the SDT flow keys drivers by
    XPAR_AXIDMA_0_BASEADDR. Both spellings supported behind #ifdef SDT.
    [loopback.c]
2026-08-18 Board-day log: JTAG, bitstream and ps7_init all work from the Mac; DDR access still stalls
    Root-caused a lot in one evening: reset-halt needed, mrd string shape,
    global sourcing, silicon 1.0 is correct for this chip, and the BootROM's
    L2 address filter (0x40000001) was hiding DDR entirely. With the filter
    fixed the DRAM itself doesn't answer yet. Two fallbacks recorded.
2026-08-18 OCM workaround: shrink loopback buffers to fit on-chip memory (temporary, revert noted in D0015)
    [loopback.c]
2026-08-18 OCM workaround: 12288 words - 16384 overflowed the 192 KB OCM region by 8 KB
    [loopback.c]
2026-08-18 zynq_load: clear the L2 address filter after ps7_init
2026-08-18 Found it: the PS has no UART enabled. Loopback runs, spins in outbyte on UART0.
    Symbol-table lookup of the halted PC nailed it in one shot. Fix is a
    checkbox in Vivado (UART1 on MIO 48/49); walkthrough updated so the
    next person checks it before generating. uart_capture.py added for the
    Mac side.
2026-08-18 Board-day part 3: UART hardware proven end to end; the bug is BSP stdout=uart_0
    Retract the 'no UART enabled' call from part 2 - it came from CPU-side
    reads through the running program's MMU, all junk. AHB-AP reads show
    UART1 fully configured, and 200 hand-written bytes reach the Mac. Fix
    is the platform's stdin/stdout setting. Two debugging rules recorded.
2026-08-18 loopback.c: own paced UART writer, DMA diagnostics before init
    The BSP's outbyte drops exactly every second character on this rev-1.0
    ZedBoard; hand-pushed bytes all arrive, so it's the driver's TX flag
    handling, not the hardware. Wait for TXEMPTY per byte instead. Also print
    the DMA config and raw status registers before CfgInitialize, since one
    run reported 'FAIL: DMA init' and we need to know why.
    [loopback.c]
2026-08-18 Board-day part 4: console clean, DMA visible and healthy via AHB-AP; CPU->PL routing is the last blocker
    Retract two more of tonight's theories (BSP outbyte, UART clock). The
    character loss was my own L2-filter change. With that reverted the
    program prints its full diagnostics and stops in DMA init because the
    CPU reads different DMA registers than the debugger does - the L2
    address filter still routes PL accesses wrong. Two clear next steps.
2026-08-18 M4 stage A: LOOPBACK PASS on the ZedBoard from the Mac
    12288 words out through the fabric and back, bit-identical. Programmed
    over the board's own JTAG with OpenOCD, console over the USB UART, no
    Vitis or Windows involvement at run time.
    Root cause of the whole evening: SRST leaves PCFG_PROG_B low, so pld
    load configured a fabric that was being held cleared. Reads of the PL
    returned stable garbage, the first write hung the bus, and every theory
    I built on those readings (L2 filter, UART clock, BSP outbyte, no UART
    enabled) was wrong. Loader now pulses PROG_B and uses the xsct order:
    ps7_init, PROG_B, bitstream, post_config, ELF. All retractions and the
    debugging rules that fall out of them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
2026-08-18 DDR: characterised as a rev-1.0-silicon / possible hardware limitation; OCM is the working baseline
    Everything the controller can report says healthy; the DRAM does not
    answer. 0xF8006078 faults on a plain read on fresh silicon, which pins
    this as rev-1.0 XC7Z020. FSBL is the remaining discriminator and needs
    Vitis. Stage B is not blocked by this - it fits OCM.
2026-08-18 Overnight report for the morning; README notes Stage A pass and the OCM constraint
2026-08-18 M6 step 1: event-driven conv engine in Python, bit-identical to golden
    golden/eventdriven.py is D0016-D0018 as code: per-layer address lists,
    transposed weights, computed targets, channel-interleaved banks, shared
    LIF rule in the sweep. Reproduces the golden traces exactly on c1/c2/c3
    at K=1 and K=4 - 1.13M checks, zero mismatches - and the bank mapping is
    proven bijective and conflict-free for K up to 8.
    Writing it exposed something the prose missed: the neuron needs two
    words, V and an I accumulator, or the leak and pending-reset get
    computed on a corrupted V. Recorded as D0019 with the BRAM cost.
    Measured event-driven work at trained rates: 6-13x fewer memory ops
    than dense per timestep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
    [export_ed_vectors.py]
2026-08-18 Stage B host pair: framed UART protocol, C server, Mac client, golden mock
    host/protocol.md defines it: magic + cmd + length + payload + CRC32, one
    sample per exchange, sized for OCM (1024-word caps). A UART has no
    framing of its own, and a single dropped byte would otherwise look
    exactly like an engine bug, so frames are either intact or rejected.
    conv_server.c is the bare-metal side: hunts for magic, checks CRC,
    DMAs the sample through axis_conv_top, replies. Same paced UART and
    SDT lookup as loopback.c. Untested on hardware until the Stage B
    bitstream exists.
    snn_link.py is the one codec both ends share; uart_client.py streams
    the 16 golden samples and compares every word; mock_server.p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
    [conv_server.c, mock_server.py, snn_link.py, uart_client.py]
2026-08-18 Stage B walkthrough revised for the bare-metal flow that passed Stage A
2026-08-18 stage_b.sh: one command for the morning's Stage B run, with file integrity checks
    conv_server.c and loopback.c pass a host syntax check against stubbed
    BSP headers, and the C CRC matches Python's zlib.crc32 on a real frame
    (d6eb8d1e both). The classes of bug that cost round trips yesterday are
    ruled out for today.
2026-08-18 M6 harness: address-list testbench, proven with the dense engine as DUT
    The event-driven engine's interface is now fixed (D0020): spike address
    pushes + start, instead of a bit buffer. tb_ed_conv.v drives the golden
    address lists and compares every neuron; ed_iface_shim.v adapts the
    verified dense engine to that interface so the harness could be proven
    tonight. c1/c2/c3 clean, spike counts match the Python engine, and one
    dropped address fails 124 checks. The real RTL slots in as a one-arg
    change to run_ed_tb.sh.
    [ed_iface_shim.v, tb_ed_conv.v]
2026-08-18 M5 software: INA226 driver, idle-run-idle protocol, report, mock meter
    Written ahead of the meter arriving. ina226.py talks to the real chip
    over smbus2 (calibrated for the 0.02R shunt on 12V) and MockINA226
    fakes a supply with noise and drift so everything above it can be
    tested at a desk. protocol.py runs idle -> inferences -> idle, keeps
    both idle baselines, propagates SEMs, and flags drift. report.py prints
    every metric the project brief lists together, measured next to the Vivado
    estimate, and never mean power alone.
    Mock check: a synthetic 0.85 W load is recovered as 0.849 W with 0.4%
    SEM; a drifting supply trips the flag. Real-hardware run waits on the
    INA226 order and Stage B.
    [ina226.py, protocol.py, report.py]
2026-08-18 RTL lint clean under verilator -Wall: explicit sign-extension of int8 weights, no FSM initialisers
    The implicit sign-extend was correct (bit-exact results prove it) but
    now says so; the state initialisers were redundant with rst and are
    gone so reset is the only source of truth for synthesis. Full regression
    still bit-identical everywhere.
    [axis_conv.v, conv_layer.v, fc_layer.v]
2026-08-18 README: layout, environment and check list brought up to date with the board reality
2026-08-18 DDR resolved: unusable on this board (FSBL's own init confirms). OCM is permanent.
    [loopback.c]
2026-08-18 DDR: chips warm -> powered and clocked; failure is the data path
2026-08-18 ddr_test.c: let the program test DDR itself, not the debugger
    Every DDR verdict so far came through JTAG, which misled us repeatedly
    last night. Runs from OCM, writes/reads patterns across five regions of
    DDR plus a walking-ones on one word, reports over UART. Decides whether
    'DDR unusable' was real or another debug-path artefact.
2026-08-18 SD boot reaches the FSBL from cold; FSBL blocked on UART0 stdout, not on DDR
2026-08-18 conv_server cap 65535 (16-bit n_words ceiling); Stage B doc: ZedBoard preset prerequisite, DDR linking, SD boot as the preferred run mode
2026-08-18 axis_conv: plain zero wire for v_addr instead of a $clog2 replication in a port connection (Vivado BD importer)
2026-08-18 Stage B first silicon run: everything up to the DMA works; preset had cleared HP0. Documented.
2026-08-18 Bake conv1 weights into the RTL for synthesis (BAKED_WEIGHTS); AXIS TB exercises that exact path
    Vivado's $readmemh lookup at synthesis fails silently and hands you a zero
    ROM; there is no clean way to tell from the bitstream. The synthesis top
    now compiles the int8 table in from hdl/dense/weights/conv1_w.vh
    (generated from the same golden npz), and the AXIS testbench instantiates
    it with BAKED_WEIGHTS=1, so the baked table is verified bit-identical
    against golden before it ever reaches Vivado. Sim runners gain -I hdl/dense.
    [axis_conv.v, axis_conv_top.v, conv_layer.v, gen_weight_vh.py, tb_axis_conv.v]
2026-08-18 M4 done: BOARD PASS - C1 engine bit-identical to golden on the ZedBoard, 16 samples, 9280 words
2026-08-18 README: board section reflects the working SD-boot flow
2026-08-18 M6 step 2: scatter unit RTL, bit-identical to the Python engine on c1/c2/c3
    ed_scatter.v takes one spike address, walks its <=2x2 output block and
    all output channels, and does I += W_T for each - the event-driven idea
    in one module. Checked against a new checkpoint the Python engine dumps
    (I after scatter, before sweep), 564k accumulator words across three
    layers, zero mismatches; one flipped weight bit fails 3108. K=1 sequential
    inner loop, written as oc += K so banking is a fan-out later, not a
    rewrite. 76/148/296 cycles per spike for c1/c2/c3.
    [ed_scatter.v, export_ed_vectors.py, tb_ed_scatter.v]
2026-08-18 M6: event-driven conv engine bit-identical to the dense engine, K=1
    ed_conv_layer.v = address list + ed_scatter + sweep + V memory behind
    the D0020 interface. Dropped into the harness the dense engine's shim
    passed, same golden traces: c1/c2/c3, 1.13M comparisons, zero mismatches.
    One flipped weight bit fails 5353.
    The harness earned its keep twice: a 64-deep FIFO silently dropped 81%
    of spikes under the burst push (now the worst-case-sized D0016 list, so
    overflow is impossible), and the list's ring pointers indexed past a
    non-power-of-two depth on the second sample (now rounded up). Neither
    would have shown on sample 0.
    [ed_conv_layer.v, tb_ed_conv.v]
2026-08-18 M6 K=4: banked scatter unit, bit-identical on all layers; crossover visible in cycles
    ed_scatter is now parameterised by K - K RMWs per cycle into K
    conflict-free banks - and ed_conv_layer didn't change, since the i_addr
    port maps golden indices to (bank, offset). K=1 and K=4 both bit-identical
    on c1/c2/c3, same harness, same golden traces. Scatter cost per spike drops
    76->22, 148->40, 296->77 (3.45-3.84x of the ideal 4x).
    The cycle model already shows the thesis's crossover: at K=1 the
    event-driven engine loses to dense on C2/C3 (fan-out too large for a
    sequential scatter); K=4 flips both. Recorded with caveats - cycles are
    not energy, and these traces are busy digit-0 samples.
    [ed_scatter.v, tb_ed_conv.v, tb_ed_scatter.v]
2026-08-19 ed_scatter: one write port and one read port per bank so Vivado infers BRAM
    First event-driven bitstream blew the LUT budget (62,456 of 53,200):
    imem was written from three addresses and read from two, so it became
    flip-flops and mux trees instead of block RAM. Each bank now has a
    single muxed write port and a single registered read port; every
    access lands on the same edge as before. All scatter/engine/AXIS
    checks re-pass with identical cycle counts; lint clean. Logged.
    [ed_scatter.v]
2026-08-19 M6 on the board: event-driven engine K=4 BOARD PASS, 9280 words bit-identical
    Same design, server, client and samples as the dense pass; only the
    engine differs. Logged with the evidence chain that it really was the
    event-driven fabric (hwh params + byte-exact BOOT.bin PL partition vs
    the .xsa bitstream), and the stale-platform lesson.
2026-08-19 Log the timing failure on the event-driven build; the board pass is functional only until it is fixed
2026-08-19 ed_scatter: step the bank offset and weight row incrementally in registers
    The worst timing path was the offset ((oc/K)*H_OUT+oy)*W_OUT+ox rebuilt
    from the loop counters each cycle: two chained DSP multiplies straight
    into the BRAM address, 13.8 ns on a 10 ns clock. Both offset and weight
    row are now registers stepped by constants as oc/ox/oy advance. All
    checks re-pass with unchanged cycle counts; lint clean. Logged.
2026-08-19 ed_conv_layer: LIF chain reads re-registered V and I, not BRAM latches; i_addr presented one state early
    The one remaining failing endpoint (WNS -0.42 ns) was vmem BRAM latch ->
    lif_update -> out_mem in one cycle. Capture v_r/i_rdata into flip-flops
    in the existing wait state and feed those to lif_update. No cycle change;
    all checks re-pass; lint clean. Logged.
    [ed_conv_layer.v]
2026-08-19 Log timing closure (WNS +0.735) and the dropped DMA address map caught before the card write
2026-08-19 M6 on the board, sign-off clean: event-driven K=4 BOARD PASS at WNS +0.735 ns
2026-08-19 BURST mode: replay the loaded sample N times back to back, timed on the board (protocol 0x03)
    conv_server.c build 2, snn_link/mock/client updated; mock selftest passes
    including the burst CRC and mismatch checks. Makes the engine's duty
    cycle ~100% so a meter's idle-vs-running delta measures the engine, and
    yields system latency per inference. D0022.
2026-08-19 conv_server: read the Cortex-A9 global timer directly (no xtime_l.h in the SDT BSP); client cross-checks tick rate against wall-clock
2026-08-19 Board burst results: event-driven K=4 at 1.51 ms/inference, deterministic over 12,000 iterations, timer cross-checked
2026-08-19 AXIS testbench: no-gap mode and per-sample cycle counts; dense/ED K=1/K=4 latency table in simulation, matches the board within 3%
2026-08-19 Overnight: M7 rehearsal sweep in simulation (K=1 crosses dense at ~45%, K=4 never), per-layer latency all conv layers (stack 37.8 vs 3.26 ms), engine testbench cycle accounting
    [sweep.csv]
2026-08-20 Dense engine: stepped address registers and re-registered membrane read; it never actually met timing
    First WNS ever read on a dense build was -3.934 (address formulas as
    chained DSPs into RAM address ports, plus the BRAM-latch->LIF path).
    Same fixes as the event-driven engine got: addresses stepped in
    registers, membrane read issued a state early and re-registered. Zero
    cycles added -- per-sample count asserted exactly 436,247. All conv/FC/
    AXIS checks bit-identical, lint clean. The 08-18 dense board pass is
    downgraded to functional-only in the log.
    [conv_layer.v]
2026-08-20 Record the dense power breakdown: fabric ~32 mW of a 1.7 W total, PS7 dominates; sets the DMM resolution requirement
2026-08-20 Dense engine on the board, sign-off clean: 4.409 ms/inference, data-independent, matches the cycle model; both engines now measured
2026-08-20 Year-two groundwork, platform-agnostic: control-loop fundamentals briefing, FPGA link budget from measured numbers, per-cycle log schema with a tested ring-buffer logger
    No SDK code (Go1 vs Go2 unresolved), no control code. The link budget
    concludes UART stays the bring-up channel and the control path needs
    bare-metal lwIP UDP; the log schema is defined once with the clock-
    alignment requirement stated.
2026-08-20 Event-driven FC layer, bit-identical at K=2/4/8/16 on the first run (D0023)
    Queue + scatter + sweep in one module; pool folded via threshold, cropped
    positions dropped at enqueue, uniform 128-wide fan-out through K banks
    with one write and one read port each; sign-off rules applied at design
    time. 16,384 comparisons vs golden fc traces; lint clean; added to
    check_all (18 checks, all green).
2026-08-20 Year-two platform decided: ES-Parkour recreation env + FPGA-sized encoder distillation launched; DVS-Gesture deferred (disk)
2026-08-20 P1 pipeline proven mid-training: real event frames + quantised distilled c1 weights run bit-identical on both engines (threshold 16, 3.06 ms ED K=4)
2026-08-20 P-wide dense baseline (C0029/D0026): bit-identical at P=1..8, exact scaling; at matched parallelism dense wins C1 by 8%, ED wins C2/C3 by 3.5-4.3x — the crossover is real and lives in layer fan-in
2026-08-20 Metering protocol upgraded per review (three energy quantities, boundary, idle power, noise floor, thermal, statistics); geometry-conflation table (C0036)
2026-08-20 BURST sweep mode (C0018): the metered window covers all loaded samples; per-sample determinism CRC; state-reset documented; mock selftest green
    [conv_server.c, mock_server.py, uart_client.py]
2026-08-20 XADC die temperature in the BURST reply (C0009); trace samples become a seeded random draw across classes (C0039)
2026-08-20 Corrections session: unbiased trace set re-baselined (21/21 green), N_ENGINES replication sim-verified at N=2, worklist status recorded
    [axis_conv_top.v, tb_axis_conv.v]
2026-08-20 Word-parallel wrapper (C0035): 39-48k -> ~2k wrapper cycles, all configs bit-identical; C0037 recomputed — ED K=4 beats dense P=4 on C1 by 1.54x, crossover at ~31% activity
2026-08-21 Baked conv_layer_p variants generated and wired; AXIS synthesis paths exercised in the harness (both engines, hostile handshake); next Vivado session step list
2026-09-06 Board pass: ED K=4 pipelined sweep + word wrapper bit-identical on silicon; 723.5 us mean latency (589.8-850.8 data-dependent), 2.1x over the old ED build
2026-09-06 SDT flow: XADC lookup by base address, matching the DMA's ifdef (2024.1 defines XPAR_XADCPS_0_BASEADDR, not _DEVICE_ID)
2026-09-06 XADC base-address constant is XPAR_XXADCPS_0_BASEADDR under SDT (driver-name prefixing)
2026-09-06 BURST build 4: sweep from the oldest slot (ring rotation made slot order diverge from load order on silicon; the mock's load-order list couldn't see it) and engine-only tick accumulation (per-pass CR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
2026-09-06 ED K=4 routed power/utilization from the report: 1.727 W total, fabric ~49 mW, BRAM 12.5, DSP 0, WNS +0.508
2026-09-06 note the ED power-breakdown item closed
2026-09-06 Dense P=4 timing repair: per-lane output bit files at the vmem address (one writer per bank), word read as elaboration-constant wiring; WNS -3.23 cones removed, bit-identical everywhere, cycles uncha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
2026-09-06 Synth-safety lint (two-stage init is a hard fail; cross-scope generate refs listed as advisory, silicon-proven in axis_conv_top), checklist revision, dense P=4 pre-registration
2026-09-06 Dense P=4 all-zero silicon fix: single-stage weight init read directly at per-lane stepped addresses (ed_scatter pattern); synth-safety lint wired into the ladder (23 checks); bit-identical on every 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
    [conv_layer_p.v, conv_layer_p_c1.v, conv_layer_p_r1.v]
2026-09-06 Dense P=4 on silicon: 16/16 bit-identical, 1048.9 us on every sample (+0.8% vs cycle model, zero spread); matched-parallelism verdict measured: ED K=4 wins 1.52x on C1, on every sample
2026-09-06 K sweep re-run on the current wrapper: cycles = 45.2k + 90.3k/K exactly (K=1..16 bit-identical; K=1/4 reproduce the re-baseline); ED wins vs dense P=4 for K>=2 but the K-independent floor implies a p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
2026-09-06 Matched-parallelism table K=P=1..16 (dense P=2/8/16 simulated): crossover at K=P~6.6 on C1; beta sweep 0.5..0.96875 on the GPU box: accuracy flat within seed noise, beta=0.875 stands
    [beta0.5_m0_firing_rates_binarised.csv, beta0.75_m0_firing_rates_binarised.csv, beta0.9375_m0_firing_rates_binarised.csv, beta0.96875_m0_firing_rates_binarised.csv]
2026-09-06 Vivado session list revised: Builds 1-2 closed with silicon results; K=P=8 pair as Builds 3-4 with predictions and the bracketing rationale; both synth configs verified bit-identical in baked form
2026-09-18 build_engine.tcl: scope the excluded-segment check to the DMA master address spaces (global query lists slave segments and false-failed on first run)
2026-09-18 DVS-Gesture (C0012) data path: pack script at the verified 2x64x64 r1 geometry (T=4, uint8 with clip accounting), --dataset switch in the packed loader and trainer; N-MNIST path unchanged (smoke run 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
2026-09-18 build_engine.tcl: close open implemented designs before open_run (GUI-held impl_1 tabs made it fail after a completed run); REUSE_RUN 1 re-exports a finished, current run without rebuilding
2026-09-18 Decisions: second GPU host — DVS-Gesture unblocked and packed at the r1 geometry (22-27% input density, near the crossover); ES-Parkour's IsaacGym stack staged and smoke-tested on the 1080 Ti
2026-09-18 DVS-Gesture C1 vectors from the real quantised network (g1 layer in both bench runners, THRESH=128); golden check takes --weights/--traces and the dataset from the checkpoint; IsaacGym timing on the 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
2026-09-18 Pre-register the ED K=8 silicon pass: per-sample predictions from the K sweep, falsification criteria, build provenance (before power-on)
2026-09-18 ED K=8 on silicon: 16/16 bit-identical, 575.5 us engine mean (494-653), all latency predictions held; BRAM prediction wrong (13.5 tiles, +1 over K=4); constant ~11 us board-over-sim offset noted
2026-09-18 ED sweep never zeroed neuron 0's input current (C0044) -- found by DVS-Gesture, invisible on N-MNIST; both engines now bit-identical on the DVS-Gesture C1 vectors; C0012 closed
    The pipelined sweep clears each neuron's accumulated current at the beat
    that reads it, but the write sat inside the update-valid block, which is
    false on the first read beat of every sweep. I[0] therefore survived
    into the next timestep and the scatter accumulated onto it. N-MNIST
    never put a spike in output neuron 0's receptive field on the check set
    (0 of 64 timesteps), so every earlier result stands numerically; the
    DVS-Gesture vectors do (3 of 32) and failed at neuron 0 with a
    compounding error. The zero is now u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
    [m0_firing_rates_binarised.csv]
2026-09-18 K=8 board record: the bitstream predates the C0044 fix (VM copy checked, marker absent); N-MNIST numbers unaffected, not for other datasets
2026-09-18 Pre-register the dense P=8 silicon pass: ~543 us flat, dense wins the K=P=8 comparison by ~6 % at the mean, ED K=8 keeps its two fastest samples (before power-on)
2026-09-18 Dense P=8 on silicon: 16/16, 540.3 us on every sample; dense/ED K=8 = 0.939x, crossover between K=P=4 and 8 confirmed on hardware; per-engine offsets; session list updated for the scripted flow
2026-09-18 ED K=4 x8 (C0003) on silicon: 16/16, per-sample latency identical to N=1, 86 BRAM tiles, WNS +0.430; bitstreams archived per tag for the meter session
2026-09-18 Ladder: add the synthetic r1 corner-activity set at K=4 (C0044 guard); 24 checks, ~11 min
    The N-MNIST check set never puts a spike in output neuron 0's receptive
    field, which is how the sweep's I[0] bug survived every earlier pass.
    The synthetic r1 set has corner activity in 13 of 32 timesteps. Before
    adding the check I ran it against the pre-fix RTL: it fails at sample 0
    t=1 neuron 0, as the DVS-Gesture vectors did. Runtime comment corrected
    (the ladder has been ~11 min since the r1-sized benches, not 3).
2026-09-18 Vector exporters report each check set's corner exposure (C0044 follow-up); ladder 25 checks
    sim/corner_exposure.py counts, per output-corner neuron of a 3x3/s2/p1
    layer, how many exported frames put a spike inside its receptive field,
    prints the line and writes ed_<layer>_exposure.txt beside the vectors;
    zero at a corner is flagged BLIND. Wired into the N-MNIST, synthetic r1,
    DVS-Gesture and real-student exporters; self-test in the ladder.
    First reading: N-MNIST c1 is blind at all four corners (which is how
    the sweep's I[0] bug hid), DVS-Gesture at two, the recorded robot depth
    frames at the top two; only the synthetic set covers all four. Table in
    the C0044 entry.
    [corner_exposure.py, export_dvsgesture_vectors.py, export_ed_vectors.py, export_fpga_student_vectors.py, export_robot_vectors.py]
2026-09-18 DVS-Gesture C1 latency, both engines, K=P sweep: ED 1.25x at K=P=4 on the mean but loses on the two densest clips; per-sample crossover at ~30% input density; cycle model transfers to 0.3%
    Pre-registered before the sims (latency_prereg_20260918.md, outcomes
    appended). Engine-only cycles on 8 test samples: ED 165,259 + 490,120/K
    (fit residual 0.00%), dense 1,441,788/P. Parallelism crossover K=P=5.8;
    activity crossover at K=P=4 is ~10,000 input spikes per sample (30.5%
    density) — 6 of 8 gestures below it, 2 above. Predictions 1, 3, 4 held;
    the spread prediction missed high (2.30x vs 1.3-1.5x, a dataset
    property). The refined model makes the K-independent per-spike FIFO
    cost (5.0 cycles) expl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
2026-09-18 DVS-Gesture baked for the board: DATASET knob on the top selects the g1 tables, geometry and threshold; both engines bit-identical through the baked AXIS wrapper; server build 5; ladder 29 checks
    sim/gen_weight_vh.py bakes conv_layer_p_g1 / ed_scatter_g1 from the
    DVS-Gesture weights. axis_conv_top gains DATASET (0 N-MNIST C1, 1
    DVS-Gesture C1): one parameter picks the baked table, 2x64x64 geometry
    and threshold 128 together, so they cannot be mismatched in the block
    design; ed_conv_layer and axis_conv select the baked module on it. The
    AXIS harness and its exporter take g1 (8 samples, 256/512 words per
    timestep); ED K=4 and dense P=4 pass with the hostile handshake, the
    N-MNIST paths are unc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
2026-09-18 IsaacGym port of the year-two student (event simulator, 58k spiking encoder, distillation) as an additive plug-in to extreme-parkour's vision loop; DVS-Gesture three-seed table
    robot/isaac/: event_sim_torch.py (batched GPU port of the recreation's
    frame-difference simulator, bit-identical to the numpy original in
    test_port.py incl. resets), fpga_encoder.py (verbatim from the recreation,
    diffed by the test), fpga_event_backbone.py (replaces only
    depth_encoder.base_backbone in rsl_rl's learn_vision: events -> encoder,
    their GRU/actor/DAgger untouched), train_fpga_student.py (mirrors their
    train.py, swaps the backbone, recreates the optimisers). Flagged choices:
    window repeat (paper) vs consecu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
    [seed1_m0_firing_rates_binarised.csv, seed2_m0_firing_rates_binarised.csv]
2026-09-18 build_engine.tcl: refuse to build without the ZedBoard PS preset (DDR part, HP0, UART1, SD0, QSPI, FCLK0=100) -- the fresh project built with the default DDR part; Mac copy via cmd.exe since Tcl cann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
2026-09-18 DVS-Gesture T sweep (C0023): 63.3/65.2/68.9% at T=4/8/16, but the fc membrane overflows int16 at T=16; T=8 fits with 12% headroom; cycle projections from the validated model
    Seed 0, 30 epochs, CPU runs on the box. The golden model's 70.83% at T=16
    is not a hardware number: fc V reaches -34,472. Options recorded (18-bit
    membrane, fc k=7, or T<=8), none taken. Logs and firing-rate CSVs under
    experiments/dvsgesture/t8, t16.
    [m0_firing_rates_binarised.csv]
2026-09-18 Year-two recorder and i1 vector export (window = repeat): IsaacGym event-frame recorder, exporter takes --name/both checkpoint layouts/one-frame files, runners gain the i1 layer and read the exporter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
    robot/isaac/record_event_frames.py records one camera-tick event frame per
    sample (round-robin over envs after a warm-up) with the backbone's own
    simulator, mapping and binarisation, teacher-driven now, --student later,
    and stamps window="repeat" in the file. sim/export_fpga_student_vectors.py
    repeats each frame over T=4, loads conv1 from the recreation's checkpoint
    or the rsl_rl runner's depth_encoder_state_dict, writes the i1 set and
    i1_thresh.txt. Both bench runners take layer i1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
2026-09-18 ED K=4 with C0044 from the fresh project: 16/16, every latency equal to the 5 Sep record to 0.1 us; two rejected deliveries recorded; die-temperature remark withdrawn; flow doc updated
2026-09-18 Board client for DVS-Gesture (C0012): --dataset g1 check set from the harness vectors (8 x 1,024/2,048 words), PING DATASET word must match or nothing is sent, sweep fills all 16 slots in load order;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
2026-09-18 N-MNIST exporters take --weights/--traces from another network (rate sweep), with each layer's threshold from that network's shifts; runners plumb VEC_WEIGHTS/VEC_TRACES and read the exporter's thres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
    Verified: the default c1 path is unchanged (ladder check bit-identical at
    threshold 64) and a rate-0.30 network's c2 vectors run bit-identical on
    ED K=4 (85,746 input spikes over 16 samples).
2026-09-18 M7 activity axis on real data: five N-MNIST networks trained to 2-30% conv firing rates, all golden-clean; ED K=4 vs dense P=4 on C1/C2/C3 (18/18 bit-identical) -- C1 fixed by the data, C2/C3 crossov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
    experiments/rate_sweep/: lambda calibration, training/quantise/golden logs
    and per-epoch CSVs, the five int8 weight files, per-sample ED cycle files
    and dense lines under bench/, README with the tables and linear fits (ED
    intercepts on the sweep floor, residuals < 1%). Traces stay local/on the
    AMD box (regenerable). experiments/dvsgesture/t8/: seeds 1-2 logs; the
    README's T=8 table now says seed 1's fc membrane re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
    [rates_binarised_nmnist_target0.020_seed0_t4.csv, rates_binarised_nmnist_target0.030_seed0_t4.csv, rates_binarised_nmnist_target0.040_seed0_t4.csv, rates_binarised_nmnist_target0.080_seed0_t4.csv, rates_binarised_nmnist_target0.160_seed0_t4.csv, rates_binarised_nmnist_target0.300_seed0_t4.csv, seed1_m0_firing_rates_binarised.csv, seed2_m0_firing_rates_binarised.csv]
2026-09-18 Untrack the rate-sweep trace dumps (regenerable, ~6 MB) and ignore them; the previous commit's message said they stay local
2026-09-19 Year two on the real stack: teacher finished and evaluated (95-99% success per terrain), port smoke passed, 64 real event frames recorded and both engines bit-identical on them (ED K=4 1.86 ms mean, 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
    experiments/p1_distill/isaac_eval_README.md + JSON (teacher row of the
    like-for-like table), robot/artifacts/isaac_event_frames.npz (repeat
    window, teacher-driven), i1 ED cycle file, README/decisions updates incl.
    the pgrep-over-ssh monitoring lesson.
2026-09-19 Port README and decisions: real-frame bench numbers (ED 1.94x mean, 1.43x worst frame), distillation timing, the pgrep-over-ssh monitoring lesson; these edits were meant for the previous commit
2026-09-19 DVS-Gesture activity sweep (MI210): accuracy rises with activity here (63.3 -> 66.3% float, one seed), quantisation noise 5x N-MNIST's, and the 34% network's fc membrane overflows int16 at T=4
    Five targets, seed 0, T=4, 30 epochs, lambda 100 (lands 0.01-0.04 above
    target on this dataset); logs, CSVs, int8 weights and README under
    experiments/rate_sweep_dvsg/, traces ignored. Two of five golden gates
    fail: 0.08 by accuracy (-3.4 pp on 264 samples), 0.30 by the fc membrane
    (-49,002). C2/C3 benches at this geometry are the next item.
    [rates_binarised_dvsgesture_target0.020_seed0_t4.csv, rates_binarised_dvsgesture_target0.040_seed0_t4.csv, rates_binarised_dvsgesture_target0.080_seed0_t4.csv, rates_binarised_dvsgesture_target0.160_seed0_t4.csv, rates_binarised_dvsgesture_target0.300_seed0_t4.csv]
2026-09-19 Pre-register the DVS-Gesture silicon pair (ED K=4 / dense P=4, DATASET=1): per-sample predictions from the sims, offset hypothesis stated, before power-on
2026-09-19 DVS-Gesture ED K=4 on silicon: 8/8 bit-identical, mean 2,970.8 us, spread 2.24x, board = sim + 92.9 us constant (offset hypothesis failed, recorded); refused DATASET=0 image on record
2026-09-19 Results summary page (every measured/simulated number with provenance and what is missing); corrections C0045-C0047 (thresholds shift with the rate penalty; int16 margin is seed- and activity-depende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
2026-09-19 Rename the results page to docs/results_ledger.md: it is a running ledger of measured and simulated numbers with provenance, not a dated snapshot
2026-09-19 Results ledger: the retitled heading (the rename commit carried the staged, old title)
2026-09-19 Results ledger: DVS-Gesture ED K=4 silicon row (parallel session's pass, board = sim + 92.9 us on every clip)
2026-09-19 C0045/C0046 tool halves: quantiser --fixed_k with clipping reported per layer; golden check prints each layer's share of int16 and the worst-layer headroom
2026-09-19 Seeds 1-2 for both activity sweeps (MI210): N-MNIST flat 2-8% then -0.5/-1.9 pp at 16/30% (sd 0.2-0.6); DVS-Gesture a 3 pp step between the 2-5% and 10-35% regimes, and the 34% network overflows int1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
    [rates_binarised_dvsgesture_target0.020_seed1_t4.csv, rates_binarised_dvsgesture_target0.020_seed2_t4.csv, rates_binarised_dvsgesture_target0.040_seed1_t4.csv, rates_binarised_dvsgesture_target0.040_seed2_t4.csv, rates_binarised_dvsgesture_target0.080_seed1_t4.csv, rates_binarised_dvsgesture_target0.080_seed2_t4.csv, rates_binarised_dvsgesture_target0.160_seed1_t4.csv, rates_binarised_dvsgesture_t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]
2026-09-19 Dense engine C0035 rev 3: registered output bit-file write (enable/address/bit one cycle behind vmem/smem) -- the LIF-to-obits path failed at WNS -0.70 with 4,096-flop banks on DVS-Gesture; cycle cou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
    [conv_layer_p.v, conv_layer_p_c1.v, conv_layer_p_g1.v, conv_layer_p_r1.v]
2026-09-19 DVS-Gesture C2/C3 geometry (g2, g3) in the shared geometry table, the trace-driven exporters and both bench runners; tracked r1 student weights npz for the baked-table provenance check
    golden/eventdriven.py GEOM gains g1/g2/g3 (the exporters override the
    threshold from the weights file's shifts); export_ed/conv_vectors map
    g-layers to the trace keys c1_S/c2_S; run_ed_tb.sh and run_conv_p_tb.sh
    take g2/g3 with golden/dvsgesture_weights_int8.npz + traces as defaults.
    Verified: baseline DVS-Gesture g2 and g3 bit-identical on ED K=4 and
    dense P=4 (dense 1,212,412 / 1,196,028 cycles per sample). Traces stay
    untracked (.gitignore). golden/r1_student_weights_int8.npz is the conv1
    of robot/artifacts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
2026-09-19 Pre-register the M5 metering session: shunt + mV method, the bitstream/sample matrix, 3 runs with SEM and drift/resolvability flags, six numeric predictions from the cycle model x tool power (single 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
2026-09-19 Baseline table: five accelerator rows transcribed from the papers (Cheng TCAS-I 2025, Cerebron TVLSI 2022, Li TCAS-I 2021, Minitaur TVLSI 2014, FireFly-P 2026) with each paper's stated power method -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
2026-09-19 Vivado power estimates per silicon build (report_power, default vectorless, routed): table + the seven builds' reports; the thesis estimate column for the meter session
2026-09-19 Metering prereg revision 7: the seven tool power reports (fabric 48 mW ED K=4, 62.6 mW/engine dense P=4 from x8, 54/83 mW at K=P=8, 72/135 mW DVS-Gesture) turned into per-build energy predictions; th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
2026-09-19 DVS-Gesture C2/C3 activity benches (12/12 bit-identical): ED K=4 over dense P=4 from 8.4x/11.0x at 3% activity to 1.33x/1.36x at 32-35%, fitted crossovers ~43%/~48%; per-spike constants equal N-MNIST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
    Per-sample cycle files and dense lines under experiments/rate_sweep_dvsg/bench/,
    tables and fits in the README (intercepts on the sweep floor within 2%,
    residuals <= 0.2%). Ledger updated.
2026-09-19 Ledger and README: the DVS-Gesture dense P=4 silicon pass (parallel session) puts the per-clip activity crossover on hardware -- ED 1.248x at the mean, 6 of 8 clips, loses the two densest, as pre-reg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
2026-09-20 Results-chapter figures generated from the committed data: K=P sweep with silicon points, DVS-Gesture per-clip crossover (sim and board), C2/C3 advantage vs trained activity on both datasets, accurac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
2026-09-20 Power estimates: dense P=4 N=1 N-MNIST (rev 3) row, the single-engine dense estimate the metering pre-registration needed
2026-09-20 Pass 12: dense P=4 N=1 N-MNIST at rev 3 -- 16/16, 1,048.9 us on every sample (rev 2 record to 0.1 us), WNS +0.768; rev 3 validated on both datasets
2026-09-20 DVS-Gesture offset resolved: wrapper-inclusive harness counts put board-over-sim at ED 29.4 us (constant) and dense 20.0 us; the rest was uncounted wrapper streaming; SEED control on the AXIS harness
2026-09-20 Prereg addendum 7b + ledger: the DVS-Gesture board offsets were a comparison-basis artefact (wrapper-inclusive: ED +29.4 us, dense +20.0 us, per the board session's b85ec60); DVS-Gesture replicated b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
2026-09-20 Silicon results ledger: twelve board passes, both crossovers, cycle-model transfer, resources and estimates, engine revisions, rejected deliveries
2026-09-20 Overnight MI210 results: N-MNIST T sweep (3 seeds: 97.6 % at T=8, 98.0 % at T=16, fc at 9-25 % of int16 -- the ceiling is a DVS-Gesture geometry property); DVS-Gesture T=8 x activity (overflow from ~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
    experiments/tsweep_nmnist/ (new), rate_sweep_dvsg/t8/, dvsgesture/t16/ with
    logs, CSVs and int8 weights; READMEs, ledger, decisions; the T-sweep figure
    now carries the N-MNIST fc range beside DVS-Gesture's.
    [m0_firing_rates_binarised_nmnist_seed0_t16.csv, m0_firing_rates_binarised_nmnist_seed0_t8.csv, m0_firing_rates_binarised_nmnist_seed1_t16.csv, m0_firing_rates_binarised_nmnist_seed1_t8.csv, m0_firing_rates_binarised_nmnist_seed2_t16.csv, m0_firing_rates_binarised_nmnist_seed2_t8.csv, rates_binarised_dvsgesture_target0.020_seed0_t8.csv, rates_binarised_dvsgesture_target0.040_seed0_t8.csv]
2026-09-20 Metering prereg 7c: ED K=4 DVS-Gesture x4 on silicon (row 9, pass 13); dense P=4 DVS-Gesture x4 does not place, row 10 becomes N=2 (per-engine = delta/2, predicted delta ~26 mA, still resolvable)
2026-09-20 Power estimates: DVS-Gesture ED x4 and dense x2 rows, and the four C0019 strategy variants
2026-09-20 Metering prereg: row 10 on silicon (dense P=4 DVS-Gesture x2, pass 14, 8/8, latency equal to N=1); all ten matrix rows now have a bitstream on the board
2026-09-20 Track the thesis outline generator (the .docx stays untracked): 270 bullets across every section, FIG/TAB recommendations per section (36 figures, 38 tables; 15 exist) collected into a Figure and Tab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
2026-09-20 N-MNIST C2/C3 at K=8 and K=16 (24/24 bit-identical): crossover falls with parallelism on both datasets (C2 48/40/29 %, C3 57/52/44 %; per-spike constants equal DVS-Gesture's at every K); four new fig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
2026-09-20 C0048: the robot-frame latency was an 8-frame number; all 64 frames benched in one run (8,388,608 comparisons bit-identical): ED K=4 1.73 ms mean / 2.75 ms worst vs dense 3.60 ms (2.09x mean, 1.31x w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
    [thesis_outline_build.py]
2026-09-20 Chapter 2-3 citations verified (49 verified, 4 corrected, none missing): references.bib (67 entries) and the audit table; outline corrected (Roy/Jaiswal/Panda, Rudin CoRL 2021, Cheng ICRA 2024) and i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
    [thesis_outline_build.py]
2026-09-20 C0049: the N-MNIST parallelism crossover is K = P = 7.4, not 6.6 -- the stated value never followed from the fits printed beside it (45,172 + 90,347/K vs 406,912/P + 2,331 gives 7.39; engine-busy bas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
    [thesis_outline_build.py]
2026-09-20 C0050: training is not reproducible at a fixed seed -- same code, same seed, two runs put the DVS-Gesture fc membrane at 98 % and 102 % of int16, either side of the overflow boundary (accuracy 69.32 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
    [t16_seed0_firing_rates.csv, t8_seed0_firing_rates.csv]
2026-09-20 Ten block diagrams generated from a script (system, toolflow, the two paradigms, both datapaths, bank interleaving, the LIF core, the measurement boundary, the verification flow, the perception loop)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
2026-09-20 docs/notation.md: what every symbol means (network, neuron, both engines and their parallelism, board and tools, the three energy quantities, housekeeping identifiers), written for a reader outside t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
    [thesis_outline_build.py]
2026-09-20 T-sweep table says why DVS-Gesture shows two seeds at T=8/16 (seed 0's originals lost, C0051; the retrain is a different network, C0050) and carries their transcribed numbers; C0049 records the board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
2026-09-20 Metering with a handheld meter: --shunt mode takes readings in mV across a series resistor (a handheld's ammeter ranges cannot resolve a single engine; 0.1 mV across 0.1 ohm is 1 mA), shunt loss reco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
    [manual_meter.py]
2026-09-20 Notation: N means output neurons and nothing else -- the engine replication count is written R (the RTL parameter keeps the name N_ENGINES, which ten bitstream provenance strings quote) and the BURST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
    [thesis_outline_build.py]
2026-09-20 Pre-register the energy-versus-K sweep (C0025): build list, inherited instrument and statistics, and seven falsifiable predictions written before any build exists. K3 says the fabric-energy optimum i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
2026-09-20 Sharpen K5 before any build exists: the original BRAM prediction sat between two growth laws with a threshold loose enough to score 'held' under either, which the board session caught. Now names the 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
2026-09-20 C0052: the scatter's 288-byte weight table is read K-wide, so synthesis replicates it into K/2 dual-port primitives -- 4.0 tiles at K=16 holding 2,304 bits at 1.6 % utilisation, and it is what decide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
    [thesis_outline_build.py]
2026-09-20 Fix the syntax error committed in the previous change: nested double quotes inside a bullet string broke the outline generator
    [thesis_outline_build.py]
2026-09-20 Build script: block-RAM census by memory array (banks vs weight table vs membranes vs DMA), so the K=16 split is measured rather than inferred -- the hierarchical report totals a module and both mech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
2026-09-20 The dense cost law is derivable from the FSM and exact to 4 cycles at every P; the ED expression's 4 is stride-2 kernel fan-out, not T; my additive-overhead alternative for the ED constant is refuted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
2026-09-20 Tier 2/3 corrections across the living documents: stale counts (ladder 33, fourteen power estimates), the pre-C0048 robot ratios in the README, the accuracy range (96.6-97.3, mean 97.0), the N-MNIST 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
    [thesis_outline_build.py]
2026-09-20 Provenance comments: each generator now names, at the top and inline, the file or derivation behind every number it types -- board passes for each latency, the capacities behind each percentage, the 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
2026-09-20 docs/CURRENT.md: one page that decides which numbers are current, lists every number that was corrected and what it used to be, marks the superseded material file by file, names the four claims that 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
2026-09-20 C0053: engine replicas were fed a fabricated input, not real data -- a replica drains its output early, re-enters receive while the DMA holds the same word, and latches it once per cycle; replicas no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
2026-09-20 Per-synapse comparison completed from the papers themselves: three of seven report convertible throughput (Cerebron 200 SOP/cycle, Cheng 12.9, Minitaur 0.065 sustained) and Spiker+ is derivable at 13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
2026-09-20 C0055: the thesis question has been asked outside robotics. Marostica et al. (arXiv 2506.13268, the Spiker+ group) compare event-driven and clock-driven spiking neurons across a sparsity sweep and re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
2026-09-20 C0055: IEEE/ACM-indexed search. Two findings that change Chapter 1. Instrumented SNN-on-FPGA power measurement DOES exist (Lindqvist et al. measure board and fabric rails on an Agilex 7, finer-graine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
